YourFath3r253/tennisball-picking/簡報/google簡報下載/撿球機 9_2.pdf

# 撿球機

9/2

## 加裝開關於24V電池

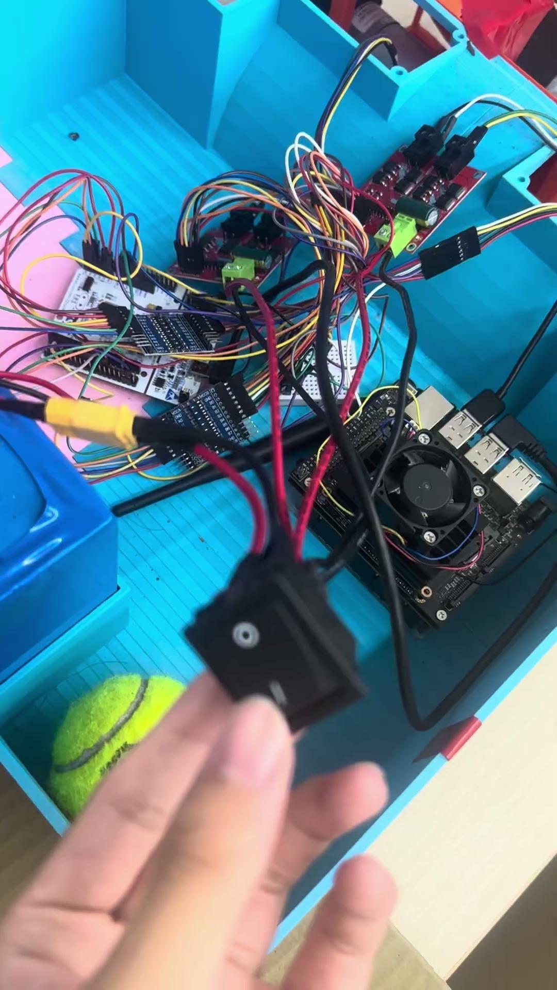
[picture p12: figure]

## 一次撿多顆球影片

讓機器在撿完球後原地旋轉尋找另
一目標，重複撿球動作

問題：球有可能會卡住沒辦法順利噴
到後面的儲球箱

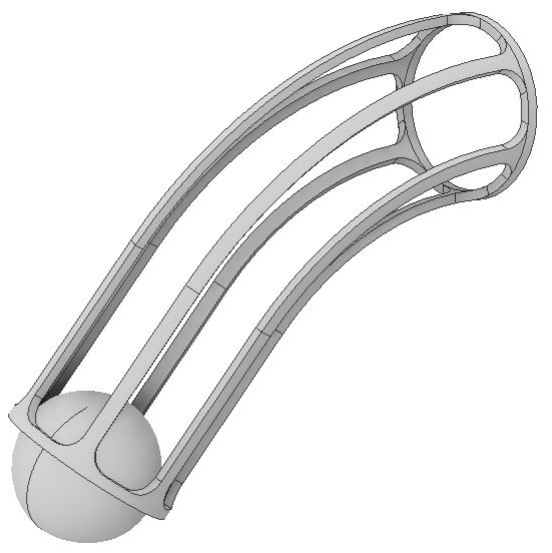
[picture p13: figure]

## 未來規劃

1. 重新設計導桿、做進球導軌、降低進球高度
2. 加入 IMU 改善分區巡邏
a. 加入 BNO080 IMU，取得車體即時方向角資訊
b. 利用 馬達 Encoder + IMU 估算車體位移、轉向角度
c. 將場地劃分多區塊，依序移動至各區域搜尋網球
