YourFath3r253/tennisball-picking/簡報/google簡報下載/1_20撿球機.pdf

# 撿球機

2026/01/20

目錄

- 撿球方式選擇
- 影像辨識系統

馬達

空載轉速 (No-load Speed)：200 rpm

負載轉速 (Rated Speed)：175 rpm

單顆馬達額定扭力 (Rated Torque)：2.29 kgf．cm

兩顆馬達總扭力：2.29 × 2 = 4.58 kgf．cm

假設輪子直徑15 cm，輪子周長：15 cm × 3.14=47.1 cm，以175 rpm做計算秒速約1.35 m/s

總推力= 扭力/半徑=4.58 kgf．cm/7.5cm=0.611 kgf

假設平地摩擦係數=0.046，重量=推力/摩擦係數=0.611/0.046=13.275kg

## 上滾輪式撿球機構

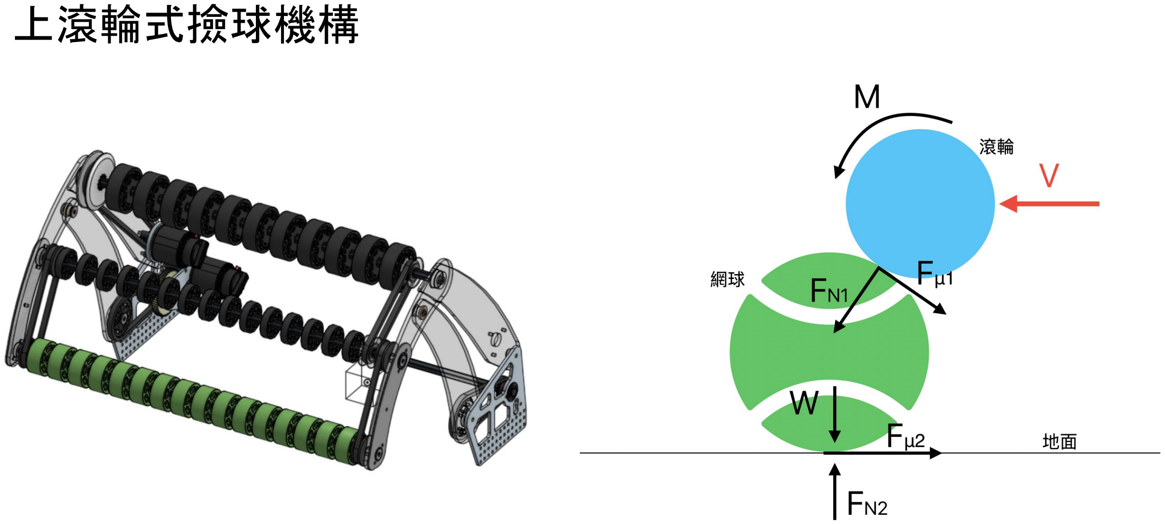
[picture p15: page 4]

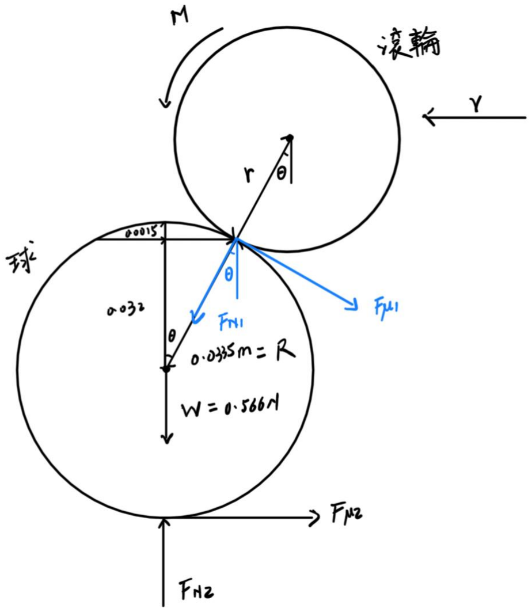
[picture p16: figure]

## 上滾輪撿球機構計算

標準網球直徑：67mm

網球剛性：12550N/m

標準網球重量：57.7g

網球與地面摩擦係數：0.046

滾輪直徑：50mm

滾輪與網球間摩擦係數：0.7

機器運行速度：1.35m/s

滾輪軸心與地面距離：86.7mm

## 上滾輪撿球機構計算

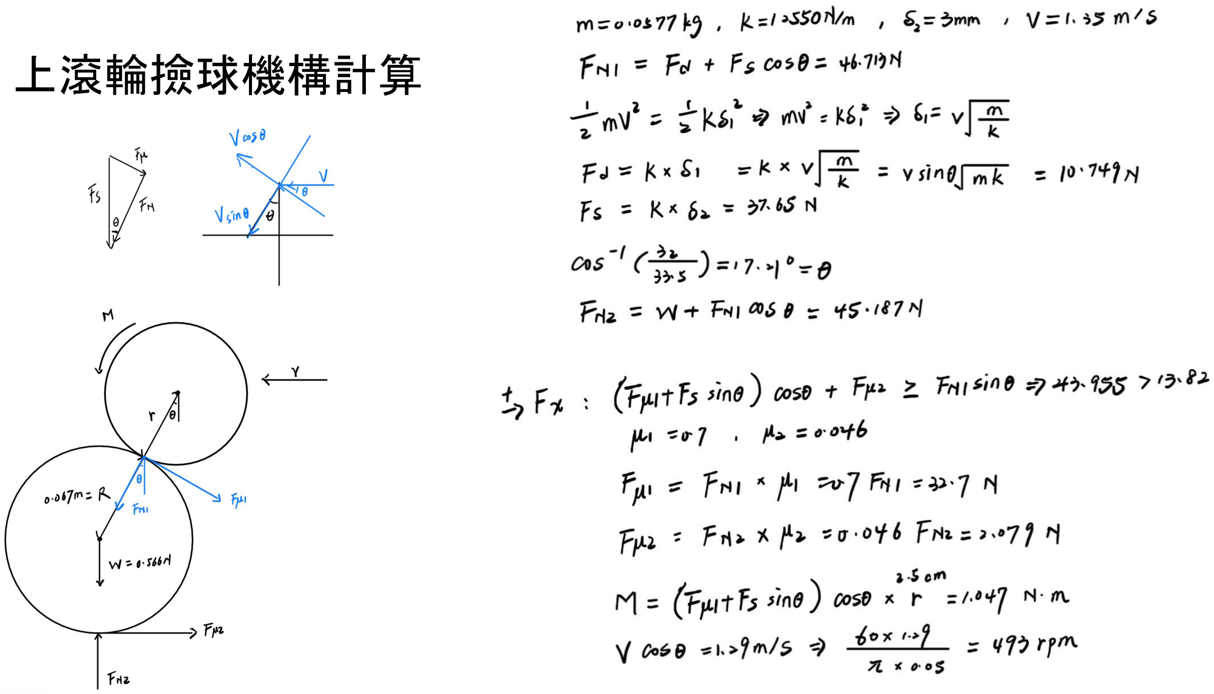
[picture p17: page 6]
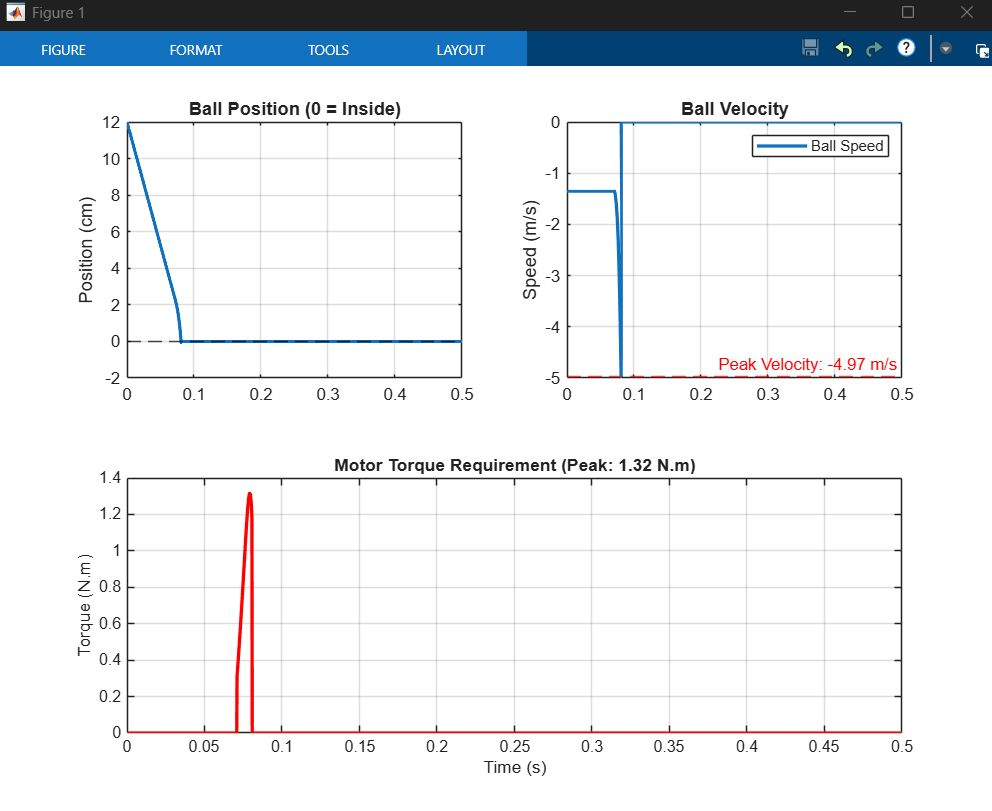
[picture p18: page 7]

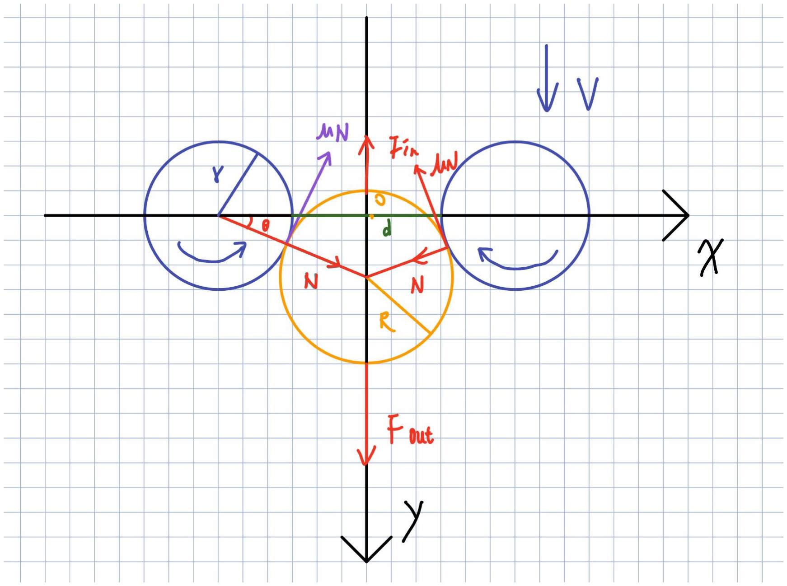
[picture p19: figure]

## 側向滾輪計算

標準網球直徑：67mm

滾輪直徑：50mm

滾輪間距：56mm

標準網球重量：57.7g

滾輪與網球間摩擦係數：0.7

網球與地面摩擦係數：0.046

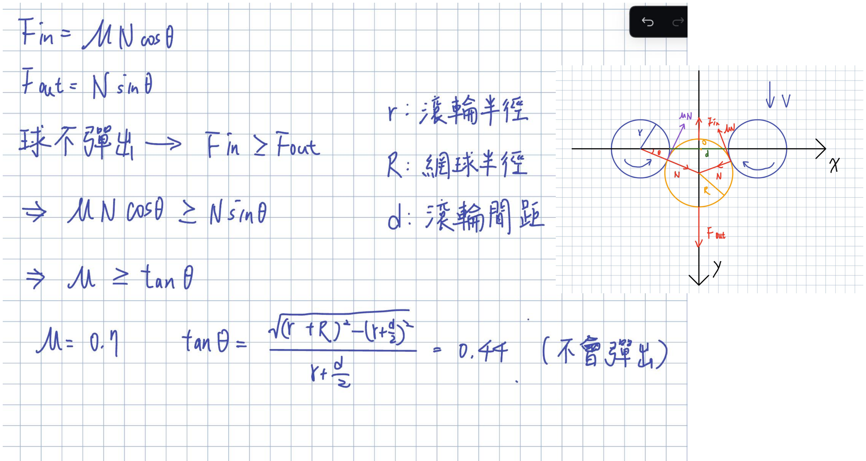
[picture p20: page 9]
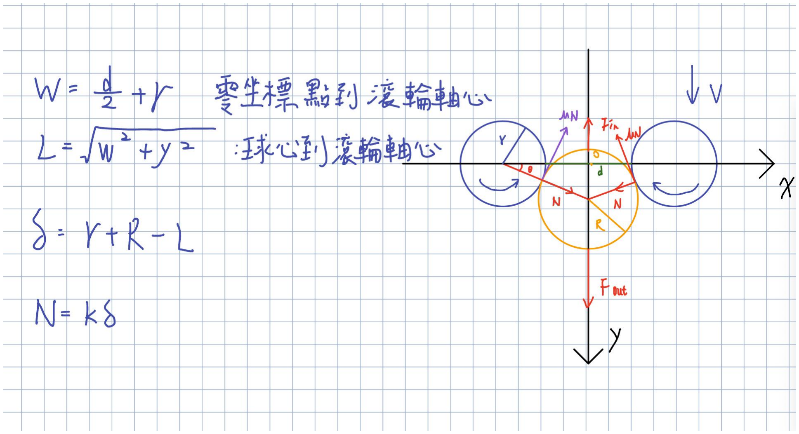
[picture p21: page 10]

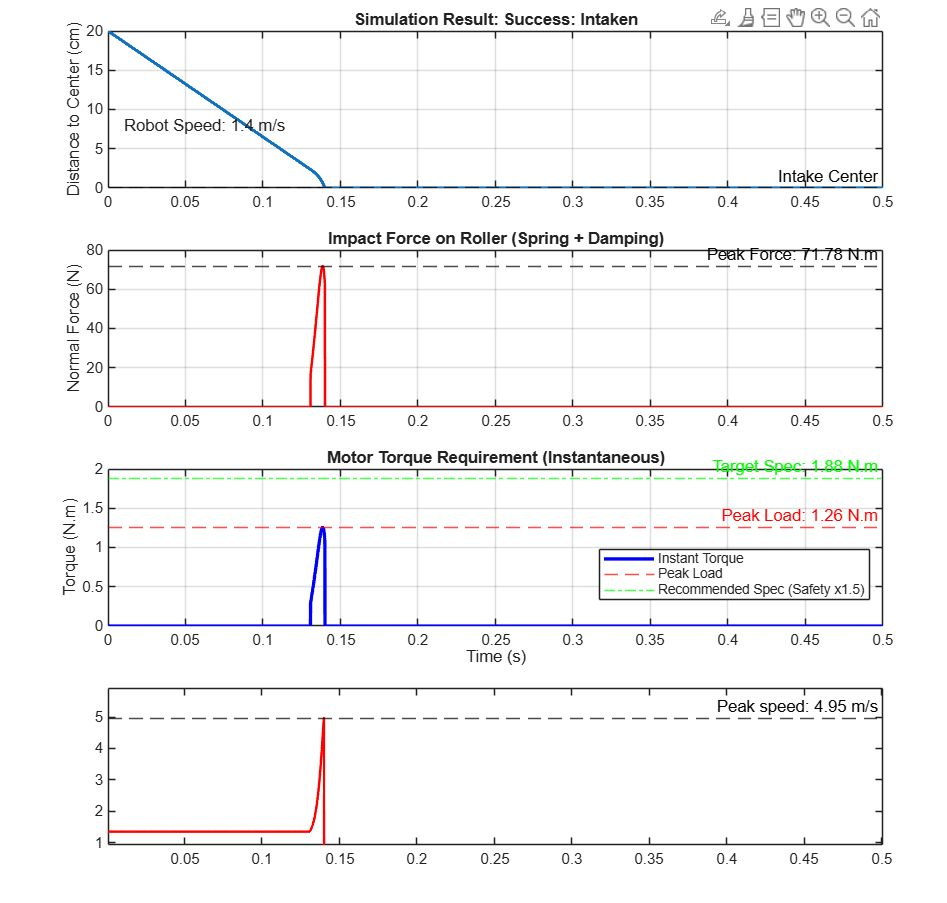
[picture p22: figure]

## 選擇側向滾輪的理由

- 受力分散於兩側，機構較不容易損壞
- 上側滾輪會受地面摩擦力影響，側向則不會
- 上側滾輪容易因地形起伏受影響，如果滾輪太低，球會直接彈飛(如果用可動的 懸臂會導致進球速度不太一樣
- 機構設計較簡單

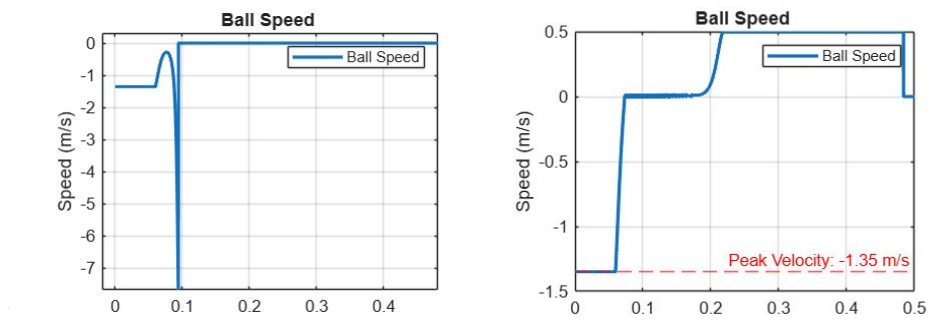
[picture p23: figure]

## 視覺系統架構選擇：Global vs. On-board Vision

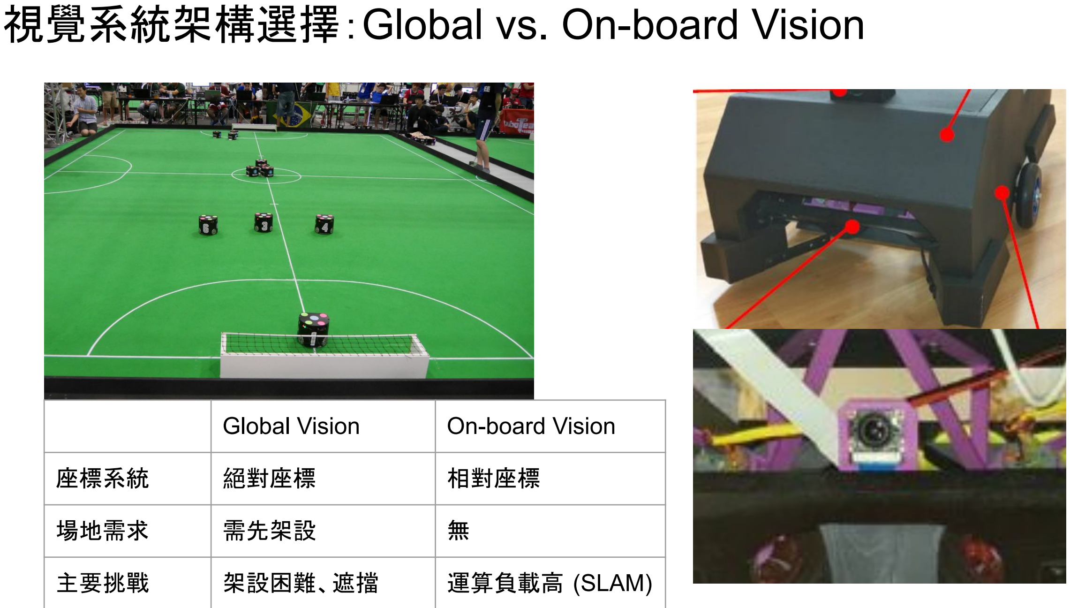
[picture p24: page 13]

| Global Vision | On-board Vision
座標系統 | 絕對座標 | 相對座標
場地需求 | 需先架設 | 無
主要挑戰 | 架設困難、遮擋 | 運算負載高 (SLAM)

## 文獻背景

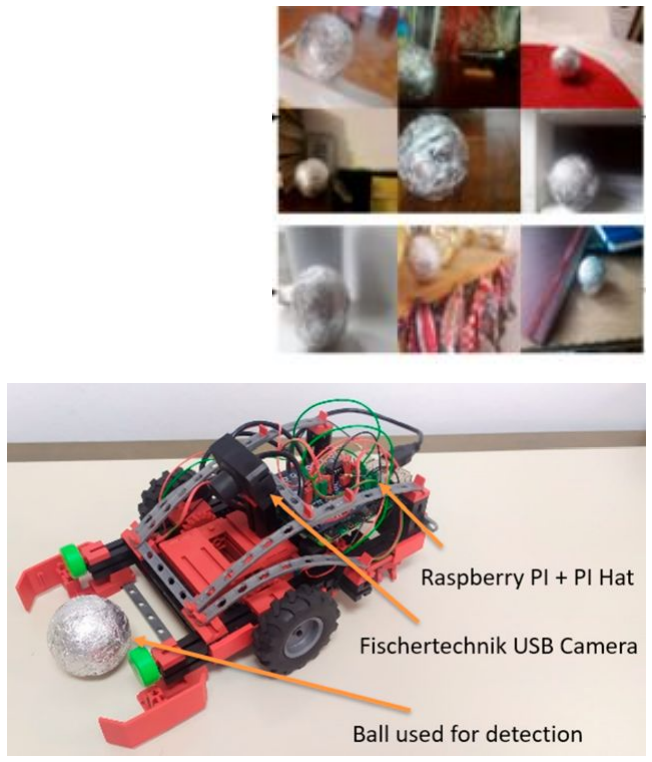
[picture p25: figure]

標題： Ball Detection Using Deep Learning Implemented on an Educational Robot Based on Raspberry Pi

出處： Sensors (2023), Keča et al.

實驗設計： 使用鋁箔紙製作銀色球，拍攝1200張照
片採用70%(訓練) - 15%(驗證) - 15%(測試)，手動 模糊180張照片作為增強測試

在Raspberry Pi 比較 Hough Transform (霍夫圓形 變換) 、U-NET (語義分割)、Faster R-CNN (物件偵 測)

## 影像辨識評估指標定義

綜合準確度 DICE

平衡誤判與漏抓

確保機器人不抓雜物
& 不漏看球

定位精準度 (IoU)

框得準確

決定撿球機構成功率

推論時間 (Inference
Time)

處理一張照片時間

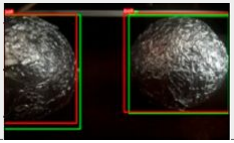
[picture p26: figure]

## Hough Transform 參數僵化

手動參數依賴： 需人工設定dp、(p1, p2)、minR, maxR 與最小距離 (minDist)

準確度崩盤： 實驗顯示，無論如何微調，DICE 分數最高僅 0.16，遠低於深度學習的 0.9+

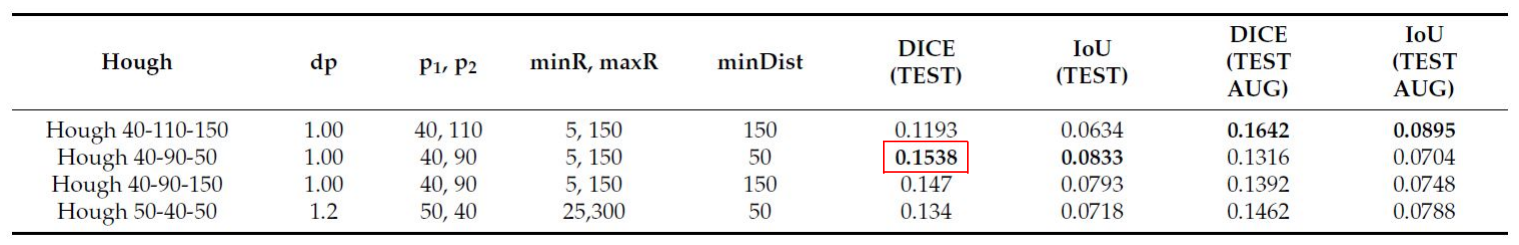
[picture p27: figure]

## Hough Transform 環境失效與動態模糊

光影干擾 (Illumination)：文獻 Figure 10 證實，單純依賴灰階 (Grayscale) 與邊緣特徵，在陰 影下極易失效（False Negative），或將圓形背景雜訊誤判為球（False Positive）

形狀變異 (Deformation)：由於撿球機移動中拍攝網球可能為橢圓形或長條形狀

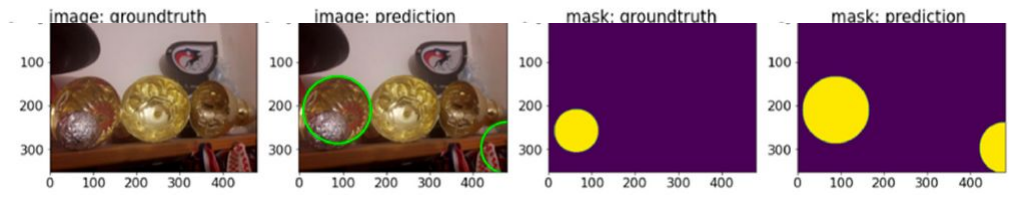
[picture p28: figure]

## 視覺辨識實際案例比較

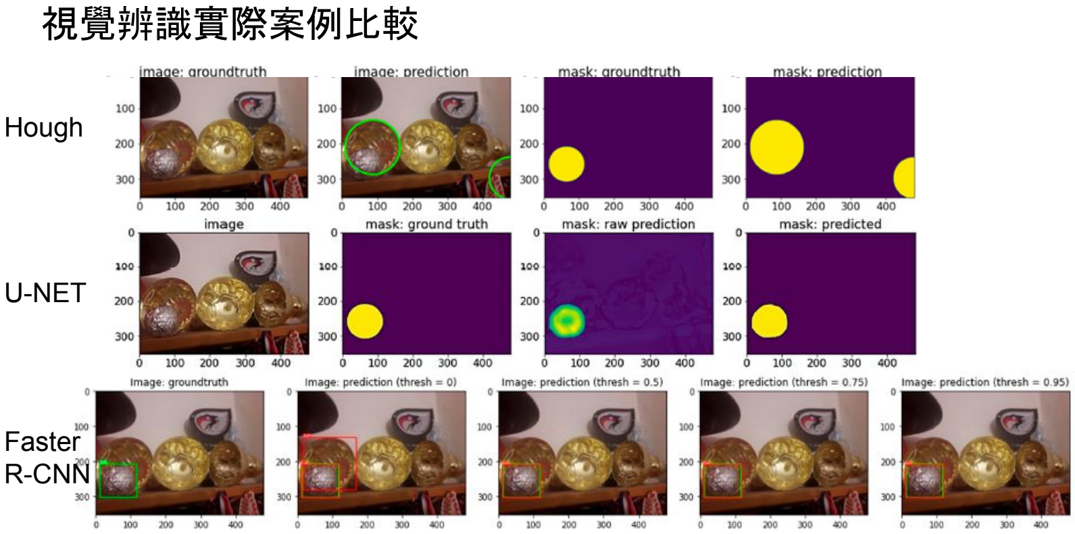
[picture p29: page 18]

Hough

U-NET

Faster
R-CNN

## U-NET, Faster R-CNN 實驗數據

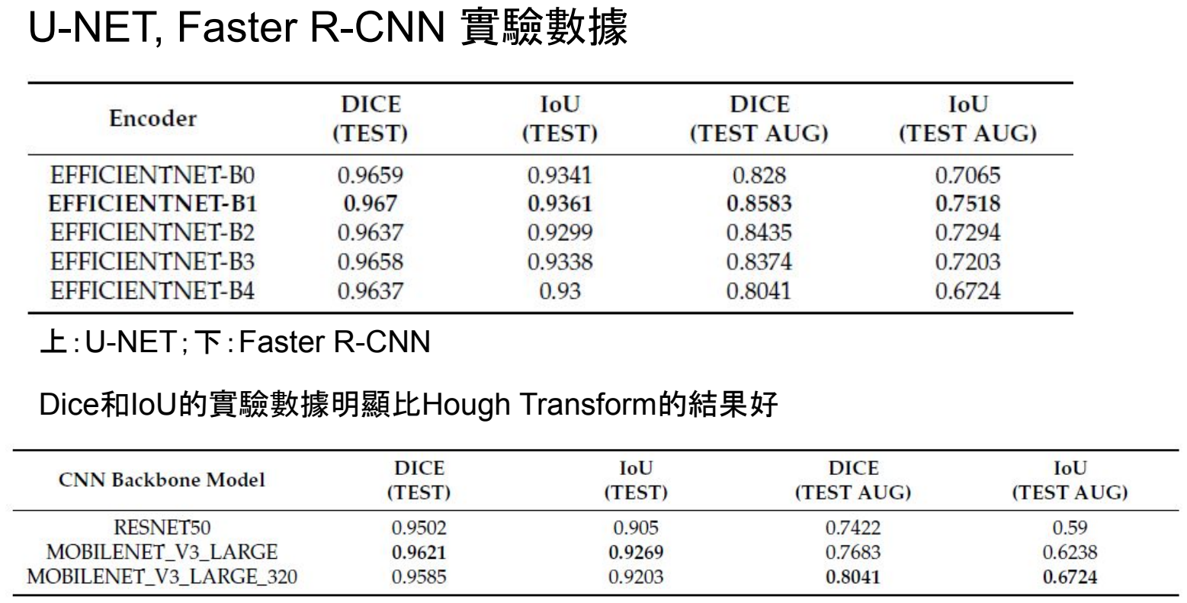
[picture p30: page 19]

上：U-NET；下：Faster R-CNN

Dice和IoU的實驗數據明顯比Hough Transform的結果好

## 影像辨識運算時間

樹莓派算力瓶頸

網球機器人速度快，我們至少需要 15-20 FPS，純 CPU 算力缺口巨大。

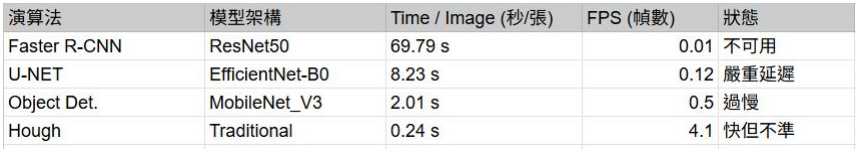
[picture p31: figure]

## 解決方案提案

硬體

Raspberry Pi (CPU)

演算法

Faster R-CNN：兩階段
偵測

硬體

NVIDIA Jetson Orin
Nano 8GB Super (GPU)

演算法

YOLO：單階段偵測

## 為什麼選擇 YOLO？

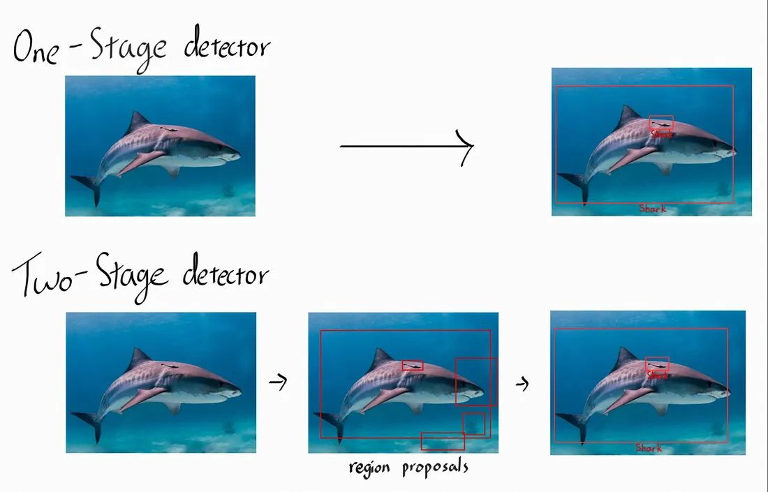
[picture p32: figure]

YOLO:

One-stage

即時性強(Real-time)

專為動態物件設計，
適合撿球機器人。

## 為什麼選擇 Jetson Orin Nano 8GB Super？

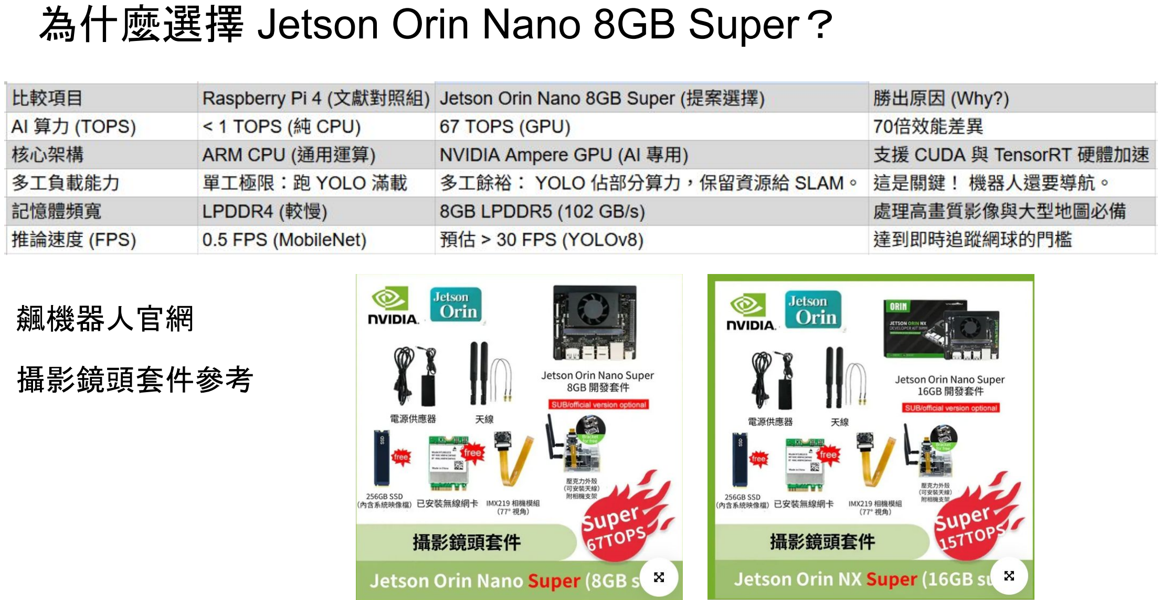
[picture p33: page 23]

飆機器人官網

攝影鏡頭套件參考

## 未來計畫

1. 用數學方式決定相機規格、架設高度、角度
2. 路徑規畫相對不相關未來再做選擇
3. SLAM 建圖功能

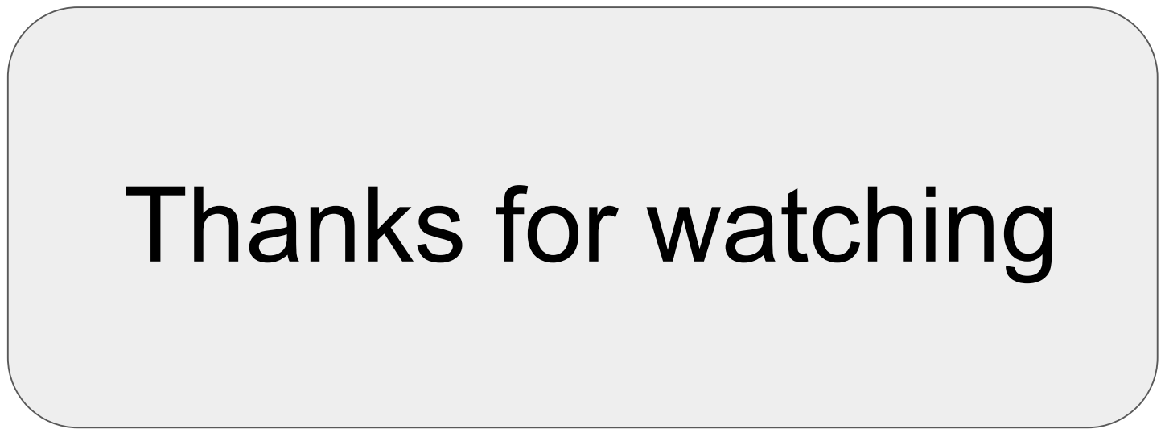
[picture p34: figure]
Thanks for watching
