YourFath3r253/tennisball-picking/簡報/google簡報下載/4_16撿球機.pdf

# 撿球機

4/16

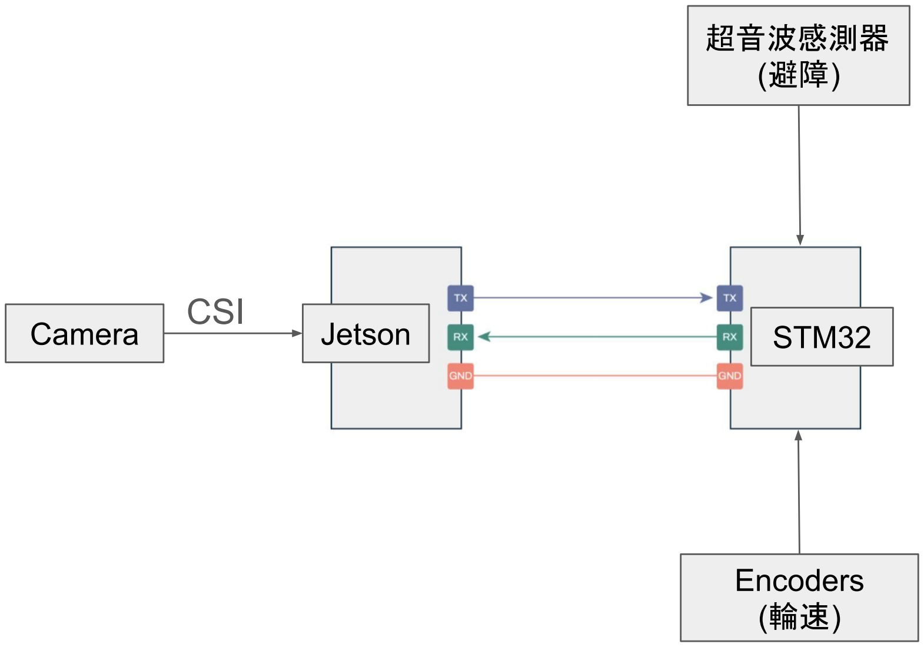
[picture p77: figure]
Camera; Jetson; STM32; CSI; 超音波感測器 (避障); Encoders (輪)

# 只使用一塊板子會出現的問題

### 以Jetson Nano為例：

### 1. Jetson Nano 硬體只有兩個PWM腳位，而一個馬達就需要兩個PWM腳位分別控 制正向轉和反向轉，而車體會用到四顆馬達代表需要八個PWM腳位，若要 解決此問題需要外加PCA9685擴充腳位。 2. Linux分時多工，同時處理YOLO和馬達控制很容易成延遲和誤差。

# 時程表(本學期第8~16週)

周次 | (日)~(六) | 要做的事 | 註
1 | 4/12~4/18 | 確認硬體+買材料
2 | 4/19~4/25
3 | 4/26~5/2 | 3D列印前車體+材料到貨
4 | 5/3~5/9 | 組裝 馬達程式測試
5 | 5/10~5/16 | 測試
6 | 5/17~5/23 | 根據實驗結果微調
7 | 5/22~5/30 | 準備報告
8 | 5/31~6/6 | 專題研究(一)報告 | 學校15週

# 時程表

月份 | 專題目標
4 | 確認所需硬體，馬達驅動程式
5 | 做出一代撿球機
6 | 報告+確認暑期詳細時程
7 | 一代測試實驗
8 | 實驗結果調整
9 | 請廠商做出車體
10 | 做出最終版撿球機
11 | 最後調整和測試
12 | 準備報告
