YourFath3r253/tennisball-picking/簡報/google簡報下載/6_22撿球機.pdf

# 撿球機

6/22

## 撿球馬達：ASLONG JGB37-3530B

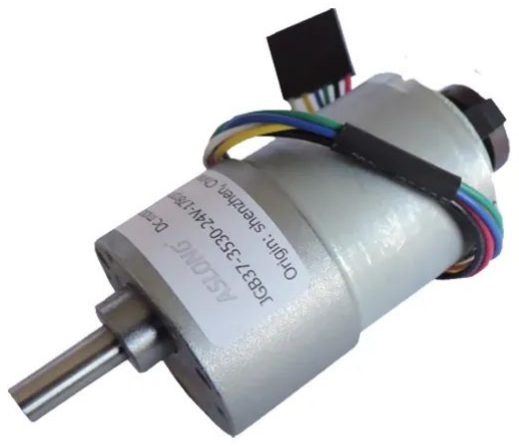
[picture p106: figure]

滾輪直徑8公分

torque at max efficiency 1.7kg*cm

speed at max efficiency: 1280RPM

power: 3W

## 底盤馬達：ASLONG JGB37-555B

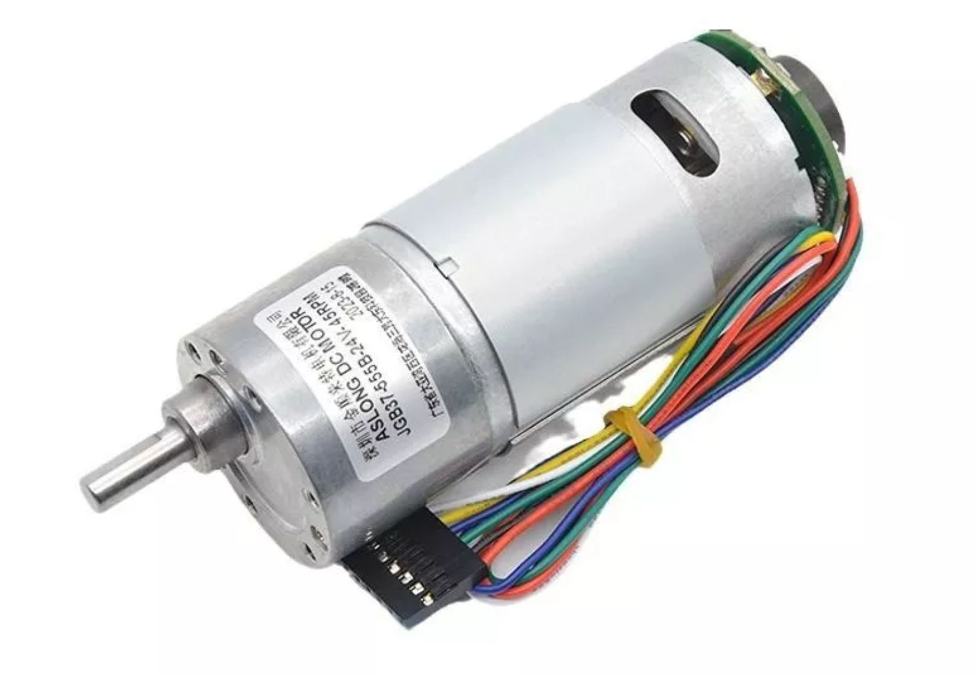
[picture p107: figure]

輪子直徑十公分

兩顆馬達總推力為2.12kg

總推力=摩擦係數*最大物重

撿球機20kg以下是可接受範圍

載重時轉速255rpm，換算車速4.81km/h

FT-555編碼器可用於馬達控制

## 底盤馬達轉速量測

單圈總脈衝數：total PPR = base PPR*gear ratio*quadrature multiplier

STM32 TIM6 Counter period設定10ms，每10ms紀錄一次

RPM = (count/total PPR)*6000

## 底盤馬達PID控制

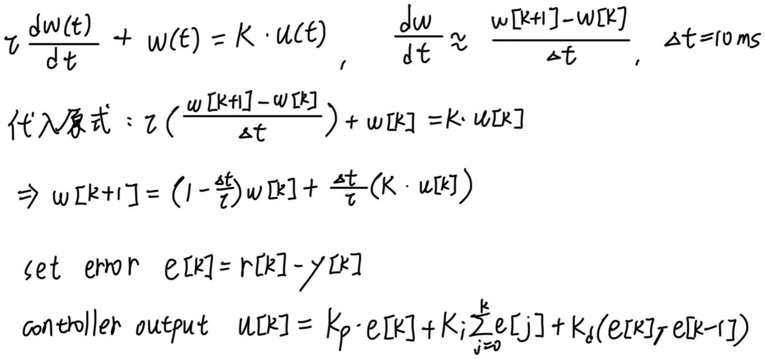
[picture p108: figure]

## 本周進度 & 撿球方式確定

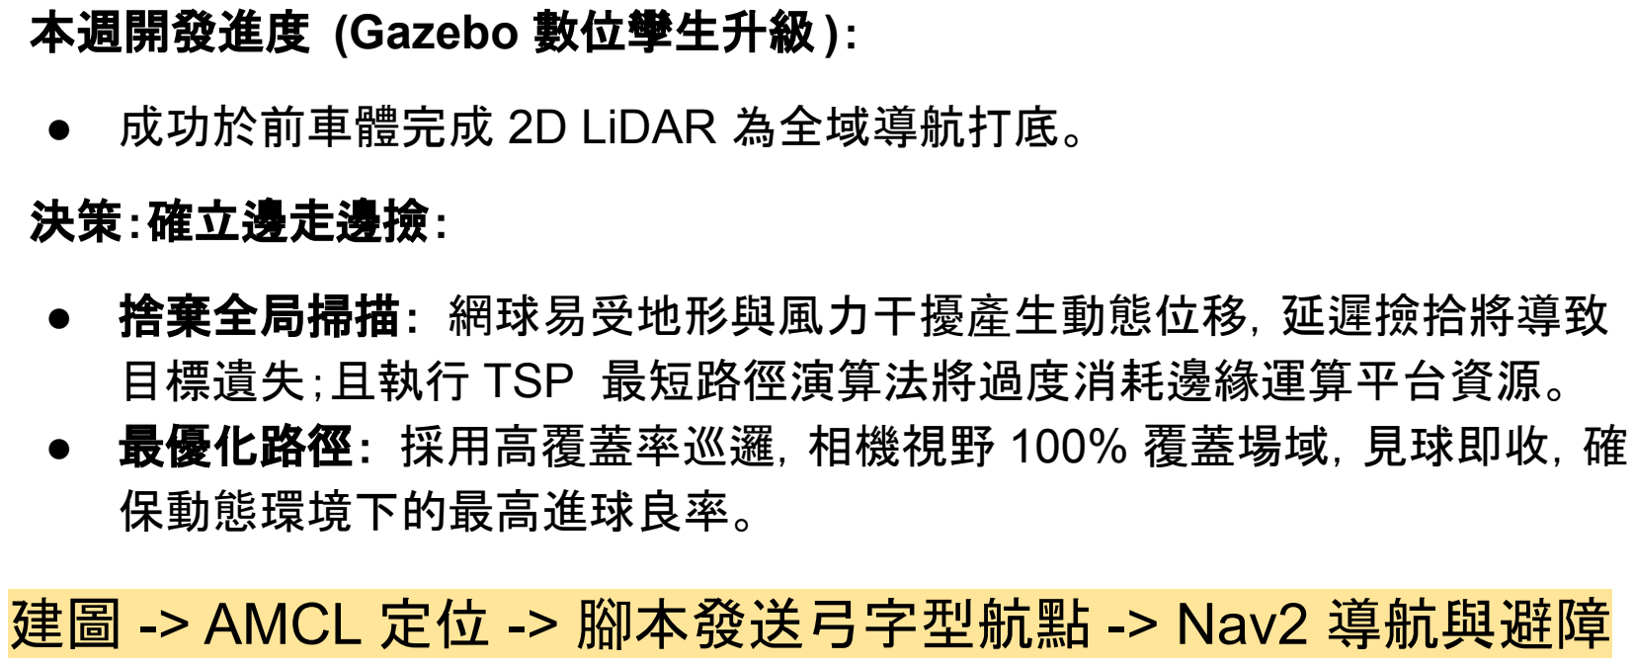
[picture p109: figure]
本週開發進度 (Gazebo 數位孿生升級 )：; ● 成功於前車體完成 2D LiDAR 為全域導航打底。; 決策：確立邊走邊撿：; ● 捨棄全局掃描： 網球易受地形與風力干擾產生動態位移，延遲撿拾將導致 目標遺失；且執行 TSP 最短路徑演算法將過度消耗邊緣運算平台資源。 ● 最優化路徑： 採用高覆蓋率巡邏，相機視野 100% 覆蓋場域，見球即收，確 保動態環境下的最高進球良率。

## 建圖 -> AMCL 定位 -> 腳本發送弓字型航點 -> Nav2 導航與避障

自動建圖與多場域記憶

1.拓荒模式： 導入Nav2 的探索
外掛，首次進入新場域時執行
邊界自主探索，完成後儲存 2D
佔用網格地圖 。

2.日常作業： 載入常用球場地
圖，使用 AMCL (自適應蒙地卡
羅定位) 進行輕量化、高精度的
即時座標估算。

Nav2 導航演算法選型

1.全局規劃器 - Smac2D： 支
援非圓形車體的空間 footprint
計算，負責規劃由 A 點至 B 點
的最佳拓樸路徑。

2.局部控制器 - DWB ： 具備動
態避障能力，巡邏時能自動計
算速度軌跡，閃避場內突發障
礙物（如人員或球網柱）。

## 全域自主導航與視覺接管架構

相機視野驅動的航點生成

1.ABC航點距離： 讀取靜態地圖邊
界，並帶入相機水平視角與有效辨
識距離進行計算。

2.確保零漏球： 以數學公式推算包
含 20% 影像重疊率的最佳巡邏間
距，自動生成遍佈全場域的弓字型
航點 (A->B->C) 陣列，交由 Nav2
依序執行。

建圖 -> AMCL 定位 -> 腳本發送弓字型航點 -> Nav2 導航與避障

## 新增 512×384 TensorRT 輸入版本

原本使用 416×416 / 512×512 square input，需 padding。

本次新增 512×384 rectangular input，比例與相機 640×480 相同，皆為 4:3。

因此前處理可由 640×480 等比例縮放至 512×384，不需上下 padding。

## 推論速度比較

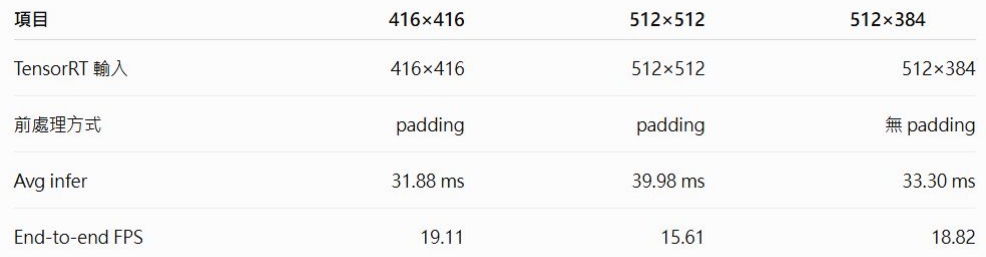
[picture p110: figure]

512×384 在速度上接近 416×416，但保留較高解析度與相機原始比例，因此適合作 為後續測距版本。

## 測距方法

Z = Real ball diameter × Focal length / Ball pixel diameter 使用：

網球實際直徑：約 6.7 cm
ball_pixel = sqrt(box_w × box_h) FOCAL_LENGTH_PX = 500.0

計算左右偏移：

X = (ball_center_x - image_center_x) × Z / focal_length Angle = atan2(X, Z)

Z_cm：判斷車子是否繼續前進
X_cm：判斷球在左側或右側
Angle：作為轉向控制誤差

## 50 cm 靜態測距驗證

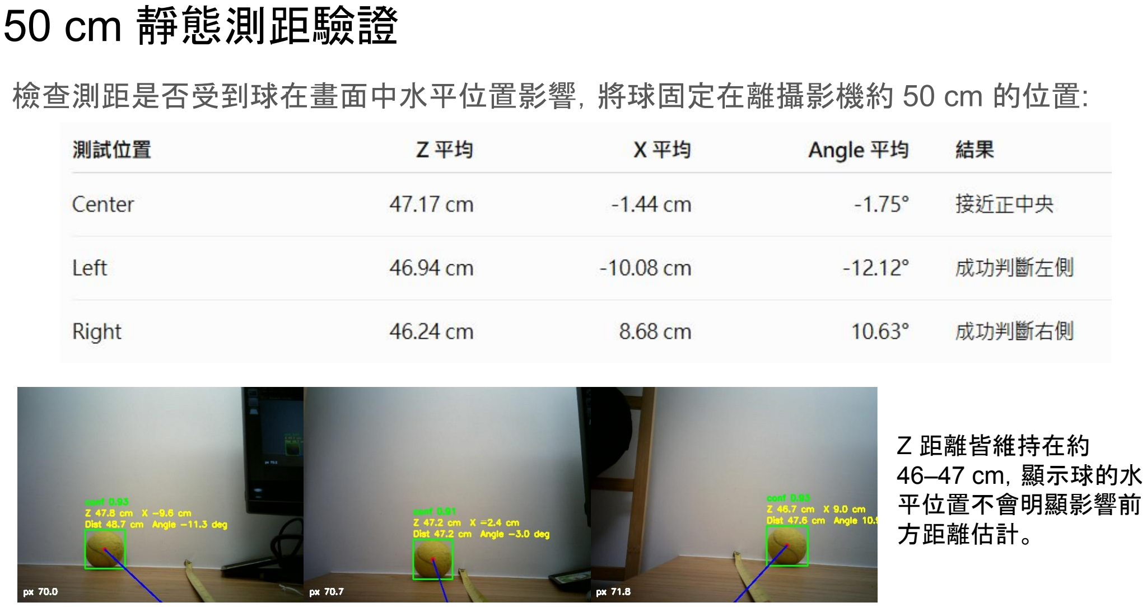
[picture p111: page 11]

檢查測距是否受到球在畫面中水平位置影響，將球固定在離攝影機約 50 cm 的位置:

Z 距離皆維持在約
46–47 cm，顯示球的水
平位置不會明顯影響前
方距離估計。

## 即時距離偵測展示

將網球由近距離逐步移動至遠距離，測試系統在即時鏡頭下是否能持續偵測球體並 輸出距離資訊，測試範圍：10 cm ~ 130 cm
