YourFath3r253/tennisball-picking/簡報/google簡報下載/撿球機7_8.pdf

# 撿球機

7/8

## 底盤馬達度量測

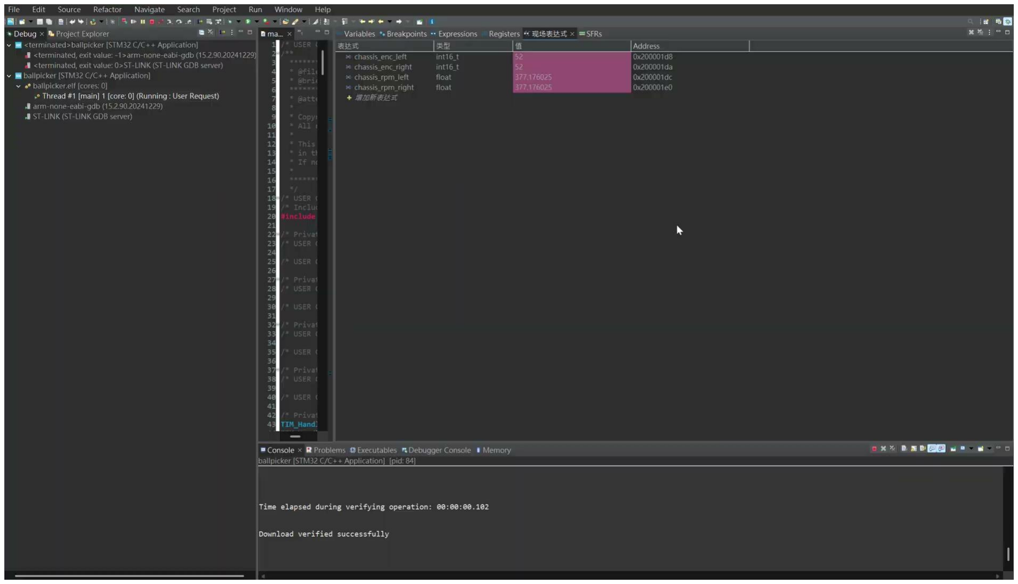
[picture p126: figure]
這個影片檔案仍在處理中，暫時無法 播放。請稍後再試。

測量週期：10 ms

馬達尾軸霍爾編碼器基本解析度 = 11 PPR

齒輪箱減比 = 18.8

定時器正交解碼倍頻 = 4

馬達單圈總脈衝數 = 827.2 pulse/rev

再根據編碼器測得之脈衝數換算成轉rpm

## 底盤馬達度控制

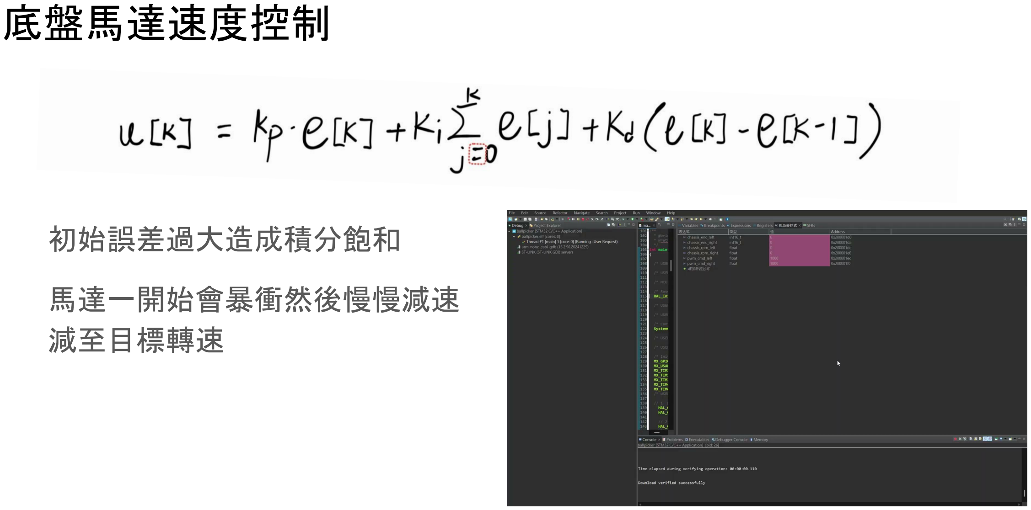
[picture p127: page 3]

初始誤差過大成積分飽和

馬達一開始會暴衝然後慢慢減
減至目標轉

## 底盤馬達度控制

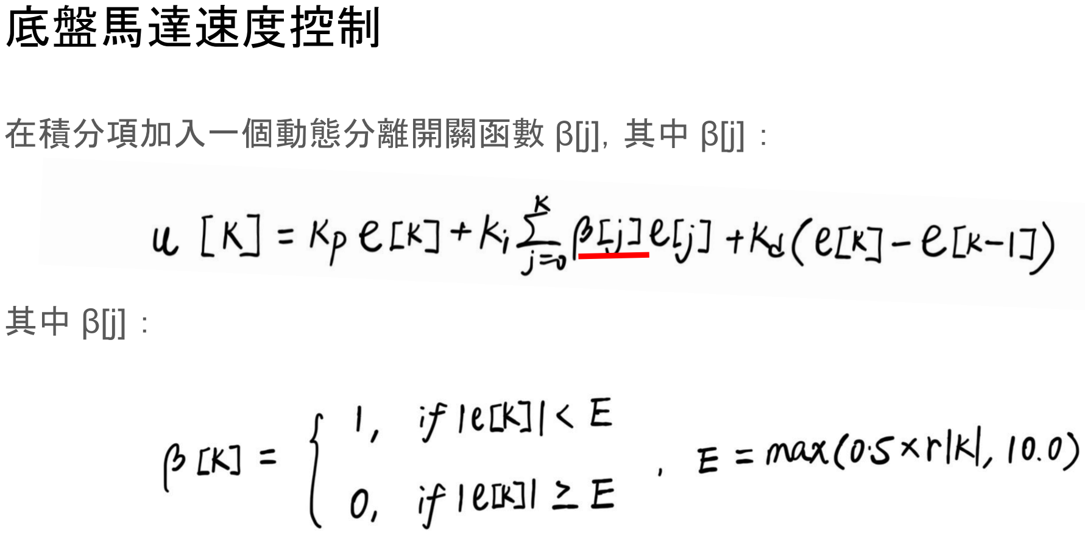
[picture p128: page 4]

在積分項加入一個動態分離開關函數 β[j]，其中 β[j] ：

其中 β[j] ：

## 底盤馬達度控制

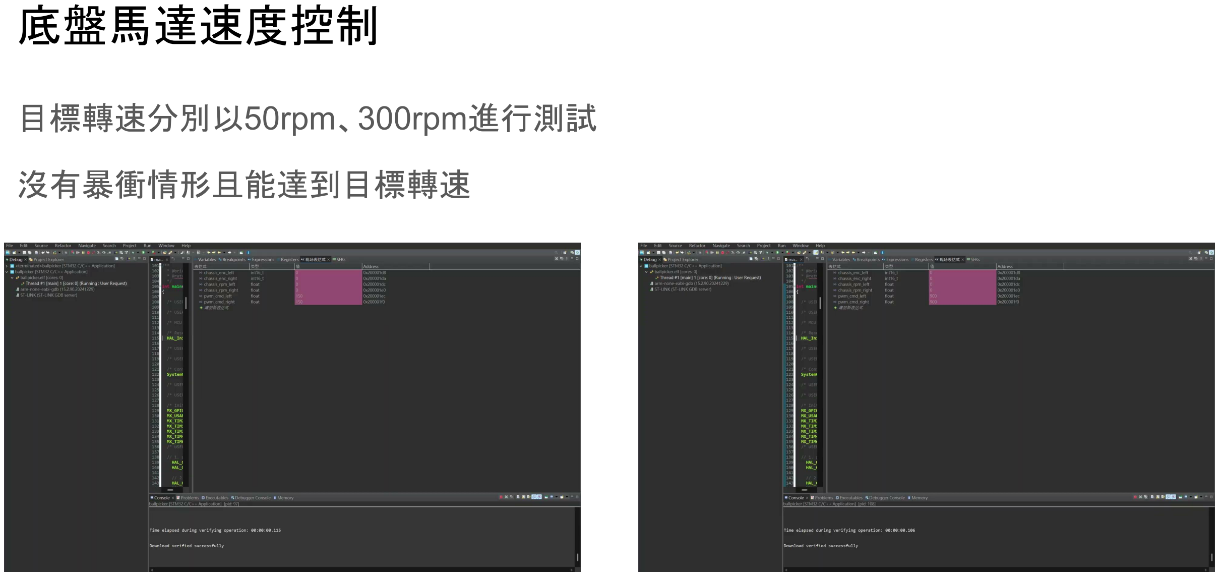
[picture p129: page 5]

目標轉分別以50rpm、300rpm進行測試

沒有暴衝情形且能達到目標轉

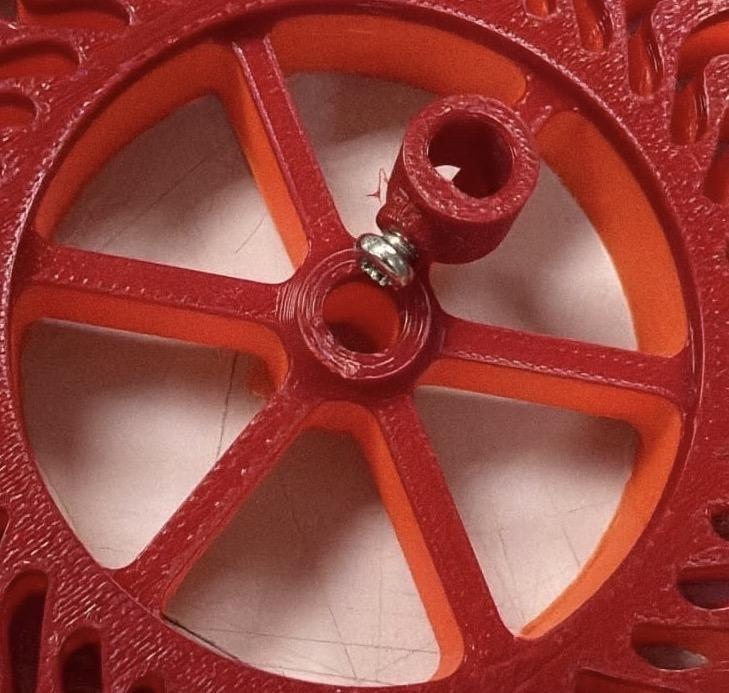
[picture p130: figure]

因為3D列印方向導致的斷裂

在聯軸處施50N的徑向負載

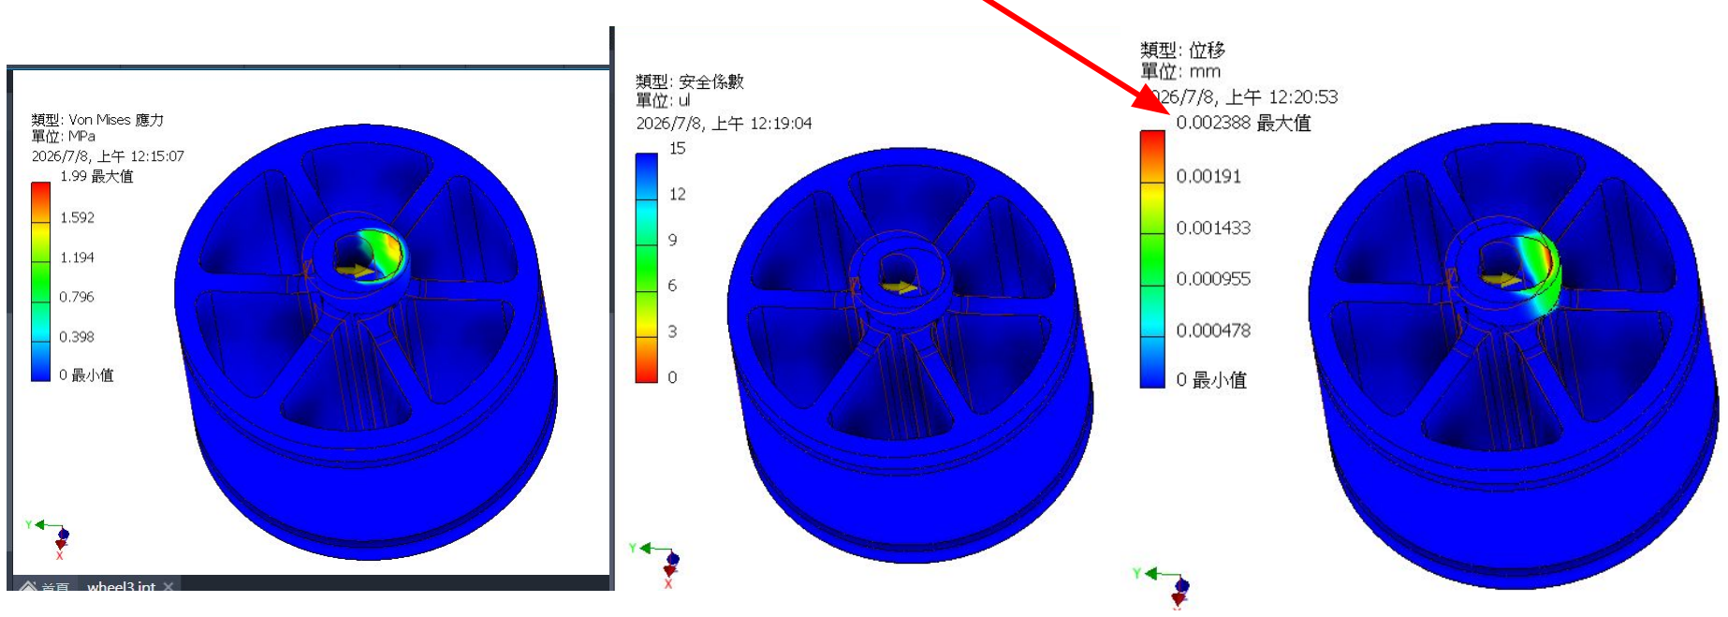
[picture p131: figure]

25mm | 50mm

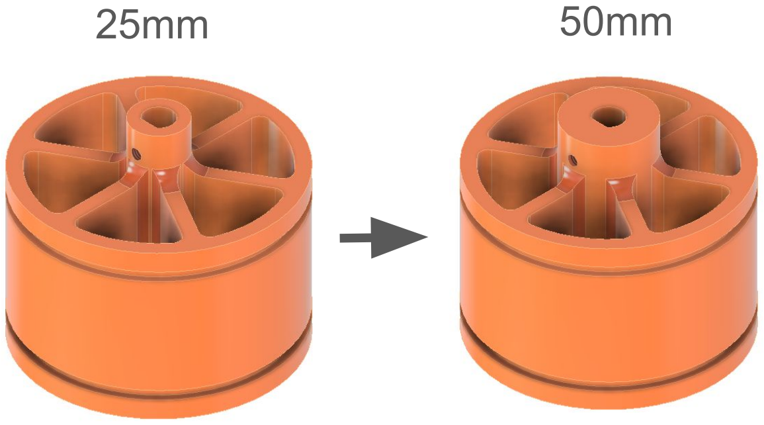
[picture p132: page 8]

- 確定所有PCB、感測器、電池在車體上的位置&固定方式
- 重新分配車廂空間並設計後車體

# 未來規劃

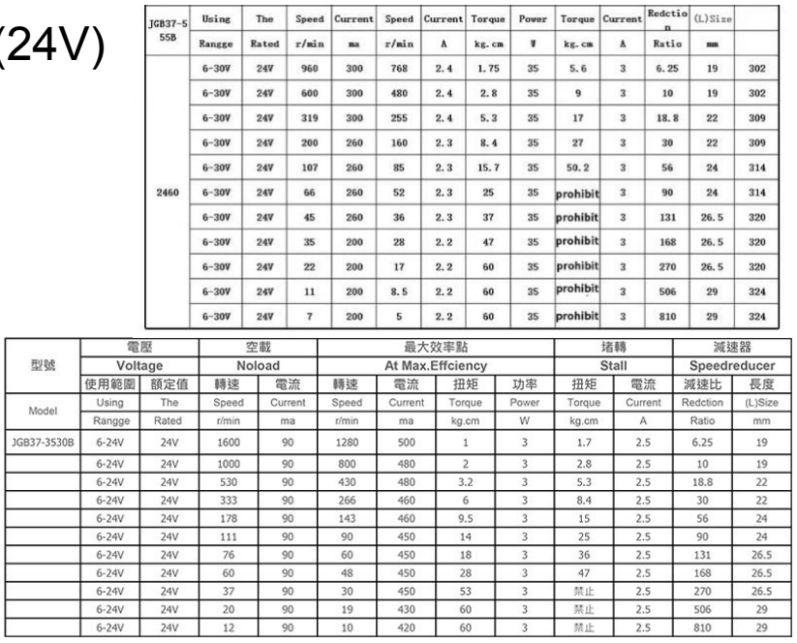
[picture p133: figure]

## 計算功率-動力端負載 (24V)

底盤馬達 (JGB37-555B)

單顆最大效率電流 2.4A，兩顆
共 4.8A。

差滾輪馬達
(JGB37-3530B)

單顆最大效率電流 0.5A，兩顆
共 1.0A。

動力端連續工作電流 I=5.8A

## 功率計算-邏輯端負載 (5V)

Jetson Nano：約 10W（高負載模式）。

深度相機 LeTMC-520：約 2.5W。

光達 RPLIDAR A2M8：約 1.5W（啟動峰值需 3W）。

STM32 開發板：約 0.5W。

邏輯端總功率 P=14.5W，對應 5V 電流約2.9A。

## 電池選擇

供電方案 | 優勢 | 劣勢與風險 | 容量(假設運作x小時)
單 24V 電池 + 大功率 降壓模組 | 共地穩定，有利於 STM32 與馬達驅動器之 間的 PWM/UART 訊號 傳輸；只需維護一顆電 池。 | 降壓模組若負載響應不 佳，馬達啟動時的電壓 驟降可能導致 Jetson Nano 觸發低壓重啟。 | 降壓模組轉換效率=0.85 I=14.5*24/0.85=0.71A I_total=0.71+5.8=6.51A
| | | 容量：6.51x Ah

24V 動力電池 + 5V 行
動電源

馬達動力與邏輯控制電
源完全隔離，馬達突波
不會干擾 Jetson Nano
與感測器。

需維護兩套充電系統；兩
系統間必須確實「共地」
，否則控制訊號會浮接
導致設備燒毀或失控。

24V容量：5.8x Ah
5V容量：2.9x Ah

## 撿球機導航定位方案

評估指標 | 方案 A：即時 SLAM 建圖 + 邊走邊撿 | 方案 B：無定位貪婪演算法 + 固定邏輯盲搜 | 方案 C：先驗標準地圖 +
運作前置成本 | 高 (需手動清場遙控繞行一 圈) | 極低 (隨放隨用) | 極低 (隨放隨用，載入預設 圖檔即可)
系統迷航風險 | 低 | 極高 (幾次動態追球後，底 盤累積誤差將導致完全失 去方向感) | 零 (AMCL 即時雷射特徵比 對，強制校正累積誤差)
目標客群 (TA) 漏球率 | 低 | 高 (隨機漫步無法保證 100% 場域覆蓋） | 零 (透過 FOV 數學推算航 點，強制 100% 視覺掃描覆 蓋)
動態環境容錯率 | 低 (建圖時若有走動人員或 水瓶會成地圖永久變形) | 中 (遇障礙物只能套用寫死 的避障腳本) | 極高 (Nav2 具備即時局部 避障 DWB，能繞過突發障 礙並回歸航線)
邊緣運算負擔 | 滿載 (SLAM 矩陣運算極度 消耗算力) | 極低 | 低 (AMCL 定位極度輕量， 保留算力給 YOLO)

AMCL 動態導航+邊走邊撿

## 軟體模擬-先驗地圖（網球場）＆lidar安裝

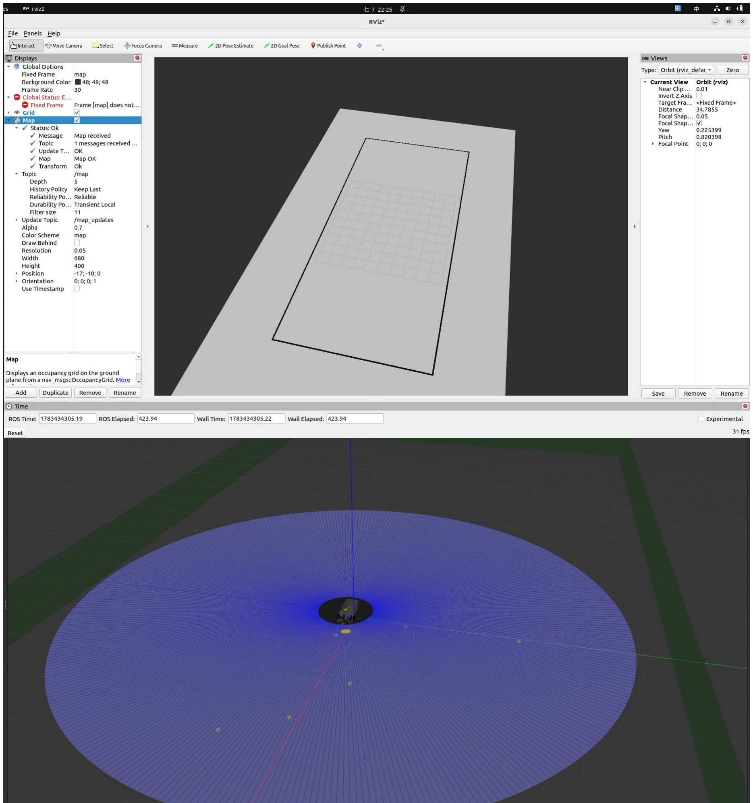
[picture p134: figure]

- 預先在系統建構1*1, 1*2, 1*3,
1*4 等網球場地圖size，將地圖邊
界*1.3倍使得撿球機可以撿到球
場外圍
- lidar設定符合現實的最大最小值
方便後續實做

[後續計畫]

- 修復 RViz2 視覺化斷鏈，完成
AMCL 收斂驗證
- 載入 Nav2 完成虛擬網球場內導
航

## Bounding Box 對測距公式的影響分析

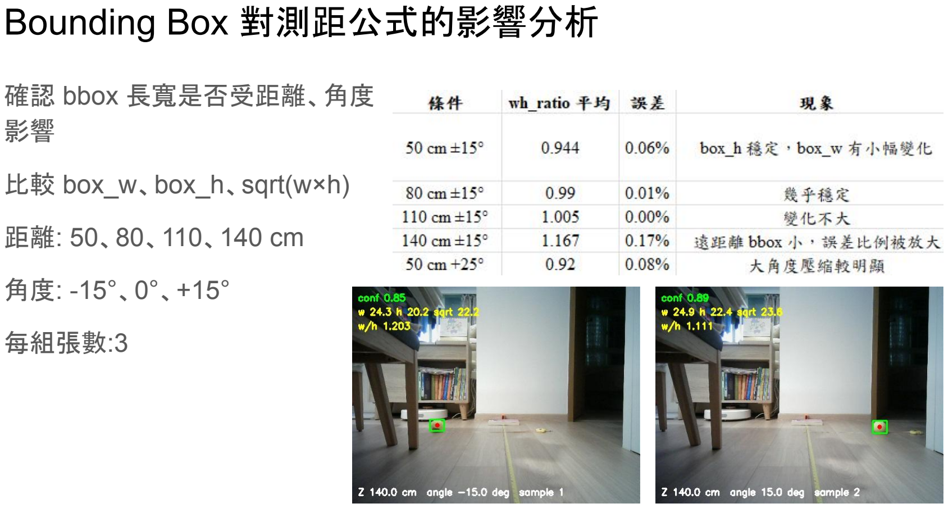
[picture p135: page 15]

確認 bbox 長寬是否受距離、角度
影響

比較 box_w、box_h、sqrt(w×h)

距離: 50、80、110、140 cm

角度: -15°、0°、+15°

每組張數:3

## Bounding Box 對測距公式的影響分析

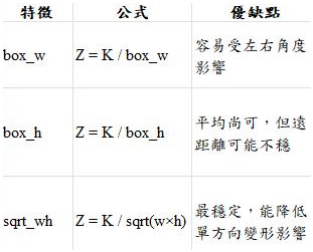
[picture p136: figure]

將同一距離下的 +15° 與 -15° 測試結果平均後，使用 sqrt(box_w×box_h) 的距離估測平均誤差約為 1.86 cm，最大誤差約為 3.22 cm，優於單獨使用 box_w 或 box_h。

## RPLIDAR A2M8 光達整合規劃

相機容易受到光線、背景、遮擋與偵測框誤差影響，且無法完整感知車體周圍障礙物。

因此後續將加入 RPLIDAR A2M8 2D 光達，提供車體周圍 360° 的距離資訊，用於輔助避障 與路徑判斷。

Camera → YOLO TensorRT → 取得 ball_x、ball_z、angle → 判斷網球方向與距離

RPLIDAR A2M8 → 取得前方、左方、右方障礙物距離 → 判斷移動路徑是否安全
