YourFath3r253/tennisball-picking/簡報/google簡報下載/撿球機8_12.pdf

# 撿球機

8/12

## 車體組裝後測試-撿球成功

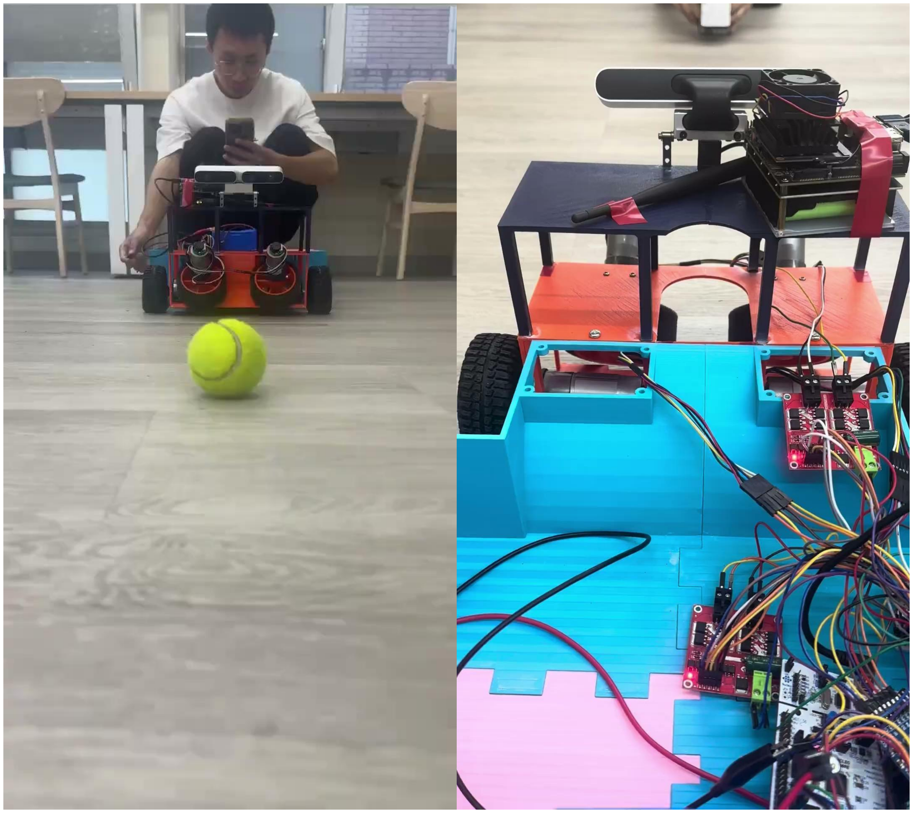
[picture p137: figure]

- 稍微偏離一點也能將球吸入
- 球撿入後的噴射高度比預期高

## 車體組裝後測試-撿球失敗

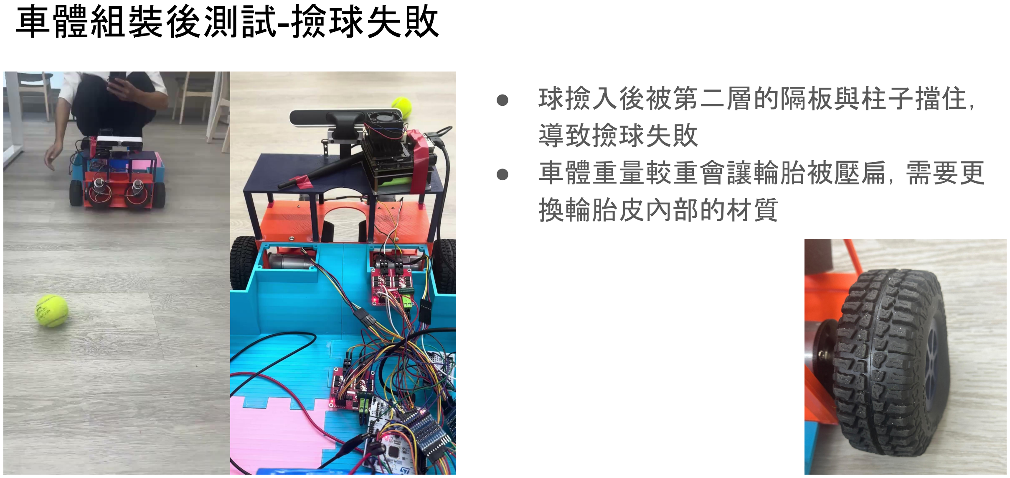
[picture p138: page 3]

- 球撿入後被第二層的隔板與柱子擋住，
導致撿球失敗
- 車體重量較重會讓輪胎被壓扁，需要更
換輪胎皮內部的材質

## 實測遇到的其他問題

問題：24V電池模組直接用杜邦線連接會產生火花

解決方式：用XT60公頭焊接14AWG或是16AWG的線取代杜邦線

問題：車體重量增加，成轉向度下降

解決方式：改善電池偏後、萬向輪負載、車體重量的問題；

與間歇式轉向控制邏輯做取捨
