YourFath3r253/tennisball-picking/簡報/google簡報下載/1_27撿球機.pdf

2026/01/27

# 撿球機

## 上滾輪撿球影片

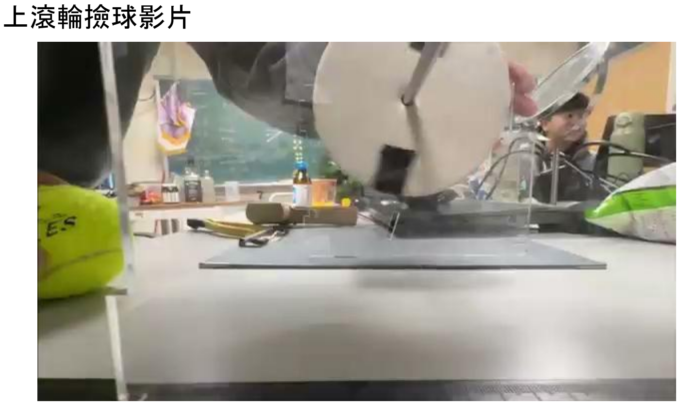
[picture p139: page 2]

## 側滾輪撿球影片

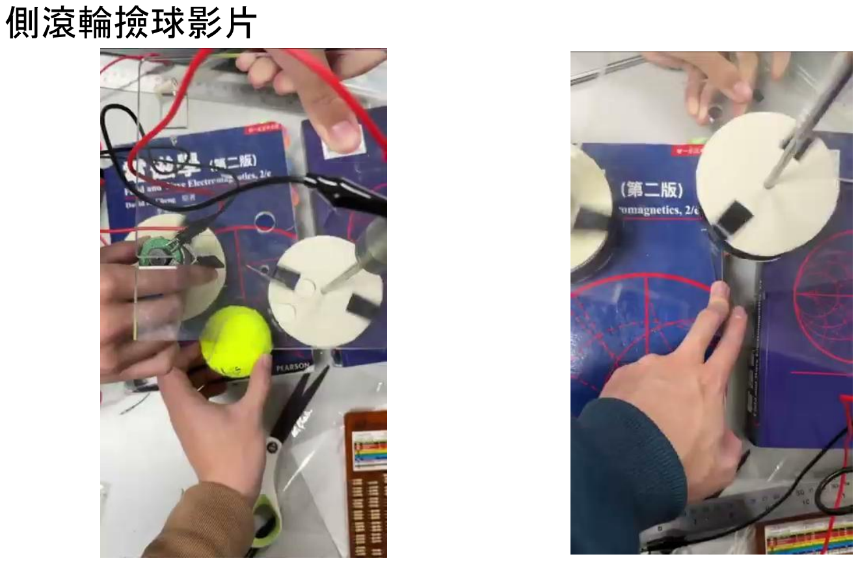
[picture p140: page 3]

小結

- 上滾輪在平地測試中僅遇到球卡住的問題，解決方法是讓滾輪的軸能夠微幅往 上移動或是使用扭矩更大的馬達，進球位置比起側滾輪較無限制
- 側滾輪的進球位置必須盡量在中間，撞上旁邊的輪子就進不去，可以做導桿把球 集中到中間，

## 撿球遇到的問題

遇到角落的球會因滾輪碰不到球而撿不到

解決辦法：設計導桿並在上面安裝滾輪使角落的球滾出

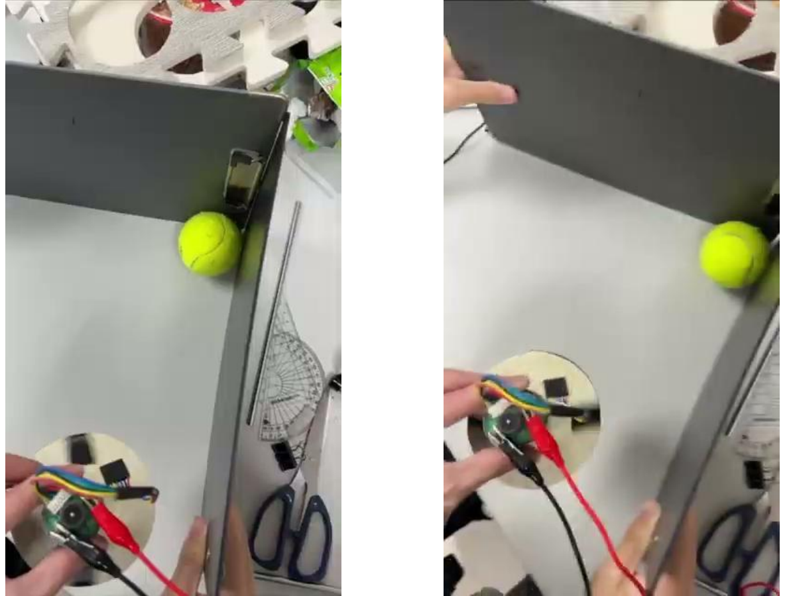
[picture p141: page 6]

## 角落撿球可能需要解決的問題

1. 如何定位角落的球，並識別他是在角落或牆邊
2. 如何確保球會滾到撿球機導桿中間，而不是被推走

## 未來規劃

1. 完善撿球的模型
2. 實際在紅土場地測試

YOLO 在物件偵測上已相當成熟，我們計畫先嘗試將 YOLO 作為球體偵測 的其中一種方案，並在必要時搭配 HSV 等傳統方法進行輔助與調整。

| 特點 | 適合情境
HSV+輪廓 | 快、簡單、無須訓練 | 受控環境
YOLO | 對光線、背景較穩 | 複雜環境

## 視覺方法選擇與應用策略

- YOLO：負責偵測球體，輸出 bounding box
- Bounding box 中心點：用於控制車體轉向（左 / 右）
- 透過信心指數閾值與 NMS 進行篩選，以降低誤判與重疊框的影響
- 距離估計：透過 bounding box 大小，利用簡單幾何關係自行計算
- 因此，bounding box 的準確度會影響距離估計結果
- 進階作法：可搭配深度相機直接取得距離資訊

## YOLO 在撿球機中的角色與處理流程

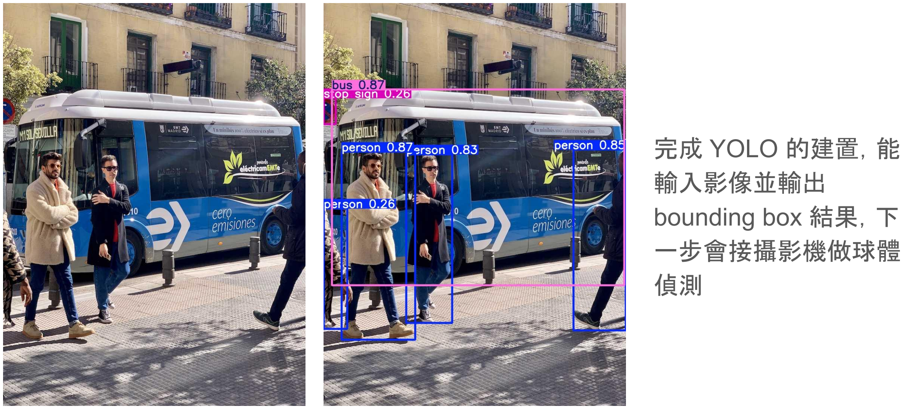
[picture p142: page 11]

完成 YOLO 的建置，能
輸入影像並輸出
bounding box 結果，下
一步會接攝影機做球體
偵測

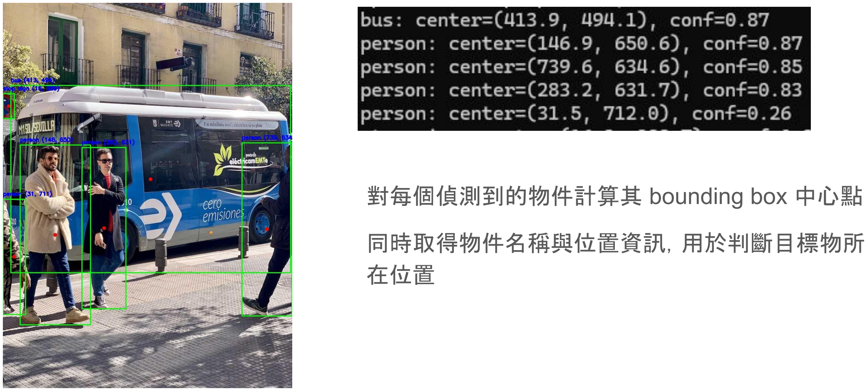
[picture p143: page 12]

對每個偵測到的物件計算其 bounding box 中心點

同時取得物件名稱與位置資訊，用於判斷目標物所
在位置
