YourFath3r253/tennisball-picking/實體車子程式碼/實驗數據/P=0.3/run13_eventA.png

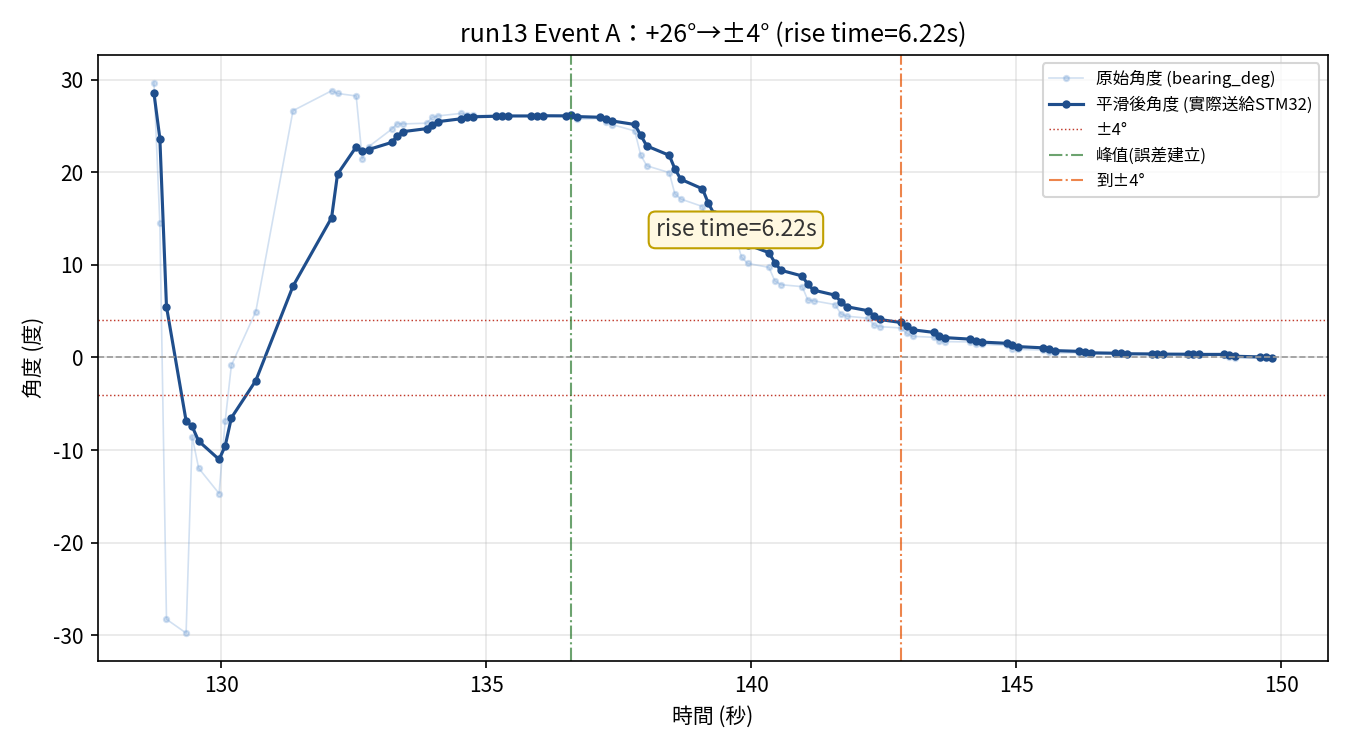
實體車子程式碼/實驗數據/P=0.3/run13_eventA.png
