YourFath3r253/tennisball-picking/實體車子程式碼/實驗數據/P=0.3重測/run14_eventC.png

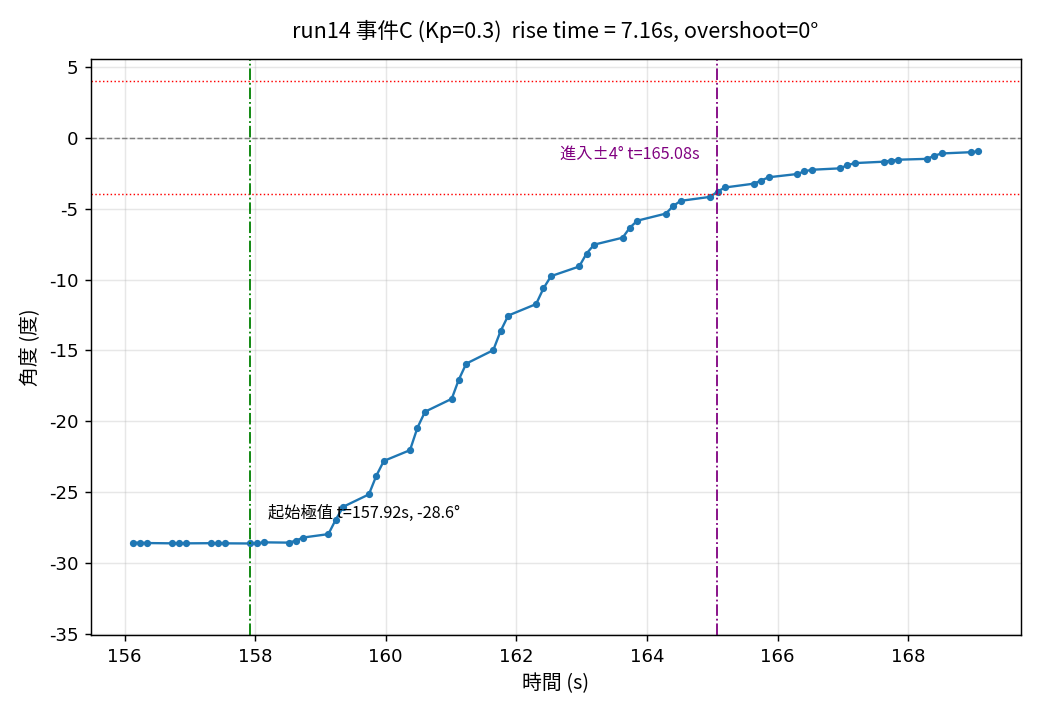
實體車子程式碼/實驗數據/P=0.3重測/run14_eventC.png
