YourFath3r253/tennisball-picking/實體車子程式碼/實驗數據/P=0.6/run15_event2_clean.png

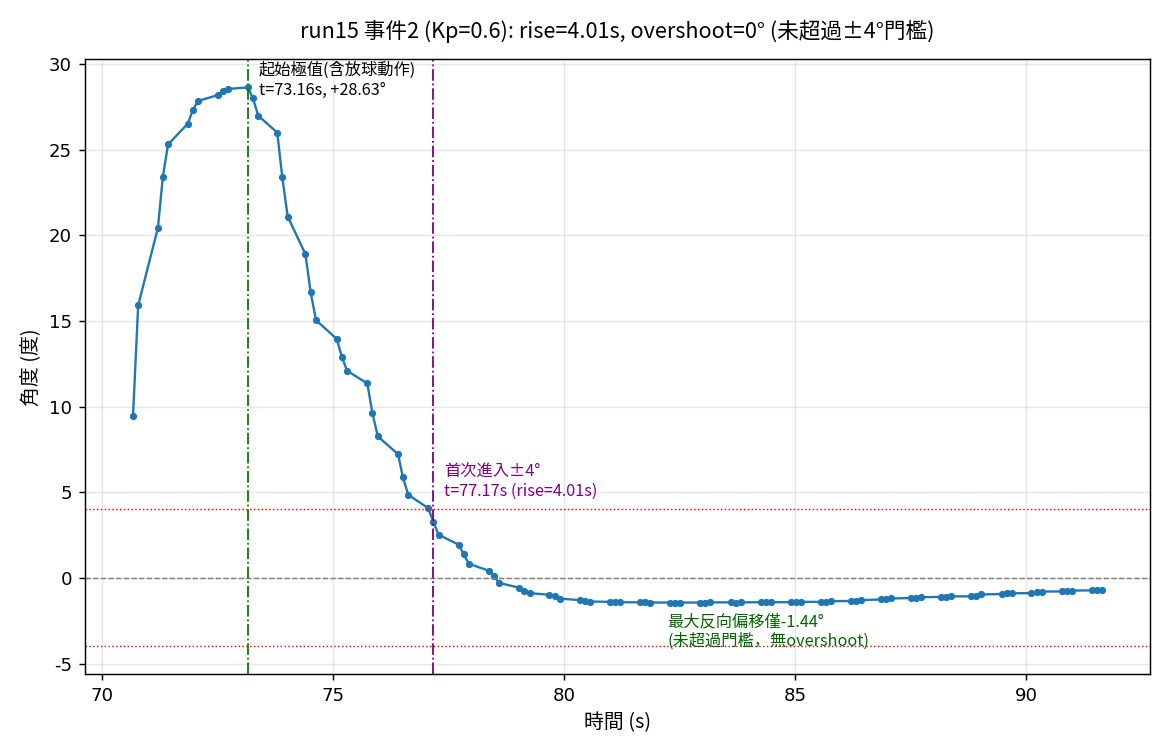
實體車子程式碼/實驗數據/P=0.6/run15_event2_clean.png
