YourFath3r253/tennisball-picking/實體車子程式碼/實驗數據/直走偏移_20261030/rpm_overview.png

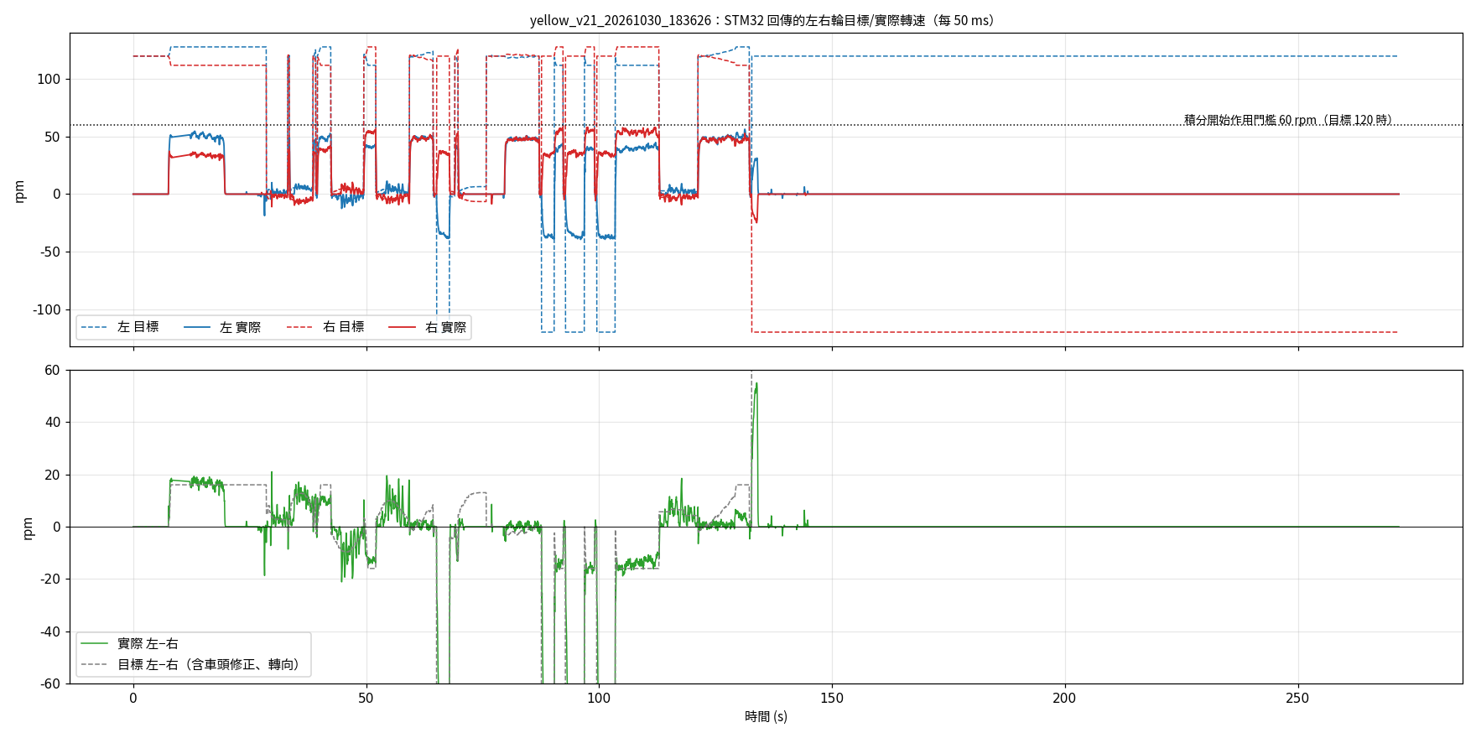
實體車子程式碼/實驗數據/直走偏移_20261030/rpm_overview.png
