YourFath3r253/tennisball-picking/實體車子程式碼/實驗數據/邊界轉向_20261011/yellow_20261011_191346.jpg

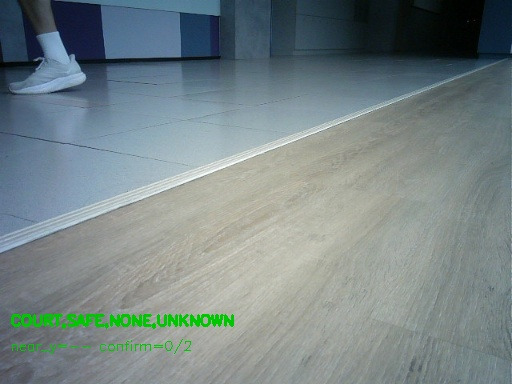
實體車子程式碼/實驗數據/邊界轉向_20261011/yellow_20261011_191346.jpg
