YourFath3r253/tennisball-picking/實體車子程式碼/實驗數據/邊界追球_20261110/orange_v6_exp100_20261110_212202.jpg

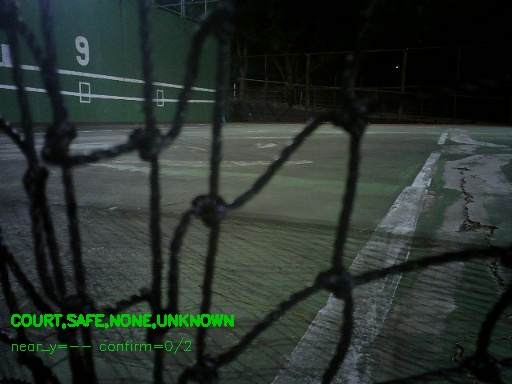
實體車子程式碼/實驗數據/邊界追球_20261110/orange_v6_exp100_20261110_212202.jpg
