YourFath3r253/tennisball-picking/實體車子程式碼/實驗數據/離散控制器/run10_zoom_260s.png

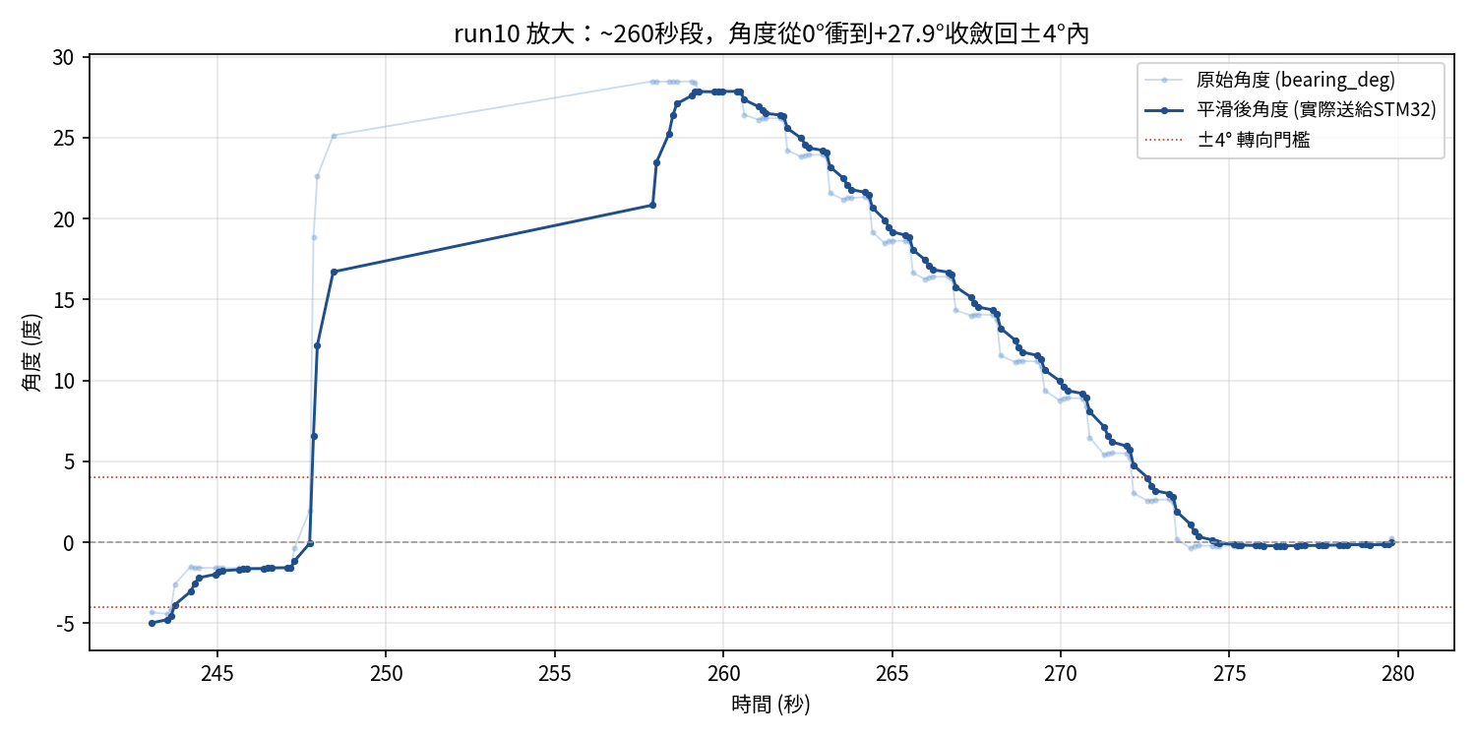
實體車子程式碼/實驗數據/離散控制器/run10_zoom_260s.png
