YourFath3r253/tennisball-picking/實體車子程式碼/舊視覺數據_20260919分析/discrete_baseline_20260909.png

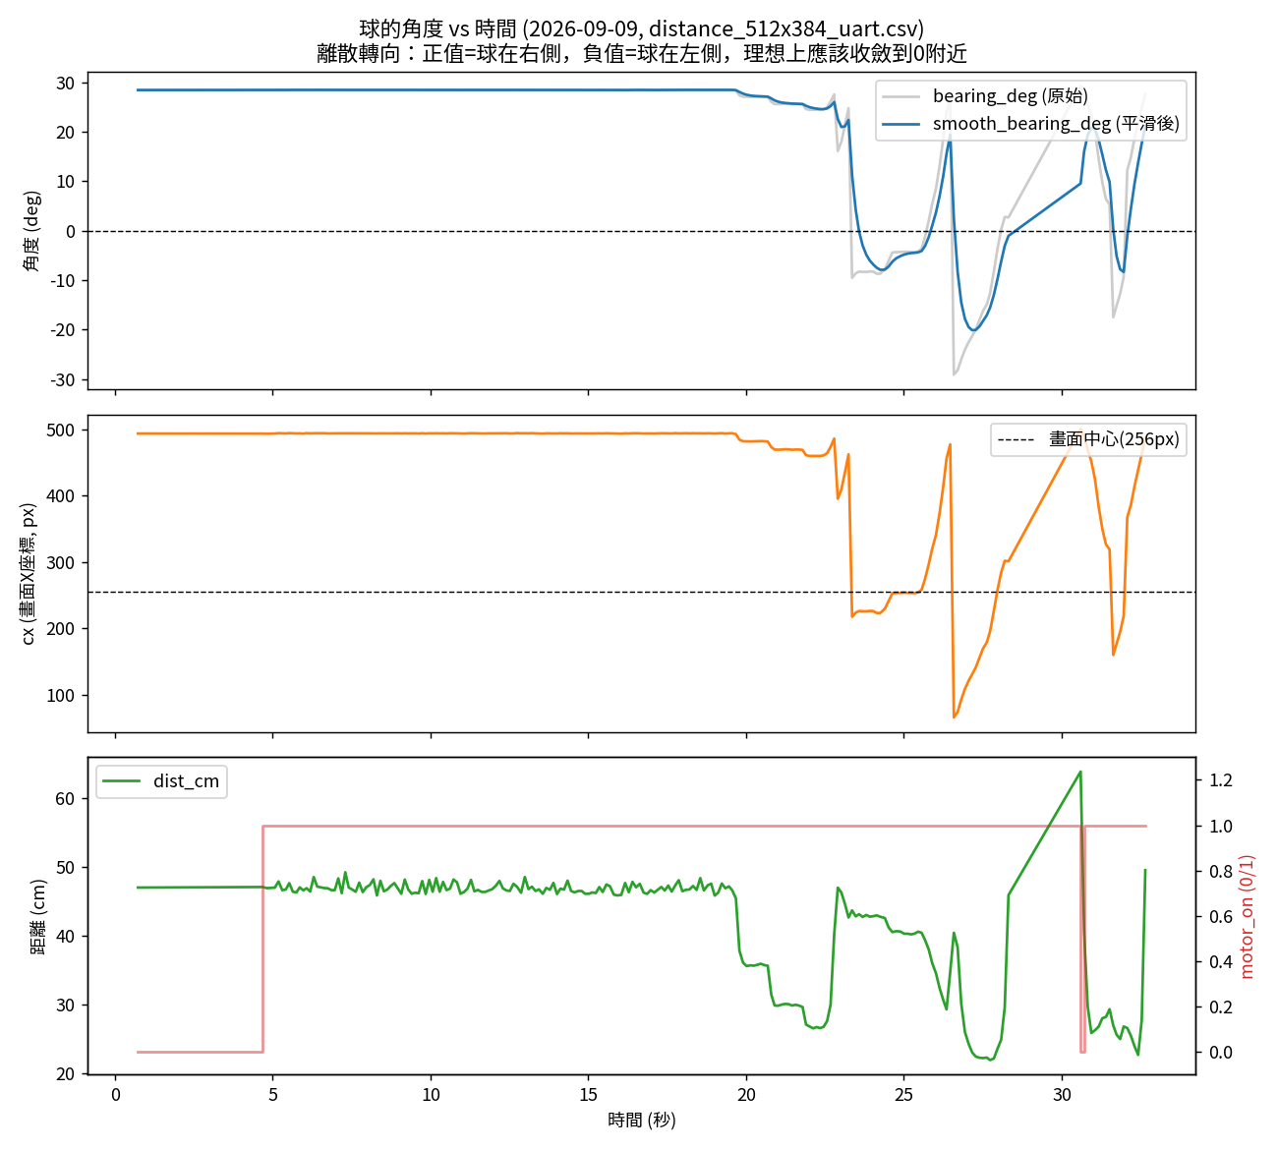
實體車子程式碼/舊視覺數據_20260919分析/discrete_baseline_20260909.png
