YourFath3r253/tennisball-picking/影片/新車模擬_實車程式_kp8000_20261026_seed501_路徑圖.png

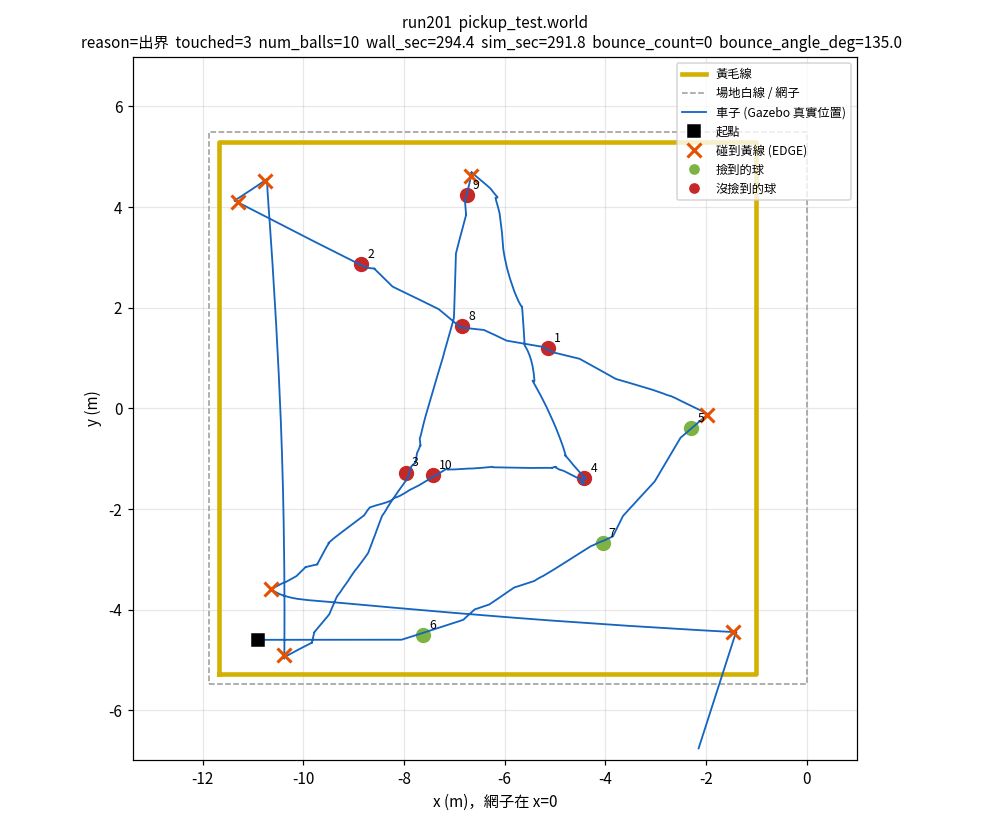
影片/新車模擬_實車程式_kp8000_20261026_seed501_路徑圖.png
