YourFath3r253/tennisball-picking/src/tennis_bot/urdf/meshes/rear_basket.stl

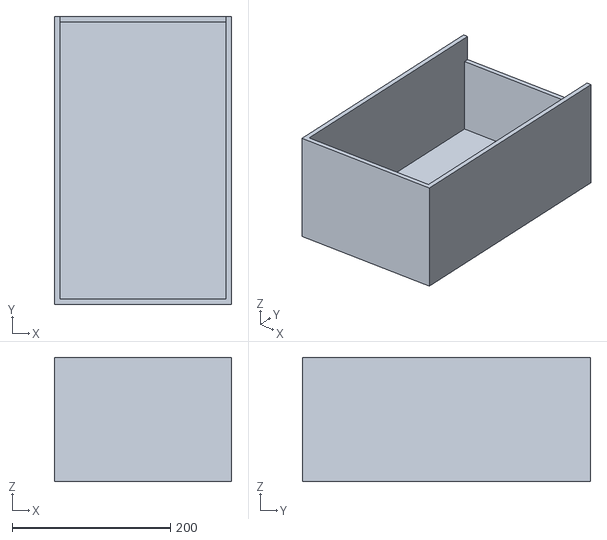
[picture p173: CAD file, 2026-08-04]
src/tennis_bot/urdf/meshes/rear_basket.stl
224.0 x 364.0 x 157.0
