YourFath3r253/tennisball-picking/src/tennis_bot/urdf/meshes/v2/trunk_v2_part9.stl

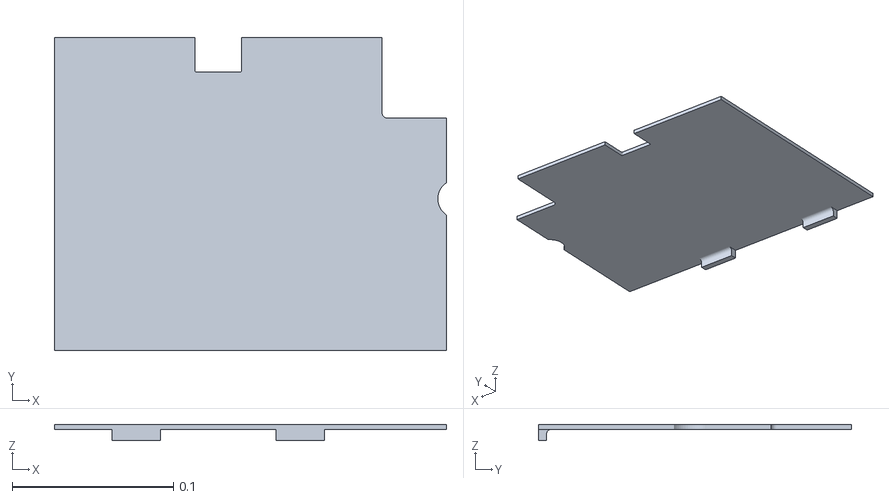
[picture p174: CAD file, 2026-10-26]
src/tennis_bot/urdf/meshes/v2/trunk_v2_part9.stl
0.243 x 0.194 x 0.01
