YourFath3r253/tennisball-picking/src/tennis_bot/urdf/meshes/front_chassis2.stl

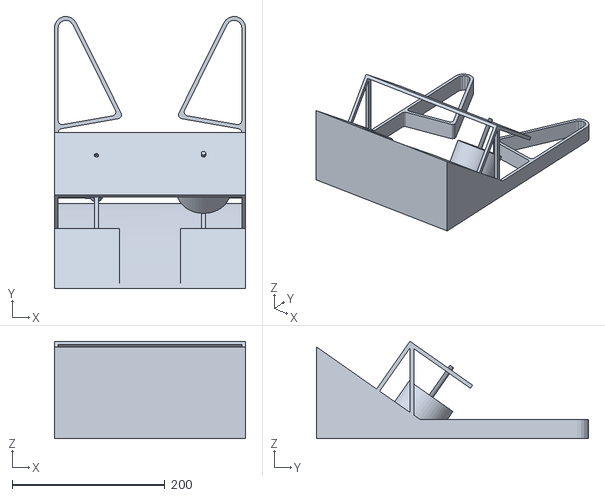
[picture p175: CAD file, 2026-08-04]
src/tennis_bot/urdf/meshes/front_chassis2.stl
250.0 x 355.6 x 127.4
