YourFath3r253/tennisball-picking/src/tennis_bot/urdf/meshes/front_chassis.stl

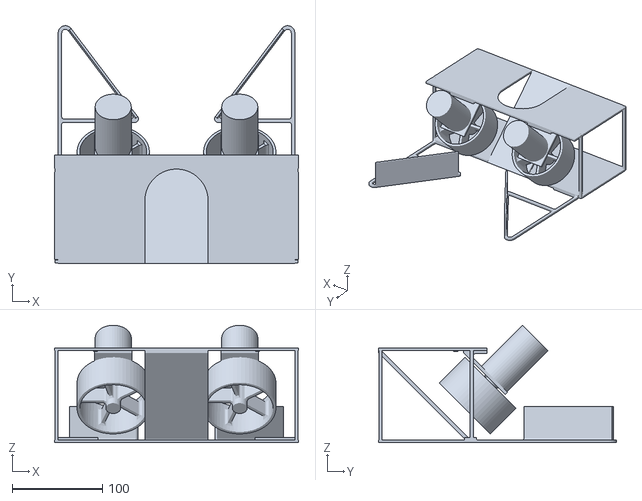
[picture p176: CAD file, 2026-08-04]
src/tennis_bot/urdf/meshes/front_chassis.stl
270.0 x 263.0 x 129.9
