YourFath3r253/tennisball-picking/src/tennis_bot/urdf/meshes/v2/trunk_v2_part6.stl

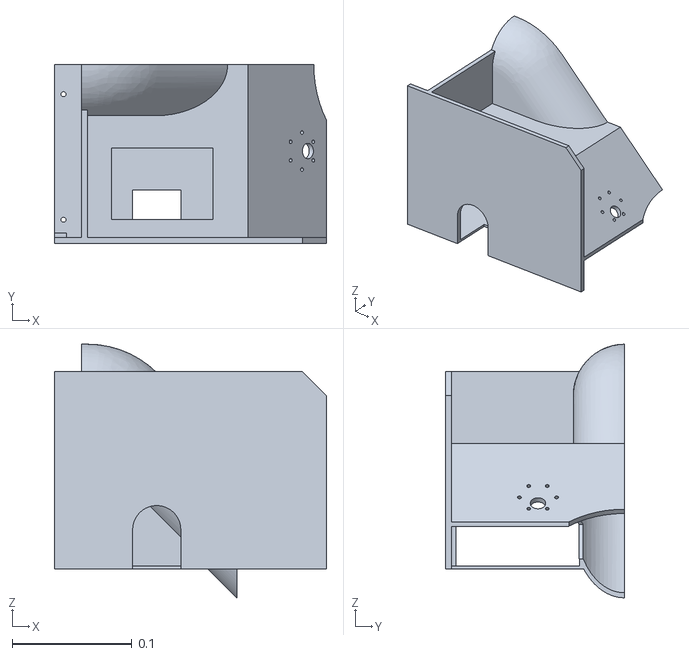
[picture p177: CAD file, 2026-10-26]
src/tennis_bot/urdf/meshes/v2/trunk_v2_part6.stl
0.228 x 0.15 x 0.212
