YourFath3r253/tennisball-picking/src/tennis_bot/urdf/meshes/v2/trunk_v2_motor3.stl

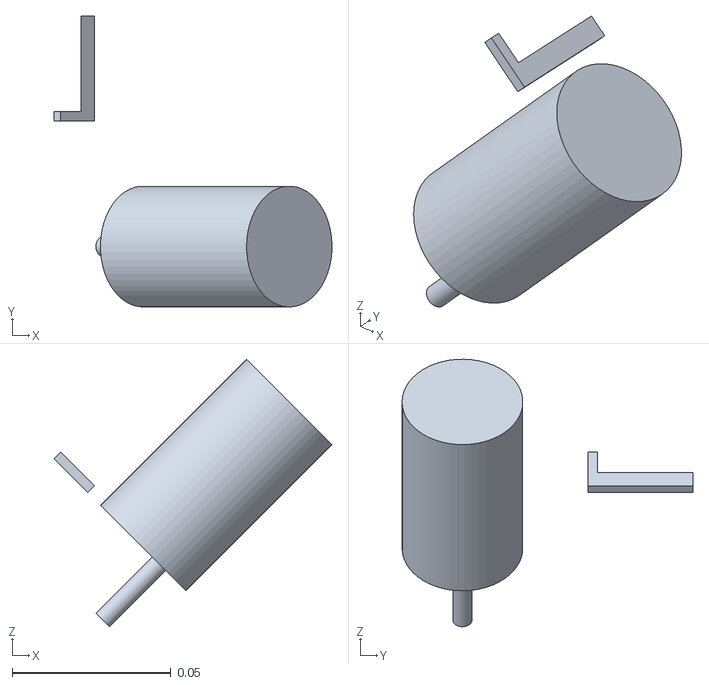
[picture p178: CAD file, 2026-10-26]
src/tennis_bot/urdf/meshes/v2/trunk_v2_motor3.stl
0.0874 x 0.0915 x 0.0841
