YourFath3r253/tennisball-picking/src/tennis_bot/urdf/meshes/v2/trunk_v2_part12.stl

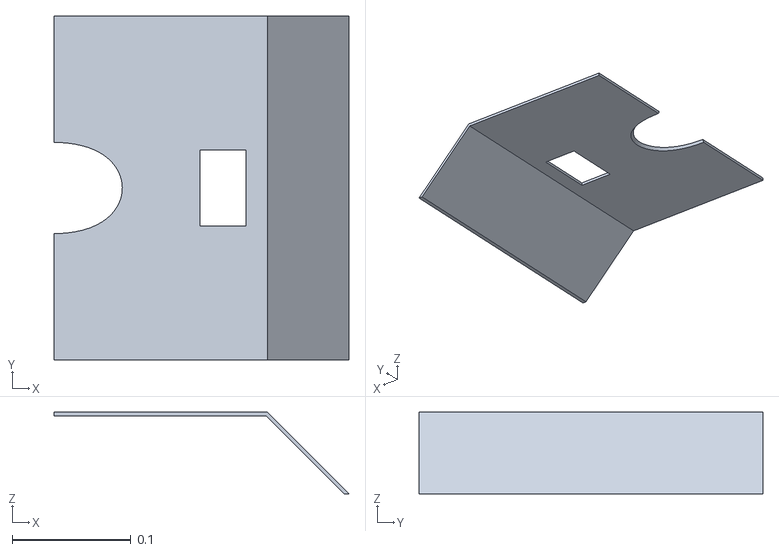
[picture p179: CAD file, 2026-10-26]
src/tennis_bot/urdf/meshes/v2/trunk_v2_part12.stl
0.248 x 0.289 x 0.0686
