YourFath3r253/tennisball-picking/src/tennis_bot/urdf/meshes/v2/trunk_v2_motor2.stl

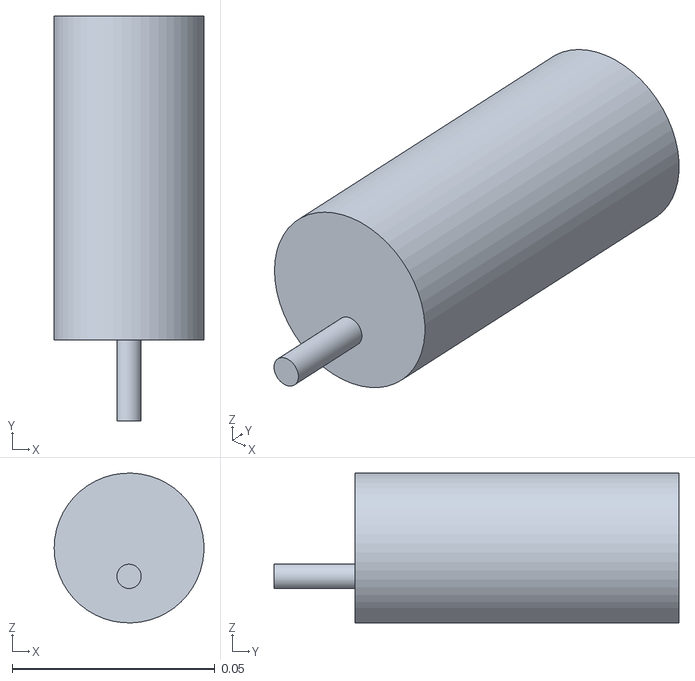
[picture p180: CAD file, 2026-10-26]
src/tennis_bot/urdf/meshes/v2/trunk_v2_motor2.stl
0.037 x 0.1 x 0.037
