YourFath3r253/tennisball-picking/src/tennis_bot/urdf/meshes/v2/trunk_v2_camerastand.stl

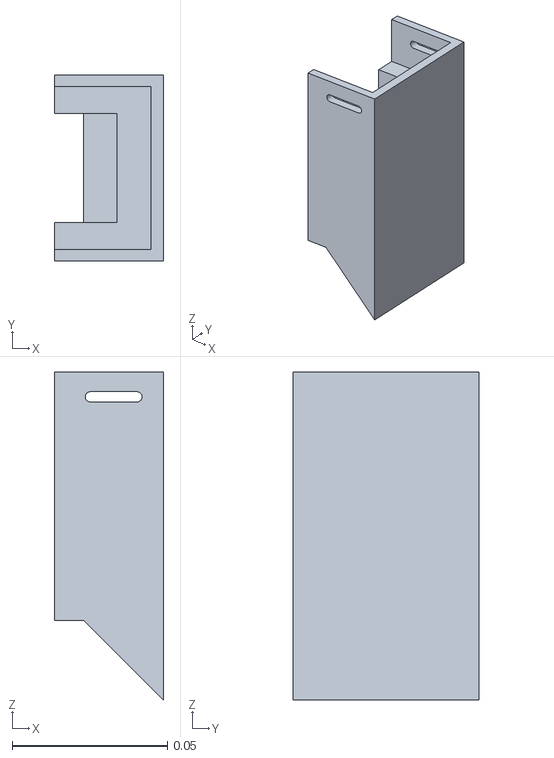
[picture p182: CAD file, 2026-10-26]
src/tennis_bot/urdf/meshes/v2/trunk_v2_camerastand.stl
0.035 x 0.06 x 0.106
