YourFath3r253/tennisball-picking/src/tennis_bot/urdf/meshes/v2/trunk_v2_part10.stl

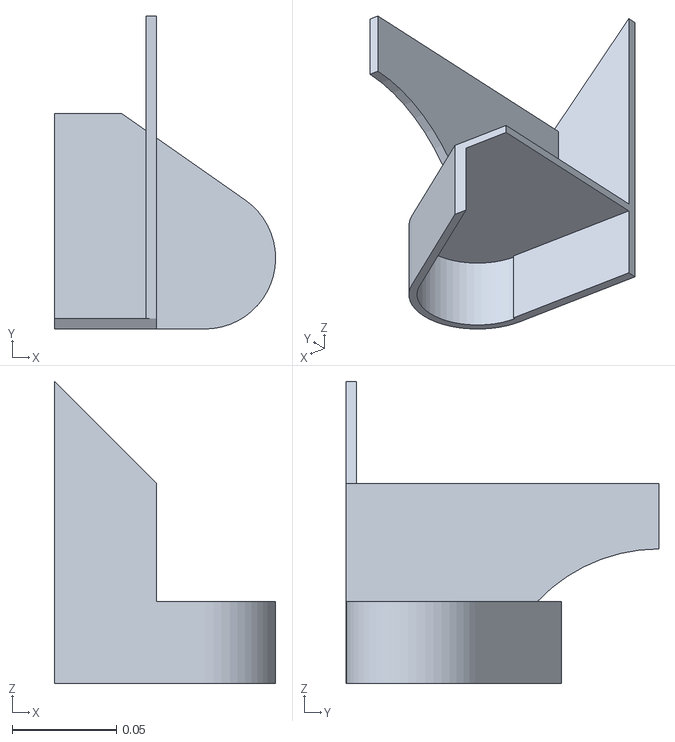
[picture p183: CAD file, 2026-10-26]
src/tennis_bot/urdf/meshes/v2/trunk_v2_part10.stl
0.106 x 0.15 x 0.145
