YourFath3r253/tennisball-picking/src/tennis_bot/urdf/meshes/v2/trunk_v2_jetsonnano.stl

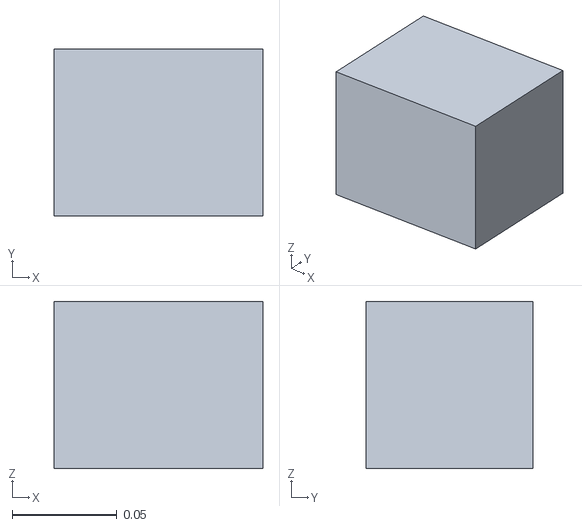
[picture p184: CAD file, 2026-10-26]
src/tennis_bot/urdf/meshes/v2/trunk_v2_jetsonnano.stl
0.1 x 0.08 x 0.08
