YourFath3r253/tennisball-picking/src/tennis_bot/urdf/meshes/v2/trunk_v2_camera.stl

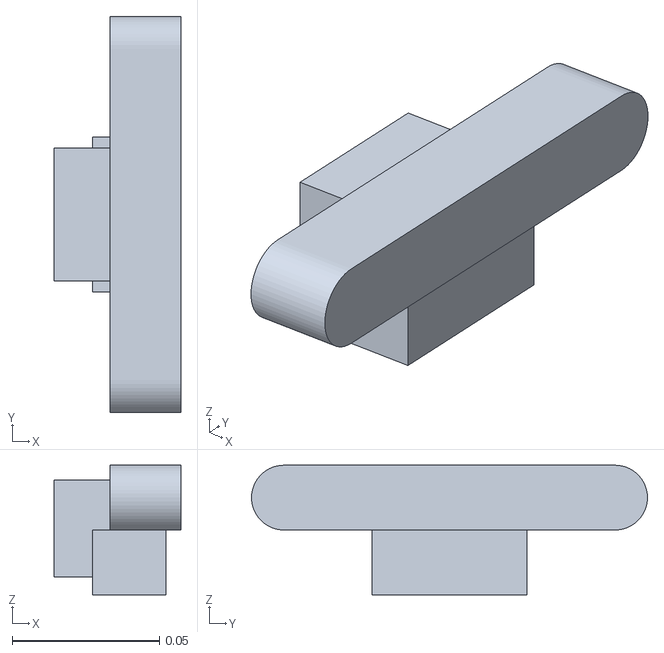
[picture p185: CAD file, 2026-10-26]
src/tennis_bot/urdf/meshes/v2/trunk_v2_camera.stl
0.043 x 0.134 x 0.044
