YourFath3r253/tennisball-picking/src/tennis_bot/urdf/meshes/v2/trunk_v2_sheetmetal.stl

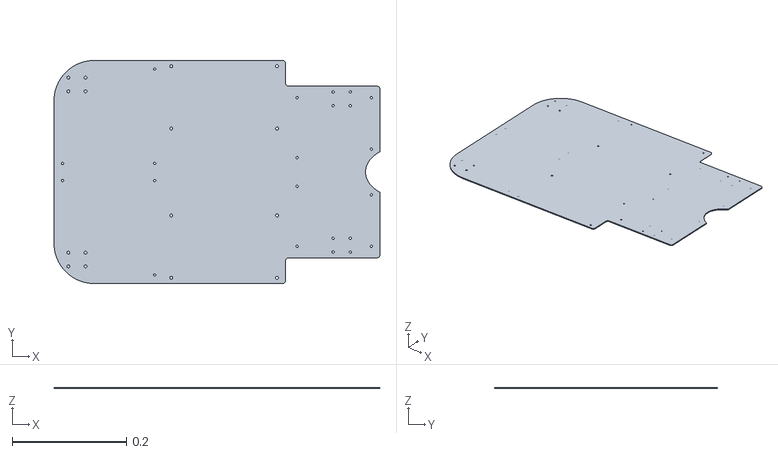
[picture p186: CAD file, 2026-10-26]
src/tennis_bot/urdf/meshes/v2/trunk_v2_sheetmetal.stl
0.57 x 0.39 x 0.002
