YourFath3r253/tennisball-picking/src/tennis_bot/urdf/meshes/v2/trunk_v2_battery.stl

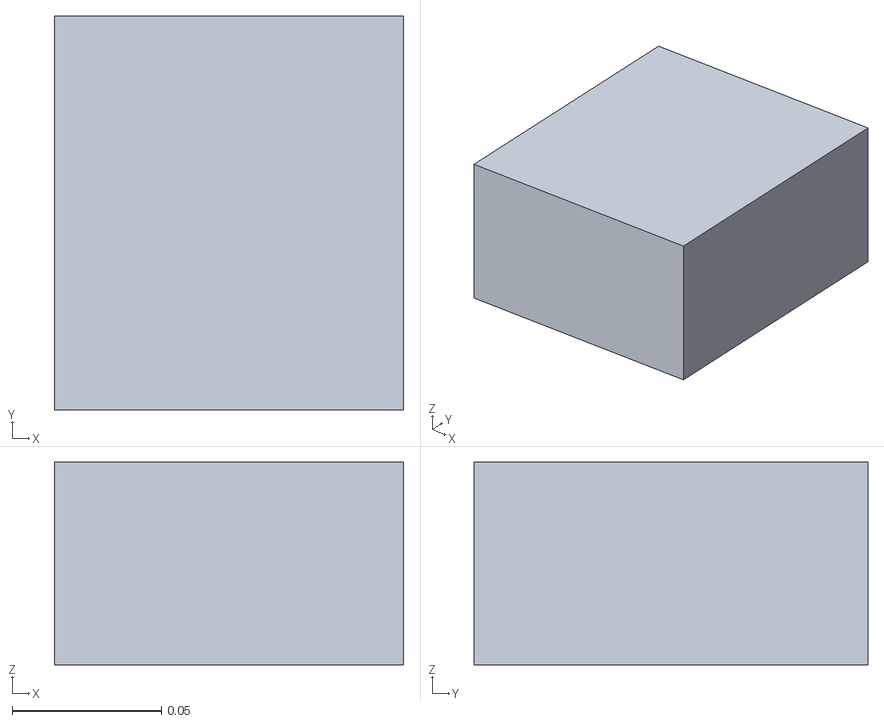
[picture p187: CAD file, 2026-10-26]
src/tennis_bot/urdf/meshes/v2/trunk_v2_battery.stl
0.117 x 0.132 x 0.068
