YourFath3r253/tennisball-picking/src/tennis_bot/urdf/meshes/v2/trunk_v2_05.stl

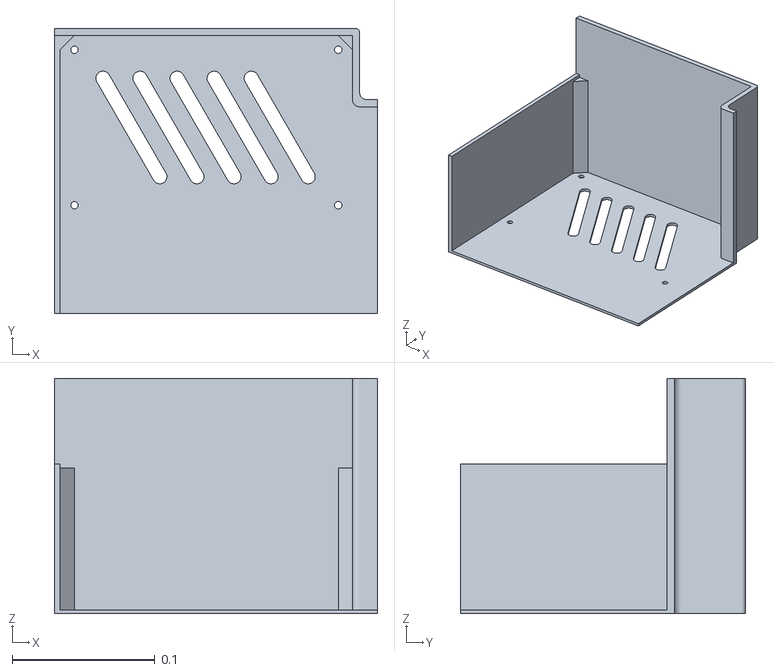
[picture p188: CAD file, 2026-10-26]
src/tennis_bot/urdf/meshes/v2/trunk_v2_05.stl
0.227 x 0.2 x 0.165
