YourFath3r253/tennisball-picking/(list of files, cad)

Other CAD files:
src/tennis_bot/urdf/meshes/v2/trunk_v2_part8.stl
src/tennis_bot/urdf/meshes/v2/trunk_v2_motor4.stl
src/tennis_bot/urdf/meshes/v2/trunk_v2_part11.stl
src/tennis_bot/urdf/meshes/v2/trunk_v2_part7.stl
src/tennis_bot/urdf/meshes/v2/trunk_v2_motor1.stl
src/tennis_bot/urdf/meshes/v2/trunk_v2_01.stl
src/tennis_bot/urdf/meshes/v2/trunk_v2_02.stl
src/tennis_bot/urdf/meshes/v2/trunk_v2_03.stl
