YourFath3r253/tennisball-picking/experiments/實驗數據/delay_comp_step.png

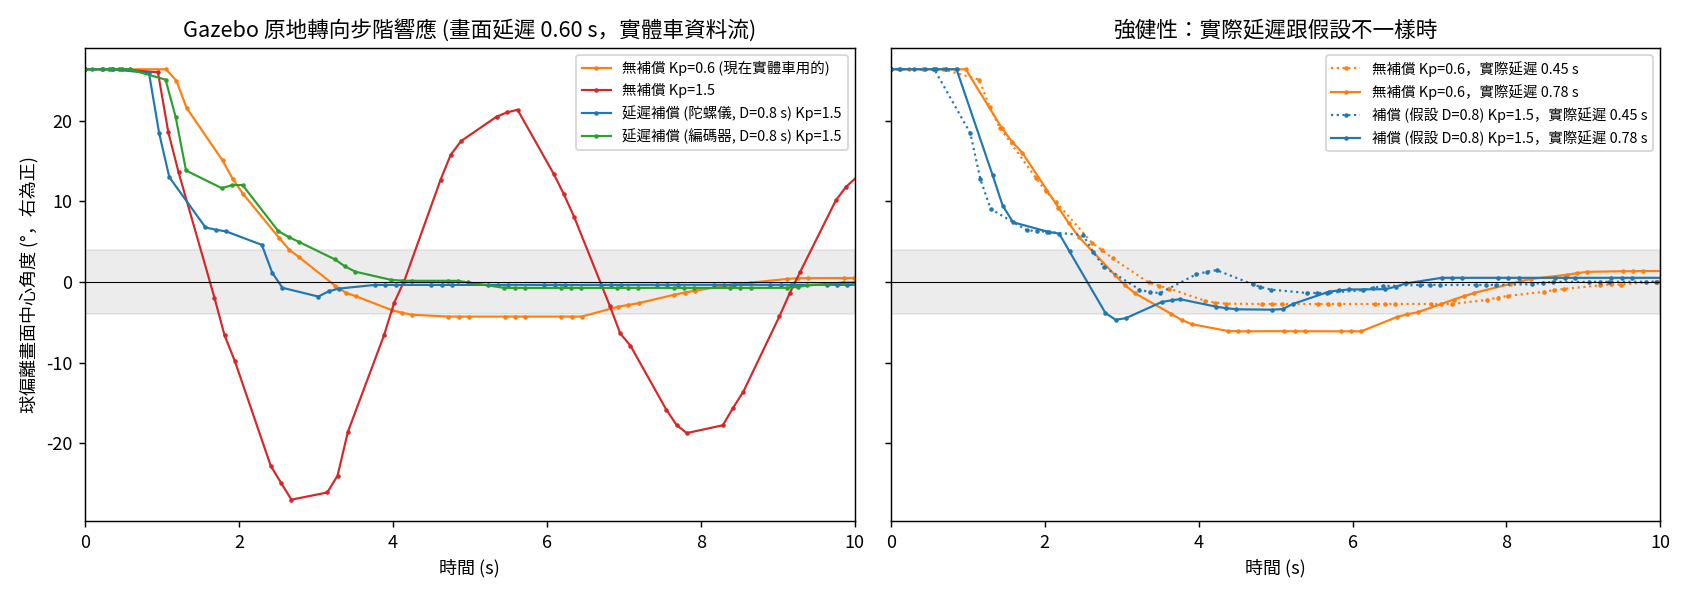
experiments/實驗數據/delay_comp_step.png
