YourFath3r253/tennisball-picking/experiments/實驗數據/step_sim_vs_real.png

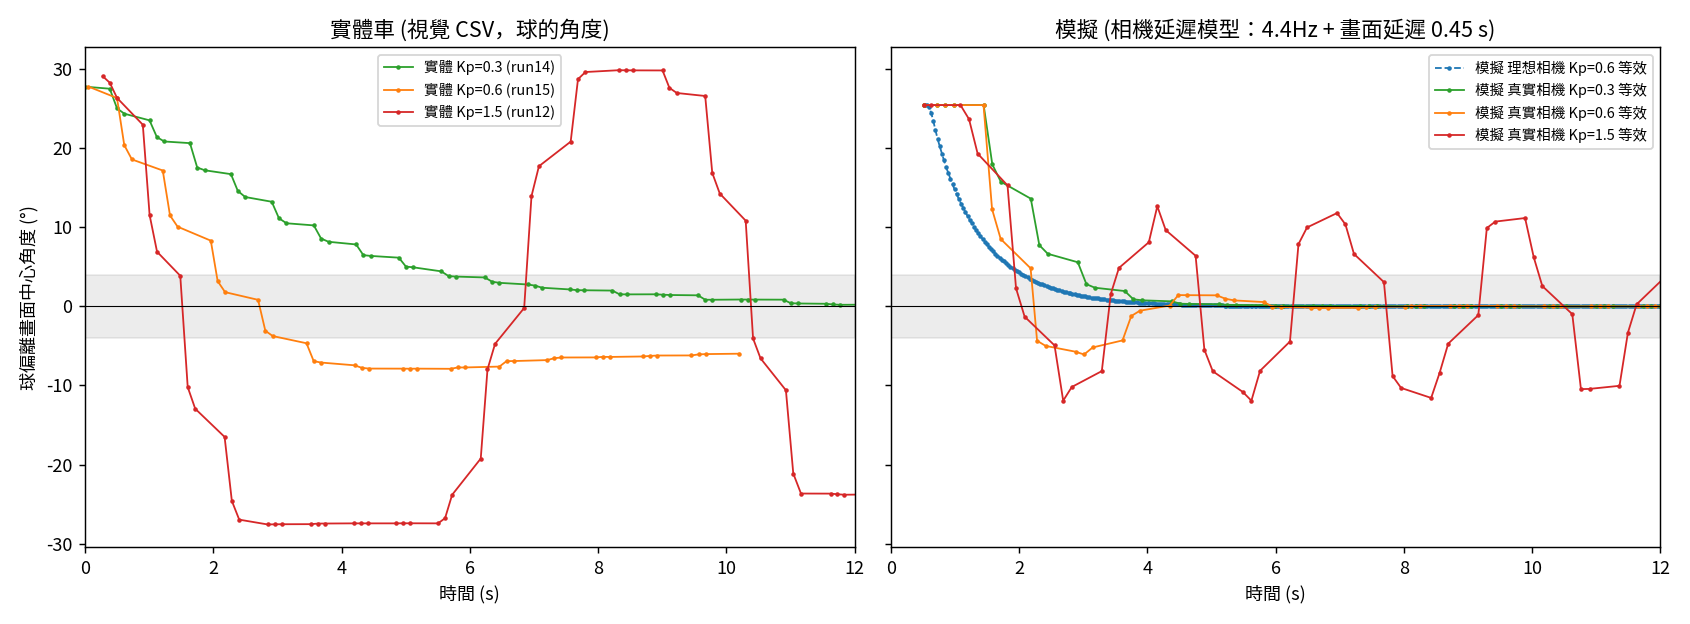
experiments/實驗數據/step_sim_vs_real.png
