YourFath3r253/tennisball-picking/experiments/報告_2026-10-05_模擬真實化與D同學邊界提案.md

# 2026-10-05 模擬真實化 + D 同學半場四色邊界提案

所有時間都用**模擬時間**計算（Gazebo 即時率低於 1 時，真實時鐘會高估時間）。
run 資料夾都在 `experiments/實驗數據/runNNN/`。每次實驗的佈局 json 跟 manifest 在 `layouts/`。

## Git 分支

| 分支 | 內容 |
|---|---|
| `sim2real-base` / `sim2real-base2` | 只改實驗工具（launch 參數、模擬時間紀錄、vision 拆出 `_process_frame`），模擬行為不變 |
| `sim-realism` | ① 模擬真實化，每一步一個 commit（R1 → R5） |
| `boundary-bounce` | ② D 同學提案（理想模擬，**沒有**真實化） |
| `realism-bounce` | ①＋② 合併版（這份報告的最終版本） |

`main` 沒有動。合併到 main 前要先跟 Sean 確認。

---

## ① 模擬真實化：做了什麼、為什麼、效果

- 驗證佈局：seed 301。全場＋網子、9 顆球，每一步只加一個東西（一次只改一個變數）。
- baseline 是 run116、run121：9/9，373 s，里程計平均誤差 0.05 m，航向最大誤差 0.57°。

| # | 增加的東西 | 數值（出處） | 為什麼要加 | 加了之後的效果（實測） |
|---|---|---|---|---|
| R1 | 網球：轉動慣量、滾動阻力 | 厚殼球 0.6 m r²（原本當實心球 0.4）。滾動阻力 μr≈0.02（Singh 2008），用 `velocity_decay` 近似 | 原本 ODE 沒有滾動摩擦，被撞到的球會一直滾下去：run103 滾到 36 m 外，run109 滾到 289 m，run142 滾到 470 m | 以 1 m/s 推出去：原本滾 10 m 以上，最後撞到網子才停 → 現在 2.5 m。以 0.3 m/s 推出去 → 0.74 m。合併版的 110°／佈局 503 不再有球飛出場，從 9/10 逾時變成 10/10 |
| R1b | 陀螺儀＋加速度計做傾斜修正（模擬 BNO080 的感測融合） | Mahony 互補濾波，K=0.5，只在量到的加速度接近 1 g 時才修正 | 只靠陀螺儀積分時，傾斜誤差會一直累積，轉彎時就漏到航向。真的 BNO080 本來就有用加速度計修正 | 只加 R1 時：航向最大誤差 2.2°（run123）。加上 R1b：0.57°（run124），回到 baseline |
| R2 | 球場地面摩擦 | μ=0.63（ITF CPR 公式，取中速硬地） | 原本地面 μ=100，等於完全不會滑 | 9/9，372.6 s，里程計 0.022 m，航向 0.35°（run125），沒有看到明顯變差 |
| R3 | 輕微砂礫 | 338 顆，每平方公尺 1 顆，露出地面 1~4 mm | 真實球場的砂粒、小石頭 | 沒有可量測的影響：車體最大 roll 0.3°（run126）。加密到每平方公尺 5 顆、露出 2~6 mm（run131）：roll 變成 1.05°，撿球一樣 9/9 |
| R4 | 陀螺儀雜訊＋零點偏移 | 0.0077 rad/s（1 kHz）；偏移 0.5°/min（BNO080 規格書） | 原本是理想 sensor，航位推算不可能完美 | **航向誤差 1.8~4.2°，大約等於 0.5°/min × 跑的時間；里程計誤差 0.1~0.9 m**（run127~130） |
| R5 | 相機更新率＋延遲 | 輸出平均 4.4 Hz，間隔照固定循環 0.11/0.11/0.45 s（實體車約 2700 幀實測）。畫面延遲 0.45 s（用模擬去對上實體車的等效延遲 0.70 s） | 實體車 Kp=1.5 會擺盪，原因就是視覺延遲 | 1. 步階響應：見 `step_sim_vs_real.png`。模擬裡用跟實體 Kp 0.3/0.6/1.5 等效的增益，overshoot 分別是 0° / 6.1° / 一直擺盪。實體車是 0° / 7.7°（只有一邊）/ 擺盪，趨勢一樣。2. 整場跑：9/9，368.5 s（run128）。追球邏輯沒有因為延遲壞掉 |

**全部真實化之後，3 個佈局的結果**（baseline run116/117/118 → 真實化 run128/129/130）：

- 撿球：3/3 → 3/3，每場都是 9/9
- 撿完時間：平均 367 s → 393 s（+7%）
- 里程計平均誤差：0.04 m → 0.21 m；最大誤差 0.07 m → 0.92 m
- 航向最大誤差：0.4° → 2.7°

### 試過、但有數據證明不該加的

- **網球質量照 ITF 改成 57.7 g**：現在的滾輪模型撿不起來，12 次全部 0/12（W=42.5/50/55，海綿 kp=150/300/600）。原因是滾輪位置跟 CAD 不一樣，海綿 k 值也是用 27 g 的球調出來的。要等 A 同學的 3D 檔，再加上實測的滾輪轉速，才能重新建立滾輪模型。
- **網球剛性照 ITF 改成 1.23e4 N/m**：後車廂裡的球在 ODE 的軟接觸下會抖動，陀螺儀積分就壞掉。整場的航向誤差變成 5.8~20.6°。這是 ODE 的數值問題，不是真實物理。

### 真實化過程中挖出來的模擬缺陷

- **煞車時車頭往前點頭約 20°**。baseline 也有，因為質量分布是暫時亂填的（兩顆滾輪各 0.5 kg 放在最前面，車身只有 0.1 kg）。要 A 同學的質量、重心資料才能修。
- Gazebo 偶爾會整個停住大約 80 s（模擬時間也不走）。另外 `/joint_states` 偶爾會斷 2~3 s，這段時間的里程計就丟掉了。只有用里程計的弓字路徑會受影響（run146 出界就是這個原因）。建議里程計改成用輪子的「累積角度」，就像實體 STM32 累積編碼器 count 那樣，斷線也不會丟距離。

---

## ② D 同學提案：半場四色邊界，碰到邊界轉 x 度

- **場地**：ITF 半場。RED 底線，BLUE 左邊線，MAGENTA 右邊線，網子前 1 m 再貼一條 CYAN。
- **偵測邊界**：只看畫面下方、離相機 0.6 m 以內的地面。四種顏色實測都剛好在 0.60 m 觸發，斜著靠近時也能分出邊界在左邊還是右邊。
- **轉向規則**：邊界在左邊就右轉，否則左轉。四條邊都用同一套規則。
- **追球**：照舊。撿完一顆後，用當下的方向繼續直走。

### Gazebo 實驗（理想模擬，10 顆球，同樣 3 個佈局，只改轉向角）

| 方法 | 佈局 501 | 佈局 502 | 佈局 503 | 撿滿 | 平均撿完時間 | 平均轉向次數 |
|---|---|---|---|---|---|---|
| 轉 90° | 7/10 逾時（繞外圈） | 283 s | 294 s | 2/3 | 289 s | 17.7 |
| 轉 110° | 269 s | 238 s | 9/10 逾時（球被踢到 470 m 外，模擬缺陷） | 2/3 | 253 s | 18.0 |
| **轉 135°** | **233 s** | **354 s** | **141 s** | **3/3** | **243 s** | **7.0** |
| 轉 180° | 7/10 逾時（在同一條線上來回） | 171 s | 453 s | 2/3 | 312 s | 16.7 |
| 弓字路徑（半場，比較基準） | 225 s | 5/10 出界（`/joint_states` 斷線） | 9/10（球被踢飛） | 1/3 | 225 s | - |

### 2D 快速模擬（200 個隨機佈局，10 顆球，`bounce_2d_sim.py`）

| 轉向角 | 全部撿完的比例 | 撿完時間中位數 |
|---|---|---|
| 90° | 66.0% | 257 s |
| 110° | 98.0% | 258 s |
| 135° | 100% | 273 s |
| 180° | 3.5% | 192 s |
| 隨機 110~160° | 99.5% | 286 s |
| 隨機 90~180° | 100% | 304 s |

- 只放 3 顆球時，排名一樣：135° 100%、110° 98%、90° 65.5%、180° 4.5%。
- 文獻預測：固定角度反彈會收斂到週期軌道（Nilles 2017）。90° 會一直繞外圈，180° 會在同一條線上來回，跟實驗看到的一樣。
- 我們的情況有一個額外好處：每撿一顆球方向就被打亂一次。所以 135° 在 Gazebo 3/3、在 2D 模型 100% 都能撿完。

**結論：用 135°。**

---

## ①＋② 合併版（真實化之後的半場，同樣 3 個佈局）

| 方法 | 佈局 501 | 佈局 502 | 佈局 503 | 撿滿 | 平均撿完時間 |
|---|---|---|---|---|---|
| 轉 135° | 236 s | 212 s | 245 s | 3/3 | 231 s |
| 轉 110° | 380 s | 208 s | 192 s | 3/3 | 260 s |
| 弓字路徑（半場） | 205 s | 168 s | 247 s | 3/3 | 206 s |

- 加了真實的相機延遲、陀螺儀漂移、地面摩擦、砂礫之後，135° 一樣 3/3，平均時間跟理想模擬差不多（243 s → 231 s）。
- 但是單看個別佈局差很多：502 從 354 s 變 212 s，503 從 141 s 變 245 s。反彈路徑對初始條件很敏感，每個角度只有 3 次樣本，分不出 ±20% 以內的差異。
- D 的方法**完全不需要里程計**：轉向只看陀螺儀的「相對角度」，邊界只看相機。所以陀螺儀零點偏移造成的航向漂移，對它幾乎沒有影響。
- 弓字路徑還是比較快（206 s vs 231 s，約 11%），但它依賴里程計，理想模擬裡有一次因為里程計斷線而出界。
