YourFath3r253/tennisball-picking/experiments/實驗數據/delay_comp_results.md

# 相機延遲補償（簡化版 Smith predictor）：Gazebo 實作結果（2026-10-05）

- 離線設計：`experiments/delay_comp_design.py`
- Gazebo 步階測試：`experiments/step_response_stm32.py ... <comp> <D>`
- 整場實作：`grid_patrol_node.py`，用環境變數 `TENNISBOT_DELAY_COMP=gyro|encoder` 開啟，另外有 `TENNISBOT_DELAY_COMP_SEC`、`TENNISBOT_STEER_KP`
- 比較圖：`experiments/實驗數據/delay_comp_step.png`

## 做法（實體車 STM32 也做得到）

1. 收到 `BALL,角度 b` 時，假設這張畫面是 D 秒前拍的，算出目標航向：
   `psi* = psi(現在 − D) − b`（球在右邊為正，車子逆時針轉為正）
2. 之後每 10~20 ms，用最新的轉角算誤差，不必等下一筆視覺：
   `e = psi* − psi(現在)`，`y = Kp × e`；左輪 −y/2、右輪 +y/2，單輪限制 ±45 rpm
3. 轉角的來源有兩種：
   - **陀螺儀**：模擬裡就是 `/imu`
   - **編碼器積分**：等同 `main.c` 的 `chassis_angle_deg`；原地轉時輪胎會側滑，會高估轉角
4. 不補償時就是原本的做法：`y = Kp × (0 − b)`，只在收到 BALL 時才更新。

## Gazebo 步階測試（起始 29°；資料流跟實體車一樣：畫面延遲 0.60 s、EMA、輪速 PID＋馬達模型）

穩定時間 = 從開始轉，到一直待在 ±4° 內為止。

| 控制器 | 上升時間（進入 ±4°） | 穩定時間 | overshoot |
|---|---|---|---|
| 無補償 Kp=0.6（實體車目前用的） | 1.60 s | 5.74 s | 4.29° |
| 無補償 Kp=1.5 | 0.74 s | 不收斂（一直擺盪） | 27.0° |
| 補償・陀螺儀 D=0.8，Kp=1.0 | 1.93 s | 1.93 s | 0.66° |
| **補償・陀螺儀 D=0.8，Kp=1.5** | **1.60 s** | **1.60 s** | **1.81°** |
| 補償・陀螺儀 D=0.9，Kp=1.5 | 1.44 s | 1.44 s | 3.08° |
| 補償・陀螺儀 D=0.8，Kp=2.0 | 1.93 s | 1.93 s | 2.44° |
| 補償・編碼器 D=0.8，Kp=1.5 | 2.20 s | 2.20 s | 0.73° |

**強健性**：控制器假設延遲 D=0.8，但實際的相機延遲不一樣。

| 實際畫面延遲 | 無補償 Kp=0.6：穩定時間／overshoot | 補償 Kp=1.5：穩定時間／overshoot |
|---|---|---|
| 0.45 s（比假設短） | 1.60 s／2.73° | 2.07 s／1.37° |
| 0.60 s（標稱值） | 5.74 s／4.29° | 1.60 s／1.81° |
| 0.78 s（比假設長） | 5.74 s／6.12° | 2.67 s／4.69° |

**結論**

- 補償讓 Kp 可以拉到 1.5 而不會擺盪，穩定時間從 5.74 s 降到 1.60 s。
- 無補償 Kp=0.6 慢的原因：衝過頭到 −4.3° 之後，誤差太小推不動馬達（死區），會在 −4° 附近卡好幾秒。補償讓我們能用更高的增益，所以沒有這個問題。
- 實際延遲比假設**短**時，補償會稍微慢一點（2.07 s vs 1.60 s）。實際延遲**長**時，補償明顯比較好。
- 這就是 Sean 說的「前饋要指定系統狀況」：延遲 D 要量準。在模擬裡，可以把「延遲估錯會變多差」先量出來。

## 整場測試（各 1 次，同一個佈局）

| 情境 | 無補償 Kp=0.6 | 補償・陀螺儀 Kp=1.5 D=0.8 |
|---|---|---|
| 全場＋網子，佈局 301，9 顆 | run157：391.8 s；對準 6 次，平均 2.56 s／次 | run159：387.7 s；對準 7 次，平均 **1.00 s／次** |
| 半場邊界 135°，佈局 501，10 顆 | run158：274.9 s；對準 10 次，平均 3.16 s／次 | run160：257.9 s；對準 9 次，平均 **1.56 s／次** |

- 每顆球的對準時間少了一半以上（−61%、−51%）。
- 但總撿球時間只少 1%~6%：對準只佔全部時間的 4~11%，大部分時間花在巡邏、開過去撿球。

## 搬到實體車要注意

- **實體車的陀螺儀還沒接上**，只能先用編碼器積分的轉角。
  - 模擬裡編碼器版本也能穩定：Kp 1.5 時 2.20 s、overshoot 0.73°。
  - 但原地轉的側滑比例（模擬用 0.70）要先在實車量過。
- **延遲 D 要先量**：實體車延遲範圍約 0.53~0.92 s。
- 實體車驗證流程：
  1. 照這裡的設定燒進去，跑同樣 29° 的步階
  2. 比較預測（穩定約 1.6~2.2 s、overshoot < 5°）跟實測
  3. 用差距修正模擬
