YourFath3r253/tennisball-picking/experiments/實驗數據/motor_model_fit.md

# 底盤馬達模型擬合（2026-10-05）

- 模型：`src/tennis_bot/tennis_bot/motor_model.py`
- 擬合程式：`experiments/fit_motor_model.py`

## 模型結構

1. **STM32 輪速 PID**：照 `main.c` 一行一行移植。
   - 10 ms 中斷，編碼器每圈 827.2 count；10 ms 內轉 1 count 就是 7.25 rpm，所以低速時量到的轉速是一格一格的。
   - 低通濾波：新值 = 0.8 × 舊值 + 0.2 × 量到的值。
   - PID：Kp=5、Ki=1、Kd=0.01；誤差大於 max(30, 0.5×目標) 時把積分清掉（動態積分分離）；PWM 限幅 ±1000。
2. **直流減速馬達**：先扣掉一段死區（靜摩擦），剩下的 PWM 照一階延遲變成轉速。
3. **車體運動學用實體車幾何**：輪半徑 0.052 m、輪距 0.243 m（取自 `main.c`）。再乘上一個「轉向效率」，代表原地轉時輪胎側滑、萬向輪拖行，車身實際轉得比公式算的慢。
4. **視覺端**：輸出節奏是 0.11 / 0.11 / 0.45 s 一個循環，每次用的是「畫面延遲」秒前拍的畫面，再經過 D 同學程式的 EMA 平滑（α=0.35），才送 `BALL,距離,角度` 給 STM32。

## 用到的實測數據

- **PWM 1000 時轉速 550 rpm**：9/20 方向接反、PID 正回授一路飽和，兩輪都穩定在 −545~−555 rpm（`rpm_log_standalone.csv`、`rpm_log_left10_power_on.csv`）。
- **原地轉向 P 控制**：
  - Kp=0.3：run14，加上記憶裡 run13/14 的紀錄
  - Kp=0.6：run15 兩次
  - Kp=1.5：run12 的擺盪（等效延遲 = 衝過頭的角度 ÷ 過零角速度）
- **限制條件**：9/21 接好線後，「固定 ±40 rpm 能正常自轉」。
  - 起步時誤差 40 > 30，`main.c` 會把積分清掉，只剩 P 項 5×40 = 200 PWM。
  - 要轉起來，就得讓轉速先超過 10 rpm（這時誤差 < 30 才開始積分）。
  - 所以死區一定 ≤ 約 134 PWM。

## 擬合結果

| 模型 | Kp=0.3 上升時間 | Kp=0.3 overshoot | Kp=0.6 上升時間 | Kp=0.6 overshoot | Kp=1.5 等效延遲 | Kp=1.5 擺幅 | 誤差分數 |
|---|---|---|---|---|---|---|---|
| **實體車 (9/21)** | 5.3~7.6 s | 0° | 2.0~3.3 s | 1.4~7.9° | 0.53~0.92 s | 18~30° | - |
| 擬合結果 (死區130, tau0.35, 畫面延遲0.60, 轉向效率0.70) | 5.14 s | 0.00° | 1.79 s | 3.61° | 0.82 s | 17.26° | 0.39 |
| 對照A：理想馬達 + 實體車幾何 + 舊畫面延遲0.45 | 3.80 s | 0.26° | 1.79 s | 5.79° | 0.65 s | 10.83° | 2.19 |
| 對照B：死區600 (無限制擬合，違反40rpm可自轉) | 4.02 s | 0.01° | 1.90 s | 4.10° | 0.69 s | 18.95° | 0.86 |

- 擬合出來的參數：死區 130 PWM、K = 550/870 = 0.63 rpm/PWM、時間常數 0.35 s、轉向效率 0.70、畫面延遲 0.60 s。
- 跟對照 A 比，誤差分數從 2.19 降到 0.39。最大的修正來自兩件事：
  1. **實體車輪半徑是 0.052 m**。之前記憶裡的換算公式把「輪徑 0.1 m」誤當半徑，算出 2.47°/s per rpm 差，實際應該約 1.28。
  2. **D 同學程式的 EMA 平滑**，本身就讓延遲多了一截。

## 還沒對上的地方（老實記錄）

- Kp=0.3 模擬 5.1 s，在實體車範圍的下緣。Kp=0.6 模擬 1.8 s，比實體車快一點。
- Kp=1.5 的擺幅 17° 偏小。實體車在擺盪的端點會停住約 3 s 不動，原因還沒找到，這個模型沒有重現。
- 動摩擦只有一個值，沒有區分原地轉（側滑阻力大）跟直走。

## 模型給出的一個預測（還沒實測）

用現在 `main.c` 的積分分離門檻（30 rpm），從靜止直接給 55 rpm，模型預測會卡在約 22 rpm：
- 誤差 33 一直大於 30，積分永遠不累積。
- B 同學直走時用「15 rpm 起步、每次 +8 rpm」的斜坡，剛好避開這個問題。模擬的控制節點也照做（`TargetRamp`）。

可以在實體車上驗證：讓輪子懸空或放在地上，不經過斜坡，直接給 55 rpm，看實際轉速。

## 要再提升，最需要的數據

Jetson 上 run12~15 的 `*_rpm.csv`（目標轉速 vs 實際轉速，每 50 ms 一筆）。D 同學程式的 `drain_rpm_telemetry` 有在記錄，可以直接拿來擬合馬達，不用再透過視覺角度間接推算。

## Gazebo 端到端驗證：孿生準確度表 v1（2026-10-05）

- 工具：`experiments/step_response_stm32.py`
- 資料流跟實體車一樣：Gazebo 相機 → 真實相機模型 → D 同學 UART 字串 → STM32 轉向公式（Kp 單位跟實體車 rpm/度 相同）→ 輪速 PID ＋馬達模型
- 每個 Kp 從 29° 起步，跑一次
- 上升時間的定義：從開始轉，到進入 ±4° 為止

| 指標 | 實體車 | 舊模擬（今天之前：理想馬達、cmd_vel 直接給速度、增益換算用錯的輪半徑） | 新模擬（實體車介面＋馬達模型） |
|---|---|---|---|
| Kp=0.3 上升時間 | 5.3~7.6 s | 1.6 s | **4.1 s** |
| Kp=0.3 overshoot | 0° | 0° | 0° |
| Kp=0.6 上升時間 | 2.0~3.3 s | 2.3 s | 1.6 s |
| Kp=0.6 overshoot | 1.4~7.9° | 6.1° | 4.3° |
| Kp=1.5 等效延遲 | 0.53~0.92 s | 0.86 s | 0.85 s |
| Kp=1.5 擺幅 | 18~30° | 12° | 15° |

- **變好的：** Kp=0.3 上升時間（1.6 → 4.1 s）、Kp=1.5 擺幅（12° → 15°）都更接近實體車。
- **沒對上的：**
  - Kp=0.6 上升時間偏快（1.6 s vs 2.0~3.3 s）。
  - 擺幅還是偏小，因為實體車在端點會停住約 3 s，模型沒有重現。
- 原始資料：`step_response_sim/stm32_kp*.csv`

## 整場回歸測試（新介面，確認整個系統沒壞）

| 測試 | 之前（只有模擬真實化） | 新介面 |
|---|---|---|
| 全場＋網子，佈局 301，9 顆 | run128，9/9，368.5 s | run157，9/9，391.8 s（+6%） |
| 半場四色邊界 135°，佈局 501，10 顆 | run148，10/10，236 s | run158，10/10，274.9 s（+16%） |

變慢的原因：對準（ALIGN）改用實體車驗證過的 Kp=0.6 轉向，加上真實的馬達反應。
