YourFath3r253/tennisball-picking/experiments/實驗數據/bounce_2d_angle_study_results.md

# 邊界反彈轉向角度細部研究（2D 快速模擬，2026-10-05）

工具：`experiments/bounce_2d_angle_study.py`。條件：400 個隨機佈局、10 顆球，900 s 內全部撿完才算成功。
**σ** 是加在每次轉向上的高斯誤差，模擬真實車轉向不會剛好轉準。

| 規則 | σ=0° 撿完率 | σ=0° 中位數 | σ=3° 撿完率 | σ=3° 中位數 | σ=8° 撿完率 | σ=8° 中位數 |
|---|---|---|---|---|---|---|
| 固定 110° | 96.8% | 261 s | 98.5% | 262 s | 99.5% | 263 s |
| 固定 120° | 89.0% | 252 s | 96.8% | 255 s | 99.5% | 256 s |
| 固定 125° | 86.8% | 252 s | 94.8% | 251 s | 99.5% | 262 s |
| 固定 130° | 86.0% | 247 s | 96.2% | 262 s | 99.5% | 280 s |
| 固定 135° | **100%** | 274 s | 100% | 277 s | 99.8% | 274 s |
| 固定 140° | 91.5% | 275 s | 98.5% | 283 s | 99.5% | 284 s |
| 固定 145° | 80.0% | 284 s | 97.2% | 322 s | 99.5% | 313 s |
| 固定 150° | 86.0% | 321 s | 94.0% | 331 s | 99.2% | 324 s |
| 固定 160° | 66.8% | 302 s | - | - | - | - |
| 邊線135/底線網前120 | 100% | 258 s | 99.8% | 257 s | 100% | 259 s |
| 邊線120/底線網前135 | 100% | 276 s | 99.2% | 264 s | 100% | 266 s |
| 邊線135/底線網前150 | 99.2% | 282 s | 99.5% | 300 s | 100% | 307 s |
| 邊線150/底線網前135 | 99.8% | 299 s | 99.8% | 289 s | 99.5% | 303 s |
| 法線 ±30° | 98.5% | 264 s | 98.8% | 275 s | 99.5% | 276 s |
| 法線 ±45° | 74.8% | 245 s | 87.0% | 259 s | 98.8% | 267 s |
| 法線 ±60° | 76.2% | 241 s | 87.0% | 250 s | 97.8% | 258 s |
| 法線 + 隨機 ±60° | 98.2% | 321 s | 99.2% | 307 s | 99.2% | 323 s |
| 法線 + 隨機 ±80° | 99.8% | 310 s | 99.5% | 319 s | 99.5% | 307 s |

只放 3 顆球（σ=0°）時：

| 規則 | 撿完率 |
|---|---|
| 110° | 97.8% |
| 120° | 91.2% |
| 130° | 88.0% |
| 135° | 100% |
| 140° | 96.5% |
| 160° | 72.8% |

## 結論

- **135° 在 σ=0° 時剛好 100%，是巧合。** 半場幾乎是正方形（10.9 × 10.97 m），轉 135° 剛好走 45° 對角線。只要偏個 ±5°，130° 掉到 86%、140° 掉到 91.5%，所以 135° 本身很脆弱。
- **真實車一定有轉向誤差，誤差反而救了其他角度。** 誤差把固定繞圈打散：
  - σ=3° 時，110~140° 撿完率都在 95~100%，中位數 251~283 s，差異不大。
  - σ=8° 時，110~150° 全部約 99.5%。
  - 145° 以上明顯變慢（中位數 313~331 s）。
- **長邊、短邊用不同角度：效果小。** 半場沒有真正的長短邊。最好的組合是「邊線 135° ／ 底線網前 120°」，中位數只快約 6%（257 s vs 274 s）。
- **以法線為基準加隨機角度最穩，但比較慢。** 做法是用顏色知道撞到哪條線，加上陀螺儀的絕對航向，轉到朝場內法線方向再加一個隨機角度。撿完率 99% 以上，但中位數 307~323 s，慢約 15%。
- **文獻沒有給我們情況的具體角度：**
  - Nilles 2017 研究的是相對法線的固定角度，目的是巡邏，不是覆蓋。
  - 掃地機（iRobot 專利、Doty 1993）用隨機角度，目的就是避開週期軌道。
- **建議：** 用 120~135° 其中一個固定角度，再刻意加 ±5~10° 的隨機量，避免繞成週期軌道。
