YourFath3r253/tennisball-picking/experiments/實驗數據/run189/result.txt

reason=出界
touched=6
num_balls=10
wall_sec=98.8
sim_sec=98.7
bounce_count=0
bounce_angle_deg=135.0
