YourFath3r253/tennisball-picking/experiments/實驗數據/run193/result.txt

reason=撿滿
touched=10
num_balls=10
wall_sec=314.3
sim_sec=314.2
bounce_count=0
bounce_angle_deg=135.0
