YourFath3r253/tennisball-picking/experiments/實驗數據/run194/result.txt

reason=撿滿
touched=10
num_balls=10
wall_sec=702.1
sim_sec=701.8
bounce_count=0
bounce_angle_deg=135.0
