YourFath3r253/tennisball-picking/experiments/實驗數據/run196/result.txt

reason=撿滿
touched=10
num_balls=10
wall_sec=211.0
sim_sec=210.9
bounce_count=0
bounce_angle_deg=135.0
