YourFath3r253/tennisball-picking/experiments/實驗數據/run197/result.txt

reason=出界
touched=5
num_balls=10
wall_sec=150.2
sim_sec=150.1
bounce_count=0
bounce_angle_deg=135.0
