YourFath3r253/tennisball-picking/experiments/實驗數據/run198/result.txt

reason=出界
touched=7
num_balls=10
wall_sec=750.8
sim_sec=747.8
bounce_count=0
bounce_angle_deg=135.0
