YourFath3r253/tennisball-picking/experiments/實驗數據/run201/result.txt

reason=出界
touched=3
num_balls=10
wall_sec=294.4
sim_sec=291.8
bounce_count=0
bounce_angle_deg=135.0
