YourFath3r253/tennisball-picking/experiments/實驗數據/run202/result.txt

reason=出界
touched=7
num_balls=10
wall_sec=158.2
sim_sec=158.0
bounce_count=0
bounce_angle_deg=135.0
