YourFath3r253/tennisball-picking/experiments/實驗數據/run206/result.txt

reason=撿滿
touched=10
num_balls=10
wall_sec=230.7
sim_sec=229.6
bounce_count=0
bounce_angle_deg=135.0
