YourFath3r253/tennisball-picking/experiments/實驗數據/run187/result.txt

reason=逾時
touched=0
num_balls=10
wall_sec=903.5
sim_sec=900.1
bounce_count=0
bounce_angle_deg=135.0
