YourFath3r253/tennisball-picking/experiments/實驗數據/run188/result.txt

reason=出界
touched=9
num_balls=10
wall_sec=538.0
sim_sec=536.8
bounce_count=0
bounce_angle_deg=135.0
