YourFath3r253/tennisball-picking/experiments/實驗數據/run174/result.txt

reason=逾時
touched=4
num_balls=10
wall_sec=300.2
sim_sec=300.0
bounce_count=0
bounce_angle_deg=135.0
