YourFath3r253/tennisball-picking/experiments/實驗數據/run162/result.txt

reason=撿滿
touched=10
num_balls=10
wall_sec=398.3
sim_sec=398.1
bounce_count=13
bounce_angle_deg=135.0
