YourFath3r253/tennisball-picking/experiments/實驗數據/run157/result.txt

reason=撿滿
touched=9
num_balls=9
wall_sec=392.1
sim_sec=391.9
