YourFath3r253/tennisball-picking/experiments/實驗數據/run158/result.txt

reason=撿滿
touched=10
num_balls=10
wall_sec=275.1
sim_sec=275.0
bounce_count=6
bounce_angle_deg=135.0
