YourFath3r253/tennisball-picking/experiments/實驗數據/run119/result.txt

reason=撿滿
touched=9
num_balls=9
wall_sec=345.0
sim_sec=344.8
