YourFath3r253/tennisball-picking/experiments/實驗數據/run125/result.txt

reason=撿滿
touched=9
num_balls=9
wall_sec=372.8
sim_sec=372.6
