YourFath3r253/tennisball-picking/experiments/實驗數據/run126/result.txt

reason=撿滿
touched=9
num_balls=9
wall_sec=373.4
sim_sec=373.2
