YourFath3r253/tennisball-picking/experiments/實驗數據/run129/result.txt

reason=撿滿
touched=9
num_balls=9
wall_sec=418.3
sim_sec=418.1
