YourFath3r253/tennisball-picking/experiments/實驗數據/run130/result.txt

reason=撿滿
touched=9
num_balls=9
wall_sec=391.6
sim_sec=391.4
