YourFath3r253/tennisball-picking/experiments/實驗數據/run134/result.txt

reason=撿滿
touched=10
num_balls=10
wall_sec=268.9
sim_sec=268.7
bounce_count=9
bounce_angle_deg=110.0
