YourFath3r253/tennisball-picking/experiments/實驗數據/run135/result.txt

reason=撿滿
touched=10
num_balls=10
wall_sec=232.9
sim_sec=232.8
bounce_count=7
bounce_angle_deg=135.0
