YourFath3r253/tennisball-picking/experiments/實驗數據/run136/result.txt

reason=逾時
touched=7
num_balls=10
wall_sec=900.6
sim_sec=900.0
bounce_count=27
bounce_angle_deg=180.0
