YourFath3r253/tennisball-picking/experiments/實驗數據/run137/result.txt

reason=撿滿
touched=10
num_balls=10
wall_sec=333.3
sim_sec=283.2
bounce_count=11
bounce_angle_deg=90.0
