YourFath3r253/tennisball-picking/experiments/實驗數據/run138/result.txt

reason=撿滿
touched=10
num_balls=10
wall_sec=239.2
sim_sec=237.8
bounce_count=8
bounce_angle_deg=110.0
