YourFath3r253/tennisball-picking/experiments/實驗數據/run141/result.txt

reason=撿滿
touched=10
num_balls=10
wall_sec=296.3
sim_sec=294.3
bounce_count=10
bounce_angle_deg=90.0
