YourFath3r253/tennisball-picking/experiments/實驗數據/run143/result.txt

reason=撿滿
touched=10
num_balls=10
wall_sec=236.7
sim_sec=141.5
bounce_count=3
bounce_angle_deg=135.0
