YourFath3r253/tennisball-picking/experiments/實驗數據/run144/result.txt

reason=撿滿
touched=10
num_balls=10
wall_sec=503.6
sim_sec=453.6
bounce_count=18
bounce_angle_deg=180.0
