YourFath3r253/tennisball-picking/experiments/實驗數據/run145/result.txt

reason=撿滿
touched=10
num_balls=10
wall_sec=226.0
sim_sec=224.7
