YourFath3r253/tennisball-picking/experiments/實驗數據/run146/result.txt

reason=出界
touched=5
num_balls=10
wall_sec=145.6
sim_sec=80.0
