YourFath3r253/tennisball-picking/experiments/實驗數據/run147/result.txt

reason=走完弓字路徑
touched=9
num_balls=10
wall_sec=212.5
sim_sec=211.2
