YourFath3r253/tennisball-picking/experiments/實驗數據/run150/result.txt

reason=撿滿
touched=10
num_balls=10
wall_sec=213.7
sim_sec=212.2
bounce_count=7
bounce_angle_deg=135.0
