YourFath3r253/tennisball-picking/experiments/實驗數據/run152/result.txt

reason=撿滿
touched=10
num_balls=10
wall_sec=279.4
sim_sec=245.2
bounce_count=7
bounce_angle_deg=135.0
