YourFath3r253/tennisball-picking/experiments/實驗數據/run153/result.txt

reason=撿滿
touched=10
num_balls=10
wall_sec=193.6
sim_sec=192.3
bounce_count=5
bounce_angle_deg=110.0
