YourFath3r253/tennisball-picking/experiments/實驗數據/run154/result.txt

reason=撿滿
touched=10
num_balls=10
wall_sec=206.2
sim_sec=204.7
