YourFath3r253/tennisball-picking/experiments/實驗數據/run155/result.txt

reason=撿滿
touched=10
num_balls=10
wall_sec=169.2
sim_sec=168.2
