YourFath3r253/tennisball-picking/experiments/實驗數據/run156/result.txt

reason=撿滿
touched=10
num_balls=10
wall_sec=248.3
sim_sec=246.8
