YourFath3r253/tennisball-picking/experiments/memory_review_2026-08-16.html

# 記憶存檔 — 撿球機專案

2026/08/16 準備壓縮對話前的主動記憶存檔

### 本次新增/更新的記憶

## project 導航/里程計除錯詳細狀態 (8/16)

project_tennisbot_nav_debug_2026-08-16.md

整理今天一整天從「輪距校正」到「模擬凍結」的完整除錯脈絡，包含：

- 已確認並修好：輪距 0.27→0.29m、改用陀螺儀算yaw、撿球判定改滾輪、APPROACH加PID
- 視覺目標鎖定試過的方案（門檻縮小、margin機制、2秒凍結）都沒有真正解決兩顆球互搶目標的問題，最後改成「找不到同一顆就立刻放開」
- _estimate_target_ball() debug猜測功能有已知漏洞：沒有距離過濾，曾經讓我誤判ball_7/ball_9是問題所在（其實距離5公尺，不可能）
- 今天最大發現：0.5秒dt防呆丟棄的根因不是「即時率漂移」，是整個模擬會不定期真的凍結（wall time跟sim time一起卡住），而且卡頓頻率會隨執行時間惡化，懷疑跟長時間執行/密集delete_entity有關，尚未證實
- 目前設定：USE_SIM_TIME_FOR_DT=False（改用模擬時間的版本有自己的bug，比較結果好可能只是運氣，未證實是真正解法）

為什麼重要：下次要改 grid_patrol_node.py 或 vision_node.py 之前，先讀這份，不然會重複踩過的坑。

## feedback 一次只改一個變因

feedback_one_variable_at_a_time.md

「我要你一次做一件事 這樣比較好debug」——多次明確要求改動要拆開測試，不要同時堆疊多個修正。

為什麼：系統互相牽動的部件太多（輪速、陀螺儀、視覺鎖定、PID、物理碰撞、模擬時間），同時改好幾個東西沒辦法歸因是哪個造成的改變——PD阻尼那次「完全沒效果」就是靠拆開測試才發現真正原因是別的。

## feedback 沒實測過就不要當作事實講

feedback_empirical_rigor.md

用戶會直接挑戰沒有數據支撐的推論（「你怎麼測出1.3-1.5公尺的」、「這是模擬耶應該沒有延遲」），而且用戶自己的直覺常常是對的。

為什麼：好幾次我用「聽起來合理」的解釋帶過，被追問之後才發現推論方向錯了（0.5秒延遲那次，真正原因是模擬整個凍結，不是通訊延遲）。以後要先分清楚「這是量出來的」還是「這是我推測的」，講不清楚就老實說沒測過。

## user Sean 背景更新

user_role_tennisbot.md（更新）

補充：Sean 本科是機械系，不是資工/軟體背景——這解釋了一些問題角度（例如對「軟體通訊延遲」這種說法會直覺懷疑，習慣用物理/幾何直覺去想bug，例如配重、PID的阻尼類比）。

也修正了「低投入」的印象——一旦真的深入這個除錯過程，Sean 其實查得非常細（逐行看dt log、自己推算像素對應公尺數、質疑PID參數），「低投入」講的是時間預算，不是要求隨便交差。

### 目前完整記憶索引

類型 | 標題 | 一句話
user | Sean 的角色 | ME背景、非低標準只是時間有限、要求精準有依據
feedback | 討論 vs 動手 | 「討論」= 不改程式；回報問題前先查log再信
project | tennisbot轉向（歷史） | 捨棄Nav2/AMCL/光達，改輪速里程計格點巡邏
project | 導航除錯詳細狀態(8/16) | 今天完整除錯脈絡，見上方
reference | tennisbot GitHub | repo網址，SSH已設定好
feedback | 繁體中文回覆 | 所有對話一律用繁體中文
feedback | 一次一個變因 | 拆開測試，不要同時改好幾個
feedback | 實證嚴謹 | 沒測過的推論要講清楚是推測

這份是本地review用的檔案，沒有發佈成公開連結。
