YourFath3r253/tennisball-picking/experiments/實驗數據/run174/ball_touches.csv

ball_name | elapsed_sec | wp_index_at_touch | cell_number_at_touch | sim_elapsed_sec
ball_6 | 33.61 | 0 | 1 | 33.58
ball_8 | 135.41 | 0 | 1 | 135.33
ball_9 | 161.01 | 0 | 1 | 160.92
ball_1 | 253.51 | 0 | 1 | 253.37
