YourFath3r253/tennisball-picking/experiments/實驗數據/run116/trajectory.csv

t | x | y | yaw | state | wp_index | cell_number | real_x | real_y | real_yaw | target_ball_guess | x_wall | y_wall | yaw_wall
0.20 | -10.533 | -4.260 | -0.000 | PATROL | 1 | 2 | -10.533 | -4.260 | -0.000 |  | -10.533 | -4.260 | -0.000
0.40 | -10.516 | -4.260 | -0.000 | PATROL | 1 | 2 | -10.514 | -4.260 | -0.000 |  | -10.516 | -4.260 | -0.000
0.60 | -10.457 | -4.260 | -0.000 | PATROL | 1 | 2 | -10.455 | -4.260 | -0.000 |  | -10.457 | -4.260 | -0.000
0.80 | -10.378 | -4.260 | 0.011 | PATROL | 1 | 2 | -10.377 | -4.260 | 0.011 |  | -10.378 | -4.260 | 0.011
1.00 | -10.298 | -4.258 | 0.020 | PATROL | 1 | 2 | -10.299 | -4.258 | 0.020 |  | -10.298 | -4.258 | 0.020
1.20 | -10.219 | -4.257 | 0.027 | PATROL | 1 | 2 | -10.221 | -4.257 | 0.027 |  | -10.218 | -4.257 | 0.027
1.40 | -10.138 | -4.254 | 0.033 | PATROL | 1 | 2 | -10.142 | -4.254 | 0.033 |  | -10.138 | -4.254 | 0.033
1.60 | -10.058 | -4.251 | 0.038 | PATROL | 1 | 2 | -10.064 | -4.251 | 0.038 |  | -10.058 | -4.251 | 0.038
1.80 | -9.991 | -4.249 | 0.042 | PATROL | 1 | 2 | -9.985 | -4.248 | 0.042 |  | -9.991 | -4.249 | 0.042
2.00 | -9.910 | -4.245 | 0.046 | PATROL | 1 | 2 | -9.906 | -4.245 | 0.046 |  | -9.910 | -4.245 | 0.046
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
