YourFath3r253/tennisball-picking/experiments/實驗數據/run117/ball_touches.csv

ball_name | elapsed_sec | wp_index_at_touch | cell_number_at_touch | sim_elapsed_sec
ball_3 | 13.80 | 1 | 2 | 13.77
ball_9 | 21.40 | 1 | 2 | 21.35
ball_4 | 63.00 | 4 | 8 | 62.93
ball_10 | 239.10 | 22 | 28 | 238.92
ball_1 | 243.10 | 22 | 28 | 242.93
ball_7 | 259.70 | 22 | 28 | 259.52
ball_2 | 309.00 | 25 | 25 | 308.79
ball_8 | 342.30 | 27 | 22 | 342.07
ball_5 | 359.10 | 27 | 22 | 358.87
