YourFath3r253/tennisball-picking/experiments/實驗數據/run119/ball_touches.csv

ball_name | elapsed_sec | wp_index_at_touch | cell_number_at_touch | sim_elapsed_sec
ball_2 | 49.70 | 5 | 7 | 49.64
ball_9 | 55.81 | 5 | 7 | 55.73
ball_4 | 76.40 | 5 | 7 | 76.33
ball_1 | 144.01 | 11 | 12 | 143.89
ball_3 | 176.00 | 13 | 15 | 175.85
ball_8 | 264.20 | 18 | 29 | 264.01
ball_5 | 283.80 | 19 | 30 | 283.59
ball_10 | 295.90 | 19 | 30 | 295.70
ball_7 | 344.91 | 23 | 27 | 344.66
