YourFath3r253/tennisball-picking/experiments/實驗數據/run119/trajectory.csv

t | x | y | yaw | state | wp_index | cell_number | real_x | real_y | real_yaw | target_ball_guess | x_wall | y_wall | yaw_wall
0.20 | -10.532 | -4.260 | -0.000 | PATROL | 1 | 2 | -10.533 | -4.260 | -0.000 |  | -10.532 | -4.260 | -0.000
0.40 | -10.509 | -4.260 | -0.000 | PATROL | 1 | 2 | -10.512 | -4.260 | -0.000 |  | -10.509 | -4.260 | -0.000
0.60 | -10.458 | -4.260 | 0.000 | PATROL | 1 | 2 | -10.452 | -4.260 | 0.000 |  | -10.458 | -4.260 | 0.000
0.80 | -10.379 | -4.260 | 0.011 | PATROL | 1 | 2 | -10.375 | -4.260 | 0.011 |  | -10.379 | -4.260 | 0.011
1.00 | -10.299 | -4.258 | 0.020 | PATROL | 1 | 2 | -10.297 | -4.258 | 0.020 |  | -10.299 | -4.258 | 0.020
1.20 | -10.219 | -4.257 | 0.027 | PATROL | 1 | 2 | -10.218 | -4.256 | 0.027 |  | -10.219 | -4.257 | 0.027
1.40 | -10.139 | -4.254 | 0.033 | PATROL | 1 | 2 | -10.140 | -4.254 | 0.033 |  | -10.139 | -4.254 | 0.033
1.60 | -10.059 | -4.251 | 0.038 | PATROL | 1 | 2 | -10.061 | -4.251 | 0.038 |  | -10.058 | -4.251 | 0.038
1.80 | -9.978 | -4.248 | 0.042 | PATROL | 1 | 2 | -9.982 | -4.248 | 0.042 |  | -9.978 | -4.248 | 0.042
2.00 | -9.897 | -4.244 | 0.046 | PATROL | 1 | 2 | -9.903 | -4.245 | 0.046 |  | -9.897 | -4.244 | 0.046
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
