YourFath3r253/tennisball-picking/experiments/實驗數據/run120/ball_touches.csv

ball_name | elapsed_sec | wp_index_at_touch | cell_number_at_touch | sim_elapsed_sec
ball_2 | 49.70 | 5 | 7 | 49.64
ball_9 | 55.81 | 5 | 7 | 55.76
ball_4 | 76.40 | 5 | 7 | 76.33
ball_1 | 144.01 | 11 | 12 | 143.92
ball_3 | 176.01 | 13 | 15 | 175.88
ball_5 | 251.21 | 18 | 29 | 251.06
ball_8 | 262.71 | 18 | 29 | 262.55
ball_10 | 289.50 | 19 | 30 | 289.34
ball_7 | 339.30 | 22 | 28 | 339.12
