YourFath3r253/tennisball-picking/experiments/實驗數據/run121/trajectory.csv

t | x | y | yaw | state | wp_index | cell_number | real_x | real_y | real_yaw | target_ball_guess | x_wall | y_wall | yaw_wall | real_roll | real_pitch | gyro_roll | gyro_pitch | imu_gaps
0.20 | -10.533 | -4.260 | 0.000 | PATROL | 1 | 2 | -10.533 | -4.260 | 0.000 |  | -10.533 | -4.260 | 0.000 | 0.00 | 0.00 | -0.00 | 0.00 | 3
0.40 | -10.516 | -4.260 | -0.000 | PATROL | 1 | 2 | -10.512 | -4.260 | -0.000 |  | -10.516 | -4.260 | -0.000 | 0.00 | 0.00 | -0.00 | -0.00 | 3
0.60 | -10.457 | -4.260 | 0.000 | PATROL | 1 | 2 | -10.452 | -4.260 | 0.000 |  | -10.457 | -4.260 | 0.000 | -0.00 | 0.00 | -0.00 | -0.01 | 5
0.80 | -10.378 | -4.260 | 0.011 | PATROL | 1 | 2 | -10.374 | -4.260 | 0.011 |  | -10.378 | -4.260 | 0.011 | -0.00 | 0.00 | -0.00 | -0.01 | 5
1.00 | -10.298 | -4.258 | 0.020 | PATROL | 1 | 2 | -10.296 | -4.258 | 0.020 |  | -10.298 | -4.258 | 0.020 | -0.00 | 0.00 | -0.00 | -0.01 | 5
1.20 | -10.219 | -4.256 | 0.027 | PATROL | 1 | 2 | -10.218 | -4.256 | 0.027 |  | -10.218 | -4.256 | 0.027 | -0.00 | 0.00 | -0.01 | -0.01 | 7
1.40 | -10.138 | -4.254 | 0.033 | PATROL | 1 | 2 | -10.140 | -4.254 | 0.033 |  | -10.138 | -4.254 | 0.033 | -0.00 | 0.00 | -0.00 | -0.01 | 8
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
