YourFath3r253/tennisball-picking/experiments/實驗數據/run122/ball_touches.csv

ball_name | elapsed_sec | wp_index_at_touch | cell_number_at_touch | sim_elapsed_sec
ball_2 | 49.71 | 5 | 7 | 49.64
ball_9 | 55.81 | 5 | 7 | 55.73
ball_4 | 76.41 | 5 | 7 | 76.33
ball_1 | 144.61 | 11 | 12 | 144.50
ball_3 | 177.11 | 13 | 15 | 176.97
ball_5 | 252.31 | 18 | 29 | 252.14
ball_8 | 263.81 | 18 | 29 | 263.64
ball_10 | 290.81 | 19 | 30 | 290.60
ball_7 | 340.21 | 22 | 28 | 340.00
