YourFath3r253/tennisball-picking/experiments/實驗數據/run122/trajectory.csv

t | x | y | yaw | state | wp_index | cell_number | real_x | real_y | real_yaw | target_ball_guess | x_wall | y_wall | yaw_wall | real_roll | real_pitch | gyro_roll | gyro_pitch | imu_gaps
0.21 | -10.532 | -4.260 | -0.000 | PATROL | 1 | 2 | -10.533 | -4.260 | -0.000 |  | -10.532 | -4.260 | -0.000 | -0.00 | 0.00 | -0.00 | 0.00 | 0
0.40 | -10.512 | -4.260 | -0.000 | PATROL | 1 | 2 | -10.514 | -4.260 | -0.000 |  | -10.512 | -4.260 | -0.000 | -0.00 | -0.00 | 0.01 | 0.01 | 1
0.60 | -10.450 | -4.260 | -0.000 | PATROL | 1 | 2 | -10.455 | -4.260 | 0.000 |  | -10.450 | -4.260 | -0.000 | -0.00 | 0.01 | -0.00 | 0.01 | 4
0.80 | -10.371 | -4.260 | 0.011 | PATROL | 1 | 2 | -10.377 | -4.260 | 0.011 |  | -10.371 | -4.260 | 0.011 | -0.00 | 0.00 | -0.00 | -0.00 | 4
1.00 | -10.304 | -4.258 | 0.020 | PATROL | 1 | 2 | -10.299 | -4.258 | 0.020 |  | -10.304 | -4.258 | 0.020 | -0.00 | 0.00 | -0.00 | -0.00 | 4
1.20 | -10.225 | -4.257 | 0.027 | PATROL | 1 | 2 | -10.221 | -4.257 | 0.027 |  | -10.225 | -4.257 | 0.027 | 0.00 | 0.00 | -0.00 | -0.00 | 6
1.40 | -10.144 | -4.254 | 0.033 | PATROL | 1 | 2 | -10.143 | -4.254 | 0.033 |  | -10.144 | -4.254 | 0.033 | 0.00 | 0.00 | -0.00 | -0.00 | 7
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
