YourFath3r253/tennisball-picking/experiments/實驗數據/run125/ball_touches.csv

ball_name | elapsed_sec | wp_index_at_touch | cell_number_at_touch | sim_elapsed_sec
ball_2 | 49.71 | 5 | 7 | 49.64
ball_9 | 55.81 | 5 | 7 | 55.76
ball_4 | 76.41 | 5 | 7 | 76.33
ball_1 | 144.01 | 11 | 12 | 143.89
ball_3 | 176.01 | 13 | 15 | 175.88
ball_5 | 252.01 | 18 | 29 | 251.87
ball_8 | 263.21 | 18 | 29 | 263.06
ball_10 | 288.01 | 19 | 30 | 287.84
ball_7 | 372.71 | 28 | 23 | 372.50
