YourFath3r253/tennisball-picking/experiments/實驗數據/run126/ball_touches.csv

ball_name | elapsed_sec | wp_index_at_touch | cell_number_at_touch | sim_elapsed_sec
ball_2 | 49.71 | 5 | 7 | 49.64
ball_9 | 55.81 | 5 | 7 | 55.73
ball_4 | 76.41 | 5 | 7 | 76.33
ball_1 | 144.01 | 11 | 12 | 143.89
ball_3 | 176.01 | 13 | 15 | 175.88
ball_5 | 251.61 | 18 | 29 | 251.43
ball_8 | 262.81 | 18 | 29 | 262.65
ball_10 | 288.61 | 19 | 30 | 288.42
ball_7 | 373.31 | 28 | 23 | 373.08
