YourFath3r253/tennisball-picking/experiments/實驗數據/run126/trajectory.csv

t | x | y | yaw | state | wp_index | cell_number | real_x | real_y | real_yaw | target_ball_guess | x_wall | y_wall | yaw_wall | real_roll | real_pitch | gyro_roll | gyro_pitch | imu_gaps
0.21 | -10.532 | -4.260 | -0.000 | PATROL | 1 | 2 | -10.533 | -4.260 | -0.000 |  | -10.532 | -4.260 | -0.000 | -0.00 | 0.00 | -0.00 | 0.00 | 2
0.41 | -10.517 | -4.260 | -0.000 | PATROL | 1 | 2 | -10.513 | -4.260 | -0.000 |  | -10.517 | -4.260 | -0.000 | -0.00 | -0.00 | 0.00 | 0.02 | 6
0.61 | -10.459 | -4.260 | -0.000 | PATROL | 1 | 2 | -10.455 | -4.260 | -0.000 |  | -10.459 | -4.260 | -0.000 | -0.00 | -0.00 | -0.01 | -0.03 | 7
0.81 | -10.380 | -4.260 | 0.011 | PATROL | 1 | 2 | -10.377 | -4.260 | 0.011 |  | -10.380 | -4.260 | 0.011 | -0.00 | 0.00 | -0.01 | -0.03 | 12
1.01 | -10.301 | -4.258 | 0.020 | PATROL | 1 | 2 | -10.299 | -4.258 | 0.020 |  | -10.300 | -4.258 | 0.020 | 0.00 | 0.00 | -0.01 | -0.02 | 15
1.21 | -10.221 | -4.257 | 0.027 | PATROL | 1 | 2 | -10.221 | -4.257 | 0.027 |  | -10.221 | -4.257 | 0.027 | -0.00 | -0.00 | -0.01 | -0.03 | 16
1.41 | -10.141 | -4.254 | 0.033 | PATROL | 1 | 2 | -10.142 | -4.254 | 0.033 |  | -10.140 | -4.254 | 0.033 | -0.00 | 0.00 | -0.01 | -0.03 | 19
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
