YourFath3r253/tennisball-picking/experiments/實驗數據/run127/ball_touches.csv

ball_name | elapsed_sec | wp_index_at_touch | cell_number_at_touch | sim_elapsed_sec
ball_2 | 49.71 | 5 | 7 | 49.64
ball_9 | 55.81 | 5 | 7 | 55.73
ball_4 | 76.41 | 5 | 7 | 76.33
ball_1 | 144.01 | 11 | 12 | 143.89
ball_3 | 176.51 | 13 | 15 | 176.39
ball_5 | 252.51 | 18 | 29 | 252.35
ball_8 | 264.01 | 18 | 29 | 263.84
ball_10 | 290.01 | 19 | 30 | 289.82
ball_7 | 343.01 | 23 | 27 | 342.79
