YourFath3r253/tennisball-picking/experiments/實驗數據/run127/trajectory.csv

t | x | y | yaw | state | wp_index | cell_number | real_x | real_y | real_yaw | target_ball_guess | x_wall | y_wall | yaw_wall | real_roll | real_pitch | gyro_roll | gyro_pitch | imu_gaps
0.21 | -10.532 | -4.260 | -0.000 | PATROL | 1 | 2 | -10.533 | -4.260 | -0.000 |  | -10.532 | -4.260 | -0.000 | -0.00 | 0.00 | -0.01 | -0.00 | 5
0.41 | -10.511 | -4.260 | -0.000 | PATROL | 1 | 2 | -10.514 | -4.260 | -0.000 |  | -10.511 | -4.260 | -0.000 | -0.00 | 0.00 | -0.03 | -0.08 | 9
0.61 | -10.461 | -4.260 | -0.000 | PATROL | 1 | 2 | -10.455 | -4.260 | -0.000 |  | -10.461 | -4.260 | -0.000 | -0.00 | 0.00 | -0.06 | -0.07 | 10
0.81 | -10.382 | -4.260 | 0.011 | PATROL | 1 | 2 | -10.378 | -4.260 | 0.010 |  | -10.382 | -4.260 | 0.011 | -0.00 | -0.00 | -0.06 | -0.09 | 12
1.01 | -10.302 | -4.259 | 0.019 | PATROL | 1 | 2 | -10.300 | -4.258 | 0.019 |  | -10.302 | -4.259 | 0.019 | -0.00 | -0.00 | -0.06 | -0.08 | 15
1.21 | -10.222 | -4.257 | 0.026 | PATROL | 1 | 2 | -10.221 | -4.257 | 0.027 |  | -10.222 | -4.257 | 0.027 | 0.00 | 0.01 | -0.06 | -0.08 | 18
1.41 | -10.142 | -4.254 | 0.032 | PATROL | 1 | 2 | -10.143 | -4.254 | 0.033 |  | -10.142 | -4.254 | 0.032 | -0.00 | 0.00 | -0.06 | -0.08 | 22
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
