YourFath3r253/tennisball-picking/experiments/實驗數據/run128/ball_touches.csv

ball_name | elapsed_sec | wp_index_at_touch | cell_number_at_touch | sim_elapsed_sec
ball_4 | 53.51 | 6 | 6 | 53.45
ball_9 | 99.41 | 9 | 10 | 99.31
ball_3 | 106.71 | 9 | 10 | 106.62
ball_2 | 124.01 | 9 | 10 | 123.90
ball_1 | 154.91 | 11 | 12 | 154.80
ball_8 | 248.31 | 18 | 29 | 248.17
ball_5 | 261.31 | 18 | 29 | 261.15
ball_10 | 284.61 | 19 | 30 | 284.44
ball_7 | 368.71 | 28 | 23 | 368.49
