YourFath3r253/tennisball-picking/experiments/實驗數據/run129/ball_touches.csv

ball_name | elapsed_sec | wp_index_at_touch | cell_number_at_touch | sim_elapsed_sec
ball_3 | 13.81 | 1 | 2 | 13.77
ball_9 | 39.01 | 1 | 2 | 38.96
ball_4 | 82.71 | 4 | 8 | 82.62
ball_1 | 266.71 | 22 | 28 | 266.53
ball_10 | 273.61 | 22 | 28 | 273.43
ball_2 | 312.01 | 25 | 25 | 311.81
ball_5 | 348.31 | 27 | 22 | 348.09
ball_7 | 387.51 | 30 | 20 | 387.29
ball_8 | 418.21 | 32 | 18 | 417.96
