YourFath3r253/tennisball-picking/experiments/實驗數據/run129/trajectory.csv

t | x | y | yaw | state | wp_index | cell_number | real_x | real_y | real_yaw | target_ball_guess | x_wall | y_wall | yaw_wall | real_roll | real_pitch | gyro_roll | gyro_pitch | imu_gaps
0.21 | -10.532 | -4.260 | 0.000 | PATROL | 1 | 2 | -10.533 | -4.260 | -0.000 |  | -10.532 | -4.260 | 0.000 | -0.00 | -0.00 | -0.00 | 0.00 | 3
0.41 | -10.511 | -4.260 | -0.000 | PATROL | 1 | 2 | -10.513 | -4.260 | -0.000 |  | -10.511 | -4.260 | -0.000 | 0.00 | 0.00 | -0.03 | -0.05 | 7
0.61 | -10.448 | -4.260 | 0.000 | PATROL | 1 | 2 | -10.453 | -4.260 | -0.000 |  | -10.448 | -4.260 | 0.000 | -0.00 | 0.00 | -0.05 | -0.10 | 8
0.81 | -10.369 | -4.260 | 0.011 | PATROL | 1 | 2 | -10.376 | -4.260 | 0.011 |  | -10.369 | -4.260 | 0.011 | -0.00 | -0.00 | -0.05 | -0.10 | 9
1.01 | -10.303 | -4.258 | 0.020 | PATROL | 1 | 2 | -10.298 | -4.258 | 0.020 |  | -10.303 | -4.258 | 0.020 | -0.00 | 0.00 | -0.04 | -0.08 | 12
1.21 | -10.223 | -4.257 | 0.027 | PATROL | 1 | 2 | -10.220 | -4.257 | 0.027 |  | -10.223 | -4.257 | 0.027 | -0.00 | 0.00 | -0.03 | -0.09 | 12
1.41 | -10.143 | -4.254 | 0.033 | PATROL | 1 | 2 | -10.141 | -4.254 | 0.033 |  | -10.143 | -4.254 | 0.033 | -0.00 | 0.00 | -0.03 | -0.09 | 13
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
