YourFath3r253/tennisball-picking/experiments/實驗數據/run130/trajectory.csv

t | x | y | yaw | state | wp_index | cell_number | real_x | real_y | real_yaw | target_ball_guess | x_wall | y_wall | yaw_wall | real_roll | real_pitch | gyro_roll | gyro_pitch | imu_gaps
0.21 | -10.533 | -4.260 | 0.000 | PATROL | 1 | 2 | -10.533 | -4.260 | -0.000 |  | -10.533 | -4.260 | 0.000 | -0.00 | 0.00 | 0.00 | 0.00 | 3
0.41 | -10.511 | -4.260 | -0.000 | PATROL | 1 | 2 | -10.513 | -4.260 | -0.000 |  | -10.511 | -4.260 | -0.000 | -0.00 | 0.00 | -0.01 | -0.03 | 4
0.61 | -10.449 | -4.260 | -0.000 | PATROL | 1 | 2 | -10.453 | -4.260 | -0.000 |  | -10.449 | -4.260 | -0.000 | -0.00 | 0.00 | -0.02 | -0.11 | 7
0.81 | -10.370 | -4.260 | 0.011 | PATROL | 1 | 2 | -10.375 | -4.260 | 0.011 |  | -10.370 | -4.260 | 0.011 | -0.00 | 0.00 | -0.01 | -0.11 | 10
1.01 | -10.304 | -4.259 | 0.019 | PATROL | 1 | 2 | -10.297 | -4.258 | 0.020 |  | -10.304 | -4.259 | 0.019 | 0.00 | 0.00 | -0.01 | -0.12 | 15
1.21 | -10.224 | -4.257 | 0.027 | PATROL | 1 | 2 | -10.219 | -4.257 | 0.027 |  | -10.224 | -4.257 | 0.027 | 0.00 | 0.00 | -0.02 | -0.11 | 17
1.41 | -10.144 | -4.254 | 0.033 | PATROL | 1 | 2 | -10.140 | -4.254 | 0.033 |  | -10.144 | -4.254 | 0.033 | -0.00 | -0.00 | -0.02 | -0.12 | 17
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
