YourFath3r253/tennisball-picking/experiments/實驗數據/run131/ball_touches.csv

ball_name | elapsed_sec | wp_index_at_touch | cell_number_at_touch | sim_elapsed_sec
ball_4 | 54.41 | 6 | 6 | 54.33
ball_9 | 101.11 | 9 | 10 | 101.01
ball_3 | 108.41 | 9 | 10 | 108.32
ball_2 | 128.71 | 9 | 10 | 128.59
ball_1 | 159.61 | 11 | 12 | 159.49
ball_5 | 252.01 | 18 | 29 | 251.84
ball_8 | 263.21 | 18 | 29 | 263.06
ball_10 | 291.21 | 20 | 31 | 291.04
ball_7 | 359.71 | 28 | 23 | 359.52
