YourFath3r253/tennisball-picking/experiments/實驗數據/run145/ball_touches.csv

ball_name | elapsed_sec | wp_index_at_touch | cell_number_at_touch | sim_elapsed_sec
ball_6 | 12.65 | 1 | 2 | 12.55
ball_7 | 27.95 | 1 | 2 | 27.78
ball_5 | 39.05 | 1 | 2 | 38.83
ball_1 | 56.15 | 1 | 2 | 55.83
ball_8 | 61.25 | 1 | 2 | 60.89
ball_2 | 69.45 | 1 | 2 | 69.05
ball_3 | 88.25 | 1 | 2 | 87.75
ball_4 | 131.15 | 5 | 7 | 130.39
ball_10 | 140.85 | 5 | 7 | 140.05
ball_9 | 225.85 | 13 | 15 | 224.60
