YourFath3r253/tennisball-picking/experiments/實驗數據/run145/trajectory.csv

t | x | y | yaw | state | wp_index | cell_number | real_x | real_y | real_yaw | target_ball_guess | x_wall | y_wall | yaw_wall
0.25 | -10.532 | -4.260 | 0.000 | PATROL | 1 | 2 | -10.533 | -4.260 | 0.000 |  | -10.532 | -4.260 | 0.000
0.45 | -10.515 | -4.260 | -0.000 | PATROL | 1 | 2 | -10.513 | -4.260 | -0.000 |  | -10.515 | -4.260 | -0.000
0.65 | -10.456 | -4.260 | 0.000 | PATROL | 1 | 2 | -10.454 | -4.260 | 0.000 |  | -10.456 | -4.260 | 0.000
0.85 | -10.377 | -4.260 | 0.011 | PATROL | 1 | 2 | -10.376 | -4.260 | 0.011 |  | -10.377 | -4.260 | 0.011
1.05 | -10.298 | -4.258 | 0.020 | PATROL | 1 | 2 | -10.299 | -4.258 | 0.020 |  | -10.297 | -4.258 | 0.020
1.25 | -10.218 | -4.256 | 0.027 | PATROL | 1 | 2 | -10.221 | -4.257 | 0.027 |  | -10.216 | -4.256 | 0.027
1.45 | -10.138 | -4.254 | 0.033 | ALIGN | 1 | 2 | -10.143 | -4.254 | 0.033 | ball_6 | -10.136 | -4.254 | 0.033
1.65 | -10.090 | -4.252 | 0.041 | ALIGN | 1 | 2 | -10.087 | -4.252 | 0.041 | ball_6 | -10.088 | -4.252 | 0.041
1.85 | -10.070 | -4.251 | 0.043 | ALIGN | 1 | 2 | -10.068 | -4.251 | 0.043 | ball_6 | -10.068 | -4.251 | 0.043
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
