YourFath3r253/tennisball-picking/experiments/實驗數據/run146/ball_touches.csv

ball_name | elapsed_sec | wp_index_at_touch | cell_number_at_touch | sim_elapsed_sec
ball_6 | 12.76 | 1 | 2 | 12.58
ball_3 | 22.36 | 1 | 2 | 22.13
ball_10 | 38.86 | 1 | 2 | 38.52
ball_4 | 48.86 | 1 | 2 | 48.45
ball_9 | 76.16 | 1 | 2 | 75.58
