YourFath3r253/tennisball-picking/experiments/實驗數據/run146/trajectory.csv

t | x | y | yaw | state | wp_index | cell_number | real_x | real_y | real_yaw | target_ball_guess | x_wall | y_wall | yaw_wall
0.36 | -10.532 | -4.260 | -0.000 | PATROL | 1 | 2 | -10.533 | -4.260 | -0.000 |  | -10.532 | -4.260 | -0.000
0.56 | -10.515 | -4.260 | 0.000 | PATROL | 1 | 2 | -10.513 | -4.260 | 0.000 |  | -10.515 | -4.260 | -0.000
0.76 | -10.455 | -4.260 | 0.000 | PATROL | 1 | 2 | -10.454 | -4.260 | 0.000 |  | -10.455 | -4.260 | 0.000
0.96 | -10.376 | -4.260 | 0.011 | PATROL | 1 | 2 | -10.376 | -4.260 | 0.011 |  | -10.376 | -4.260 | 0.011
1.16 | -10.297 | -4.258 | 0.020 | PATROL | 1 | 2 | -10.299 | -4.258 | 0.020 |  | -10.296 | -4.258 | 0.020
1.36 | -10.217 | -4.256 | 0.027 | PATROL | 1 | 2 | -10.221 | -4.256 | 0.027 |  | -10.216 | -4.256 | 0.027
1.56 | -10.137 | -4.254 | 0.033 | PATROL | 1 | 2 | -10.143 | -4.254 | 0.033 |  | -10.134 | -4.254 | 0.033
1.76 | -10.070 | -4.252 | 0.038 | APPROACH | 1 | 2 | -10.065 | -4.251 | 0.038 | ball_6 | -10.067 | -4.251 | 0.038
1.96 | -10.003 | -4.249 | 0.054 | APPROACH | 1 | 2 | -10.001 | -4.248 | 0.055 | ball_6 | -10.000 | -4.248 | 0.055
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
