YourFath3r253/tennisball-picking/experiments/實驗數據/run147/ball_touches.csv

ball_name | elapsed_sec | wp_index_at_touch | cell_number_at_touch | sim_elapsed_sec
ball_2 | 25.25 | 2 | 3 | 25.06
ball_7 | 49.05 | 2 | 3 | 48.72
ball_10 | 59.65 | 2 | 3 | 59.26
ball_9 | 66.55 | 2 | 3 | 66.10
ball_4 | 69.75 | 2 | 3 | 69.29
ball_6 | 78.85 | 2 | 3 | 78.34
ball_3 | 93.85 | 2 | 3 | 93.26
ball_8 | 96.95 | 2 | 3 | 96.32
ball_1 | 150.35 | 7 | 5 | 149.40
