YourFath3r253/tennisball-picking/experiments/實驗數據/run147/trajectory.csv

t | x | y | yaw | state | wp_index | cell_number | real_x | real_y | real_yaw | target_ball_guess | x_wall | y_wall | yaw_wall
0.25 | -10.532 | -4.260 | -0.000 | PATROL | 1 | 2 | -10.533 | -4.260 | -0.000 |  | -10.532 | -4.260 | -0.000
0.45 | -10.515 | -4.260 | -0.000 | PATROL | 1 | 2 | -10.513 | -4.260 | -0.000 |  | -10.515 | -4.260 | -0.000
0.65 | -10.456 | -4.260 | 0.000 | PATROL | 1 | 2 | -10.454 | -4.260 | 0.000 |  | -10.456 | -4.260 | 0.000
0.85 | -10.377 | -4.260 | 0.011 | PATROL | 1 | 2 | -10.377 | -4.260 | 0.011 |  | -10.377 | -4.260 | 0.011
1.05 | -10.298 | -4.258 | 0.020 | PATROL | 1 | 2 | -10.300 | -4.258 | 0.020 |  | -10.297 | -4.258 | 0.020
1.25 | -10.218 | -4.256 | 0.027 | PATROL | 1 | 2 | -10.222 | -4.257 | 0.027 |  | -10.216 | -4.256 | 0.027
1.45 | -10.138 | -4.254 | 0.033 | PATROL | 1 | 2 | -10.144 | -4.254 | 0.033 |  | -10.136 | -4.254 | 0.033
1.65 | -10.071 | -4.252 | 0.038 | PATROL | 1 | 2 | -10.065 | -4.251 | 0.038 |  | -10.068 | -4.252 | 0.038
1.85 | -9.990 | -4.248 | 0.042 | PATROL | 1 | 2 | -9.987 | -4.248 | 0.042 |  | -9.987 | -4.248 | 0.042
2.05 | -9.909 | -4.245 | 0.045 | PATROL | 1 | 2 | -9.908 | -4.245 | 0.045 |  | -9.906 | -4.245 | 0.046
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
