YourFath3r253/tennisball-picking/experiments/實驗數據/run154/trajectory.csv

t | x | y | yaw | state | wp_index | cell_number | real_x | real_y | real_yaw | target_ball_guess | x_wall | y_wall | yaw_wall | real_roll | real_pitch | gyro_roll | gyro_pitch | imu_gaps
0.32 | -10.532 | -4.260 | -0.000 | ALIGN | 0 | 1 | -10.533 | -4.260 | -0.000 |  | -10.532 | -4.260 | -0.000 | -0.00 | 0.00 | -0.00 | 0.01 | 2
0.43 | -10.532 | -4.260 | -0.031 | ALIGN | 0 | 1 | -10.533 | -4.260 | -0.031 | ball_1 | -10.532 | -4.260 | -0.031 | -0.00 | 0.00 | 0.01 | 0.01 | 4
0.63 | -10.533 | -4.260 | -0.141 | ALIGN | 0 | 1 | -10.534 | -4.260 | -0.142 |  | -10.533 | -4.260 | -0.143 | -0.00 | 0.00 | 0.01 | 0.00 | 13
0.83 | -10.533 | -4.260 | -0.252 | PATROL | 1 | 2 | -10.535 | -4.260 | -0.253 |  | -10.533 | -4.260 | -0.254 | -0.00 | 0.00 | 0.01 | 0.00 | 15
1.03 | -10.529 | -4.261 | -0.361 | PATROL | 1 | 2 | -10.531 | -4.261 | -0.362 |  | -10.529 | -4.261 | -0.364 | -0.00 | -0.00 | -0.00 | -0.02 | 19
1.23 | -10.500 | -4.274 | -0.429 | PATROL | 1 | 2 | -10.502 | -4.274 | -0.429 |  | -10.499 | -4.274 | -0.431 | -0.00 | 0.00 | -0.01 | -0.02 | 21
1.43 | -10.452 | -4.294 | -0.361 | PATROL | 1 | 2 | -10.456 | -4.294 | -0.360 |  | -10.452 | -4.295 | -0.363 | -0.00 | 0.00 | -0.01 | -0.01 | 26
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
