YourFath3r253/tennisball-picking/experiments/實驗數據/run155/ball_touches.csv

ball_name | elapsed_sec | wp_index_at_touch | cell_number_at_touch | sim_elapsed_sec
ball_6 | 12.72 | 1 | 2 | 12.58
ball_1 | 19.42 | 1 | 2 | 19.24
ball_9 | 25.62 | 1 | 2 | 25.40
ball_3 | 35.62 | 1 | 2 | 35.36
ball_10 | 81.62 | 5 | 7 | 81.06
ball_4 | 92.22 | 5 | 7 | 91.60
ball_8 | 128.82 | 7 | 5 | 127.98
ball_5 | 143.02 | 8 | 9 | 142.09
ball_2 | 158.72 | 9 | 10 | 157.73
ball_7 | 169.12 | 9 | 10 | 168.06
