YourFath3r253/tennisball-picking/experiments/實驗數據/run155/trajectory.csv

t | x | y | yaw | state | wp_index | cell_number | real_x | real_y | real_yaw | target_ball_guess | x_wall | y_wall | yaw_wall | real_roll | real_pitch | gyro_roll | gyro_pitch | imu_gaps
0.32 | -10.532 | -4.260 | -0.000 | PATROL | 1 | 2 | -10.533 | -4.260 | 0.000 |  | -10.532 | -4.260 | -0.000 | 0.00 | 0.00 | -0.00 | -0.00 | 3
0.52 | -10.515 | -4.260 | -0.000 | PATROL | 1 | 2 | -10.514 | -4.260 | -0.000 |  | -10.515 | -4.260 | -0.000 | -0.00 | 0.00 | 0.01 | -0.06 | 10
0.72 | -10.457 | -4.260 | -0.000 | PATROL | 1 | 2 | -10.456 | -4.260 | -0.000 |  | -10.457 | -4.260 | -0.000 | -0.00 | 0.00 | 0.00 | -0.08 | 15
0.92 | -10.378 | -4.260 | 0.010 | PATROL | 1 | 2 | -10.378 | -4.260 | 0.011 |  | -10.377 | -4.260 | 0.011 | 0.00 | 0.00 | 0.00 | -0.08 | 19
1.12 | -10.299 | -4.258 | 0.019 | PATROL | 1 | 2 | -10.301 | -4.258 | 0.020 |  | -10.297 | -4.258 | 0.020 | -0.00 | -0.00 | 0.00 | -0.08 | 24
1.32 | -10.219 | -4.257 | 0.027 | PATROL | 1 | 2 | -10.223 | -4.257 | 0.027 |  | -10.217 | -4.256 | 0.027 | -0.00 | 0.00 | 0.00 | -0.07 | 26
1.52 | -10.152 | -4.255 | 0.033 | PATROL | 1 | 2 | -10.145 | -4.254 | 0.033 |  | -10.149 | -4.254 | 0.033 | -0.00 | 0.00 | -0.00 | -0.07 | 29
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
