YourFath3r253/tennisball-picking/experiments/實驗數據/run156/ball_touches.csv

ball_name | elapsed_sec | wp_index_at_touch | cell_number_at_touch | sim_elapsed_sec
ball_2 | 27.26 | 3 | 4 | 27.03
ball_8 | 53.86 | 4 | 8 | 53.48
ball_10 | 65.96 | 4 | 8 | 65.52
ball_1 | 81.36 | 4 | 8 | 80.82
ball_7 | 101.56 | 4 | 8 | 100.91
ball_4 | 162.76 | 9 | 10 | 161.77
ball_6 | 173.26 | 9 | 10 | 172.21
ball_3 | 188.66 | 9 | 10 | 187.51
ball_5 | 203.46 | 9 | 10 | 202.23
ball_9 | 248.16 | 13 | 15 | 246.70
