YourFath3r253/tennisball-picking/experiments/實驗數據/run156/trajectory.csv

t | x | y | yaw | state | wp_index | cell_number | real_x | real_y | real_yaw | target_ball_guess | x_wall | y_wall | yaw_wall | real_roll | real_pitch | gyro_roll | gyro_pitch | imu_gaps
0.26 | -10.533 | -4.260 | -0.000 | ALIGN | 1 | 2 | -10.533 | -4.260 | -0.000 | ball_1 | -10.533 | -4.260 | -0.000 | 0.00 | 0.00 | -0.00 | 0.00 | 12
0.46 | -10.533 | -4.260 | 0.089 | ALIGN | 1 | 2 | -10.532 | -4.260 | 0.090 | ball_3 | -10.533 | -4.260 | 0.089 | -0.00 | 0.59 | -0.02 | 0.58 | 20
0.66 | -10.533 | -4.260 | 0.198 | ALIGN | 1 | 2 | -10.531 | -4.260 | 0.198 | ball_3 | -10.533 | -4.260 | 0.198 | -0.00 | 0.08 | -0.02 | 0.06 | 34
0.86 | -10.533 | -4.260 | 0.309 | ALIGN | 1 | 2 | -10.530 | -4.260 | 0.309 | ball_3 | -10.533 | -4.260 | 0.310 | 0.00 | 0.00 | -0.02 | -0.01 | 52
1.06 | -10.533 | -4.260 | 0.420 | PATROL | 1 | 2 | -10.529 | -4.259 | 0.420 |  | -10.533 | -4.260 | 0.422 | -0.00 | 0.00 | -0.02 | -0.01 | 66
1.26 | -10.517 | -4.252 | 0.522 | PATROL | 1 | 2 | -10.512 | -4.250 | 0.522 |  | -10.517 | -4.252 | 0.524 | -0.00 | 0.00 | -0.00 | -0.04 | 71
1.46 | -10.481 | -4.230 | 0.511 | PATROL | 1 | 2 | -10.476 | -4.229 | 0.510 |  | -10.480 | -4.230 | 0.512 | 0.00 | 0.00 | -0.02 | -0.02 | 78
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
