YourFath3r253/tennisball-picking/experiments/實驗數據/camera_tilt_20261026/corner/corner_summary.csv

tag | tilt | corner | d_side | angle | seed | result | n_edge | edges | real_turns | front_out | body_out
tilt12_L0.6_ang90_s1 | 12.0 | L | 0.6 | 90 | 1 | OK | 1 | 0.8s RIGHT -> +240 | 111 | -0.47665578970923317 | -0.07501669906648001
tilt12_L0.6_ang60_s1 | 12.0 | L | 0.6 | 60 | 1 | CROSSED | 1 | 3.8s LEFT -> -240 | -112 | 0.8042019897482762 | 0.8127936627233323
tilt12_L0.6_ang45_s1 | 12.0 | L | 0.6 | 45 | 1 | OK | 2 | 3.8s LEFT -> -240 | 9.3s LEFT -> -240 | -111 -114 | -0.32755703588518514 | -0.07931614673099219
tilt12_L1.2_ang90_s1 | 12.0 | L | 1.2 | 90 | 1 | OK | 2 | 4.0s CENTER -> -360 | 14.0s LEFT -> -240 | -166 | -0.3841649403664178 | -0.13653832177853253
tilt12_L1.2_ang60_s1 | 12.0 | L | 1.2 | 60 | 1 | OK | 2 | 3.8s LEFT -> -240 | 9.8s LEFT -> -240 | -111 -111 | -0.43511200462890187 | -0.23729901372355222
tilt12_L1.2_ang45_s1 | 12.0 | L | 1.2 | 45 | 1 | OK | 2 | 3.1s LEFT -> -240 | 12.6s LEFT -> -240 | -111 | -0.6112066142960195 | -0.3624742738508058
tilt12_L2_ang90_s1 | 12.0 | L | 2.0 | 90 | 1 | OK | 1 | 4.0s RIGHT -> +240 | 111 | -0.39306693435358575 | -0.3171123087947816
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
