YourFath3r253/tennisball-picking/experiments/實驗數據/camera_tilt_20261026/corner_v1_flawed/corner_summary.csv

tag | tilt | corner | d_side | angle | seed | result | n_edge | edges | real_turns | front_out | body_out
tilt15_L0.6_ang90_s1 | 15.0 | L | 0.6 | 90 | 1 | OK | 1 | 4.6s RIGHT -> +240 | 111 | -0.18913895898907462 | -0.0743595725061228
tilt15_L0.6_ang90_s2 | 15.0 | L | 0.6 | 90 | 2 | OK | 1 | 4.7s RIGHT -> +240 | 112 | -0.15955158978403539 | -0.07390479214612267
tilt15_L0.6_ang45_s1 | 15.0 | L | 0.6 | 45 | 1 | OK | 2 | 3.7s LEFT -> -240 | 10.7s LEFT -> -240 | -111 | -0.4732639991167451 | -0.17565607717463116
tilt15_L0.6_ang45_s2 | 15.0 | L | 0.6 | 45 | 2 | OK | 2 | 3.9s LEFT -> -240 | 10.1s LEFT -> -240 | -111 | -0.373361408834036 | -0.1272301930658486
tilt15_L1.2_ang90_s1 | 15.0 | L | 1.2 | 90 | 1 | OK | 1 | 4.6s RIGHT -> +240 | 111 | -0.17648880248978038 | -0.10121896990670898
tilt15_L1.2_ang90_s2 | 15.0 | L | 1.2 | 90 | 2 | OK | 1 | 4.6s RIGHT -> +240 | 111 | -0.17639614285244143 | -0.10138675511107209
tilt15_L1.2_ang45_s1 | 15.0 | L | 1.2 | 45 | 1 | OK | 2 | 3.8s LEFT -> -240 | 12.7s LEFT -> -240 | -111 | -0.42651738366369507 | -0.17977537884098105
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
