YourFath3r253/tennisball-picking/experiments/實驗數據/camera_tilt_20261026/edge/summary.csv

tag | tilt | angle | seed | result | edge_detail | margin_at_edge | margin_at_stop | front_min_margin | turn_min_margin | t_edge
tilt9_ang+90_s1 | 9.0 | 90 | 1 | STOP_BEFORE | RIGHT -> +240 | 0.428582048733517 | 0.3860376088050217 | 0.3735209880626187 | 0.2844819205178002 | 5.900000000000006
tilt9_ang+90_s2 | 9.0 | 90 | 2 | STOP_BEFORE | RIGHT -> +240 | 0.5999864249422702 | 0.5575503689745733 | 0.5453802846267992 | 0.4623253403310883 | 5.700000000000003
tilt9_ang+60_s1 | 9.0 | 60 | 1 | STOP_BEFORE | RIGHT -> +240 | 0.42545814397738946 | 0.38867328957115554 | 0.3781051987045294 | 0.18958046568693843 | 5.599999999999994
tilt9_ang+60_s2 | 9.0 | 60 | 2 | STOP_BEFORE | RIGHT -> +240 | 0.5729365693735649 | 0.5361873664389782 | 0.5255388317162137 | 0.33656643909471473 | 5.400000000000006
tilt9_ang-60_s1 | 9.0 | -60 | 1 | STOP_BEFORE | RIGHT -> +240 | 0.4521420832857721 | 0.41560652558995503 | 0.40637835221385665 | 0.40637835221385665 | 5.6000000000000085
tilt9_ang-60_s2 | 9.0 | -60 | 2 | STOP_BEFORE | LEFT -> -240 | 0.5710996287202841 | 0.5392190976513824 | 0.5281475353569314 | 0.3398322792447961 | 5.5
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
