YourFath3r253/tennisball-picking/experiments/實驗數據/camera_tilt_20261026/view_tilt12/grid.csv

tilt | ground_d | bearing | slant_cm | detected | conf | est_dist_cm | est_bearing_deg | box_cy_px | n_dets
12.0 | 0.1 | -30 | 21.4 | 0 |  |  |  |  | 0
12.0 | 0.12 | -30 | 22.4 | 0 |  |  |  |  | 0
12.0 | 0.14 | -30 | 23.5 | 0 |  |  |  |  | 0
12.0 | 0.16 | -30 | 24.8 | 0 |  |  |  |  | 0
12.0 | 0.18 | -30 | 26.1 | 0 |  |  |  |  | 0
12.0 | 0.2 | -30 | 27.5 | 0 |  |  |  |  | 0
12.0 | 0.22 | -30 | 29.0 | 1 | 0.744 | 60.8 | -19.3 | 372.0 | 1
12.0 | 0.25 | -30 | 31.3 | 1 | 0.931 | 41.0 | -20.5 | 360.3 | 1
12.0 | 0.28 | -30 | 33.8 | 1 | 0.946 | 35.6 | -21.1 | 350.2 | 1
12.0 | 0.32 | -30 | 37.2 | 1 | 0.925 | 33.3 | -21.7 | 339.0 | 1
12.0 | 0.36 | -30 | 40.7 | 1 | 0.935 | 37.1 | -22.3 | 315.8 | 1
12.0 | 0.4 | -30 | 44.2 | 1 | 0.941 | 41.4 | -22.7 | 297.6 | 1
12.0 | 0.5 | -30 | 53.5 | 1 | 0.906 | 50.2 | -23.5 | 262.5 | 1
12.0 | 0.6 | -30 | 62.9 | 1 | 0.957 | 61.0 | -24.1 | 238.8 | 1
12.0 | 0.8 | -30 | 82.2 | 1 | 0.921 | 78.7 | -24.8 | 207.9 | 1
12.0 | 1.0 | -30 | 101.8 | 1 | 0.922 | 95.1 | -25.2 | 188.6 | 1
12.0 | 1.25 | -30 | 126.4 | 1 | 0.918 | 117.3 | -25.6 | 173.3 | 1
12.0 | 1.5 | -30 | 151.2 | 1 | 0.939 | 139.1 | -25.8 | 162.6 | 1
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
