YourFath3r253/tennisball-picking/experiments/實驗數據/camera_tilt_20261026/view_tilt15/grid.csv

tilt | ground_d | bearing | slant_cm | detected | conf | est_dist_cm | est_bearing_deg | box_cy_px | n_dets
15.0 | 0.1 | -30 | 21.4 | 0 |  |  |  |  | 0
15.0 | 0.12 | -30 | 22.4 | 0 |  |  |  |  | 0
15.0 | 0.14 | -30 | 23.5 | 0 |  |  |  |  | 0
15.0 | 0.16 | -30 | 24.8 | 0 |  |  |  |  | 0
15.0 | 0.18 | -30 | 26.1 | 1 | 0.617 | 74.2 | -14.5 | 375.7 | 1
15.0 | 0.2 | -30 | 27.5 | 1 | 0.887 | 46.2 | -15.9 | 366.2 | 1
15.0 | 0.22 | -30 | 29.0 | 1 | 0.944 | 37.5 | -16.7 | 357.7 | 1
15.0 | 0.25 | -30 | 31.3 | 1 | 0.928 | 32.9 | -17.8 | 346.3 | 1
15.0 | 0.28 | -30 | 33.8 | 1 | 0.955 | 30.7 | -18.6 | 336.7 | 1
15.0 | 0.32 | -30 | 37.2 | 1 | 0.939 | 34.6 | -19.4 | 310.6 | 1
15.0 | 0.36 | -30 | 40.7 | 1 | 0.926 | 38.7 | -20.1 | 289.0 | 1
15.0 | 0.4 | -30 | 44.2 | 1 | 0.932 | 42.9 | -20.7 | 271.3 | 1
15.0 | 0.5 | -30 | 53.5 | 1 | 0.925 | 51.3 | -21.7 | 238.3 | 1
15.0 | 0.6 | -30 | 62.9 | 1 | 0.922 | 61.7 | -22.5 | 216.4 | 1
15.0 | 0.8 | -30 | 82.2 | 1 | 0.945 | 79.5 | -23.4 | 186.2 | 1
15.0 | 1.0 | -30 | 101.8 | 1 | 0.950 | 96.5 | -24.0 | 167.4 | 1
15.0 | 1.25 | -30 | 126.4 | 1 | 0.904 | 117.9 | -24.5 | 152.2 | 1
15.0 | 1.5 | -30 | 151.2 | 1 | 0.913 | 137.7 | -24.7 | 141.4 | 1
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
