YourFath3r253/tennisball-picking/experiments/實驗數據/camera_tilt_20261026/view_tilt18/grid.csv

tilt | ground_d | bearing | slant_cm | detected | conf | est_dist_cm | est_bearing_deg | box_cy_px | n_dets
18.0 | 0.1 | -30 | 21.4 | 0 |  |  |  |  | 0
18.0 | 0.12 | -30 | 22.4 | 0 |  |  |  |  | 0
18.0 | 0.14 | -30 | 23.5 | 0 |  |  |  |  | 0
18.0 | 0.16 | -30 | 24.8 | 1 | 0.624 | 111.4 | -15.5 | 379.4 | 1
18.0 | 0.18 | -30 | 26.1 | 1 | 0.899 | 48.7 | -16.9 | 367.9 | 1
18.0 | 0.2 | -30 | 27.5 | 1 | 0.937 | 37.0 | -18.2 | 358.3 | 1
18.0 | 0.22 | -30 | 29.0 | 1 | 0.954 | 32.7 | -19.0 | 349.0 | 1
18.0 | 0.25 | -30 | 31.3 | 1 | 0.941 | 29.9 | -19.8 | 338.1 | 1
18.0 | 0.28 | -30 | 33.8 | 1 | 0.953 | 31.1 | -20.5 | 319.3 | 1
18.0 | 0.32 | -30 | 37.2 | 1 | 0.927 | 34.7 | -21.4 | 293.4 | 1
18.0 | 0.36 | -30 | 40.7 | 1 | 0.925 | 38.7 | -21.9 | 271.7 | 1
18.0 | 0.4 | -30 | 44.2 | 1 | 0.930 | 42.7 | -22.4 | 254.1 | 1
18.0 | 0.5 | -30 | 53.5 | 1 | 0.963 | 51.4 | -23.4 | 220.8 | 1
18.0 | 0.6 | -30 | 62.9 | 1 | 0.933 | 61.6 | -24.1 | 198.0 | 1
18.0 | 0.8 | -30 | 82.2 | 1 | 0.922 | 78.7 | -24.9 | 167.0 | 1
18.0 | 1.0 | -30 | 101.8 | 1 | 0.927 | 94.0 | -25.4 | 147.9 | 1
18.0 | 1.25 | -30 | 126.4 | 1 | 0.960 | 116.2 | -25.8 | 132.2 | 1
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
