YourFath3r253/tennisball-picking/experiments/實驗數據/camera_tilt_20261026/view_tilt21.3/grid.csv

tilt | ground_d | bearing | slant_cm | detected | conf | est_dist_cm | est_bearing_deg | box_cy_px | n_dets
21.3 | 0.1 | -30 | 21.4 | 0 |  |  |  |  | 0
21.3 | 0.12 | -30 | 22.4 | 0 |  |  |  |  | 0
21.3 | 0.14 | -30 | 23.5 | 0 |  |  |  |  | 0
21.3 | 0.16 | -30 | 24.8 | 1 | 0.892 | 68.0 | -15.0 | 356.8 | 1
21.3 | 0.18 | -30 | 26.1 | 1 | 0.936 | 42.5 | -16.4 | 347.0 | 1
21.3 | 0.2 | -30 | 27.5 | 1 | 0.919 | 33.9 | -17.7 | 337.0 | 1
21.3 | 0.22 | -30 | 29.0 | 1 | 0.939 | 31.6 | -18.6 | 328.0 | 1
21.3 | 0.25 | -30 | 31.3 | 1 | 0.955 | 29.7 | -19.4 | 315.7 | 1
21.3 | 0.28 | -30 | 33.8 | 1 | 0.936 | 32.0 | -20.1 | 294.0 | 1
21.3 | 0.32 | -30 | 37.2 | 1 | 0.936 | 35.4 | -21.0 | 268.7 | 1
21.3 | 0.36 | -30 | 40.7 | 1 | 0.934 | 39.0 | -21.6 | 248.3 | 1
21.3 | 0.4 | -30 | 44.2 | 1 | 0.933 | 42.9 | -22.2 | 231.3 | 1
21.3 | 0.5 | -30 | 53.5 | 1 | 0.953 | 52.0 | -23.2 | 198.1 | 1
21.3 | 0.6 | -30 | 62.9 | 1 | 0.959 | 61.4 | -24.0 | 174.9 | 1
21.3 | 0.8 | -30 | 82.2 | 1 | 0.911 | 78.3 | -24.8 | 144.0 | 1
21.3 | 1.0 | -30 | 101.8 | 1 | 0.904 | 96.2 | -25.4 | 124.4 | 1
21.3 | 1.25 | -30 | 126.4 | 1 | 0.949 | 115.9 | -25.9 | 108.6 | 1
21.3 | 1.5 | -30 | 151.2 | 1 | 0.928 | 135.9 | -26.3 | 97.6 | 1
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
