YourFath3r253/tennisball-picking/experiments/實驗數據/camera_tilt_20261026/view_tilt24/grid.csv

tilt | ground_d | bearing | slant_cm | detected | conf | est_dist_cm | est_bearing_deg | box_cy_px | n_dets
24.0 | 0.1 | -30 | 21.4 | 0 |  |  |  |  | 0
24.0 | 0.12 | -30 | 22.4 | 0 |  |  |  |  | 0
24.0 | 0.14 | -30 | 23.5 | 0 |  |  |  |  | 0
24.0 | 0.16 | -30 | 24.8 | 1 | 0.877 | 70.8 | -14.9 | 335.9 | 1
24.0 | 0.18 | -30 | 26.1 | 1 | 0.949 | 42.0 | -16.3 | 326.7 | 1
24.0 | 0.2 | -30 | 27.5 | 1 | 0.943 | 34.8 | -17.5 | 316.7 | 1
24.0 | 0.22 | -30 | 29.0 | 1 | 0.952 | 32.2 | -18.3 | 307.7 | 1
24.0 | 0.25 | -30 | 31.3 | 1 | 0.954 | 29.9 | -19.2 | 295.8 | 1
24.0 | 0.28 | -30 | 33.8 | 1 | 0.932 | 32.5 | -20.0 | 274.4 | 1
24.0 | 0.32 | -30 | 37.2 | 1 | 0.954 | 36.1 | -20.8 | 249.4 | 1
24.0 | 0.36 | -30 | 40.7 | 1 | 0.923 | 39.6 | -21.6 | 229.0 | 1
24.0 | 0.4 | -30 | 44.2 | 1 | 0.918 | 43.2 | -22.2 | 212.0 | 1
24.0 | 0.5 | -30 | 53.5 | 1 | 0.960 | 52.0 | -23.1 | 179.4 | 1
24.0 | 0.6 | -30 | 62.9 | 1 | 0.949 | 60.5 | -24.1 | 156.3 | 1
24.0 | 0.8 | -30 | 82.2 | 1 | 0.944 | 77.3 | -25.0 | 125.3 | 1
24.0 | 1.0 | -30 | 101.8 | 1 | 0.897 | 94.9 | -25.6 | 105.6 | 1
24.0 | 1.25 | -30 | 126.4 | 1 | 0.950 | 112.2 | -26.3 | 89.7 | 1
24.0 | 1.5 | -30 | 151.2 | 1 | 0.924 | 130.4 | -26.6 | 78.2 | 1
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
