YourFath3r253/tennisball-picking/experiments/實驗數據/camera_tilt_20261026/view_tilt27/grid.csv

tilt | ground_d | bearing | slant_cm | detected | conf | est_dist_cm | est_bearing_deg | box_cy_px | n_dets
27.0 | 0.1 | -30 | 21.4 | 0 |  |  |  |  | 0
27.0 | 0.12 | -30 | 22.4 | 0 |  |  |  |  | 0
27.0 | 0.14 | -30 | 23.5 | 0 |  |  |  |  | 0
27.0 | 0.16 | -30 | 24.8 | 1 | 0.928 | 60.1 | -13.0 | 311.2 | 1
27.0 | 0.18 | -30 | 26.1 | 1 | 0.937 | 40.7 | -14.2 | 301.9 | 1
27.0 | 0.2 | -30 | 27.5 | 1 | 0.955 | 33.9 | -15.5 | 294.0 | 1
27.0 | 0.22 | -30 | 29.0 | 1 | 0.946 | 31.7 | -16.4 | 285.3 | 1
27.0 | 0.25 | -30 | 31.3 | 1 | 0.929 | 30.1 | -17.3 | 272.7 | 1
27.0 | 0.28 | -30 | 33.8 | 1 | 0.933 | 33.0 | -18.2 | 250.5 | 1
27.0 | 0.32 | -30 | 37.2 | 1 | 0.914 | 36.4 | -19.2 | 225.9 | 1
27.0 | 0.36 | -30 | 40.7 | 1 | 0.929 | 40.0 | -20.0 | 206.3 | 1
27.0 | 0.4 | -30 | 44.2 | 1 | 0.931 | 43.6 | -20.7 | 189.4 | 1
27.0 | 0.5 | -30 | 53.5 | 1 | 0.955 | 51.9 | -21.9 | 157.0 | 1
27.0 | 0.6 | -30 | 62.9 | 1 | 0.930 | 60.8 | -22.9 | 134.7 | 1
27.0 | 0.8 | -30 | 82.2 | 1 | 0.893 | 76.3 | -24.1 | 103.2 | 1
27.0 | 1.0 | -30 | 101.8 | 1 | 0.918 | 92.1 | -24.8 | 83.1 | 1
27.0 | 1.25 | -30 | 126.4 | 1 | 0.922 | 111.7 | -25.5 | 66.6 | 1
27.0 | 1.5 | -30 | 151.2 | 1 | 0.910 | 129.0 | -26.0 | 54.9 | 1
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
