YourFath3r253/tennisball-picking/experiments/實驗數據/camera_tilt_20261026/view_tilt9/grid.csv

tilt | ground_d | bearing | slant_cm | detected | conf | est_dist_cm | est_bearing_deg | box_cy_px | n_dets
9.0 | 0.1 | -30 | 21.4 | 0 |  |  |  |  | 0
9.0 | 0.12 | -30 | 22.4 | 0 |  |  |  |  | 0
9.0 | 0.14 | -30 | 23.5 | 0 |  |  |  |  | 0
9.0 | 0.16 | -30 | 24.8 | 0 |  |  |  |  | 0
9.0 | 0.18 | -30 | 26.1 | 0 |  |  |  |  | 0
9.0 | 0.2 | -30 | 27.5 | 0 |  |  |  |  | 0
9.0 | 0.22 | -30 | 29.0 | 0 |  |  |  |  | 0
9.0 | 0.25 | -30 | 31.3 | 1 | 0.770 | 63.5 | -20.3 | 372.1 | 1
9.0 | 0.28 | -30 | 33.8 | 1 | 0.940 | 44.3 | -21.4 | 361.9 | 1
9.0 | 0.32 | -30 | 37.2 | 1 | 0.948 | 37.8 | -22.1 | 350.5 | 1
9.0 | 0.36 | -30 | 40.7 | 1 | 0.923 | 36.0 | -22.5 | 339.3 | 1
9.0 | 0.4 | -30 | 44.2 | 1 | 0.911 | 40.0 | -23.0 | 319.3 | 1
9.0 | 0.5 | -30 | 53.5 | 1 | 0.940 | 50.5 | -23.7 | 284.3 | 1
9.0 | 0.6 | -30 | 62.9 | 1 | 0.953 | 59.4 | -24.2 | 259.7 | 1
9.0 | 0.8 | -30 | 82.2 | 1 | 0.933 | 78.0 | -24.8 | 228.7 | 1
9.0 | 1.0 | -30 | 101.8 | 1 | 0.882 | 96.6 | -25.2 | 209.0 | 1
9.0 | 1.25 | -30 | 126.4 | 1 | 0.905 | 118.2 | -25.6 | 193.9 | 1
9.0 | 1.5 | -30 | 151.2 | 1 | 0.931 | 137.1 | -25.7 | 183.0 | 1
9.0 | 2.0 | -30 | 200.9 | 1 | 0.855 | 174.0 | -26.1 | 170.2 | 1
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
