YourFath3r253/tennisball-picking/experiments/實驗數據/bounce_2d_3球_五種角度.png

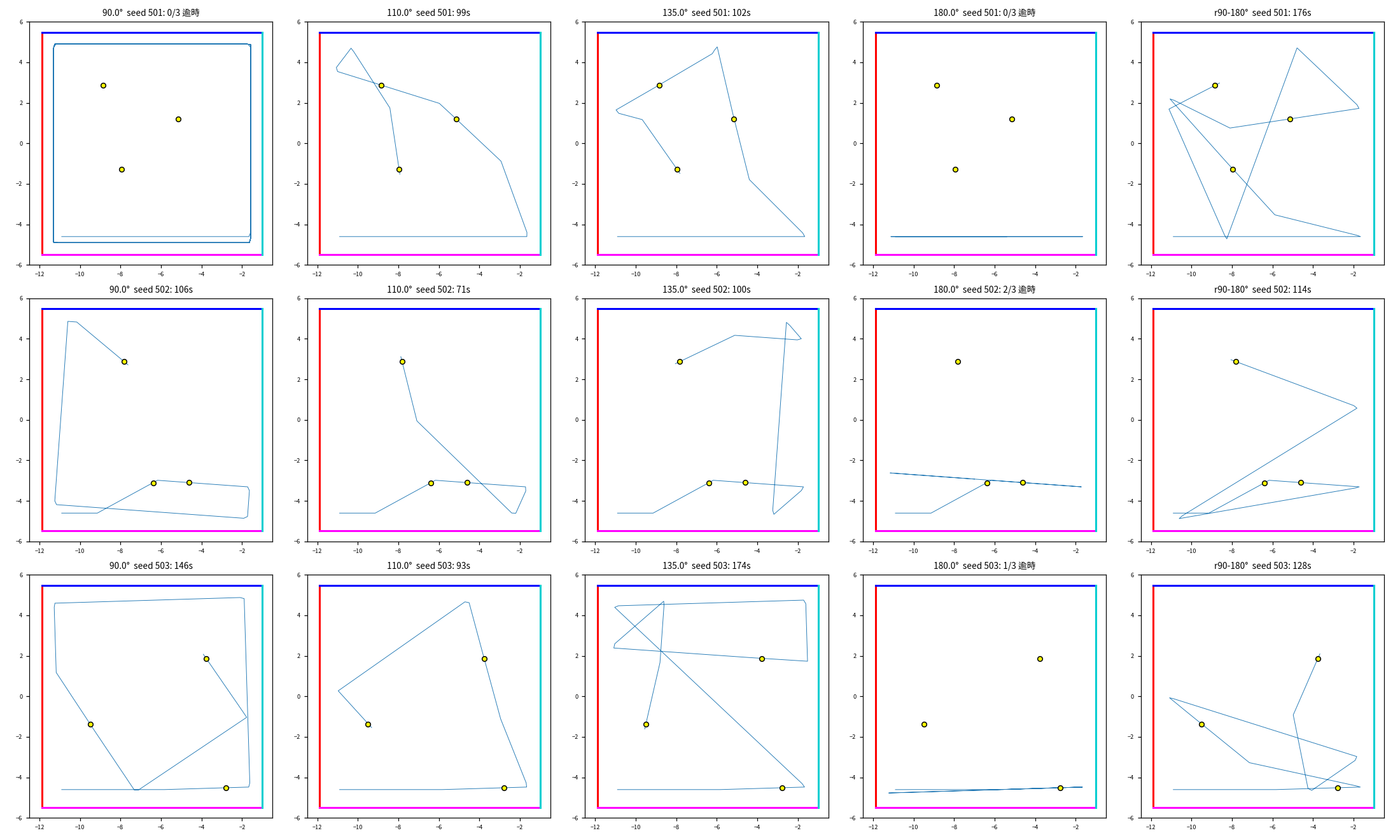
experiments/實驗數據/bounce_2d_3球_五種角度.png
