YourFath3r253/tennisball-picking/experiments/實驗數據/bounce_2d_10球_四種固定角度.png

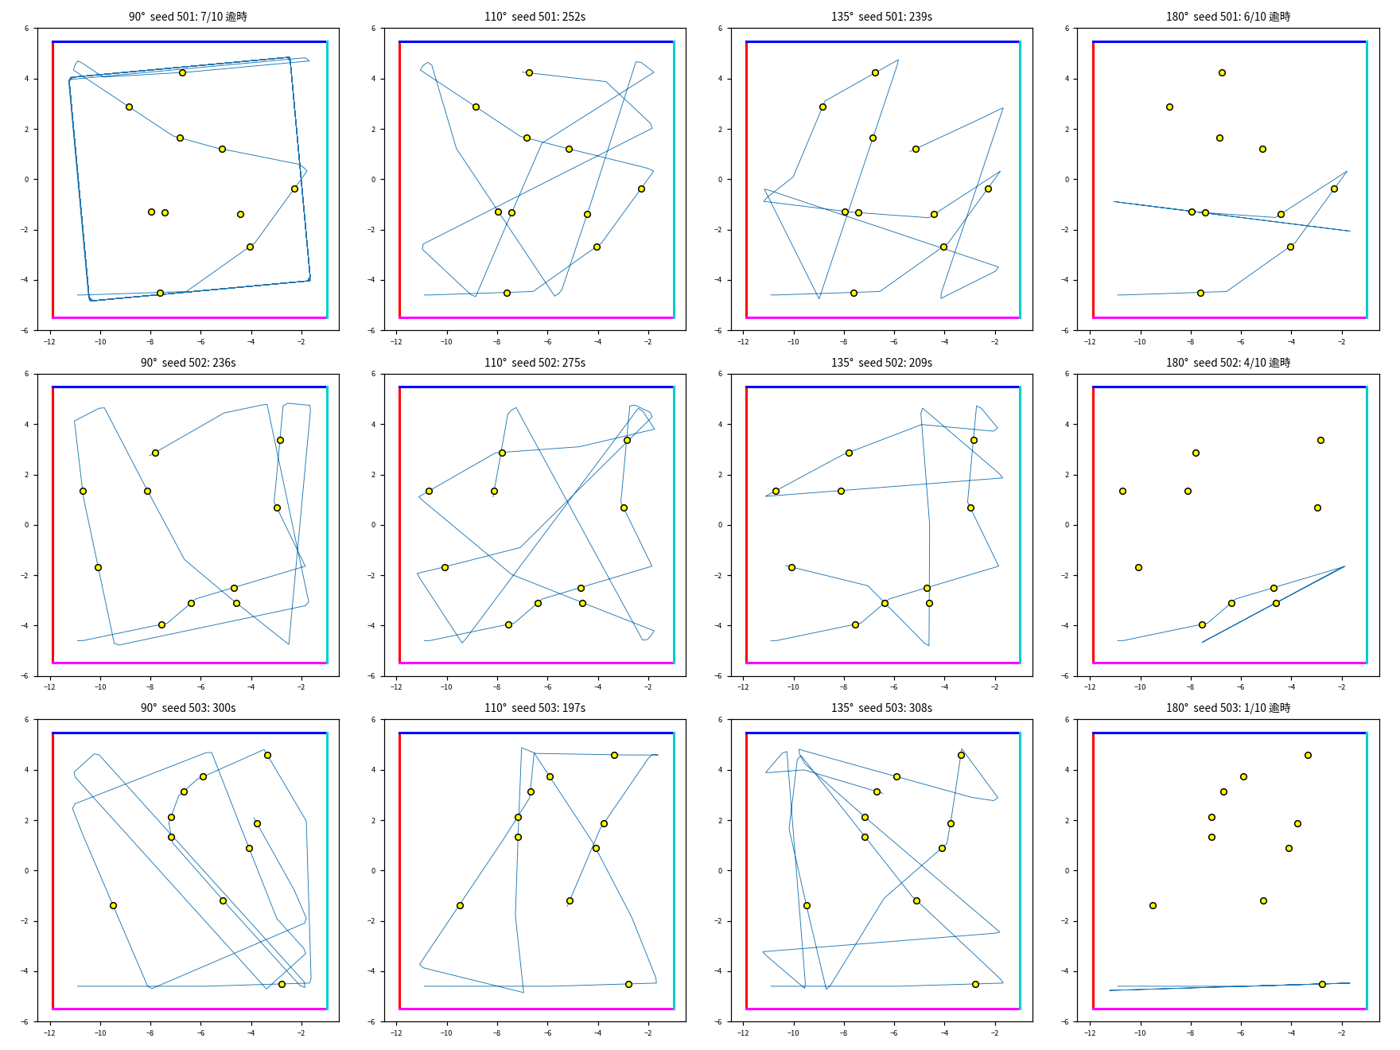
experiments/實驗數據/bounce_2d_10球_四種固定角度.png
