YourFath3r253/tennisball-picking/experiments/實驗數據/camera_tilt_20261026/camera_tilt_summary.png

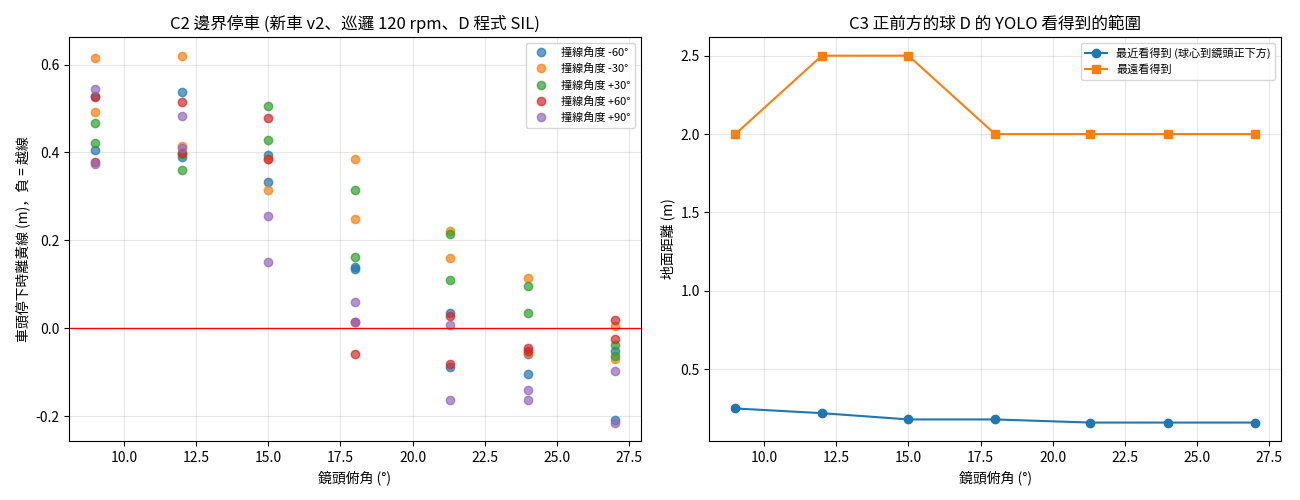
experiments/實驗數據/camera_tilt_20261026/camera_tilt_summary.png
