YourFath3r253/tennisball-picking/experiments/實驗數據/camera_tilt_20261026/view_tilt18/view_line.png

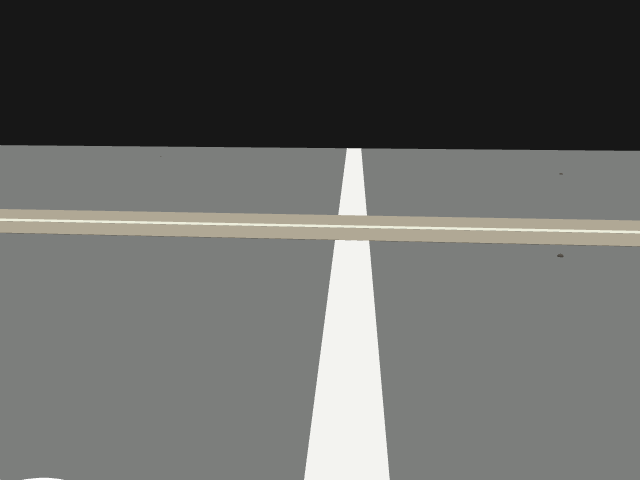
experiments/實驗數據/camera_tilt_20261026/view_tilt18/view_line.png
