YourFath3r253/tennisball-picking/experiments/實驗數據/camera_tilt_20261026/view_tilt21.3/ball_1.0m.png

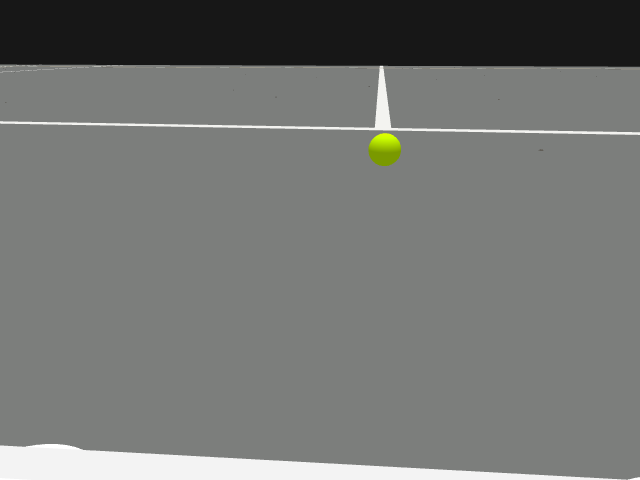
experiments/實驗數據/camera_tilt_20261026/view_tilt21.3/ball_1.0m.png
