YourFath3r253/tennisball-picking/experiments/實驗數據/camera_tilt_20261026/view_tilt24/ball_0.2m.png

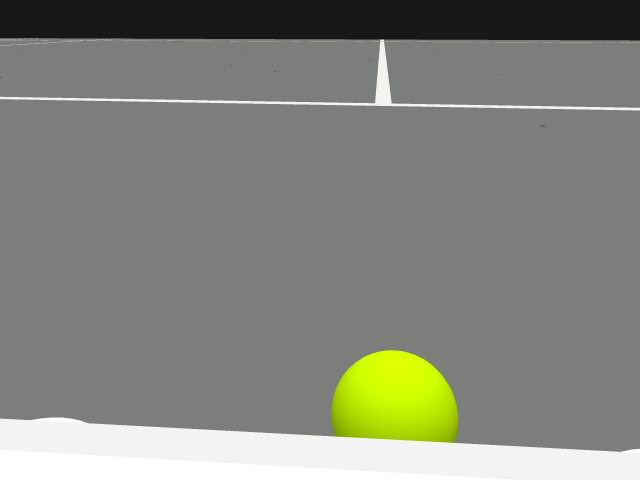
experiments/實驗數據/camera_tilt_20261026/view_tilt24/ball_0.2m.png
