YourFath3r253/tennisball-picking/experiments/實驗數據/run156/trajectory_plot.png

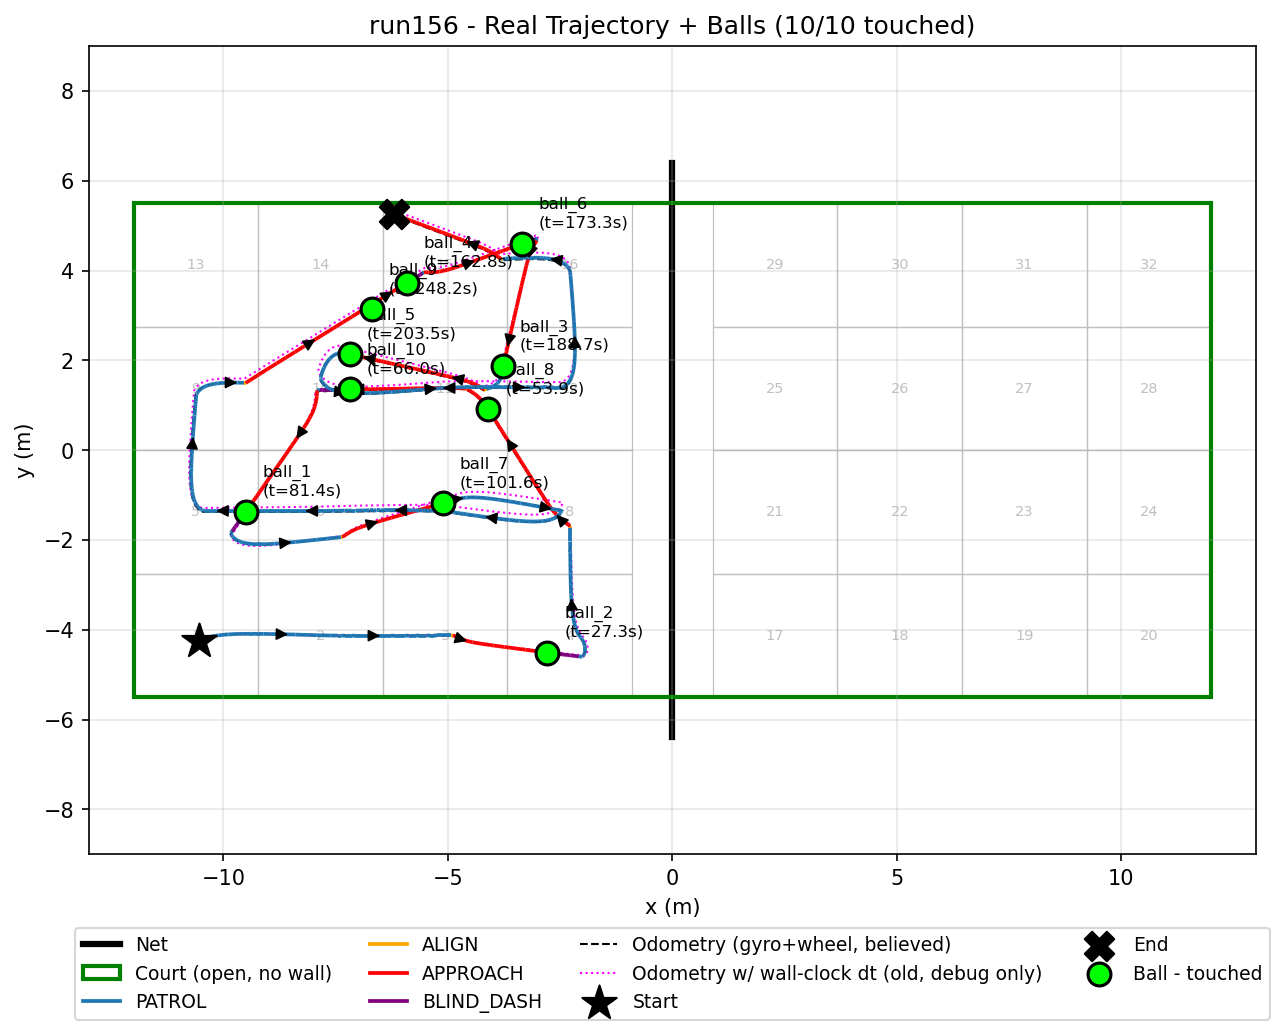
experiments/實驗數據/run156/trajectory_plot.png
