YourFath3r253/tennisball-picking/experiments/實驗數據/run176/real_car_traj.png

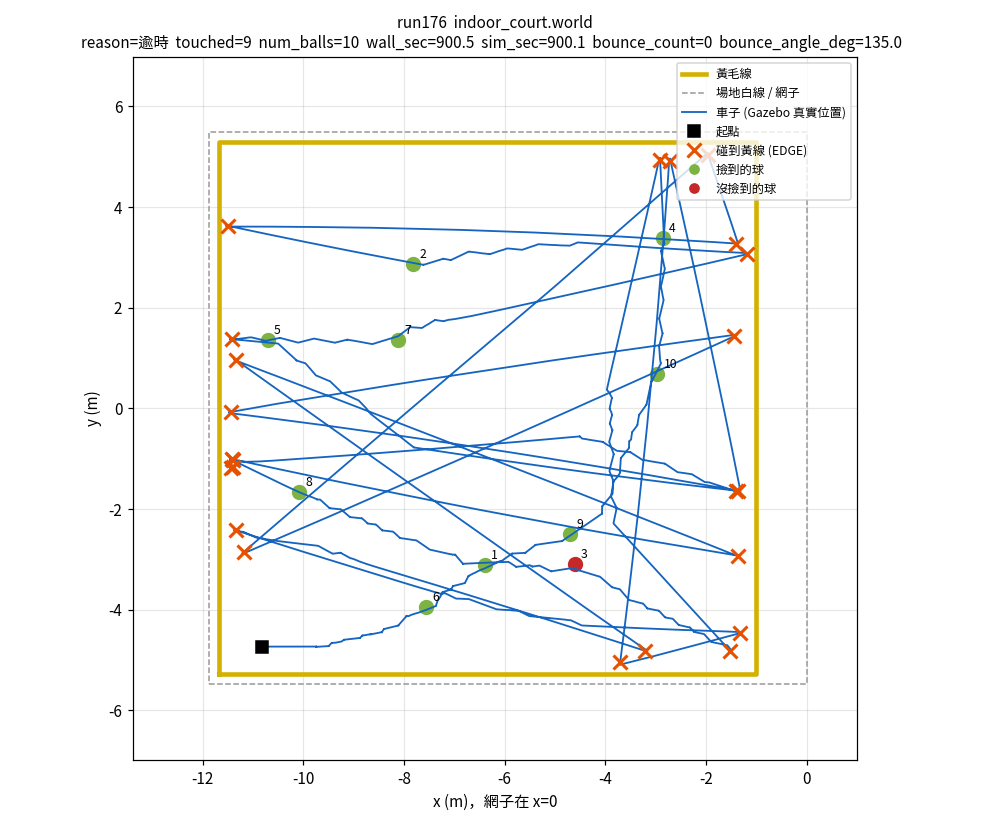
experiments/實驗數據/run176/real_car_traj.png
