YourFath3r253/tennisball-picking/experiments/實驗數據/sponge_20261026/v2_kp2000_W82/traj.png

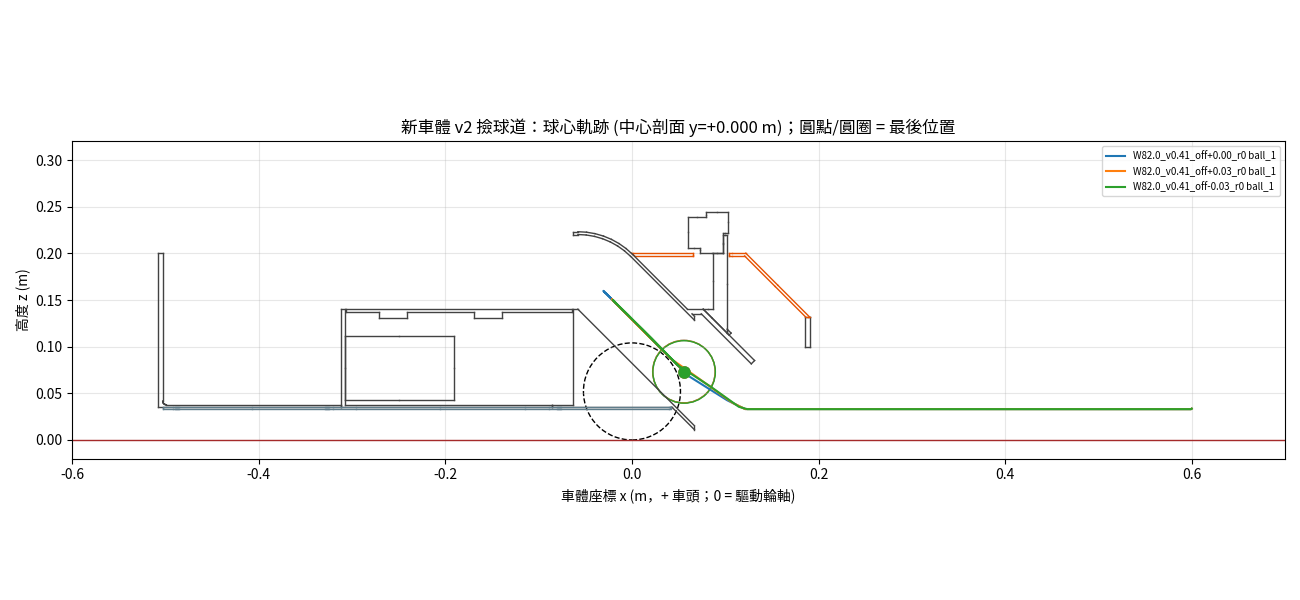
experiments/實驗數據/sponge_20261026/v2_kp2000_W82/traj.png
