YourFath3r253/tennisball-picking/experiments/實驗數據/轉向方塊圖/圖1_轉向迴路現況.png

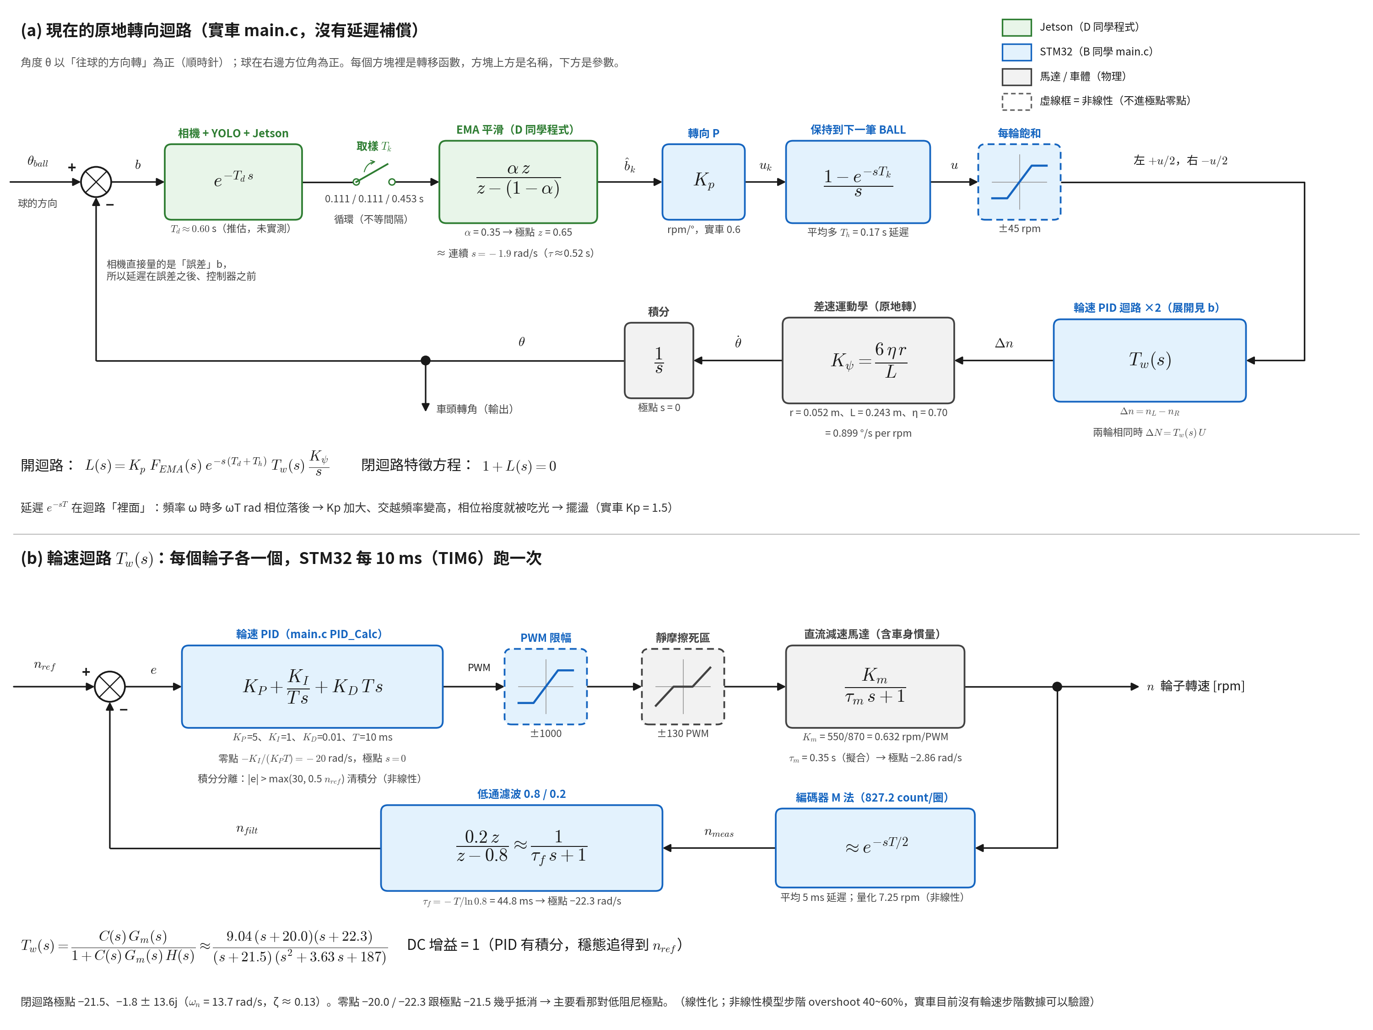
experiments/實驗數據/轉向方塊圖/圖1_轉向迴路現況.png
