YourFath3r253/tennisball-picking/experiments/實驗數據/轉向方塊圖/圖2_延遲補償.png

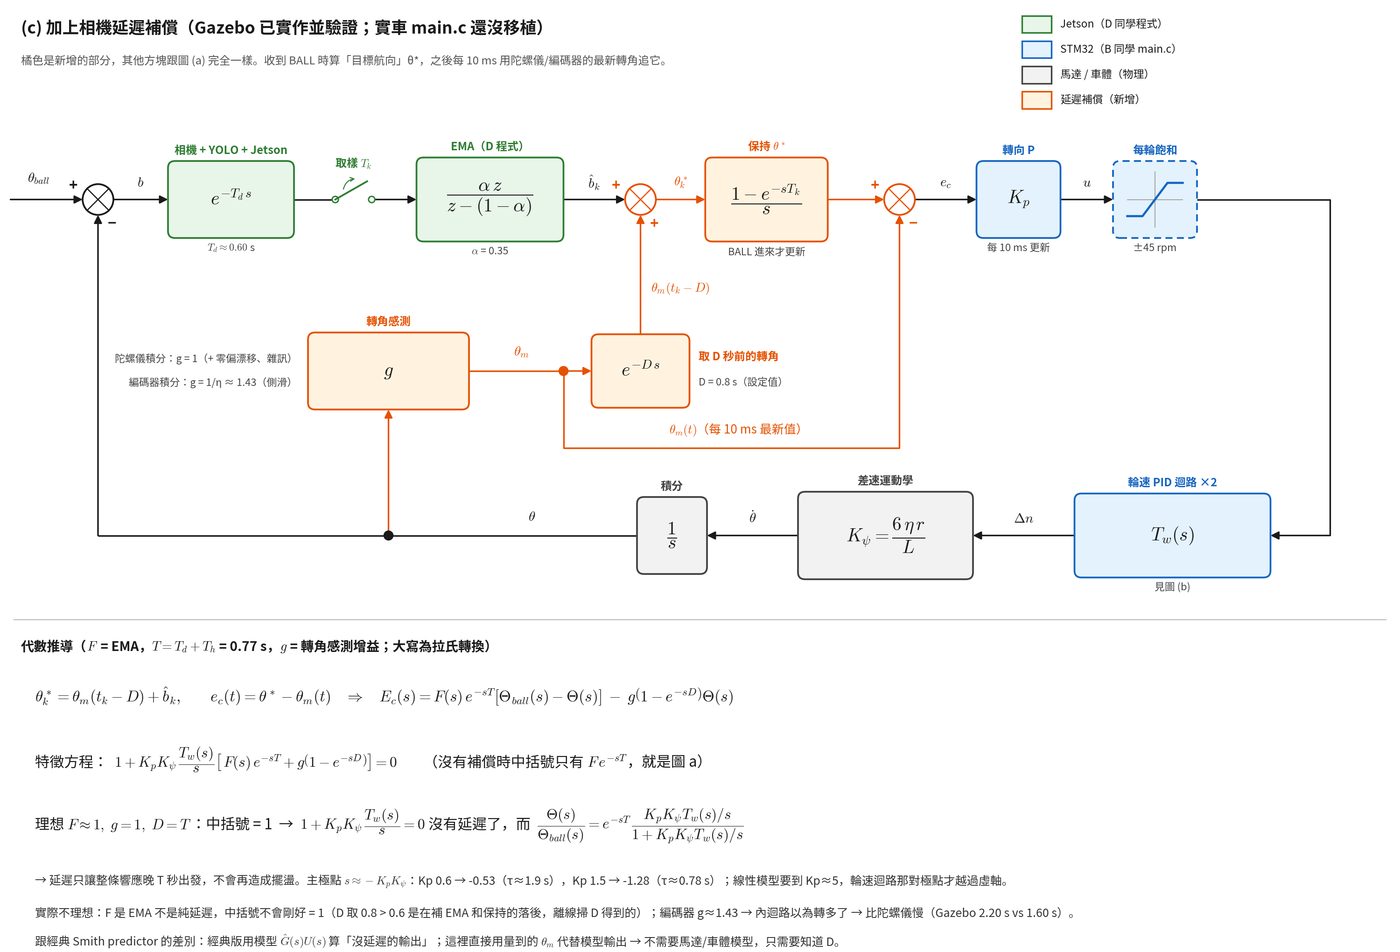
experiments/實驗數據/轉向方塊圖/圖2_延遲補償.png
