YourFath3r253/tennisball-picking/experiments/實驗數據/vision_debug.csv

epoch | all_contour_count | all_max_area | valid_contour_count | valid_max_area | ball_found | cx | cy
1789381250.243 | 2 | 22.0 | 0 | 0.0 | 0 | -1.0 | -1.0
1789381250.368 | 2 | 22.0 | 0 | 0.0 | 0 | -1.0 | -1.0
1789381250.490 | 2 | 22.0 | 0 | 0.0 | 0 | -1.0 | -1.0
1789381250.624 | 2 | 22.0 | 0 | 0.0 | 0 | -1.0 | -1.0
1789381250.725 | 2 | 22.0 | 0 | 0.0 | 0 | -1.0 | -1.0
1789381250.825 | 2 | 22.0 | 0 | 0.0 | 0 | -1.0 | -1.0
1789381250.926 | 2 | 22.0 | 0 | 0.0 | 0 | -1.0 | -1.0
1789381251.069 | 2 | 22.0 | 0 | 0.0 | 0 | -1.0 | -1.0
1789381251.202 | 2 | 22.0 | 0 | 0.0 | 0 | -1.0 | -1.0
1789381251.327 | 2 | 22.0 | 0 | 0.0 | 0 | -1.0 | -1.0
1789381251.458 | 2 | 22.0 | 0 | 0.0 | 0 | -1.0 | -1.0
1789381251.559 | 2 | 22.0 | 0 | 0.0 | 0 | -1.0 | -1.0
1789381251.690 | 2 | 22.0 | 0 | 0.0 | 0 | -1.0 | -1.0
1789381251.801 | 2 | 22.0 | 0 | 0.0 | 0 | -1.0 | -1.0
1789381251.935 | 2 | 22.0 | 0 | 0.0 | 0 | -1.0 | -1.0
1789381252.038 | 2 | 22.0 | 0 | 0.0 | 0 | -1.0 | -1.0
1789381252.161 | 2 | 22.0 | 0 | 0.0 | 0 | -1.0 | -1.0
1789381252.293 | 2 | 22.0 | 0 | 0.0 | 0 | -1.0 | -1.0
1789381252.394 | 2 | 22.0 | 0 | 0.0 | 0 | -1.0 | -1.0
1789381252.526 | 2 | 22.0 | 0 | 0.0 | 0 | -1.0 | -1.0
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
