YourFath3r253/tennisball-picking/experiments/實驗數據/run174/dt_debug.csv

t | wall_dt | sim_dt | state | dropped
0.016 | 0.0080 | 0.0100 | REAL_CAR | 0
0.026 | 0.0101 | 0.0100 | REAL_CAR | 0
0.036 | 0.0098 | 0.0100 | REAL_CAR | 0
0.046 | 0.0100 | 0.0100 | REAL_CAR | 0
0.056 | 0.0100 | 0.0100 | REAL_CAR | 0
0.066 | 0.0099 | 0.0100 | REAL_CAR | 0
0.076 | 0.0101 | 0.0100 | REAL_CAR | 0
0.086 | 0.0096 | 0.0100 | REAL_CAR | 0
0.096 | 0.0100 | 0.0100 | REAL_CAR | 0
0.106 | 0.0099 | 0.0100 | REAL_CAR | 0
0.116 | 0.0100 | 0.0100 | REAL_CAR | 0
0.126 | 0.0100 | 0.0100 | REAL_CAR | 0
0.136 | 0.0102 | 0.0100 | REAL_CAR | 0
0.146 | 0.0100 | 0.0100 | REAL_CAR | 0
0.156 | 0.0099 | 0.0100 | REAL_CAR | 0
0.166 | 0.0099 | 0.0100 | REAL_CAR | 0
0.176 | 0.0099 | 0.0100 | REAL_CAR | 0
0.186 | 0.0102 | 0.0100 | REAL_CAR | 0
0.196 | 0.0098 | 0.0100 | REAL_CAR | 0
0.206 | 0.0100 | 0.0100 | REAL_CAR | 0
0.216 | 0.0100 | 0.0100 | REAL_CAR | 0
0.226 | 0.0101 | 0.0100 | REAL_CAR | 0
0.236 | 0.0099 | 0.0100 | REAL_CAR | 0
0.246 | 0.0100 | 0.0100 | REAL_CAR | 0
0.256 | 0.0100 | 0.0100 | REAL_CAR | 0
0.266 | 0.0101 | 0.0100 | REAL_CAR | 0
0.276 | 0.0098 | 0.0100 | REAL_CAR | 0
0.286 | 0.0102 | 0.0100 | REAL_CAR | 0
0.296 | 0.0098 | 0.0100 | REAL_CAR | 0
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
