YourFath3r253/tennisball-picking/experiments/實驗數據/run117/dt_debug.csv

t | wall_dt | sim_dt | state | dropped
0.042 | 0.0337 | 0.0340 | PATROL | 0
0.076 | 0.0341 | 0.0340 | PATROL | 0
0.110 | 0.0336 | 0.0340 | PATROL | 0
0.144 | 0.0338 | 0.0340 | PATROL | 0
0.178 | 0.0340 | 0.0340 | PATROL | 0
0.212 | 0.0341 | 0.0340 | PATROL | 0
0.246 | 0.0340 | 0.0340 | PATROL | 0
0.280 | 0.0339 | 0.0340 | PATROL | 0
0.314 | 0.0342 | 0.0340 | PATROL | 0
0.347 | 0.0338 | 0.0340 | PATROL | 0
0.382 | 0.0341 | 0.0340 | PATROL | 0
0.416 | 0.0341 | 0.0340 | PATROL | 0
0.450 | 0.0339 | 0.0340 | PATROL | 0
0.484 | 0.0341 | 0.0340 | PATROL | 0
0.518 | 0.0341 | 0.0340 | PATROL | 0
0.552 | 0.0340 | 0.0340 | PATROL | 0
0.586 | 0.0339 | 0.0340 | PATROL | 0
0.620 | 0.0342 | 0.0340 | PATROL | 0
0.654 | 0.0339 | 0.0340 | PATROL | 0
0.688 | 0.0342 | 0.0340 | PATROL | 0
0.722 | 0.0339 | 0.0340 | PATROL | 0
0.756 | 0.0341 | 0.0340 | PATROL | 0
0.790 | 0.0339 | 0.0340 | PATROL | 0
0.824 | 0.0342 | 0.0340 | PATROL | 0
0.858 | 0.0340 | 0.0340 | PATROL | 0
0.892 | 0.0339 | 0.0340 | PATROL | 0
0.926 | 0.0341 | 0.0340 | PATROL | 0
0.960 | 0.0340 | 0.0340 | PATROL | 0
0.994 | 0.0339 | 0.0340 | PATROL | 0
1.028 | 0.0340 | 0.0340 | PATROL | 0
1.062 | 0.0343 | 0.0340 | PATROL | 0
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
