YourFath3r253/tennisball-picking/experiments/實驗數據/run118/dt_debug.csv

t | wall_dt | sim_dt | state | dropped
0.064 | 0.0339 | 0.0340 | PATROL | 0
0.098 | 0.0340 | 0.0340 | PATROL | 0
0.132 | 0.0340 | 0.0340 | PATROL | 0
0.167 | 0.0342 | 0.0340 | PATROL | 0
0.200 | 0.0338 | 0.0340 | PATROL | 0
0.235 | 0.0341 | 0.0340 | PATROL | 0
0.268 | 0.0340 | 0.0340 | PATROL | 0
0.302 | 0.0339 | 0.0340 | PATROL | 0
0.337 | 0.0342 | 0.0340 | PATROL | 0
0.370 | 0.0338 | 0.0340 | PATROL | 0
0.404 | 0.0338 | 0.0340 | PATROL | 0
0.438 | 0.0340 | 0.0340 | PATROL | 0
0.472 | 0.0340 | 0.0340 | PATROL | 0
0.507 | 0.0343 | 0.0340 | PATROL | 0
0.541 | 0.0342 | 0.0340 | PATROL | 0
0.575 | 0.0341 | 0.0340 | PATROL | 0
0.609 | 0.0342 | 0.0340 | PATROL | 0
0.642 | 0.0334 | 0.0340 | PATROL | 0
0.676 | 0.0339 | 0.0340 | PATROL | 0
0.710 | 0.0340 | 0.0340 | PATROL | 0
0.745 | 0.0342 | 0.0340 | PATROL | 0
0.779 | 0.0339 | 0.0340 | PATROL | 0
0.813 | 0.0340 | 0.0340 | PATROL | 0
0.847 | 0.0342 | 0.0340 | PATROL | 0
0.881 | 0.0341 | 0.0340 | PATROL | 0
0.915 | 0.0340 | 0.0340 | PATROL | 0
0.949 | 0.0339 | 0.0340 | PATROL | 0
0.983 | 0.0341 | 0.0340 | PATROL | 0
1.017 | 0.0338 | 0.0340 | PATROL | 0
1.051 | 0.0340 | 0.0340 | PATROL | 0
1.085 | 0.0344 | 0.0340 | PATROL | 0
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
