YourFath3r253/tennisball-picking/experiments/實驗數據/run119/dt_debug.csv

t | wall_dt | sim_dt | state | dropped
0.062 | 0.0341 | 0.0340 | PATROL | 0
0.096 | 0.0340 | 0.0340 | PATROL | 0
0.130 | 0.0339 | 0.0340 | PATROL | 0
0.164 | 0.0340 | 0.0340 | PATROL | 0
0.198 | 0.0340 | 0.0340 | PATROL | 0
0.232 | 0.0341 | 0.0340 | PATROL | 0
0.266 | 0.0340 | 0.0340 | PATROL | 0
0.300 | 0.0340 | 0.0340 | PATROL | 0
0.334 | 0.0340 | 0.0340 | PATROL | 0
0.368 | 0.0340 | 0.0340 | PATROL | 0
0.402 | 0.0340 | 0.0340 | PATROL | 0
0.436 | 0.0339 | 0.0340 | PATROL | 0
0.470 | 0.0340 | 0.0340 | PATROL | 0
0.504 | 0.0345 | 0.0340 | PATROL | 0
0.538 | 0.0338 | 0.0340 | PATROL | 0
0.572 | 0.0340 | 0.0340 | PATROL | 0
0.606 | 0.0339 | 0.0340 | PATROL | 0
0.640 | 0.0341 | 0.0340 | PATROL | 0
0.674 | 0.0341 | 0.0340 | PATROL | 0
0.708 | 0.0339 | 0.0340 | PATROL | 0
0.742 | 0.0342 | 0.0340 | PATROL | 0
0.776 | 0.0339 | 0.0340 | PATROL | 0
0.810 | 0.0339 | 0.0340 | PATROL | 0
0.844 | 0.0340 | 0.0340 | PATROL | 0
0.878 | 0.0341 | 0.0340 | PATROL | 0
0.912 | 0.0341 | 0.0340 | PATROL | 0
0.947 | 0.0344 | 0.0340 | PATROL | 0
0.980 | 0.0336 | 0.0340 | PATROL | 0
1.014 | 0.0341 | 0.0340 | PATROL | 0
1.048 | 0.0338 | 0.0340 | PATROL | 0
1.082 | 0.0341 | 0.0340 | PATROL | 0
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
