YourFath3r253/tennisball-picking/experiments/實驗數據/run120/dt_debug.csv

t | wall_dt | sim_dt | state | dropped
0.043 | 0.0340 | 0.0340 | PATROL | 0
0.077 | 0.0340 | 0.0340 | PATROL | 0
0.111 | 0.0340 | 0.0340 | PATROL | 0
0.145 | 0.0341 | 0.0340 | PATROL | 0
0.179 | 0.0340 | 0.0340 | PATROL | 0
0.213 | 0.0338 | 0.0340 | PATROL | 0
0.247 | 0.0340 | 0.0340 | PATROL | 0
0.281 | 0.0341 | 0.0340 | PATROL | 0
0.315 | 0.0340 | 0.0340 | PATROL | 0
0.349 | 0.0339 | 0.0340 | PATROL | 0
0.383 | 0.0342 | 0.0340 | PATROL | 0
0.417 | 0.0340 | 0.0340 | PATROL | 0
0.451 | 0.0339 | 0.0340 | PATROL | 0
0.486 | 0.0343 | 0.0340 | PATROL | 0
0.519 | 0.0338 | 0.0340 | PATROL | 0
0.554 | 0.0341 | 0.0340 | PATROL | 0
0.588 | 0.0340 | 0.0340 | PATROL | 0
0.622 | 0.0342 | 0.0340 | PATROL | 0
0.656 | 0.0338 | 0.0340 | PATROL | 0
0.690 | 0.0341 | 0.0340 | PATROL | 0
0.724 | 0.0339 | 0.0340 | PATROL | 0
0.758 | 0.0340 | 0.0340 | PATROL | 0
0.792 | 0.0342 | 0.0340 | PATROL | 0
0.826 | 0.0340 | 0.0340 | PATROL | 0
0.860 | 0.0338 | 0.0340 | PATROL | 0
0.894 | 0.0340 | 0.0340 | PATROL | 0
0.928 | 0.0343 | 0.0340 | PATROL | 0
0.962 | 0.0339 | 0.0340 | PATROL | 0
0.996 | 0.0340 | 0.0340 | PATROL | 0
1.030 | 0.0340 | 0.0340 | PATROL | 0
1.064 | 0.0340 | 0.0340 | PATROL | 0
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
