YourFath3r253/tennisball-picking/experiments/實驗數據/run121/dt_debug.csv

t | wall_dt | sim_dt | state | dropped
0.065 | 0.0340 | 0.0340 | PATROL | 0
0.099 | 0.0341 | 0.0340 | PATROL | 0
0.133 | 0.0340 | 0.0340 | PATROL | 0
0.167 | 0.0340 | 0.0340 | PATROL | 0
0.201 | 0.0338 | 0.0340 | PATROL | 0
0.235 | 0.0343 | 0.0340 | PATROL | 0
0.269 | 0.0338 | 0.0340 | PATROL | 0
0.303 | 0.0341 | 0.0340 | PATROL | 0
0.337 | 0.0342 | 0.0340 | PATROL | 0
0.371 | 0.0338 | 0.0340 | PATROL | 0
0.405 | 0.0341 | 0.0340 | PATROL | 0
0.439 | 0.0338 | 0.0340 | PATROL | 0
0.473 | 0.0342 | 0.0340 | PATROL | 0
0.507 | 0.0339 | 0.0340 | PATROL | 0
0.541 | 0.0342 | 0.0340 | PATROL | 0
0.575 | 0.0338 | 0.0340 | PATROL | 0
0.609 | 0.0342 | 0.0340 | PATROL | 0
0.643 | 0.0339 | 0.0340 | PATROL | 0
0.677 | 0.0341 | 0.0340 | PATROL | 0
0.711 | 0.0339 | 0.0340 | PATROL | 0
0.745 | 0.0340 | 0.0340 | PATROL | 0
0.779 | 0.0341 | 0.0340 | PATROL | 0
0.813 | 0.0340 | 0.0340 | PATROL | 0
0.847 | 0.0340 | 0.0340 | PATROL | 0
0.881 | 0.0339 | 0.0340 | PATROL | 0
0.915 | 0.0341 | 0.0340 | PATROL | 0
0.949 | 0.0339 | 0.0340 | PATROL | 0
0.983 | 0.0342 | 0.0340 | PATROL | 0
1.017 | 0.0338 | 0.0340 | PATROL | 0
1.051 | 0.0341 | 0.0340 | PATROL | 0
1.085 | 0.0339 | 0.0340 | PATROL | 0
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
