YourFath3r253/tennisball-picking/experiments/實驗數據/run122/dt_debug.csv

t | wall_dt | sim_dt | state | dropped
0.056 | 0.0339 | 0.0340 | PATROL | 0
0.090 | 0.0342 | 0.0340 | PATROL | 0
0.124 | 0.0339 | 0.0340 | PATROL | 0
0.158 | 0.0340 | 0.0340 | PATROL | 0
0.192 | 0.0339 | 0.0340 | PATROL | 0
0.226 | 0.0340 | 0.0340 | PATROL | 0
0.260 | 0.0341 | 0.0340 | PATROL | 0
0.294 | 0.0342 | 0.0340 | PATROL | 0
0.328 | 0.0338 | 0.0340 | PATROL | 0
0.362 | 0.0342 | 0.0340 | PATROL | 0
0.396 | 0.0339 | 0.0340 | PATROL | 0
0.430 | 0.0340 | 0.0340 | PATROL | 0
0.464 | 0.0340 | 0.0340 | PATROL | 0
0.498 | 0.0340 | 0.0340 | PATROL | 0
0.532 | 0.0340 | 0.0340 | PATROL | 0
0.566 | 0.0340 | 0.0340 | PATROL | 0
0.600 | 0.0340 | 0.0340 | PATROL | 0
0.635 | 0.0345 | 0.0340 | PATROL | 0
0.668 | 0.0336 | 0.0340 | PATROL | 0
0.702 | 0.0340 | 0.0340 | PATROL | 0
0.737 | 0.0343 | 0.0340 | PATROL | 0
0.771 | 0.0338 | 0.0340 | PATROL | 0
0.805 | 0.0342 | 0.0340 | PATROL | 0
0.838 | 0.0336 | 0.0340 | PATROL | 0
0.873 | 0.0342 | 0.0340 | PATROL | 0
0.906 | 0.0340 | 0.0340 | PATROL | 0
0.940 | 0.0339 | 0.0340 | PATROL | 0
0.974 | 0.0341 | 0.0340 | PATROL | 0
1.008 | 0.0339 | 0.0340 | PATROL | 0
1.042 | 0.0340 | 0.0340 | PATROL | 0
1.076 | 0.0341 | 0.0340 | PATROL | 0
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
