YourFath3r253/tennisball-picking/experiments/實驗數據/run123/dt_debug.csv

t | wall_dt | sim_dt | state | dropped
0.038 | 0.0333 | 0.0340 | PATROL | 0
0.072 | 0.0338 | 0.0340 | PATROL | 0
0.106 | 0.0341 | 0.0340 | PATROL | 0
0.141 | 0.0342 | 0.0340 | PATROL | 0
0.174 | 0.0338 | 0.0340 | PATROL | 0
0.209 | 0.0342 | 0.0340 | PATROL | 0
0.243 | 0.0340 | 0.0340 | PATROL | 0
0.277 | 0.0342 | 0.0340 | PATROL | 0
0.311 | 0.0340 | 0.0340 | PATROL | 0
0.345 | 0.0340 | 0.0340 | PATROL | 0
0.379 | 0.0340 | 0.0340 | PATROL | 0
0.413 | 0.0338 | 0.0340 | PATROL | 0
0.447 | 0.0341 | 0.0340 | PATROL | 0
0.481 | 0.0340 | 0.0340 | PATROL | 0
0.515 | 0.0340 | 0.0340 | PATROL | 0
0.549 | 0.0341 | 0.0340 | PATROL | 0
0.583 | 0.0338 | 0.0340 | PATROL | 0
0.617 | 0.0341 | 0.0340 | PATROL | 0
0.651 | 0.0340 | 0.0340 | PATROL | 0
0.685 | 0.0338 | 0.0340 | PATROL | 0
0.719 | 0.0341 | 0.0340 | PATROL | 0
0.753 | 0.0341 | 0.0340 | PATROL | 0
0.787 | 0.0342 | 0.0340 | PATROL | 0
0.821 | 0.0340 | 0.0340 | PATROL | 0
0.855 | 0.0339 | 0.0340 | PATROL | 0
0.889 | 0.0340 | 0.0340 | PATROL | 0
0.923 | 0.0340 | 0.0340 | PATROL | 0
0.957 | 0.0341 | 0.0340 | PATROL | 0
0.991 | 0.0340 | 0.0340 | PATROL | 0
1.025 | 0.0339 | 0.0340 | PATROL | 0
1.059 | 0.0341 | 0.0340 | PATROL | 0
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
