YourFath3r253/tennisball-picking/experiments/實驗數據/run124/dt_debug.csv

t | wall_dt | sim_dt | state | dropped
0.071 | 0.0340 | 0.0340 | PATROL | 0
0.105 | 0.0340 | 0.0340 | PATROL | 0
0.139 | 0.0339 | 0.0340 | PATROL | 0
0.173 | 0.0343 | 0.0340 | PATROL | 0
0.207 | 0.0340 | 0.0340 | PATROL | 0
0.241 | 0.0339 | 0.0340 | PATROL | 0
0.275 | 0.0338 | 0.0340 | PATROL | 0
0.309 | 0.0341 | 0.0340 | PATROL | 0
0.343 | 0.0339 | 0.0340 | PATROL | 0
0.377 | 0.0341 | 0.0340 | PATROL | 0
0.411 | 0.0342 | 0.0340 | PATROL | 0
0.445 | 0.0340 | 0.0340 | PATROL | 0
0.479 | 0.0339 | 0.0340 | PATROL | 0
0.513 | 0.0341 | 0.0340 | PATROL | 0
0.547 | 0.0340 | 0.0340 | PATROL | 0
0.581 | 0.0339 | 0.0340 | PATROL | 0
0.615 | 0.0341 | 0.0340 | PATROL | 0
0.649 | 0.0340 | 0.0340 | PATROL | 0
0.683 | 0.0340 | 0.0340 | PATROL | 0
0.717 | 0.0340 | 0.0340 | PATROL | 0
0.751 | 0.0342 | 0.0340 | PATROL | 0
0.785 | 0.0339 | 0.0340 | PATROL | 0
0.819 | 0.0342 | 0.0340 | PATROL | 0
0.853 | 0.0338 | 0.0340 | PATROL | 0
0.887 | 0.0341 | 0.0340 | PATROL | 0
0.921 | 0.0340 | 0.0340 | PATROL | 0
0.955 | 0.0341 | 0.0340 | PATROL | 0
0.989 | 0.0337 | 0.0340 | PATROL | 0
1.023 | 0.0343 | 0.0340 | PATROL | 0
1.057 | 0.0342 | 0.0340 | PATROL | 0
1.091 | 0.0339 | 0.0340 | PATROL | 0
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
