YourFath3r253/tennisball-picking/experiments/實驗數據/run125/dt_debug.csv

t | wall_dt | sim_dt | state | dropped
0.048 | 0.0342 | 0.0340 | PATROL | 0
0.082 | 0.0338 | 0.0340 | PATROL | 0
0.116 | 0.0341 | 0.0340 | PATROL | 0
0.150 | 0.0339 | 0.0340 | PATROL | 0
0.184 | 0.0341 | 0.0340 | PATROL | 0
0.218 | 0.0341 | 0.0340 | PATROL | 0
0.252 | 0.0339 | 0.0340 | PATROL | 0
0.286 | 0.0341 | 0.0340 | PATROL | 0
0.320 | 0.0339 | 0.0340 | PATROL | 0
0.354 | 0.0340 | 0.0340 | PATROL | 0
0.388 | 0.0341 | 0.0340 | PATROL | 0
0.423 | 0.0342 | 0.0340 | PATROL | 0
0.457 | 0.0339 | 0.0340 | PATROL | 0
0.491 | 0.0340 | 0.0340 | PATROL | 0
0.525 | 0.0342 | 0.0340 | PATROL | 0
0.559 | 0.0340 | 0.0340 | PATROL | 0
0.593 | 0.0344 | 0.0340 | PATROL | 0
0.627 | 0.0336 | 0.0340 | PATROL | 0
0.661 | 0.0341 | 0.0340 | PATROL | 0
0.695 | 0.0339 | 0.0340 | PATROL | 0
0.729 | 0.0338 | 0.0340 | PATROL | 0
0.763 | 0.0341 | 0.0340 | PATROL | 0
0.797 | 0.0339 | 0.0340 | PATROL | 0
0.831 | 0.0340 | 0.0340 | PATROL | 0
0.865 | 0.0341 | 0.0340 | PATROL | 0
0.899 | 0.0340 | 0.0340 | PATROL | 0
0.933 | 0.0341 | 0.0340 | PATROL | 0
0.967 | 0.0338 | 0.0340 | PATROL | 0
1.001 | 0.0345 | 0.0340 | PATROL | 0
1.035 | 0.0336 | 0.0340 | PATROL | 0
1.069 | 0.0341 | 0.0340 | PATROL | 0
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
