YourFath3r253/tennisball-picking/experiments/實驗數據/run126/dt_debug.csv

t | wall_dt | sim_dt | state | dropped
0.068 | 0.0340 | 0.0340 | PATROL | 0
0.102 | 0.0339 | 0.0340 | PATROL | 0
0.136 | 0.0339 | 0.0340 | PATROL | 0
0.170 | 0.0339 | 0.0340 | PATROL | 0
0.204 | 0.0340 | 0.0340 | PATROL | 0
0.238 | 0.0339 | 0.0340 | PATROL | 0
0.272 | 0.0342 | 0.0340 | PATROL | 0
0.306 | 0.0339 | 0.0340 | PATROL | 0
0.340 | 0.0339 | 0.0340 | PATROL | 0
0.374 | 0.0340 | 0.0340 | PATROL | 0
0.408 | 0.0342 | 0.0340 | PATROL | 0
0.442 | 0.0338 | 0.0340 | PATROL | 0
0.476 | 0.0342 | 0.0340 | PATROL | 0
0.510 | 0.0340 | 0.0340 | PATROL | 0
0.544 | 0.0340 | 0.0340 | PATROL | 0
0.578 | 0.0340 | 0.0340 | PATROL | 0
0.612 | 0.0340 | 0.0340 | PATROL | 0
0.646 | 0.0341 | 0.0340 | PATROL | 0
0.680 | 0.0338 | 0.0340 | PATROL | 0
0.714 | 0.0341 | 0.0340 | PATROL | 0
0.748 | 0.0340 | 0.0340 | PATROL | 0
0.782 | 0.0340 | 0.0340 | PATROL | 0
0.816 | 0.0341 | 0.0340 | PATROL | 0
0.850 | 0.0340 | 0.0340 | PATROL | 0
0.884 | 0.0340 | 0.0340 | PATROL | 0
0.918 | 0.0340 | 0.0340 | PATROL | 0
0.952 | 0.0339 | 0.0340 | PATROL | 0
0.986 | 0.0341 | 0.0340 | PATROL | 0
1.020 | 0.0340 | 0.0340 | PATROL | 0
1.054 | 0.0341 | 0.0340 | PATROL | 0
1.088 | 0.0340 | 0.0340 | PATROL | 0
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
