YourFath3r253/tennisball-picking/experiments/實驗數據/run127/dt_debug.csv

t | wall_dt | sim_dt | state | dropped
0.063 | 0.0343 | 0.0340 | PATROL | 0
0.097 | 0.0340 | 0.0340 | PATROL | 0
0.131 | 0.0338 | 0.0340 | PATROL | 0
0.165 | 0.0338 | 0.0340 | PATROL | 0
0.199 | 0.0343 | 0.0340 | PATROL | 0
0.233 | 0.0341 | 0.0340 | PATROL | 0
0.267 | 0.0338 | 0.0340 | PATROL | 0
0.301 | 0.0340 | 0.0340 | PATROL | 0
0.335 | 0.0341 | 0.0340 | PATROL | 0
0.369 | 0.0340 | 0.0340 | PATROL | 0
0.403 | 0.0339 | 0.0340 | PATROL | 0
0.437 | 0.0340 | 0.0340 | PATROL | 0
0.471 | 0.0341 | 0.0340 | PATROL | 0
0.505 | 0.0342 | 0.0340 | PATROL | 0
0.539 | 0.0341 | 0.0340 | PATROL | 0
0.573 | 0.0338 | 0.0340 | PATROL | 0
0.607 | 0.0342 | 0.0340 | PATROL | 0
0.641 | 0.0339 | 0.0340 | PATROL | 0
0.675 | 0.0342 | 0.0340 | PATROL | 0
0.709 | 0.0340 | 0.0340 | PATROL | 0
0.743 | 0.0339 | 0.0340 | PATROL | 0
0.777 | 0.0340 | 0.0340 | PATROL | 0
0.811 | 0.0341 | 0.0340 | PATROL | 0
0.845 | 0.0340 | 0.0340 | PATROL | 0
0.879 | 0.0340 | 0.0340 | PATROL | 0
0.913 | 0.0340 | 0.0340 | PATROL | 0
0.947 | 0.0339 | 0.0340 | PATROL | 0
0.981 | 0.0341 | 0.0340 | PATROL | 0
1.015 | 0.0340 | 0.0340 | PATROL | 0
1.049 | 0.0341 | 0.0340 | PATROL | 0
1.084 | 0.0342 | 0.0340 | PATROL | 0
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
