YourFath3r253/tennisball-picking/experiments/實驗數據/run128/dt_debug.csv

t | wall_dt | sim_dt | state | dropped
0.057 | 0.0339 | 0.0340 | PATROL | 0
0.091 | 0.0339 | 0.0340 | PATROL | 0
0.125 | 0.0340 | 0.0340 | PATROL | 0
0.159 | 0.0339 | 0.0340 | PATROL | 0
0.193 | 0.0339 | 0.0340 | PATROL | 0
0.227 | 0.0342 | 0.0340 | PATROL | 0
0.261 | 0.0339 | 0.0340 | PATROL | 0
0.295 | 0.0341 | 0.0340 | PATROL | 0
0.329 | 0.0340 | 0.0340 | PATROL | 0
0.363 | 0.0338 | 0.0340 | PATROL | 0
0.398 | 0.0343 | 0.0340 | PATROL | 0
0.431 | 0.0338 | 0.0340 | PATROL | 0
0.465 | 0.0341 | 0.0340 | PATROL | 0
0.499 | 0.0340 | 0.0340 | PATROL | 0
0.533 | 0.0339 | 0.0340 | PATROL | 0
0.567 | 0.0341 | 0.0340 | PATROL | 0
0.601 | 0.0341 | 0.0340 | PATROL | 0
0.636 | 0.0341 | 0.0340 | PATROL | 0
0.669 | 0.0338 | 0.0340 | PATROL | 0
0.703 | 0.0340 | 0.0340 | PATROL | 0
0.737 | 0.0341 | 0.0340 | PATROL | 0
0.772 | 0.0341 | 0.0340 | PATROL | 0
0.806 | 0.0340 | 0.0340 | PATROL | 0
0.840 | 0.0341 | 0.0340 | PATROL | 0
0.874 | 0.0340 | 0.0340 | PATROL | 0
0.908 | 0.0341 | 0.0340 | PATROL | 0
0.942 | 0.0339 | 0.0340 | PATROL | 0
0.976 | 0.0340 | 0.0340 | PATROL | 0
1.009 | 0.0339 | 0.0340 | PATROL | 0
1.043 | 0.0340 | 0.0340 | PATROL | 0
1.077 | 0.0340 | 0.0340 | PATROL | 0
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
