YourFath3r253/tennisball-picking/experiments/實驗數據/run129/dt_debug.csv

t | wall_dt | sim_dt | state | dropped
0.060 | 0.0341 | 0.0340 | PATROL | 0
0.094 | 0.0336 | 0.0340 | PATROL | 0
0.128 | 0.0338 | 0.0340 | PATROL | 0
0.162 | 0.0340 | 0.0340 | PATROL | 0
0.196 | 0.0339 | 0.0340 | PATROL | 0
0.230 | 0.0339 | 0.0340 | PATROL | 0
0.264 | 0.0341 | 0.0340 | PATROL | 0
0.298 | 0.0342 | 0.0340 | PATROL | 0
0.332 | 0.0337 | 0.0340 | PATROL | 0
0.366 | 0.0341 | 0.0340 | PATROL | 0
0.400 | 0.0341 | 0.0340 | PATROL | 0
0.434 | 0.0340 | 0.0340 | PATROL | 0
0.468 | 0.0339 | 0.0340 | PATROL | 0
0.502 | 0.0342 | 0.0340 | PATROL | 0
0.536 | 0.0338 | 0.0340 | PATROL | 0
0.570 | 0.0340 | 0.0340 | PATROL | 0
0.604 | 0.0342 | 0.0340 | PATROL | 0
0.638 | 0.0340 | 0.0340 | PATROL | 0
0.672 | 0.0341 | 0.0340 | PATROL | 0
0.706 | 0.0338 | 0.0340 | PATROL | 0
0.740 | 0.0342 | 0.0340 | PATROL | 0
0.774 | 0.0341 | 0.0340 | PATROL | 0
0.808 | 0.0341 | 0.0340 | PATROL | 0
0.842 | 0.0339 | 0.0340 | PATROL | 0
0.876 | 0.0339 | 0.0340 | PATROL | 0
0.910 | 0.0340 | 0.0340 | PATROL | 0
0.944 | 0.0339 | 0.0340 | PATROL | 0
0.978 | 0.0341 | 0.0340 | PATROL | 0
1.012 | 0.0340 | 0.0340 | PATROL | 0
1.046 | 0.0340 | 0.0340 | PATROL | 0
1.080 | 0.0341 | 0.0340 | PATROL | 0
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
