YourFath3r253/tennisball-picking/experiments/實驗數據/run130/dt_debug.csv

t | wall_dt | sim_dt | state | dropped
0.055 | 0.0339 | 0.0340 | PATROL | 0
0.089 | 0.0343 | 0.0340 | PATROL | 0
0.123 | 0.0339 | 0.0340 | PATROL | 0
0.157 | 0.0340 | 0.0340 | PATROL | 0
0.191 | 0.0341 | 0.0340 | PATROL | 0
0.225 | 0.0339 | 0.0340 | PATROL | 0
0.259 | 0.0340 | 0.0340 | PATROL | 0
0.293 | 0.0339 | 0.0340 | PATROL | 0
0.327 | 0.0344 | 0.0340 | PATROL | 0
0.361 | 0.0338 | 0.0340 | PATROL | 0
0.395 | 0.0340 | 0.0340 | PATROL | 0
0.429 | 0.0339 | 0.0340 | PATROL | 0
0.463 | 0.0341 | 0.0340 | PATROL | 0
0.497 | 0.0342 | 0.0340 | PATROL | 0
0.531 | 0.0339 | 0.0340 | PATROL | 0
0.565 | 0.0340 | 0.0340 | PATROL | 0
0.599 | 0.0341 | 0.0340 | PATROL | 0
0.633 | 0.0339 | 0.0340 | PATROL | 0
0.667 | 0.0340 | 0.0340 | PATROL | 0
0.701 | 0.0341 | 0.0340 | PATROL | 0
0.735 | 0.0340 | 0.0340 | PATROL | 0
0.769 | 0.0339 | 0.0340 | PATROL | 0
0.803 | 0.0341 | 0.0340 | PATROL | 0
0.838 | 0.0343 | 0.0340 | PATROL | 0
0.871 | 0.0336 | 0.0340 | PATROL | 0
0.906 | 0.0344 | 0.0340 | PATROL | 0
0.939 | 0.0337 | 0.0340 | PATROL | 0
0.974 | 0.0342 | 0.0340 | PATROL | 0
1.007 | 0.0339 | 0.0340 | PATROL | 0
1.041 | 0.0340 | 0.0340 | PATROL | 0
1.075 | 0.0338 | 0.0340 | PATROL | 0
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
