YourFath3r253/tennisball-picking/experiments/實驗數據/run131/dt_debug.csv

t | wall_dt | sim_dt | state | dropped
0.070 | 0.0336 | 0.0340 | PATROL | 0
0.103 | 0.0336 | 0.0340 | PATROL | 0
0.137 | 0.0338 | 0.0340 | PATROL | 0
0.171 | 0.0337 | 0.0340 | PATROL | 0
0.205 | 0.0339 | 0.0340 | PATROL | 0
0.239 | 0.0339 | 0.0340 | PATROL | 0
0.273 | 0.0339 | 0.0340 | PATROL | 0
0.307 | 0.0341 | 0.0340 | PATROL | 0
0.341 | 0.0340 | 0.0340 | PATROL | 0
0.375 | 0.0340 | 0.0340 | PATROL | 0
0.409 | 0.0341 | 0.0340 | PATROL | 0
0.443 | 0.0339 | 0.0340 | PATROL | 0
0.477 | 0.0339 | 0.0340 | PATROL | 0
0.511 | 0.0340 | 0.0340 | PATROL | 0
0.545 | 0.0343 | 0.0340 | PATROL | 0
0.579 | 0.0339 | 0.0340 | PATROL | 0
0.613 | 0.0340 | 0.0340 | PATROL | 0
0.647 | 0.0339 | 0.0340 | PATROL | 0
0.681 | 0.0341 | 0.0340 | PATROL | 0
0.715 | 0.0340 | 0.0340 | PATROL | 0
0.749 | 0.0340 | 0.0340 | PATROL | 0
0.783 | 0.0340 | 0.0340 | PATROL | 0
0.817 | 0.0339 | 0.0340 | PATROL | 0
0.851 | 0.0341 | 0.0340 | PATROL | 0
0.885 | 0.0341 | 0.0340 | PATROL | 0
0.919 | 0.0345 | 0.0340 | PATROL | 0
0.953 | 0.0337 | 0.0340 | PATROL | 0
0.987 | 0.0339 | 0.0340 | PATROL | 0
1.021 | 0.0340 | 0.0340 | PATROL | 0
1.055 | 0.0340 | 0.0340 | PATROL | 0
1.089 | 0.0338 | 0.0340 | PATROL | 0
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
