YourFath3r253/tennisball-picking/experiments/實驗數據/run145/dt_debug.csv

t | wall_dt | sim_dt | state | dropped
0.053 | 0.0003 | 0.0340 | PATROL | 0
0.085 | 0.0325 | 0.0340 | PATROL | 0
0.119 | 0.0338 | 0.0340 | PATROL | 0
0.153 | 0.0338 | 0.0340 | PATROL | 0
0.187 | 0.0338 | 0.0340 | PATROL | 0
0.221 | 0.0343 | 0.0340 | PATROL | 0
0.255 | 0.0336 | 0.0340 | PATROL | 0
0.289 | 0.0342 | 0.0340 | PATROL | 0
0.323 | 0.0343 | 0.0340 | PATROL | 0
0.357 | 0.0339 | 0.0340 | PATROL | 0
0.391 | 0.0341 | 0.0340 | PATROL | 0
0.425 | 0.0340 | 0.0340 | PATROL | 0
0.460 | 0.0346 | 0.0340 | PATROL | 0
0.493 | 0.0337 | 0.0340 | PATROL | 0
0.528 | 0.0344 | 0.0340 | PATROL | 0
0.562 | 0.0341 | 0.0340 | PATROL | 0
0.596 | 0.0342 | 0.0340 | PATROL | 0
0.630 | 0.0341 | 0.0340 | PATROL | 0
0.664 | 0.0339 | 0.0340 | PATROL | 0
0.698 | 0.0342 | 0.0340 | PATROL | 0
0.732 | 0.0338 | 0.0340 | PATROL | 0
0.766 | 0.0341 | 0.0340 | PATROL | 0
0.801 | 0.0343 | 0.0340 | PATROL | 0
0.835 | 0.0345 | 0.0340 | PATROL | 0
0.873 | 0.0375 | 0.0340 | PATROL | 0
0.906 | 0.0330 | 0.0340 | PATROL | 0
0.939 | 0.0333 | 0.0340 | PATROL | 0
0.973 | 0.0340 | 0.0340 | PATROL | 0
1.007 | 0.0337 | 0.0340 | PATROL | 0
1.041 | 0.0339 | 0.0340 | PATROL | 0
1.075 | 0.0344 | 0.0340 | PATROL | 0
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
