YourFath3r253/tennisball-picking/experiments/實驗數據/run146/dt_debug.csv

t | wall_dt | sim_dt | state | dropped
0.159 | 0.0003 | 0.0340 | PATROL | 0
0.160 | 0.0005 | 0.0340 | PATROL | 0
0.192 | 0.0325 | 0.0340 | PATROL | 0
0.226 | 0.0342 | 0.0340 | PATROL | 0
0.260 | 0.0340 | 0.0340 | PATROL | 0
0.294 | 0.0341 | 0.0340 | PATROL | 0
0.328 | 0.0340 | 0.0340 | PATROL | 0
0.362 | 0.0338 | 0.0340 | PATROL | 0
0.397 | 0.0352 | 0.0340 | PATROL | 0
0.431 | 0.0338 | 0.0340 | PATROL | 0
0.465 | 0.0337 | 0.0340 | PATROL | 0
0.499 | 0.0344 | 0.0340 | PATROL | 0
0.533 | 0.0340 | 0.0340 | PATROL | 0
0.567 | 0.0342 | 0.0340 | PATROL | 0
0.602 | 0.0343 | 0.0340 | PATROL | 0
0.636 | 0.0341 | 0.0340 | PATROL | 0
0.670 | 0.0339 | 0.0340 | PATROL | 0
0.704 | 0.0340 | 0.0340 | PATROL | 0
0.738 | 0.0344 | 0.0340 | PATROL | 0
0.772 | 0.0337 | 0.0340 | PATROL | 0
0.806 | 0.0343 | 0.0340 | PATROL | 0
0.840 | 0.0341 | 0.0340 | PATROL | 0
0.874 | 0.0337 | 0.0340 | PATROL | 0
0.908 | 0.0344 | 0.0340 | PATROL | 0
0.943 | 0.0343 | 0.0340 | PATROL | 0
0.977 | 0.0340 | 0.0340 | PATROL | 0
1.011 | 0.0345 | 0.0340 | PATROL | 0
1.045 | 0.0342 | 0.0340 | PATROL | 0
1.079 | 0.0337 | 0.0340 | PATROL | 0
1.114 | 0.0345 | 0.0340 | PATROL | 0
1.148 | 0.0342 | 0.0340 | PATROL | 0
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
