YourFath3r253/tennisball-picking/experiments/實驗數據/run147/dt_debug.csv

t | wall_dt | sim_dt | state | dropped
0.082 | 0.0328 | 0.0340 | PATROL | 0
0.116 | 0.0342 | 0.0340 | PATROL | 0
0.150 | 0.0343 | 0.0340 | PATROL | 0
0.185 | 0.0342 | 0.0340 | PATROL | 0
0.219 | 0.0339 | 0.0340 | PATROL | 0
0.253 | 0.0343 | 0.0340 | PATROL | 0
0.287 | 0.0343 | 0.0340 | PATROL | 0
0.321 | 0.0343 | 0.0340 | PATROL | 0
0.355 | 0.0339 | 0.0340 | PATROL | 0
0.390 | 0.0343 | 0.0340 | PATROL | 0
0.423 | 0.0338 | 0.0340 | PATROL | 0
0.458 | 0.0343 | 0.0340 | PATROL | 0
0.492 | 0.0339 | 0.0340 | PATROL | 0
0.526 | 0.0340 | 0.0340 | PATROL | 0
0.560 | 0.0341 | 0.0340 | PATROL | 0
0.594 | 0.0339 | 0.0340 | PATROL | 0
0.628 | 0.0343 | 0.0340 | PATROL | 0
0.662 | 0.0340 | 0.0340 | PATROL | 0
0.696 | 0.0343 | 0.0340 | PATROL | 0
0.731 | 0.0350 | 0.0340 | PATROL | 0
0.765 | 0.0334 | 0.0340 | PATROL | 0
0.799 | 0.0344 | 0.0340 | PATROL | 0
0.833 | 0.0338 | 0.0340 | PATROL | 0
0.867 | 0.0343 | 0.0340 | PATROL | 0
0.901 | 0.0341 | 0.0340 | PATROL | 0
0.936 | 0.0342 | 0.0340 | PATROL | 0
0.970 | 0.0341 | 0.0340 | PATROL | 0
1.004 | 0.0343 | 0.0340 | PATROL | 0
1.038 | 0.0341 | 0.0340 | PATROL | 0
1.072 | 0.0340 | 0.0340 | PATROL | 0
1.106 | 0.0343 | 0.0340 | PATROL | 0
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
