YourFath3r253/tennisball-picking/experiments/實驗數據/run154/dt_debug.csv

t | wall_dt | sim_dt | state | dropped
0.280 | 0.0346 | 0.0340 | ALIGN | 0
0.314 | 0.0336 | 0.0340 | ALIGN | 0
0.348 | 0.0344 | 0.0340 | ALIGN | 0
0.382 | 0.0342 | 0.0340 | ALIGN | 0
0.416 | 0.0339 | 0.0340 | ALIGN | 0
0.451 | 0.0345 | 0.0340 | ALIGN | 0
0.485 | 0.0344 | 0.0340 | ALIGN | 0
0.519 | 0.0344 | 0.0340 | ALIGN | 0
0.554 | 0.0349 | 0.0340 | ALIGN | 0
0.588 | 0.0339 | 0.0340 | ALIGN | 0
0.622 | 0.0339 | 0.0340 | ALIGN | 0
0.656 | 0.0343 | 0.0340 | ALIGN | 0
0.691 | 0.0341 | 0.0340 | ALIGN | 0
0.725 | 0.0348 | 0.0340 | PATROL | 0
0.759 | 0.0340 | 0.0340 | PATROL | 0
0.793 | 0.0339 | 0.0340 | PATROL | 0
0.828 | 0.0343 | 0.0340 | PATROL | 0
0.862 | 0.0343 | 0.0340 | PATROL | 0
0.896 | 0.0343 | 0.0340 | PATROL | 0
0.930 | 0.0341 | 0.0340 | PATROL | 0
0.964 | 0.0340 | 0.0340 | PATROL | 0
0.998 | 0.0340 | 0.0340 | PATROL | 0
1.032 | 0.0341 | 0.0340 | PATROL | 0
1.066 | 0.0339 | 0.0340 | PATROL | 0
1.101 | 0.0342 | 0.0340 | PATROL | 0
1.135 | 0.0341 | 0.0340 | PATROL | 0
1.168 | 0.0339 | 0.0340 | PATROL | 0
1.203 | 0.0344 | 0.0340 | PATROL | 0
1.238 | 0.0346 | 0.0340 | PATROL | 0
1.272 | 0.0342 | 0.0340 | PATROL | 0
1.306 | 0.0343 | 0.0340 | PATROL | 0
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
