YourFath3r253/tennisball-picking/experiments/實驗數據/run155/dt_debug.csv

t | wall_dt | sim_dt | state | dropped
0.124 | 0.0004 | 0.0340 | PATROL | 0
0.125 | 0.0004 | 0.0340 | PATROL | 0
0.157 | 0.0325 | 0.0340 | PATROL | 0
0.191 | 0.0339 | 0.0340 | PATROL | 0
0.225 | 0.0341 | 0.0340 | PATROL | 0
0.259 | 0.0340 | 0.0340 | PATROL | 0
0.293 | 0.0340 | 0.0340 | PATROL | 0
0.328 | 0.0343 | 0.0340 | PATROL | 0
0.362 | 0.0345 | 0.0340 | PATROL | 0
0.396 | 0.0343 | 0.0340 | PATROL | 0
0.431 | 0.0342 | 0.0340 | PATROL | 0
0.465 | 0.0343 | 0.0340 | PATROL | 0
0.499 | 0.0345 | 0.0340 | PATROL | 0
0.533 | 0.0340 | 0.0340 | PATROL | 0
0.567 | 0.0340 | 0.0340 | PATROL | 0
0.602 | 0.0343 | 0.0340 | PATROL | 0
0.635 | 0.0337 | 0.0340 | PATROL | 0
0.670 | 0.0347 | 0.0340 | PATROL | 0
0.704 | 0.0342 | 0.0340 | PATROL | 0
0.738 | 0.0342 | 0.0340 | PATROL | 0
0.772 | 0.0339 | 0.0340 | PATROL | 0
0.807 | 0.0341 | 0.0340 | PATROL | 0
0.841 | 0.0340 | 0.0340 | PATROL | 0
0.876 | 0.0351 | 0.0340 | PATROL | 0
0.910 | 0.0341 | 0.0340 | PATROL | 0
0.944 | 0.0345 | 0.0340 | PATROL | 0
0.978 | 0.0341 | 0.0340 | PATROL | 0
1.012 | 0.0342 | 0.0340 | PATROL | 0
1.046 | 0.0337 | 0.0340 | PATROL | 0
1.081 | 0.0344 | 0.0340 | PATROL | 0
1.115 | 0.0339 | 0.0340 | PATROL | 0
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
