YourFath3r253/tennisball-picking/experiments/實驗數據/run156/dt_debug.csv

t | wall_dt | sim_dt | state | dropped
0.073 | 0.0141 | 0.0340 | PATROL | 0
0.106 | 0.0337 | 0.0340 | PATROL | 0
0.140 | 0.0342 | 0.0340 | PATROL | 0
0.175 | 0.0344 | 0.0340 | PATROL | 0
0.209 | 0.0338 | 0.0340 | ALIGN | 0
0.247 | 0.0381 | 0.0340 | ALIGN | 0
0.280 | 0.0330 | 0.0340 | ALIGN | 0
0.313 | 0.0333 | 0.0340 | ALIGN | 0
0.346 | 0.0333 | 0.0340 | ALIGN | 0
0.380 | 0.0336 | 0.0340 | ALIGN | 0
0.414 | 0.0340 | 0.0340 | ALIGN | 0
0.448 | 0.0341 | 0.0340 | ALIGN | 0
0.483 | 0.0346 | 0.0340 | ALIGN | 0
0.517 | 0.0343 | 0.0340 | ALIGN | 0
0.551 | 0.0341 | 0.0340 | ALIGN | 0
0.585 | 0.0340 | 0.0340 | ALIGN | 0
0.620 | 0.0347 | 0.0340 | ALIGN | 0
0.654 | 0.0344 | 0.0340 | ALIGN | 0
0.688 | 0.0342 | 0.0340 | ALIGN | 0
0.722 | 0.0338 | 0.0340 | ALIGN | 0
0.756 | 0.0343 | 0.0340 | ALIGN | 0
0.791 | 0.0344 | 0.0340 | ALIGN | 0
0.825 | 0.0340 | 0.0340 | ALIGN | 0
0.859 | 0.0344 | 0.0340 | ALIGN | 0
0.893 | 0.0343 | 0.0340 | ALIGN | 0
0.928 | 0.0343 | 0.0340 | ALIGN | 0
0.962 | 0.0346 | 0.0340 | PATROL | 0
0.997 | 0.0343 | 0.0340 | PATROL | 0
1.030 | 0.0339 | 0.0340 | PATROL | 0
1.065 | 0.0341 | 0.0340 | PATROL | 0
1.099 | 0.0342 | 0.0340 | PATROL | 0
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
