YourFath3r253/tennisball-picking/實體車子程式碼/ballpicker_STM32專案/Core/Src/main.c

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
/* Includes ------------------------------------------------------------------*/
#include "main.h"

/* USER CODE BEGIN Includes */
#include <string.h>
#include <stdio.h>
/* USER CODE END Includes */

/* USER CODE BEGIN PTD */
typedef struct {
    float target_rpm;  // 目標轉速
    float actual_rpm;  // 實際轉速
    float error;       // 當前誤差
    float error_last;  // 上次誤差
    float integral;    // 誤差積分 (I項累積)

    float Kp;          // 比例參數
    float Ki;          // 積分參數
    float Kd;          // 微分參數

    float out_max;     // PWM 輸出上限 (例如 1000)
} PID_Controller;
/* USER CODE END PTD */

TIM_HandleTypeDef htim1;
TIM_HandleTypeDef htim2;
TIM_HandleTypeDef htim3;
TIM_HandleTypeDef htim4;
TIM_HandleTypeDef htim6;

UART_HandleTypeDef huart2;

/* USER CODE BEGIN PV */
uint8_t rx_byte;          // 儲存每次接收到的 1 個位元組
uint8_t rx_buffer[100];   // 接收緩衝區
volatile uint8_t rx_index = 0;     // 緩衝區索引
volatile uint8_t command_ready = 0;// 封包接收完成標誌
// 🚀 新增這行：宣告防卡球狀態變數，讓下面的 if (dejam_active == 0) 可以順利執行！
uint8_t dejam_active = 0;
// 🚀 新增：用來儲存 Jetson 傳來的球距離 (cm) 與 角度 (度)
float ball_distance_cm = 0.0f;
float ball_angle_deg = 0.0f;
// 宣告變數來儲存左右輪的編碼器數值
int16_t chassis_enc_left = 0;
int16_t chassis_enc_right = 0;
// 新增：儲存計算後的真實轉速 (RPM)
float chassis_rpm_left = 0.0;
float chassis_rpm_right = 0.0;
// 一階低通濾波後的轉速變數
// ==========================================
float rpm_left_filter = 0.0f;
float rpm_right_filter = 0.0f;
float pwm_cmd_left = 0.0f;
float pwm_cmd_right = 0.0f;
// 新增：馬達物理規格常數 (基本解析度 11 * 減速比 30 * 4倍頻)
const float ENCODER_RESOLUTION = 11.0f * 18.8f * 4.0f;
PID_Controller pid_left;
PID_Controller pid_right;
// 底盤機械幾何尺寸 (請依照你實際量測的尺寸修改)
const float WHEEL_RADIUS = 0.052f; // 輪胎半徑 35mm (0.035公尺)
const float WHEEL_TRACK  = 0.243f;  // 左右輪心間距 250mm (0.25公尺)

// 💡 里程計核心：記錄車體當前旋轉的總角度 (度數)
float chassis_angle_deg = 0.0f;
uint8_t avoiding = 0;          // 避線狀態標誌 (1: 正在避線, 0: 正常)
uint32_t avoid_start_time = 0; // 避線煞車的起始時間
uint8_t has_ball = 0;          // 記錄目前畫面上是否有球 (1: 有, 0: 沒有)
// [Sean 2026-10-30] 連續 P 轉向參數 (9/21 舊車實測：Kp=0.3 平均 7.6 s 無 overshoot，Kp=0.6 約 3.5 s)
const float STEER_KP = 1.0f;          // rpm / 度 [Sean 2026-11-10] 網球場地板比實驗室粗糙，0.4 → 1.0 (之前: 0.6 在實驗室修正過頭降為 0.4)
const float STEER_WHEEL_MAX = 45.0f;  // 單輪 rpm 上限
// [Sean 2026-10-30] 速度集中在這裡調。修好加減速後輪子真的會跑到目標，B 原本的 120/125 太快；
// 改回修正前實測真正跑到的速度 (直走 40~58、原地轉約 35 rpm)
const float SPEED_FORWARD = 50.0f;   // 直走 / 巡邏 / 盲衝 (原 120)
const float SPEED_DASH    = 55.0f;   // 30cm 內直衝 (原 125)
const float SPEED_TURN    = 40.0f;   // 避線原地轉 TurnPrecise (原 120)
/* USER CODE END PV */

void SystemClock_Config(void);
static void MX_GPIO_Init(void);
static void MX_USART2_UART_Init(void);
static void MX_TIM2_Init(void);
static void MX_TIM1_Init(void);
static void MX_TIM3_Init(void);
static void MX_TIM4_Init(void);
static void MX_TIM6_Init(void);
/* USER CODE BEGIN PFP */
void Chassis_SpinLeft(float turn_rpm);
void Chassis_SpinRight(float turn_rpm);
void Chassis_Forward(float forward_rpm);
void Chassis_Stop(void);
void Chassis_TurnPrecise(float target_angle_change, float spin_rpm);
void Chassis_SteerP(float left_rpm, float right_rpm);
void Telemetry_Poll(void);
/* USER CODE END PFP */

/**
  * @brief  The application entry point.
  * @retval int
  */
int main(void)
{

  /* MCU Configuration--------------------------------------------------------*/

  /* Reset of all peripherals, Initializes the Flash interface and the Systick. */
  HAL_Init();

  /* Configure the system clock */
  SystemClock_Config();

  /* Initialize all configured peripherals */
  MX_GPIO_Init();
  MX_USART2_UART_Init();
  MX_TIM2_Init();
  MX_TIM1_Init();
  MX_TIM3_Init();
  MX_TIM4_Init();
  MX_TIM6_Init();
  /* USER CODE BEGIN 2 */
  // 開啟 USART2 中斷接收，每次只接收 1 個位元組，存入 rx_byte
  HAL_UART_Receive_IT(&huart2, &rx_byte, 1);
  // 1. 設定左輪馬達方向為正轉 (IN1=High, IN2=Low)
    HAL_GPIO_WritePin(GPIOC, L_IN1_Pin, GPIO_PIN_SET);
    HAL_GPIO_WritePin(GPIOC, L_IN2_Pin, GPIO_PIN_RESET);

    // 2. 設定右輪馬達方向為正轉 (IN1=High, IN2=Low)
    HAL_GPIO_WritePin(GPIOC, R_IN1_Pin, GPIO_PIN_SET);
    HAL_GPIO_WritePin(GPIOC, R_IN2_Pin, GPIO_PIN_RESET);

    // 3. 啟動定時器 2 的通道 1 (PA0) 與通道 2 (PA1)
    HAL_TIM_PWM_Start(&htim2, TIM_CHANNEL_1);
    HAL_TIM_PWM_Start(&htim2, TIM_CHANNEL_2);

    // 4. 設定左右滾輪馬達轉速 (若 ARR 改為 1000-1，則 500 代表 50% 轉速)
    __HAL_TIM_SET_COMPARE(&htim2, TIM_CHANNEL_1, 950);
    __HAL_TIM_SET_COMPARE(&htim2, TIM_CHANNEL_2, 950);
    // ==========================================
    // 底盤馬達初始化設定
    // ==========================================

    // 1. 預設底盤馬達方向為正轉 (前進)
    HAL_GPIO_WritePin(GPIOC, CHASSIS_L_IN1_Pin, GPIO_PIN_SET);
    HAL_GPIO_WritePin(GPIOC, CHASSIS_L_IN2_Pin, GPIO_PIN_RESET);
    HAL_GPIO_WritePin(GPIOC, CHASSIS_R_IN1_Pin, GPIO_PIN_SET);
    HAL_GPIO_WritePin(GPIOC, CHASSIS_R_IN2_Pin, GPIO_PIN_RESET);

    // 2. 啟動底盤的 PWM (TIM3 的 Channel 1 與 Channel 2)
    HAL_TIM_PWM_Start(&htim3, TIM_CHANNEL_1);
    HAL_TIM_PWM_Start(&htim3, TIM_CHANNEL_2);

    // 3. 初始轉速設為 0 (避免一開機就暴衝)
    __HAL_TIM_SET_COMPARE(&htim3, TIM_CHANNEL_1, 1000);
    __HAL_TIM_SET_COMPARE(&htim3, TIM_CHANNEL_2, 1000);

    // 4. 啟動底盤的編碼器讀取 (TIM4 與 TIM1)
    HAL_TIM_Encoder_Start(&htim4, TIM_CHANNEL_ALL); // 左輪
    HAL_TIM_Encoder_Start(&htim1, TIM_CHANNEL_ALL); // 右輪
    // 初始化左輪 PID 參數
      pid_left.Kp = 2.0f;       // P參數 (稍後需實機微調)
      pid_left.Ki = 0.4f;      // I參數
      pid_left.Kd = 0.01f;      // D參數
      pid_left.out_max = 1000.0f; // 你的 TIM3 ARR 最大值應該是 1000
      pid_left.integral = 0.0f;
      pid_left.target_rpm = 0.0f; // 先設定一個安全的目標速度：150 RPM

      // 初始化右輪 PID 參數 (可以直接複製左輪體質)
      pid_right = pid_left;

    // 5. 啟動 TIM6 的 10ms 硬體中斷
    HAL_TIM_Base_Start_IT(&htim6);
  /* USER CODE END 2 */

  /* Infinite loop */
      /* USER CODE BEGIN WHILE */
    	uint8_t blind_dash_active = 0;
        uint32_t blind_dash_start_time = 0;
        uint8_t was_seeing_ball = 0; // 💡 新增：用來記錄上一刻是否還有看到球
        uint32_t last_seen_time = 0; // 🚀 新增宣告：記錄最後一次看到球的時間
        float current_avoid_angle = -360.0f;
        int8_t last_avoid_dir = 0;          // [Sean 11/9] 上一次避線轉向方向 (+1 左轉, -1 右轉, 0 = 還沒轉過)
        uint32_t last_turn_end_time = 0;    // [Sean 11/9] 上一次避線轉完的時間
        uint8_t same_dir_used = 0;          // [Sean 11/10] 這一串連續 1 秒內的 EDGE 已經用過一次同向轉
      while (1)
      {
                Telemetry_Poll(); // [Sean] 每 50ms 回傳左右輪目標/實際轉速
                // 偵測 Nucleo 板子上的藍色按鈕是否被按下 (防卡球排除機制)
                if (HAL_GPIO_ReadPin(B1_GPIO_Port, B1_Pin) == GPIO_PIN_RESET)
                {
                    // 左輪反轉、右輪反轉 (吐球)
                    HAL_GPIO_WritePin(L_IN1_GPIO_Port, L_IN1_Pin, GPIO_PIN_RESET);
                    HAL_GPIO_WritePin(L_IN2_GPIO_Port, L_IN2_Pin, GPIO_PIN_SET);
                    HAL_GPIO_WritePin(R_IN1_GPIO_Port, R_IN1_Pin, GPIO_PIN_SET);
                    HAL_GPIO_WritePin(R_IN2_GPIO_Port, R_IN2_Pin, GPIO_PIN_RESET);

                    HAL_Delay(1000);

                    // 恢復正轉
                    HAL_GPIO_WritePin(L_IN1_GPIO_Port, L_IN1_Pin, GPIO_PIN_SET);
                    HAL_GPIO_WritePin(L_IN2_GPIO_Port, L_IN2_Pin, GPIO_PIN_RESET);
                    HAL_GPIO_WritePin(R_IN1_GPIO_Port, R_IN1_Pin, GPIO_PIN_RESET);
                    HAL_GPIO_WritePin(R_IN2_GPIO_Port, R_IN2_Pin, GPIO_PIN_SET);

                    HAL_Delay(500);
                }

                // ==========================================================
                // 🚀 【計時器安全區】放在 while 迴圈內，1000毫秒一到絕對強制轉彎！
                // ==========================================================
                if (blind_dash_active == 1 && (HAL_GetTick() - blind_dash_start_time > 1000))
                {
                    blind_dash_active = 0;    // 時間到，解除直行鎖定！
                }

                /* USER CODE END WHILE */

                /* USER CODE BEGIN 3 */
                // ==========================================================
                // 🚀 第一階段：通訊解析 (只更新變數，不直接操作馬達)
                // ==========================================================
                if (command_ready == 1)
                {

                    // 檢查盲衝是否超時 (1.5秒)
                    if (blind_dash_active && (HAL_GetTick() - blind_dash_start_time > 1500)) {
                        blind_dash_active = 0;
                    }

                    // 【解析 COURT 邊界指令】
                    if (strncmp((char *)rx_buffer, "COURT,", 6) == 0)
                    {
                        char court_status[16] = {0};
                        char court_pos[16] = {0};
                        char court_color[16] = {0};

                        if (sscanf((char *)rx_buffer, "COURT,%15[^,],%15[^,],%15s", court_status, court_pos, court_color) == 3)
                        {
                            // 若收到 EDGE 且當前未在避線流程中，則強制觸發避線！
                            if (strcmp(court_status, "EDGE") == 0 && avoiding == 0)
                            {
                                avoiding = 1;          // 鎖定狀態：進入避線流程
                                has_ball = 0;          // 放棄追球
                                blind_dash_active = 0; // 取消盲衝
                                Chassis_Stop();        // 立刻煞車
                                avoid_start_time = HAL_GetTick(); // 記錄開始煞車時間

                                // 🚀 新增邏輯：根據邊界位置決定逃脫方向
                                // (Chassis_TurnPrecise 規定：正數為左轉，負數為右轉)
                                if (strcmp(court_pos, "LEFT") == 0) {
                                    current_avoid_angle = -240.0f; // 邊界在左，向右轉逃脫 (可依需求改為 -90 或 -180)
                                }
                                else if (strcmp(court_pos, "RIGHT") == 0) {
                                    current_avoid_angle = 240.0f;  // 邊界在右，向左轉逃脫 (可依需求改為 90 或 180)
                                }
                                else {
                                    current_avoid_angle = -360.0f; // CENTER 或 UNKNOWN，維持原本設定
                                }
                                // [Sean 11/9] 轉完 1 秒內又看到邊界 → 跟上一次同方向轉 (角度大小照上面規則)
                                // [Sean 11/10] 連續的情況只同向一次：第 2 次以後照正常規則，超過 1 秒才重新算
                                uint8_t within_1s = (last_avoid_dir != 0 && (HAL_GetTick() - last_turn_end_time) <= 1000);
                                if (within_1s && same_dir_used == 0) {
                                    float avoid_mag = (current_avoid_angle > 0.0f) ? current_avoid_angle : -current_avoid_angle;
                                    current_avoid_angle = (last_avoid_dir > 0) ? avoid_mag : -avoid_mag;
                                    same_dir_used = 1;
                                }
                                else if (!within_1s) {
                                    same_dir_used = 0;
                                }
                            }
                        }
                    }
                    // 【解析 BALL 指令】
                    else if (strncmp((char *)rx_buffer, "BALL,", 5) == 0)
                    {
                        if (sscanf((char *)rx_buffer, "BALL,%f,%f", &ball_distance_cm, &ball_angle_deg) == 2)
                        {
                            has_ball = 1; // 標記為看到球
                            last_seen_time = HAL_GetTick();

                            // 如果距離小於25cm且未在避線，觸發吃球盲衝
                            if (avoiding == 0 && ball_distance_cm <= 25.0f && blind_dash_active == 0)
                            {
                                blind_dash_active = 1;
                                blind_dash_start_time = HAL_GetTick();
                            }
                        }
                    }
                    // 【解析 BALL_OFF / NOBALL 指令】
                    else if (strncmp((char *)rx_buffer, "BALL_OFF", 8) == 0 || strncmp((char *)rx_buffer, "NOBALL", 6) == 0)
                    {
                        has_ball = 0; // 標記為丟失球

                        // 若在極近距離(30cm內)丟失且未在避線，可能是球掉進死角，補發盲衝
                        if (avoiding == 0 && blind_dash_active == 0 && ball_distance_cm > 0.0f && ball_distance_cm <= 30.0f)
                        {
                            blind_dash_active = 1;
                            blind_dash_start_time = HAL_GetTick();
                        }
                    }

                    // 清空快取，準備接收下一筆 Jetson 指令
                    memset((void*)rx_buffer, 0, sizeof(rx_buffer));
                    rx_index = 0;
                    command_ready = 0;
                }

                // ==========================================================
                // 🚀 第二階段：運動控制分流 (避線優先 > 追球 > 巡邏)
                // ==========================================================
                if (avoiding == 1)
                {
                    // --- 避線機動流程 ---
                    if (HAL_GetTick() - avoid_start_time > 500)
                    {
                        // 🚀 改為套用動態決定的角度 current_avoid_angle
                        Chassis_TurnPrecise(current_avoid_angle, SPEED_TURN);
                        last_avoid_dir = (current_avoid_angle > 0.0f) ? 1 : -1; // [Sean 11/9] 記下這次方向與轉完時間
                        last_turn_end_time = HAL_GetTick();
                        avoiding = 0;
                        command_ready = 0;
                        rx_index = 0;
                        memset((void*)rx_buffer, 0, sizeof(rx_buffer));
                        last_seen_time = HAL_GetTick() - 2000;
                    }
                }
                else if (has_ball == 1 || blind_dash_active == 1)
                {
                    // --- 原本的 BALL 追球邏輯 ---
                    if (blind_dash_active)
                    {
                        Chassis_Forward(SPEED_FORWARD); // 盲衝直走吃球
                    }
                    else if (ball_distance_cm <= 30.0f)
                    {
                        Chassis_Forward(SPEED_DASH); // 放棄微調，直接衝
                    }
                    else
                    {
                        // [Sean 2026-10-30] 連續 P 轉向，取代 B 的點放 (轉 200ms、停到 1s)。9/21 舊車實測 Kp=0.6 驗證過。
                        // error = 0 - 角度；y = STEER_KP*error；兩輪各 ±y/2 (單輪上限 STEER_WHEEL_MAX)；只改目標轉速、不清積分
                        float turn_threshold = (ball_distance_cm > 40.0f) ? 6.0f : 4.0f; // 沿用 B 的門檻

                        if (ball_angle_deg > turn_threshold || ball_angle_deg < -turn_threshold)
                        {
                            float error = 0.0f - ball_angle_deg;
                            float half_y = STEER_KP * error / 2.0f;
                            if (half_y > STEER_WHEEL_MAX)  half_y = STEER_WHEEL_MAX;
                            if (half_y < -STEER_WHEEL_MAX) half_y = -STEER_WHEEL_MAX;
                            // 方向照 B 最新版：球在右 (角度>0) 時 SpinRight = 左輪負、右輪正，這裡給同樣正負號
                            // (9/21 舊車接線是 SteerP(-half_y, half_y)，B 改了接線所以相反；燒錄後要實車確認)
                            Chassis_SteerP(half_y, -half_y);
                        }
                        else
                        {
                            Chassis_Forward(SPEED_FORWARD);
                        }
                    }
                }
                else
                {
                    // --- BALL_OFF 巡邏邏輯 ---
                    Chassis_Forward(SPEED_FORWARD);
                }

            } // 結束 while(1) 迴圈 (視縮排而定)
    	                            /* USER CODE END 3 */
}


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
/* USER CODE BEGIN 4 */
// 🚀 請用這段最新帶有「積分分離」的函式，整段覆蓋掉你原本舊的 PID_Calc
float PID_Calc(PID_Controller *pid, float current_rpm) {
    // 1. 計算誤差
    pid->actual_rpm = current_rpm;
    pid->error = pid->target_rpm - pid->actual_rpm;

    // [Sean 2026-10-30] 修改 B 的「動態積分分離」：門檻內 (誤差 < 目標×50%，最少 30) 照 B 原樣全速累積；
    // 門檻外原本會清積分，實測 (yellow_v21_20261030_183626_rpm.csv) 目標 120 時兩輪卡在 40~58 rpm、積分從未啟動。
    // 改成門檻外只累積 15% (不清掉)，讓卡住的輪子積分慢慢長大推過門檻；
    // 另外輸出飽和且誤差還往同方向推時暫停累積 (anti-windup)，積分項最多貢獻 out_max。
    float derivative = pid->error - pid->error_last;
    float dynamic_limit = pid->target_rpm * 0.50f;
    if (dynamic_limit < 0) dynamic_limit = -dynamic_limit;
    if (dynamic_limit < 30.0f) dynamic_limit = 30.0f;
    // 衝過頭 (誤差跟積分反號) 時全速消化積分：v22 實測馬達斷電/卡住時積分累積，上電後衝到 226 rpm
    int in_band = (pid->error < dynamic_limit && pid->error > -dynamic_limit);
    int unwinding = (pid->error * pid->integral < 0.0f);
    float i_inc = (in_band || unwinding) ? pid->error : pid->error * 0.15f;
    float i_limit = (pid->Ki > 0.0f) ? (pid->out_max / pid->Ki) : 0.0f;
    float out_try = (pid->Kp * pid->error) + (pid->Ki * (pid->integral + i_inc)) + (pid->Kd * derivative);
    if (!((out_try > pid->out_max && pid->error > 0.0f) || (out_try < -pid->out_max && pid->error < 0.0f)))
    {
        pid->integral += i_inc;
        if (pid->integral >  i_limit) pid->integral =  i_limit;
        if (pid->integral < -i_limit) pid->integral = -i_limit;
    }

    // 4. 計算總輸出
    float output = (pid->Kp * pid->error) + (pid->Ki * pid->integral) + (pid->Kd * derivative);

    // 5. 更新歷史誤差
    pid->error_last = pid->error;

    // 6. 輸出限幅
    if (output > pid->out_max) output = pid->out_max;
    if (output < -pid->out_max) output = -pid->out_max;

    return output;
}
// 當 TIM6 (10ms) 時間到時，會自動跳進這個函式
void HAL_TIM_PeriodElapsedCallback(TIM_HandleTypeDef *htim)
{
    if (htim->Instance == TIM6)
    {
        // 1. 讀取這 10ms 內累積的脈衝數 (底盤左右輪)
        chassis_enc_left = (int16_t)__HAL_TIM_GET_COUNTER(&htim4);
        chassis_enc_right = -((int16_t)__HAL_TIM_GET_COUNTER(&htim1));

        // 2. 讀完立刻歸零！(這是 M 法測速的核心，你原本漏掉這步)
        __HAL_TIM_SET_COUNTER(&htim4, 0);
        __HAL_TIM_SET_COUNTER(&htim1, 0);

        // (之後要把脈衝數換算成 RPM 的公式，以及 PID 運算都加在這裡)
        // 3. 換算成真實轉速 RPM ( 脈衝數 / 總解析度 * 時間放大倍率 )
        chassis_rpm_left = ((float)chassis_enc_left / ENCODER_RESOLUTION) * 6000.0f;
        chassis_rpm_right = ((float)chassis_enc_right / ENCODER_RESOLUTION) * 6000.0f;
        // 導入口低通濾波器，平滑跳動的訊號
                // ==========================================
                rpm_left_filter = (0.8f * rpm_left_filter) + (0.2f * chassis_rpm_left);
                rpm_right_filter = (0.8f * rpm_right_filter) + (0.2f * chassis_rpm_right);
        // 將濾波後的乾淨速度餵給 PID 大腦
                // ========================================================
                        // 🚀 新增：里程計 (Odometry) 角度積分推算
                        // ========================================================
                        // (a) 算這 10ms 內左右輪各自走的直線距離 (公尺)
                        float dist_l = ((float)chassis_enc_left / ENCODER_RESOLUTION) * (2.0f * 3.1415926f * WHEEL_RADIUS);
                        float dist_r = ((float)chassis_enc_right / ENCODER_RESOLUTION) * (2.0f * 3.1415926f * WHEEL_RADIUS);

                        // (b) 根據差速公式：角度變化量(弧度) = (右輪距離 - 左輪距離) / 輪距
                        float delta_theta_rad = (dist_l - dist_r) / WHEEL_TRACK;

                        // (c) 轉換成度數並累加到全域角度變數中
                        chassis_angle_deg += (delta_theta_rad * 180.0f / 3.1415926f);

                        // ========================================================
        // 4. 呼叫 PID 大腦，並把結果交給馬達硬體 (剛剛漏掉的關鍵)
                // ==========================================

                // --- 左輪控制 ---
        pwm_cmd_left = PID_Calc(&pid_left, rpm_left_filter);

                if (pwm_cmd_left >= 0) {
                    // 正轉：IN1 高, IN2 低
                    HAL_GPIO_WritePin(GPIOC, CHASSIS_L_IN1_Pin, GPIO_PIN_SET);
                    HAL_GPIO_WritePin(GPIOC, CHASSIS_L_IN2_Pin, GPIO_PIN_RESET);
                    __HAL_TIM_SET_COMPARE(&htim3, TIM_CHANNEL_1, (uint32_t)pwm_cmd_left);
                } else {
                    // 反轉：IN1 低, IN2 高 (PWM 值必須轉回正數)
                    HAL_GPIO_WritePin(GPIOC, CHASSIS_L_IN1_Pin, GPIO_PIN_RESET);
                    HAL_GPIO_WritePin(GPIOC, CHASSIS_L_IN2_Pin, GPIO_PIN_SET);
                    __HAL_TIM_SET_COMPARE(&htim3, TIM_CHANNEL_1, (uint32_t)(-pwm_cmd_left));
                }

                // --- 右輪控制 ---
               pwm_cmd_right = PID_Calc(&pid_right, rpm_right_filter);

                if (pwm_cmd_right >= 0) {
                    // 正轉
                    HAL_GPIO_WritePin(GPIOC, CHASSIS_R_IN1_Pin, GPIO_PIN_RESET);
                    HAL_GPIO_WritePin(GPIOC, CHASSIS_R_IN2_Pin, GPIO_PIN_SET);
                    __HAL_TIM_SET_COMPARE(&htim3, TIM_CHANNEL_2, (uint32_t)pwm_cmd_right);
                } else {
                    // 反轉
                    HAL_GPIO_WritePin(GPIOC, CHASSIS_R_IN1_Pin, GPIO_PIN_SET);
                    HAL_GPIO_WritePin(GPIOC, CHASSIS_R_IN2_Pin, GPIO_PIN_RESET);
                    __HAL_TIM_SET_COMPARE(&htim3, TIM_CHANNEL_2, (uint32_t)(-pwm_cmd_right));
                }
    }
}
// ========================================================
// 基礎底盤運動控制函式 (必須加在 Chassis_TurnPrecise 上方)
// ========================================================
/**
  * @brief 原地左轉 (逆時針自轉)
  */
uint8_t chassis_motion_state = 0; // 0=停止或轉向中, 1=直線行駛中
float locked_heading_deg = 0.0f;  // 用來記住起步瞬間的那條直線角度

void Chassis_SpinLeft(float turn_rpm)
{
    chassis_motion_state = 0; // 告訴系統現在不是直走
    pid_left.target_rpm  =  turn_rpm;
    pid_right.target_rpm = -turn_rpm;
    pid_left.integral = 0.0f; // 轉向時順便清空 PID 誤差積分
    pid_right.integral = 0.0f;
}

void Chassis_SpinRight(float turn_rpm)
{
    chassis_motion_state = 0; // 告訴系統現在不是直走
    pid_left.target_rpm  = -turn_rpm;
    pid_right.target_rpm =  turn_rpm;
    pid_left.integral = 0.0f; // 轉向時順便清空 PID 誤差積分
    pid_right.integral = 0.0f;
}

void Chassis_Stop(void)
{
    chassis_motion_state = 0; // 告訴系統現在不是直走
    pid_left.target_rpm  = 0.0f;
    pid_right.target_rpm = 0.0f;

    // 💡 關鍵：煞車時務必「徹底歸零」歷史積分與微分！
    // 這樣下一次起步時，左右兩顆馬達才不會帶著原地的力量不對稱暴衝
    pid_left.integral = 0.0f;
    pid_right.integral = 0.0f;
    pid_left.error_last = 0.0f;
    pid_right.error_last = 0.0f;
}

// [Sean 2026-10-30] 連續轉向用：只設目標轉速，不清積分 (SpinLeft/Right 每次呼叫都清積分，連續呼叫會讓積分永遠起不來)
void Chassis_SteerP(float left_rpm, float right_rpm)
{
    chassis_motion_state = 0;
    pid_left.target_rpm  = left_rpm;
    pid_right.target_rpm = right_rpm;
}

// 🚀 新增：記錄當前斜坡轉速的靜態變數
float current_ramp_rpm = 0.0f;
uint32_t ramp_last_tick = 0; // [Sean 2026-10-30] 斜坡照時間爬

void Chassis_Forward(float forward_rpm)
{
    // 剛從靜止轉為直走的第一瞬間
    if (chassis_motion_state == 0)
    {
        pid_left.integral = 0.0f;
        pid_right.integral = 0.0f;
        pid_left.error_last = 0.0f;
        pid_right.error_last = 0.0f;
        locked_heading_deg = chassis_angle_deg;
        chassis_motion_state = 1;

        // 🚀 關鍵 1：不要從 0 開始跳變，從安全的低速 15 RPM 柔和起跑！
        current_ramp_rpm = 15.0f;
        ramp_last_tick = HAL_GetTick();
    }

    // 🚀 關鍵 2：斜坡加速 (Soft Start)
    // 每次收到前進指令時，如果還沒到目標速度，就以每幀 8 RPM 平滑爬升！
    // 這能把原本 0 -> 70 RPM 的「瞬間暴力跳變」，化為 200 毫秒的「舒適推背感加速」
    // [Sean 2026-10-30] 原本每次呼叫 +8，但主迴圈每圈都呼叫，等於瞬間跳到目標；改成每 20ms +8 (15->120 約 0.26 s)
    if (current_ramp_rpm < forward_rpm) {
        if (HAL_GetTick() - ramp_last_tick >= 20) {
            ramp_last_tick = HAL_GetTick();
            current_ramp_rpm += 8.0f;
            if (current_ramp_rpm > forward_rpm) current_ramp_rpm = forward_rpm;
        }
    } else {
        current_ramp_rpm = forward_rpm;
    }

    // 電子羅盤糾偏
    float heading_error = locked_heading_deg - chassis_angle_deg;
    float comp = 0.0f;

    if (heading_error > 0.5f || heading_error < -0.5f)
    {
        comp = heading_error * 1.0f;
        if (comp > 8.0f)  comp = 8.0f;
        if (comp < -8.0f) comp = -8.0f;
    }


    // 將柔和爬升中的 current_ramp_rpm 餵給馬達
    // [Sean 2026-10-30] 正負號對調：里程計改成 (左距離-右距離)/輪距 後，原本 (-comp, +comp) 會越修越偏 (實測修正連續 10 s 卡在 ±8)
    pid_left.target_rpm  = current_ramp_rpm + comp;
    pid_right.target_rpm = current_ramp_rpm - comp;
}
/**
  * @brief 閉迴路精準轉向：轉動到指定的相對角度
  * @param float delta_theta_rad 要轉動的角度 (正數為左轉/逆時針，負數為右轉/順時針)
  * @param spin_rpm            旋轉速度 (建議設定在 80~120 RPM)
  */
void Chassis_TurnPrecise(float target_angle_change, float spin_rpm)
{
    // 1. 記錄起轉前的初始角度，並計算最終目標角度
    float start_angle = chassis_angle_deg;
    float target_angle = start_angle + target_angle_change;
    // [Sean 2026-10-30] 逾時保護：實測轉向時輪子不動，主迴圈卡死 140 s 以上
    uint32_t turn_start_tick = HAL_GetTick();
    float turn_abs = (target_angle_change > 0.0f) ? target_angle_change : -target_angle_change;
    uint32_t turn_timeout_ms = 2000 + (uint32_t)(turn_abs * 15.0f);

    // 2. 判斷轉向方向並啟動旋轉
    if (target_angle_change > 0) {
        Chassis_SpinLeft(spin_rpm);  // 角度增加：逆時針左轉
    } else {
        Chassis_SpinRight(spin_rpm); // 角度減少：順時針右轉
    }

    // 3. 迴圈等待，直到真實角度到達目標角度附近 (容許誤差 ±2 度)
    while (1)
    {
        float current_error = target_angle - chassis_angle_deg;

        // [Sean 2026-10-30] 轉到或越過目標就停 (輪子變快後每 10ms 可能跳過 ±2 度區間)
        if ((target_angle_change > 0.0f) ? (current_error <= 2.0f) : (current_error >= -2.0f)) {
            break; // 跳出迴圈
        }
        if (HAL_GetTick() - turn_start_tick > turn_timeout_ms) {
            break; // 逾時，避免主迴圈永遠卡住
        }

        // 短暫延遲避免卡死 CPU，讓背景 TIM6 中斷持續積分角度
        Telemetry_Poll(); // [Sean] 轉向中主迴圈被卡住，這裡補送
        HAL_Delay(10);
    }

    // 4. 轉到位了！立刻煞車停止
    Chassis_Stop();
}
void HAL_UART_RxCpltCallback(UART_HandleTypeDef *huart)
{
    if (huart->Instance == USART2)
    {
        if (command_ready == 0)
        {
            // 🚀 關鍵防護：如果緩衝區是空的 (rx_index == 0)，嚴格檢查第一個字元！
            // 只允許合法指令的開頭字母 (B=BALL, N=NOBALL, L=LED, P=PING, S=STOP) 進入
            // 這樣能徹底防止收進上一句殘留的半截數字 (如 "35.0,0.0\n")
            if (rx_index == 0 && !(rx_byte == 'B' || rx_byte == 'N' || rx_byte == 'L' || rx_byte == 'P' || rx_byte == 'S' || rx_byte == 'C'))
            {
                // 如果不是合法指令開頭，直接丟棄，等待下一個字元
                HAL_UART_Receive_IT(&huart2, &rx_byte, 1);
                return;
            }

            if (rx_index < (sizeof(rx_buffer) - 1))
            {
                rx_buffer[rx_index++] = rx_byte;

                if (rx_byte == '\n')
                {
                    rx_buffer[rx_index] = '\0';
                    command_ready = 1;
                }
            }
            else
            {
                rx_index = 0; // 防溢位重置
            }
        }

        HAL_UART_Receive_IT(&huart2, &rx_byte, 1);
    }
}
// [Sean] 輪速回傳：每 50ms 一行，非阻塞；上一筆還沒送完就跳過這次
// 格式對應 D 程式 drain_rpm_telemetry → <TEST_NAME>_rpm.csv
// RPM,時間ms,左目標rpm,左實際rpm,右目標rpm,右實際rpm   (實際 = PID 用的低通濾波後轉速)
void Telemetry_Poll(void)
{
    static uint32_t last_ms = 0;
    static char tx[80];
    uint32_t now = HAL_GetTick();
    if (now - last_ms < 50) return;
    if (huart2.gState != HAL_UART_STATE_READY) return;
    last_ms = now;
    int n = sprintf(tx, "RPM,%lu,%.2f,%.2f,%.2f,%.2f\n", now,
                    pid_left.target_rpm, rpm_left_filter, pid_right.target_rpm, rpm_right_filter);
    HAL_UART_Transmit_IT(&huart2, (uint8_t *)tx, n);
}
/* USER CODE END 4 */
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
