YourFath3r253/tennisball-picking/實體車子程式碼/ballpicker_STM32專案/Core/Inc/main.h

#define B1_Pin GPIO_PIN_13
#define B1_GPIO_Port GPIOC
#define L_IN1_Pin GPIO_PIN_0
#define L_IN1_GPIO_Port GPIOC
#define L_IN2_Pin GPIO_PIN_1
#define L_IN2_GPIO_Port GPIOC
#define R_IN1_Pin GPIO_PIN_2
#define R_IN1_GPIO_Port GPIOC
#define R_IN2_Pin GPIO_PIN_3
#define R_IN2_GPIO_Port GPIOC
#define USART_TX_Pin GPIO_PIN_2
#define USART_TX_GPIO_Port GPIOA
#define USART_RX_Pin GPIO_PIN_3
#define USART_RX_GPIO_Port GPIOA
#define LD2_Pin GPIO_PIN_5
#define LD2_GPIO_Port GPIOA
#define CHASSIS_L_IN1_Pin GPIO_PIN_4
#define CHASSIS_L_IN1_GPIO_Port GPIOC
#define CHASSIS_L_IN2_Pin GPIO_PIN_5
#define CHASSIS_L_IN2_GPIO_Port GPIOC
#define CHASSIS_R_IN1_Pin GPIO_PIN_6
#define CHASSIS_R_IN1_GPIO_Port GPIOC
#define CHASSIS_R_IN2_Pin GPIO_PIN_7
#define CHASSIS_R_IN2_GPIO_Port GPIOC
#define TMS_Pin GPIO_PIN_13
#define TMS_GPIO_Port GPIOA
#define TCK_Pin GPIO_PIN_14
#define TCK_GPIO_Port GPIOA
#define SWO_Pin GPIO_PIN_3
#define SWO_GPIO_Port GPIOB
