YourFath3r253/tennisball-picking/src/tennis_bot/tennis_bot/grid_patrol_node.py

"""格點路徑巡邏，四個狀態：

  A 巡邏 (PATROL)      沿 32 格弓字型路徑走，0.4 m/s、轉向角速度上限 0.6 rad/s
  B 對準 (ALIGN)       發現球，原地左右轉，實體車 STM32 的連續 P 轉向 (STEER_KP=0.6 rpm/度)
  C 接近 (APPROACH)    對準後往前走，邊走邊用簡單PID修正方向 (球的角度)，一路走到相機看不到球為止

輸入/輸出跟實體車同一套介面 (2026-10-05)：吃 /jetson_uart 的 D 同學 UART 字串 (BALL,距離,角度 /
BALL_OFF / COURT,...)，送 /wheel_target_rpm 左右輪目標 rpm 給 motor_driver_node (STM32 輪速 PID +
馬達模型)，不再直接發 /cmd_vel。詳見下方「跟實體車一樣的介面」註解。
  D 盲衝 (BLIND_DASH)  相機看不到球 (死角範圍) 後固定時間直衝，蓋過死角距離
  E 原路倒車 (RETURNING) 追球 (B/C/D) 結束後，把追球期間送出的指令倒過來重播一遍，
                        不靠里程計，直接原路退回巡邏路線再繼續 PATROL

車體自身位置用輪速+陀螺儀算 (讀 /joint_states 拿左右驅動輪真實角速度算前進
速度，輪子半徑 0.04m、輪距 0.29m；轉向角速度改用 /imu 陀螺儀直接量到的角速度，
不再用左右輪速差推算，因為輪子在原地轉向 (ALIGN) 或撞到東西時容易打滑，輪速
差算出來的角速度會跟車體真實轉動的角度對不上)，不用 /odom、不用光達/AMCL。
陀螺儀有雜訊+零點偏移 (URDF <noise>，對應 BNO080 規格)。「有沒有真的碰到球」則是用 Gazebo 的真實座標判斷 (base_link
座標+姿態，轉換球的世界座標到局部座標系，檢查有沒有跟左右滾輪的位置
重疊)，這兩個是分開的：車體自己「以為」在哪裡 (拿去決定怎麼轉彎)，
跟「有沒有真的碰到」(拿去判斷有沒有成功) 用的資料來源不同。
左右滾輪 (left_roller/right_roller) 在 URDF 裡沒有開 collision，撿球判定
全部是軟體幾何判定，不靠物理碰撞，避免滾輪真的輾過球時的碰撞力沒被輪速
里程計記錄到卻讓車體有真實偏移。front_chassis 也沒有 collision (滾輪機構
要能穿過球)；左右驅動輪維持原本的 collision (要滾地才能開)。

會把整段軌跡、每顆球碰到的時間、總花費時間都記錄到 CSV，供之後畫圖/分析。
"""
import csv
import math
import os
import time
from collections import deque
from pathlib import Path

import rclpy
from rclpy.node import Node
from geometry_msgs.msg import Twist
from sensor_msgs.msg import JointState, Imu
from std_msgs.msg import Empty, Float32MultiArray, String
from gazebo_msgs.srv import GetEntityState, SetEntityState

from tennis_bot.robot_profile import P as _ROBOT  # 車體幾何 (v1/v2)
from tennis_bot.motor_model import TargetRamp, body_to_wheel_rpm
from tennis_bot.grid_waypoints import (
    court_path_with_net, COURT_X_RANGE, COURT_Y_RANGE, CELL_MAX_M,
    NET_X, NET_CLEARANCE_M, NET_BYPASS_Y)

# ---- 路徑設定：開放式網球場 (牆沒有碰撞)，中間有網子 (x=0，有碰撞、擋住視線)。
# 網子把場地切成兩個矩形，各自走弓字，中間繞網柱外側過去 (grid_waypoints.court_path_with_net，
# 格邊長由相機視野公式 CELL_MAX_M 算出) ----
X_RANGE = COURT_X_RANGE
Y_RANGE = COURT_Y_RANGE

# 出界判定：場地是開放的沒有牆，車跑出場地外太遠就停止 (用 Gazebo 真實座標，
# 模擬才有的優勢)。繞網柱時會走到 y=±7.5 (場外 2 m)，再加里程計誤差，所以留 3.5 公尺。
OUT_OF_BOUNDS_MARGIN_M = 3.5

# 追球時不能靠近網子：規則是車身離網 0.5 m，車頭在車體中心前方 0.263 m，所以車體中心
# |x| 小於 0.763 又朝著網子開，就放棄這顆球，之後 NET_ABORT_IGNORE_VISION_SEC 秒內
# 不理視覺 (不然同一顆球會一直重新觸發)。巡邏格子本身離網 NET_CLEARANCE_M=0.9 (更保守)。
# run83 實測用 0.9 當放棄門檻太嚴：撿完上一顆球停在 x=-0.89，下一顆球在 -0.77 就被放棄了。
NET_ABORT_CLEARANCE_M = 0.5 + 0.263
NET_ABORT_IGNORE_VISION_SEC = 5.0
ARRIVE_TOLERANCE_M = 0.3

# ---- 輪速里程計參數 ----
# WHEEL_SEPARATION_M 原本抄 diff_drive plugin 裡的 0.27，但那是 plugin 自己換算
# cmd_vel 用的假設值，不是真正的輪距。實際從 Gazebo 查 left/right_drive_wheel
# 在 base_link 局部座標系的位置：左輪 y=0.01，右輪 y=-0.28，真實輪距是 0.29m。
# 這個常數用在把「量到的左右輪速差」換算回「車體真實轉了多少角速度」，數字
# 差 0.27 vs 0.29 (差約7.4%) 會讓每次轉向都被里程計系統性高估角度，多次累積
# 起來就是我們看到的角度誤差越滾越大的主因。
WHEEL_RADIUS_M = 0.04
WHEEL_SEPARATION_M = 0.29
# 里程計算的是「兩個驅動輪軸心中點」的運動，但 Gazebo GetEntityState 回報的是
# base_link 原點，兩者在車體座標差 (+0.080, -0.135) m (實測 left/right_drive_wheel
# 與 base_link 的世界座標算出來的)。原地轉的時候軸心不動、base_link 卻繞 0.157m
# 半徑畫圓，不換算的話會憑空多出最多 0.31m 的「誤差」。
AXLE_MID_IN_BASE = _ROBOT['axle_in_base']
LEFT_WHEEL_JOINT = 'left_wheel_joint'
RIGHT_WHEEL_JOINT = 'right_wheel_joint'

# ---- 狀態 A 巡邏 ----
PATROL_SPEED = 0.4
PATROL_MAX_OMEGA = 0.6

# ---- 跟實體車一樣的介面 (2026-10-05) ----
# 輸入：/jetson_uart，D 同學 Jetson 程式送給 STM32 的同一套字串 (BALL,<距離cm>,<角度deg> / BALL_OFF /
#       COURT,...)，角度球在右邊為正。以前是吃 vision_node 的像素座標 /target_position。
# 輸出：/wheel_target_rpm [左, 右]，等於 STM32 的 pid_left/right.target_rpm，由 motor_driver_node
#       (STM32 輪速 PID + 馬達模型) 去轉；以前是直接發 /cmd_vel 給 Gazebo (下多少就瞬間多少)。
#       車體速度 -> 輪速用實體車幾何 (輪半徑 0.052、輪距 0.243)。直走/巡邏照 B 同學 Chassis_Forward 的
#       軟起步 (15 rpm 起跳、每次最多 +8 rpm，見 motor_model.TargetRamp)。
# 看丟判定：BALL 每次視覺輸出才來一筆 (實測間隔最長 0.45 s)，超過 LOST_BALL_GRACE_SEC 沒來、或收到 BALL_OFF 才算看丟。

# ---- 狀態 B 對準 ----
# 2026-10-05 改成實體車 STM32 的連續 P 轉向 (Chassis_SteerP)：y = STEER_KP*(0-角度)，左輪 -y/2、右輪 +y/2，
# 單輪飽和 ±45 rpm。STEER_KP=0.6 是 9/21 實體車驗證、Sean 採用的值 (rise ~3.5 s)。
STEER_KP = float(os.environ.get('TENNISBOT_STEER_KP', '0.6'))  # rpm / 度
STEER_WHEEL_MAX = 45.0    # rpm
ALIGN_DONE_DEG = 5.0      # 角度小於這個就從對準換成接近

# ---- 相機延遲補償 (簡化版 Smith predictor，2026-10-05，設計見 experiments/delay_comp_design.py) ----
# 問題：BALL 的角度是約 0.6 s 前的畫面 (再加 EMA)，車子這段時間已經轉了，照舊角度轉 Kp 一大就擺盪。
# 做法 (實體車 STM32 也做得到)：收到 BALL,角度 b 時，認為畫面是 DELAY_COMP_SEC 秒前拍的，
#   目標航向 psi* = psi(現在 - D) - b；之後每 20 ms 用最新轉角算 e = psi* - psi，y = STEER_KP * e。
# 轉角來源：gyro (陀螺儀，模擬裡就是 /imu 積分的 self.yaw) 或 encoder (編碼器積分，像 main.c 的
#   chassis_angle_deg；原地轉輪胎側滑，會高估轉角)。off = 原本只在收到 BALL 時用角度直接轉。
# Gazebo 步階測試 (29°)：補償 gyro D=0.8 Kp=1.5 穩定在 ±4° 內 1.60 s、overshoot 1.8°；
#   無補償 Kp=0.6 5.74 s、4.3°；無補償 Kp=1.5 一直擺盪。
DELAY_COMP = os.environ.get('TENNISBOT_DELAY_COMP', 'off')   # off / gyro / encoder
DELAY_COMP_SEC = float(os.environ.get('TENNISBOT_DELAY_COMP_SEC', '0.8'))
WHEEL_R_REAL, WHEEL_L_REAL = 0.052, 0.243  # 編碼器積分轉角用 (實體車幾何)
# 純 P 控制。曾經以為兩顆球角度接近時的擺盪是控制過衝，加了D項沒有效果——
# 真正原因是 vision_node 那邊鎖定的目標本身在兩顆球之間切換，不是同一顆球的
# 誤差訊號在震盪，D項對不連續跳動的訊號沒有意義。改用 vision 端更嚴格的鎖定
# (鎖定期間完全不切換，除非真的超過2秒沒看到任何球) 才是對的方向。
ALIGN_KP = 0.005
ALIGN_MAX_OMEGA = 0.6
PX_PER_RAD = 458.5  # 640px / 1.396rad 相機水平視角
ALIGN_THRESHOLD_PX = math.radians(5.0) * PX_PER_RAD  # ~40px，對應 5 度 (舊的像素版，現在用 ALIGN_DONE_DEG)
PX_PER_DEG = PX_PER_RAD * math.pi / 180.0  # 8.0 px/度，舊的像素增益換算成每度用

# ---- 狀態 C 接近 ----
APPROACH_SPEED = 0.3
# 0.3 -> 0.6：UART 版沒有「這一幀沒看到」的訊息，只能看 BALL 多久沒來；實測視覺輸出間隔最長 0.45 s
LOST_BALL_GRACE_SEC = 0.6
# 原本 APPROACH 是完全不修正方向的直走，ALIGN 交接時殘留的 ±5° 誤差在距離遠時
# (接近3m偵測極限) 會被放大成明顯的橫向偏移。改成簡單 PID，邊走邊用同一個像素
# 誤差(球中心離畫面中心多遠)修正角速度，先用一組保守的參數試試看。
APPROACH_PID_KP = 0.0025 * PX_PER_DEG   # rad/s 每度 (原本 0.0025 rad/s 每像素)
APPROACH_PID_KI = 0.0
APPROACH_PID_KD = 0.0008 * PX_PER_DEG
APPROACH_MAX_OMEGA = 0.3

# ---- 狀態 D 盲衝 ----
BLIND_DASH_SPEED = 0.3
BLIND_DASH_DURATION_SEC = 2.0

# ---- 撿球：滾輪物理拋球進後車廂 (取代原本「碰到就刪除球」) ----
# 滾輪常轉，/roller_cmd angular.z=W 讓左右滾輪反向各轉 1.556*W rad/s (diff_drive plugin，
# 輪距 0.14 / 半徑 0.045)。experiments/roller_pickup 實測 (滾輪在 x=0.2, z=0.03，
# 見 URDF 註解)：W=40~45 在盲衝速度 0.2~0.4 全部進車廂；W=35 邊緣；W>=50 拋過頭飛出
# 車尾；W>=58 球卡住時滾輪關節會物理爆掉。取中間值 42.5 (約 66 rad/s)。
ROLLER_CMD_W = float(os.environ.get('ROLLER_W', '42.5'))  # 新車體撿球道驗證時會掃這個 (實際滾輪轉速看撿球馬達型號)
# 「進後車廂」判定用 Gazebo 真實座標 (模擬才有的優勢)：球在 base_link 座標系
# x 在車廂範圍 [-0.36, 0]、y 在車廂寬度內 (中心 -0.135 ± 0.11)、z 高於地面
# (車廂地板 0.03 + 球半徑 0.033 = 0.063；地上的球 z=0.033)。
BASKET_X_RANGE = _ROBOT['basket_x']
BASKET_Y_CENTER = _ROBOT['basket_y_center']
BASKET_Y_HALF_WIDTH = _ROBOT['basket_y_half']
BASKET_MIN_Z = _ROBOT['basket_min_z']
BASKET_REST_MAX_Z = _ROBOT['basket_rest_max_z']  # 球躺在車廂地板上 (z≈0.065)；飛過車廂上方時 z≈0.2 不算
BASKET_CONFIRM_POLLS = 3  # 連續幾次查詢都在車廂裡才算撿到，避免彈出去的球被誤計

# run8 只測滾輪判定、run9 才加上原路倒車，兩個改動分開測試看各自的效果
RETURN_REPLAY_ENABLED = False

# 里程計積分的 dt 用 /joint_states 封包自帶的時間戳 (Gazebo 模擬時間) 相減。
# run63~70 實測模擬即時率只有 0.91~0.93，之前用真實時鐘算 dt，里程計走的距離
# 天生就多 7~10%，跟量到的 odom/real 距離比例幾乎一樣。實體車也是一樣的做法：
# 用編碼器封包上的時間戳，不用收到封包的電腦時間。
# 之前試過用 /clock 算 dt，但 /clock 只有 10Hz、/joint_states 30Hz，大半 dt 會是 0。

# ball_6 從 tennis_court.world 移除了 (一開場就會馬上撿到，測試不到東西，
# 而且之前出現過一次奇怪的碰撞行為)，場上現在固定是這 9 顆。
# 批次實驗會用 gen_ball_layout.py --count N 產生任意顆球，run_once.sh 會把球名放進
# 環境變數 TENNISBOT_BALL_NAMES (逗號分隔)；沒設就是預設的這 9 顆。
BALL_NAMES = (os.environ['TENNISBOT_BALL_NAMES'].split(',') if os.environ.get('TENNISBOT_BALL_NAMES')
              else ['ball_1', 'ball_2', 'ball_3', 'ball_4', 'ball_5', 'ball_7', 'ball_8', 'ball_9', 'ball_10'])
NUM_BALLS = len(BALL_NAMES)

DATA_ROOT = Path('/home/sean/ros2_ws/experiments/實驗數據')

# TENNISBOT_HALF_ONLY=1：只走我方半場的弓字路徑 (16 格)，走完就結束。給 D 同學半場邊界提案當比較基準用。
HALF_ONLY = os.environ.get('TENNISBOT_HALF_ONLY') == '1'



def next_run_dir():
    """自動找下一個沒用過的 runN 資料夾，每次執行都存到新的一個，不會互相覆蓋。"""
    DATA_ROOT.mkdir(parents=True, exist_ok=True)
    n = 1
    while (DATA_ROOT / f'run{n}').exists():
        n += 1
    run_dir = DATA_ROOT / f'run{n}'
    run_dir.mkdir(parents=True)
    return run_dir


def angle_diff(a, b):
    d = a - b
    while d > math.pi:
        d -= 2 * math.pi
    while d < -math.pi:
        d += 2 * math.pi
    return d


def quat_integrate(q, wx, wy, wz, dt):
    """q (w,x,y,z) 用車體座標系角速度 (wx,wy,wz) 積分 dt 秒：q' = q ⊗ exp(ω dt / 2)。"""
    angle = math.sqrt(wx * wx + wy * wy + wz * wz) * dt
    if angle < 1e-12:
        return q
    ax, ay, az = wx * dt / angle, wy * dt / angle, wz * dt / angle
    s, c = math.sin(angle / 2.0), math.cos(angle / 2.0)
    dw, dx, dy, dz = c, ax * s, ay * s, az * s
    w, x, y, z = q
    nq = (w * dw - x * dx - y * dy - z * dz,
          w * dx + x * dw + y * dz - z * dy,
          w * dy - x * dz + y * dw + z * dx,
          w * dz + x * dy - y * dx + z * dw)
    n = math.sqrt(sum(v * v for v in nq))
    return tuple(v / n for v in nq)


# ---- 陀螺儀 + 加速度計傾斜修正 (模擬 BNO080 Game Rotation Vector 的感測融合) ----
# 純陀螺儀積分沒有重力參考，roll/pitch 誤差會一直累積，車子轉彎時再漏到航向：run119/120 煞車點頭
# (~20°，baseline run121 也有) 之後傾斜誤差累積到 7~8°，航向誤差最大 20.6°。真實的 BNO080 輸出
# 的 Game Rotation Vector 本來就有用加速度計修正 roll/pitch (Mahony/互補濾波這一類)，航向仍然
# 只靠陀螺儀 (加速度計看不到航向)，所以這裡照做：只有量到的加速度接近 1g (沒有急加減速/撞擊)
# 時，把「加速度計量到的上方」跟「四元數估計的上方」的夾角當誤差，乘上 TILT_KP 加回角速度。
TILT_KP = 0.5
TILT_ACCEL_GATE = (0.9 * 9.81, 1.1 * 9.81)


def tilt_correction(q, ax, ay, az):
    """回傳要加到車體角速度上的修正量 (ex, ey, ez)*TILT_KP；加速度不像純重力時回傳 0。"""
    n = math.sqrt(ax * ax + ay * ay + az * az)
    if not (TILT_ACCEL_GATE[0] < n < TILT_ACCEL_GATE[1]):
        return 0.0, 0.0, 0.0
    w, x, y, z = q
    # 世界座標的上方 (0,0,1) 在車體座標系的表示 = 旋轉矩陣第三列
    vx, vy, vz = 2.0 * (x * z - w * y), 2.0 * (y * z + w * x), 1.0 - 2.0 * (x * x + y * y)
    mx, my, mz = ax / n, ay / n, az / n  # 加速度計靜止時量到的是朝上的 +g
    ex, ey, ez = my * vz - mz * vy, mz * vx - mx * vz, mx * vy - my * vx
    return TILT_KP * ex, TILT_KP * ey, TILT_KP * ez


def quat_rotate_inverse(qx, qy, qz, qw, vx, vy, vz):
    cx, cy, cz, cw = -qx, -qy, -qz, qw
    tx = 2.0 * (cy * vz - cz * vy)
    ty = 2.0 * (cz * vx - cx * vz)
    tz = 2.0 * (cx * vy - cy * vx)
    rx = vx + cw * tx + (cy * tz - cz * ty)
    ry = vy + cw * ty + (cz * tx - cx * tz)
    rz = vz + cw * tz + (cx * ty - cy * tx)
    return rx, ry, rz


class GridPatrolNode(Node):
    def __init__(self):
        super().__init__('grid_patrol_node')

        self.waypoints, self.cell_numbers, cells = court_path_with_net()
        if HALF_ONLY:
            n = self.cell_numbers.index(0) if 0 in self.cell_numbers else len(self.cell_numbers)
            self.waypoints, self.cell_numbers = self.waypoints[:n], self.cell_numbers[:n]
            self.get_logger().info(f'只走我方半場：{n} 個路徑點')
        n_cells = len(cells)
        self.get_logger().info(
            f'格邊長上限 {CELL_MAX_M:.2f} m (2*0.8*R*sinθ)，網子在 x={NET_X}，車體離網至少 {NET_CLEARANCE_M} m -> '
            f'兩個半場各 {n_cells // 2} 格 (每格 {cells[0][2]:.2f} x {cells[0][3]:.2f} m)，'
            f'共 {n_cells} 格 + 2 個繞網柱過渡點 (y=±{NET_BYPASS_Y})，{len(self.waypoints)} 個路徑點')
        self._vision_ignore_until = None

        # 從格 1 開始，不是從世界原點開始。車體實際位置跟里程計起始值必須對得上，
        # 不然會整趟路線平移掉 (曾經忘記傳送車體，跑出完全不對的巡邏路線)。
        # 所以這裡自己呼叫 /set_entity_state 把車體傳送到格 1，不依賴外部先手動
        # 跑 reset_run.py。
        start_x, start_y, start_yaw = self._start_pose()
        self._teleport_to_start(start_x, start_y, start_yaw)
        # 傳送的是 base_link，里程計起點要放在軸心中點 (偏移量要跟著起始朝向轉)
        c, s_ = math.cos(start_yaw), math.sin(start_yaw)
        self.x = start_x + AXLE_MID_IN_BASE[0] * c - AXLE_MID_IN_BASE[1] * s_
        self.y = start_y + AXLE_MID_IN_BASE[0] * s_ + AXLE_MID_IN_BASE[1] * c
        self.yaw = start_yaw
        self.wp_index = 0

        # ---- 輪速里程計 (car 自己以為的位置，拿去決定怎麼開) ----
        self._have_odom = False
        self._last_stamp = None  # /joint_states 封包的模擬時間戳
        self._first_stamp = None  # 第一筆 /joint_states 的模擬時間，算「模擬時間經過多久」用
        self._wheel_vel = {LEFT_WHEEL_JOINT: 0.0, RIGHT_WHEEL_JOINT: 0.0}

        # ---- debug 對照組：同一份輪速+陀螺儀，但用真實時鐘的 dt 積分 (舊做法)，
        # 只寫進 trajectory.csv 比對，不拿去控制 ----
        self._last_odom_time = None
        self.x_wall = self.x
        self.y_wall = self.y
        self.yaw_wall = start_yaw

        # ---- 陀螺儀：yaw 在 _imu_cb 裡用三軸角速度做四元數積分，不用左右輪速差算 ----
        self._last_imu_stamp = None
        self._last_imu_time = None
        self._gyro_q = (math.cos(start_yaw / 2), 0.0, 0.0, math.sin(start_yaw / 2))  # (w, x, y, z) = 起始朝向
        self._imu_gaps = 0  # debug：IMU 封包間隔 > 1.5 ms 的次數 (= 掉封包，1kHz 應該每 1 ms 一筆)
        # 延遲補償用：最近 3 秒的 (模擬時間, 陀螺儀轉角(不折回), 編碼器積分轉角)，單位 rad
        self._yaw_unwrapped = start_yaw
        self._yaw_unwrapped_last = start_yaw
        self._enc_yaw = start_yaw
        self._last_rpm_stamp = None
        self._heading_hist = deque(maxlen=3000)
        self._psi_target = None
        self.real_roll = None
        self.real_pitch = None

        # ---- debug：追蹤中的目標球是幾號 (用真實座標反推，不是 vision_node 自己
        # 知道的，vision_node 只有像素座標，沒有球的身分) ----
        self._ball_real_positions = {}

        # ---- 狀態 C PID (邊接近邊修正方向) ----
        self._approach_integral = 0.0
        self._approach_prev_error = 0.0
        self._approach_prev_time = None

        # ---- 視覺 (UART 協定) ----
        self.last_seen_time = None
        self.ball_angle_deg = 0.0    # 球的角度，右邊為正 (D 同學協定)
        self.ball_dist_cm = 0.0
        self._ball_off = True
        self._court = None           # 最新一筆 COURT：(state, side, ratio, color, 收到的時間)

        # ---- 輸出：左右輪目標 rpm (斜坡) ----
        self._ramp_l = TargetRamp()
        self._ramp_r = TargetRamp()

        # ---- 狀態機 ----
        self.state = 'PATROL'  # PATROL / ALIGN / APPROACH / BLIND_DASH / RETURNING
        self.blind_dash_until = None

        # ---- 追球動作紀錄，追完後原路倒車回去 (不靠里程計，直接反轉重播) ----
        self.chase_cmd_log = []
        self.return_index = 0

        # ---- 球 ----
        self.remaining_balls = list(BALL_NAMES)
        self._basket_streak = {name: 0 for name in BALL_NAMES}
        self.touched_count = 0
        self.touch_check_in_progress = False
        self._touch_check_started = 0.0
        self._ball_poll_index = -1

        # ---- 記錄 ----
        self.run_dir = next_run_dir()
        self.get_logger().info(f'這次執行的資料會存到 {self.run_dir}')
        self.traj_file = open(self.run_dir / 'trajectory.csv', 'w', newline='')
        self.traj_writer = csv.writer(self.traj_file)
        self.traj_writer.writerow([
            't', 'x', 'y', 'yaw', 'state', 'wp_index', 'cell_number',
            'real_x', 'real_y', 'real_yaw', 'target_ball_guess',
            'x_wall', 'y_wall', 'yaw_wall',
            'real_roll', 'real_pitch', 'gyro_roll', 'gyro_pitch', 'imu_gaps',
        ])
        self.touch_file = open(self.run_dir / 'ball_touches.csv', 'w', newline='')
        self.touch_writer = csv.writer(self.touch_file)
        # elapsed_sec 是真實時鐘；sim_elapsed_sec 是模擬時間 (即時率 <1 時兩者會差，比較撿球時間用模擬時間)
        self.touch_writer.writerow(['ball_name', 'elapsed_sec', 'wp_index_at_touch', 'cell_number_at_touch',
                                    'sim_elapsed_sec'])

        # ---- debug：每次 _joint_state_cb 觸發時記錄 wall_dt vs sim_dt (封包時間戳)，
        # 累加起來的比值就是這次 run 的平均即時率 ----
        self.dt_debug_file = open(self.run_dir / 'dt_debug.csv', 'w', newline='')
        self.dt_debug_writer = csv.writer(self.dt_debug_file)
        self.dt_debug_writer.writerow(['t', 'wall_dt', 'sim_dt', 'state', 'dropped'])

        self.start_time = time.time()
        with open(self.run_dir / 'meta.txt', 'w') as f:
            f.write(f'start_epoch={self.start_time}\n')
        self.done = False

        self.wheel_pub = self.create_publisher(Float32MultiArray, '/wheel_target_rpm', 10)
        self.roller_pub = self.create_publisher(Twist, '/roller_cmd', 10)
        self.roller_timer = self.create_timer(0.1, self._publish_roller_cmd)  # 滾輪常轉
        self.vision_reset_pub = self.create_publisher(Empty, '/vision_reset_lock', 10)
        self.create_subscription(JointState, '/joint_states', self._joint_state_cb, 10)
        self.create_subscription(Imu, '/imu', self._imu_cb, 10)
        self.create_subscription(String, '/jetson_uart', self._uart_cb, 10)
        # 模擬的 STM32 RPM telemetry (motor_driver_node)，跟實體車 runXX_rpm.csv 一樣記下來
        self.rpm_file = open(self.run_dir / 'wheel_rpm.csv', 'w', newline='')
        self.rpm_writer = csv.writer(self.rpm_file)
        self.rpm_writer.writerow(['t', 'target_left_rpm', 'actual_left_rpm', 'target_right_rpm', 'actual_right_rpm',
                                  'pwm_left', 'pwm_right', 'state'])
        self.create_subscription(Float32MultiArray, '/wheel_rpm', self._wheel_rpm_cb, 10)

        self.get_entity_cli = self.create_client(GetEntityState, '/get_entity_state')

        # debug 用：定期查 Gazebo 真實座標，跟里程計「以為的」位置分開記錄，
        # 這樣才看得出來里程計什麼時候開始跟真實位置對不上 (追球轉彎、撞牆時最容易飄)。
        self.real_x = None
        self.real_y = None
        self.real_yaw = None
        self._real_pose_pending = False
        self.real_pose_timer = self.create_timer(0.2, self._poll_real_pose)  # 每次回來就寫一筆 trajectory

        self.control_timer = self.create_timer(0.1, self._control_loop)
        if DELAY_COMP != 'off':
            self.create_timer(0.02, self._align_fast_tick)
        with open(self.run_dir / 'meta.txt', 'a') as f:
            f.write(f'steer_kp={STEER_KP}\ndelay_comp={DELAY_COMP}\ndelay_comp_sec={DELAY_COMP_SEC}\n')

        self.get_logger().info('開始巡邏。')

    def _start_pose(self):
        """起點 (base_link 的 x, y, 朝向)。弓字路徑從格 1 開始、朝向 0；子類別 (例如邊界反彈) 可以改。"""
        return self.waypoints[0][0], self.waypoints[0][1], 0.0

    def _is_out_of_bounds(self, x, y):
        """真實座標離場地太遠 -> 停止 (模擬才有的保護)。子類別可以換成自己的場地範圍。"""
        return (not (X_RANGE[0] - OUT_OF_BOUNDS_MARGIN_M <= x <= X_RANGE[1] + OUT_OF_BOUNDS_MARGIN_M)
                or not (Y_RANGE[0] - OUT_OF_BOUNDS_MARGIN_M <= y <= Y_RANGE[1] + OUT_OF_BOUNDS_MARGIN_M))

    def _teleport_to_start(self, x, y, yaw=0.0):
        cli = self.create_client(SetEntityState, '/set_entity_state')
        if not cli.wait_for_service(timeout_sec=10.0):
            self.get_logger().error('/set_entity_state 服務沒回應，車體傳送失敗，Gazebo 有在跑嗎？')
            return
        req = SetEntityState.Request()
        req.state.name = 'tennis_bot'
        req.state.pose.position.x = x
        req.state.pose.position.y = y
        req.state.pose.position.z = 0.05
        req.state.pose.orientation.z = math.sin(yaw / 2)
        req.state.pose.orientation.w = math.cos(yaw / 2)
        future = cli.call_async(req)
        rclpy.spin_until_future_complete(self, future, timeout_sec=5.0)
        result = future.result()
        self.get_logger().info(f'車體傳送到起點 ({x:.3f}, {y:.3f}, {math.degrees(yaw):.0f}°)：{result.success if result else False}')

    # ---------------- 陀螺儀 ----------------
    def _publish_roller_cmd(self):
        twist = Twist()
        twist.angular.z = 0.0 if self.done else ROLLER_CMD_W
        self.roller_pub.publish(twist)

    def _imu_cb(self, msg):
        # 航向在這裡用 IMU 自己的封包時間戳積分 (50Hz，每筆剛好算一次)。之前是在
        # 30Hz 的 /joint_states callback 抓「最新一筆」角速度乘 dt，等於每秒有 20 筆
        # 陀螺儀資料被跳過或重複算，run72 實測每次轉向會隨機差 ±1°。
        # 三軸陀螺儀做四元數積分再取 yaw，不是只積分 z 軸：run78/81 實測車體在原地轉時
        # 若有傾斜 (滾輪擦地、傳送時被彈起)，只看 z 軸會少算 3~5% 的航向 (yaw率 =
        # ω_z·cosφ + ω_y·sinφ ...)，一次就差 1~3°。實體車的 IMU 本來就是三軸的。
        now = self.get_clock().now().nanoseconds / 1e9
        stamp = msg.header.stamp.sec + msg.header.stamp.nanosec / 1e9
        wx, wy, wz = msg.angular_velocity.x, msg.angular_velocity.y, msg.angular_velocity.z
        if self._last_imu_stamp is not None:
            dt = stamp - self._last_imu_stamp
            if dt > 0.0015:
                self._imu_gaps += 1
            if 0 < dt < 0.5:
                a = msg.linear_acceleration
                cx, cy, cz = tilt_correction(self._gyro_q, a.x, a.y, a.z)
                self._gyro_q = quat_integrate(self._gyro_q, wx + cx, wy + cy, wz + cz, dt)
                qw, qx, qy, qz = self._gyro_q
                self.yaw = math.atan2(2.0 * (qw * qz + qx * qy), 1.0 - 2.0 * (qy * qy + qz * qz))
                self._yaw_unwrapped += angle_diff(self.yaw, self._yaw_unwrapped_last)
                self._yaw_unwrapped_last = self.yaw
                self._heading_hist.append((stamp, self._yaw_unwrapped, self._enc_yaw))
            wall_dt = now - self._last_imu_time
            if 0 < wall_dt < 0.5:
                self.yaw_wall += wz * wall_dt  # 對照組維持舊做法 (只積 z 軸、真實時鐘 dt)
        self._last_imu_stamp = stamp
        self._last_imu_time = now

    # ---------------- 輪速里程計 ----------------
    def _joint_state_cb(self, msg):
        now = self.get_clock().now().nanoseconds / 1e9
        stamp = msg.header.stamp.sec + msg.header.stamp.nanosec / 1e9
        for name in (LEFT_WHEEL_JOINT, RIGHT_WHEEL_JOINT):
            if name in msg.name:
                idx = msg.name.index(name)
                if idx < len(msg.velocity):
                    self._wheel_vel[name] = msg.velocity[idx]

        if self._first_stamp is None:
            self._first_stamp = stamp
        wall_dt = (now - self._last_odom_time) if self._last_odom_time is not None else None
        sim_dt = (stamp - self._last_stamp) if self._last_stamp is not None else None

        v_left = WHEEL_RADIUS_M * self._wheel_vel[LEFT_WHEEL_JOINT]
        v_right = WHEEL_RADIUS_M * self._wheel_vel[RIGHT_WHEEL_JOINT]
        v = (v_left + v_right) / 2.0

        dropped = False
        if sim_dt is not None:
            if 0 < sim_dt < 0.5:
                self.x += v * math.cos(self.yaw) * sim_dt
                self.y += v * math.sin(self.yaw) * sim_dt
                self._have_odom = True
            else:
                dropped = True

        if wall_dt is not None and 0 < wall_dt < 0.5:
            self.x_wall += v * math.cos(self.yaw_wall) * wall_dt
            self.y_wall += v * math.sin(self.yaw_wall) * wall_dt

        if wall_dt is not None and not self.done:
            elapsed = time.time() - self.start_time
            self.dt_debug_writer.writerow([
                f'{elapsed:.3f}', f'{wall_dt:.4f}',
                f'{sim_dt:.4f}' if sim_dt is not None else '',
                self.state, int(dropped),
            ])

        self._last_odom_time = now
        self._last_stamp = stamp

    # ---------------- 視覺 (Jetson -> STM32 的 UART 字串) ----------------
    def _uart_cb(self, msg):
        line = msg.data.strip()
        now = self.get_clock().now().nanoseconds / 1e9
        if line.startswith('BALL,'):
            try:
                _, d, a = line.split(',')[:3]
                self.ball_dist_cm, self.ball_angle_deg = float(d), float(a)
            except ValueError:
                return
            self.last_seen_time = now
            self._ball_off = False
            if DELAY_COMP != 'off' and self._last_imu_stamp is not None:
                # 目標航向 = 拍照當下的轉角 - 球的角度 (右邊為正，所以減)
                self._psi_target = self._heading_at(self._last_imu_stamp - DELAY_COMP_SEC) \
                    - math.radians(self.ball_angle_deg)
            self._on_ball_seen(now)
        elif line.startswith('BALL_OFF'):
            self._ball_off = True
            self._psi_target = None
        elif line.startswith('COURT,'):
            parts = line.split(',')
            if len(parts) >= 5:
                try:
                    self._court = (parts[1], parts[2], float(parts[3]), parts[4], now)
                except ValueError:
                    pass

    def _on_ball_seen(self, now):
        if self._vision_ignore_until is not None and now < self._vision_ignore_until:
            return
        if self.state == 'PATROL':
            self.state = 'ALIGN'
            self.chase_cmd_log = []
            guess = self._estimate_target_ball()
            self.get_logger().info(
                f'發現網球 -> 對準 (猜是{guess or "?"}，目前在往格 {self.cell_numbers[self.wp_index]} 的路上)')

    def _ball_visible(self, now):
        return (self.last_seen_time is not None and not self._ball_off
                and now - self.last_seen_time < LOST_BALL_GRACE_SEC)

    # ---------------- 輸出：左右輪目標 rpm ----------------
    def _publish_wheels(self, left, right):
        msg = Float32MultiArray()
        msg.data = [float(left), float(right)]
        self.wheel_pub.publish(msg)

    def _drive(self, v, w):
        """車體 (v, ω) -> 實體車輪速 -> 斜坡 (B 同學軟起步) -> STM32 目標。"""
        left, right = body_to_wheel_rpm(v, w)
        self._publish_wheels(self._ramp_l.update(left), self._ramp_r.update(right))

    def _set_wheels(self, left, right):
        """直接設定左右輪目標 (= Chassis_SteerP，原地轉向用，不經過斜坡)。"""
        self._ramp_l.current, self._ramp_r.current = left, right
        self._publish_wheels(left, right)

    def _stop(self):
        """= Chassis_Stop()：目標歸零 (馬達模型那邊會清積分)。"""
        self._ramp_l.current = self._ramp_r.current = 0.0
        self._publish_wheels(0.0, 0.0)

    def _heading_now(self):
        return self._yaw_unwrapped if DELAY_COMP == 'gyro' else self._enc_yaw

    def _heading_at(self, t):
        """t 時刻 (模擬時間) 的轉角，延遲補償用。"""
        idx = 1 if DELAY_COMP == 'gyro' else 2
        val = None
        for row in self._heading_hist:
            if row[0] <= t:
                val = row[idx]
            else:
                break
        return self._heading_now() if val is None else val

    def _comp_error_deg(self):
        """補償後的「球的角度」(右邊為正，跟 BALL 的角度同號)。"""
        return math.degrees(self._heading_now() - self._psi_target)

    def _align_fast_tick(self):
        """延遲補償開著時，ALIGN 每 20 ms 用最新轉角更新轉向 (實體車就是 STM32 每 10 ms 一次)。"""
        if self.done or self.state != 'ALIGN' or DELAY_COMP == 'off' or self._psi_target is None:
            return
        b_hat = self._comp_error_deg()
        if abs(b_hat) <= ALIGN_DONE_DEG:
            return
        y = STEER_KP * (0.0 - b_hat)
        half = max(-STEER_WHEEL_MAX, min(STEER_WHEEL_MAX, y / 2.0))
        self._set_wheels(-half, half if half != 0.0 else 1e-6)

    def _wheel_rpm_cb(self, msg):
        # 編碼器積分轉角 (實體車 main.c chassis_angle_deg 的做法)，延遲補償選 encoder 時用
        if len(msg.data) >= 4 and self._last_imu_stamp is not None:
            if self._last_rpm_stamp is not None and 0 < self._last_imu_stamp - self._last_rpm_stamp < 0.5:
                wl = msg.data[1] * 2 * math.pi / 60.0
                wr = msg.data[3] * 2 * math.pi / 60.0
                self._enc_yaw += WHEEL_R_REAL * (wr - wl) / WHEEL_L_REAL * (self._last_imu_stamp - self._last_rpm_stamp)
            self._last_rpm_stamp = self._last_imu_stamp
        if self.done or len(msg.data) < 6:
            return
        self.rpm_writer.writerow([f'{time.time() - self.start_time:.3f}'] + [f'{v:.2f}' for v in msg.data[:6]]
                                 + [self.state])

    # ---------------- 撿球判定 (球有沒有躺在後車廂裡，用真實座標) ----------------
    # 每個 tick 只查「一顆」球 (輪流)，不是一次查全部：之前每 0.1 秒對每顆球各發一次
    # GetEntityState，15 顆球 = 每秒 150 次服務請求，節點/DDS 被塞爆，run94 的 /joint_states
    # 訂閱直接斷掉 (里程計凍結、車直線出界)、run95 模擬中途停滯 34 秒。輪流查每秒只有 20 次。
    def _check_touch(self):
        if not self.remaining_balls:
            return
        now = self.get_clock().now().nanoseconds / 1e9
        if self.touch_check_in_progress:
            if now - self._touch_check_started < 1.0:
                return
            self.touch_check_in_progress = False  # 回覆遺失，不要永遠卡住
        if not self.get_entity_cli.service_is_ready():
            return
        self.touch_check_in_progress = True
        self._touch_check_started = now
        req = GetEntityState.Request()
        req.name = 'tennis_bot::base_link'
        future = self.get_entity_cli.call_async(req)
        future.add_done_callback(self._on_robot_pose_for_touch)

    def _on_robot_pose_for_touch(self, future):
        try:
            resp = future.result()
        except Exception:
            self.touch_check_in_progress = False
            return
        if resp is None or not resp.success or not self.remaining_balls:
            self.touch_check_in_progress = False
            return
        p, o = resp.state.pose.position, resp.state.pose.orientation
        robot_pose = ((p.x, p.y, p.z), (o.x, o.y, o.z, o.w))

        self._ball_poll_index = (self._ball_poll_index + 1) % len(self.remaining_balls)
        name = self.remaining_balls[self._ball_poll_index]
        req = GetEntityState.Request()
        req.name = name
        future = self.get_entity_cli.call_async(req)
        future.add_done_callback(lambda f, n=name, rp=robot_pose: self._on_ball_pose(f, n, rp))

    def _on_ball_pose(self, future, name, robot_pose):
        self.touch_check_in_progress = False
        try:
            resp = future.result()
        except Exception:
            return
        if resp is None or not resp.success or name not in self.remaining_balls:
            return

        p = resp.state.pose.position
        self._ball_real_positions[name] = (p.x, p.y)  # debug 用，猜目前追蹤的是幾號球

        (rx, ry, rz), (qx, qy, qz, qw) = robot_pose
        dx, dy, dz = p.x - rx, p.y - ry, p.z - rz
        lx, ly, lz = quat_rotate_inverse(qx, qy, qz, qw, dx, dy, dz)

        in_basket = (
            BASKET_X_RANGE[0] <= lx <= BASKET_X_RANGE[1]
            and abs(ly - BASKET_Y_CENTER) <= BASKET_Y_HALF_WIDTH
            and BASKET_MIN_Z <= lz <= BASKET_REST_MAX_Z
        )
        self._basket_streak[name] = self._basket_streak[name] + 1 if in_basket else 0
        if self._basket_streak[name] >= BASKET_CONFIRM_POLLS and name in self.remaining_balls:
            self.remaining_balls.remove(name)
            self.touched_count += 1
            elapsed = time.time() - self.start_time
            self.get_logger().info(
                f'{name} 進後車廂！({self.touched_count}/{NUM_BALLS}) t={elapsed:.1f}s '
                f'車廂內位置=({lx:.2f}, {ly:.2f}, {lz:.2f})')
            if not self.done:  # 非同步 callback，結束後才回來的話檔案已經關了，不要再寫
                self.touch_writer.writerow([name, f'{elapsed:.2f}', self.wp_index, self._current_cell_number(),
                                            f'{self._sim_elapsed():.2f}'])
                self.touch_file.flush()

            if self.state in ('ALIGN', 'APPROACH', 'BLIND_DASH'):
                self._start_return()

    # ---------------- debug：真實座標 ----------------
    def _poll_real_pose(self):
        if self.done or self._real_pose_pending or not self.get_entity_cli.service_is_ready():
            return
        self._real_pose_pending = True
        req = GetEntityState.Request()
        req.name = 'tennis_bot::base_link'
        future = self.get_entity_cli.call_async(req)
        future.add_done_callback(self._on_real_pose)

    def _on_real_pose(self, future):
        self._real_pose_pending = False
        try:
            resp = future.result()
        except Exception:
            return
        if resp is None or not resp.success:
            return
        p, o = resp.state.pose.position, resp.state.pose.orientation
        yaw = math.atan2(2.0 * (o.w * o.z + o.x * o.y), 1.0 - 2.0 * (o.y * o.y + o.z * o.z))
        ox, oy = AXLE_MID_IN_BASE
        self.real_x = p.x + ox * math.cos(yaw) - oy * math.sin(yaw)
        self.real_y = p.y + ox * math.sin(yaw) + oy * math.cos(yaw)
        self.real_yaw = yaw
        self.real_roll = math.atan2(2.0 * (o.w * o.x + o.y * o.z), 1.0 - 2.0 * (o.x * o.x + o.y * o.y))
        self.real_pitch = math.asin(max(-1.0, min(1.0, 2.0 * (o.w * o.y - o.z * o.x))))

        if not self.done:
            if self._is_out_of_bounds(self.real_x, self.real_y):
                self._finish_run('出界')
        # 真實座標一到手就立刻記錄，里程計跟真實位置才是同一瞬間的值
        # (之前是另一個 0.5s timer 記錄，兩邊最多差 0.2~0.5 秒，車在動時會看起來像誤差)
        self._log_trajectory()

    def _current_cell_number(self):
        if 0 <= self.wp_index < len(self.cell_numbers):
            return self.cell_numbers[self.wp_index]
        return ''

    # ---------------- debug：猜目前 vision 追蹤的是幾號球 ----------------
    # vision_node 只知道像素座標 (cx,cy)，不知道那是哪一顆球。這裡反過來用真實
    # 座標 (機器人真實位置/朝向 + 每顆球真實位置) 算出每顆球「應該在畫面哪個角度」，
    # 跟 vision 回報的像素位置換算出的角度比對，哪顆最接近就猜是那顆。
    # 是近似值 (用 base_link 的位置/朝向，沒有扣掉相機本身 0.135m 的左右偏移)，
    # 只用來debug，不是精確判定。
    def _estimate_target_ball(self):
        if self.last_seen_time is None or self.real_x is None or self.real_yaw is None:
            return ''
        implied_bearing = -math.radians(self.ball_angle_deg)  # 協定角度右邊為正，這裡左邊為正
        best_name, best_diff = '', None
        for name, (bx, by) in self._ball_real_positions.items():
            if name not in self.remaining_balls:
                continue
            dx, dy = bx - self.real_x, by - self.real_y
            local_x = dx * math.cos(-self.real_yaw) - dy * math.sin(-self.real_yaw)
            local_y = dx * math.sin(-self.real_yaw) + dy * math.cos(-self.real_yaw)
            if local_x <= 0:
                continue  # 在車體後面，不可能是畫面裡看到的
            bearing = math.atan2(local_y, local_x)
            diff = abs(bearing - implied_bearing)
            if best_diff is None or diff < best_diff:
                best_diff, best_name = diff, name
        return best_name

    # ---------------- 記錄軌跡 ----------------
    def _log_trajectory(self):
        # 結束後檔案已經關了，非同步回來的 callback 不能再寫 (實測真的炸過)
        if self.done or not self._have_odom:
            return
        elapsed = time.time() - self.start_time
        real_x = f'{self.real_x:.3f}' if self.real_x is not None else ''
        real_y = f'{self.real_y:.3f}' if self.real_y is not None else ''
        real_yaw = f'{self.real_yaw:.3f}' if self.real_yaw is not None else ''
        self.traj_writer.writerow([f'{elapsed:.2f}', f'{self.x:.3f}', f'{self.y:.3f}',
                                    f'{self.yaw:.3f}', self.state, self.wp_index, self._current_cell_number(),
                                    real_x, real_y, real_yaw, self._estimate_target_ball(),
                                    f'{self.x_wall:.3f}', f'{self.y_wall:.3f}', f'{self.yaw_wall:.3f}',
                                    *self._tilt_debug(), self._imu_gaps])
        self.traj_file.flush()

    def _sim_elapsed(self):
        if self._first_stamp is None or self._last_stamp is None:
            return 0.0
        return self._last_stamp - self._first_stamp

    def _tilt_debug(self):
        # debug：車體真實 roll/pitch vs 陀螺儀積分出來的 roll/pitch (度)，看傾斜事件跟積分誤差
        qw, qx, qy, qz = self._gyro_q
        g_roll = math.atan2(2.0 * (qw * qx + qy * qz), 1.0 - 2.0 * (qx * qx + qy * qy))
        g_pitch = math.asin(max(-1.0, min(1.0, 2.0 * (qw * qy - qz * qx))))
        fmt = lambda v: '' if v is None else f'{math.degrees(v):.2f}'
        return fmt(self.real_roll), fmt(self.real_pitch), fmt(g_roll), fmt(g_pitch)

    def _finish_run(self, reason):
        self.done = True
        self._stop()
        elapsed = time.time() - self.start_time
        sim_elapsed = self._sim_elapsed()
        self.get_logger().info(
            f'結束({reason})：撿進後車廂 {self.touched_count}/{NUM_BALLS} 顆球，'
            f'走了 {self.wp_index}/{len(self.waypoints)} 格，耗時 {elapsed:.1f}s (模擬時間 {sim_elapsed:.1f}s)'
        )
        with open(self.run_dir / 'result.txt', 'w') as f:
            f.write(f'reason={reason}\ntouched={self.touched_count}\nnum_balls={NUM_BALLS}\n'
                    f'wall_sec={elapsed:.1f}\nsim_sec={sim_elapsed:.1f}\n')
        self.real_pose_timer.cancel()
        self.traj_file.close()
        self.touch_file.close()
        self.rpm_file.close()
        self.dt_debug_file.close()
        self._final_basket_audit()

    # 結束時把每顆球相對車體的最終位置印出來，稽核「撿到」的球是不是真的都還在車廂裡
    def _final_basket_audit(self):
        req = GetEntityState.Request()
        req.name = 'tennis_bot::base_link'
        self.get_entity_cli.call_async(req).add_done_callback(self._on_audit_robot_pose)

    def _on_audit_robot_pose(self, future):
        resp = future.result()
        if resp is None or not resp.success:
            return
        p, o = resp.state.pose.position, resp.state.pose.orientation
        robot_pose = ((p.x, p.y, p.z), (o.x, o.y, o.z, o.w))
        for name in BALL_NAMES:
            req = GetEntityState.Request()
            req.name = name
            self.get_entity_cli.call_async(req).add_done_callback(
                lambda f, n=name, rp=robot_pose: self._on_audit_ball_pose(f, n, rp))

    def _on_audit_ball_pose(self, future, name, robot_pose):
        resp = future.result()
        if resp is None or not resp.success:
            self.get_logger().info(f'稽核 {name}：查不到')
            return
        p = resp.state.pose.position
        (rx, ry, rz), (qx, qy, qz, qw) = robot_pose
        lx, ly, lz = quat_rotate_inverse(qx, qy, qz, qw, p.x - rx, p.y - ry, p.z - rz)
        in_basket = (
            BASKET_X_RANGE[0] <= lx <= BASKET_X_RANGE[1]
            and abs(ly - BASKET_Y_CENTER) <= BASKET_Y_HALF_WIDTH
            and lz >= BASKET_MIN_Z
        )
        self.get_logger().info(
            f'稽核 {name}：車體座標 ({lx:.2f}, {ly:.2f}, {lz:.2f}) -> {"在車廂裡" if in_basket else "不在車廂"}')

    # ---------------- 控制迴圈 ----------------
    def _control_loop(self):
        if not self._have_odom or self.done:
            return

        if not self.remaining_balls:
            self._finish_run('撿滿')
            return
        if self.wp_index >= len(self.waypoints):
            self._finish_run('走完弓字路徑')
            return

        now = self.get_clock().now().nanoseconds / 1e9

        self._check_touch()

        if self.state in ('ALIGN', 'APPROACH', 'BLIND_DASH') and self._heading_into_net():
            self.get_logger().info(
                f'離網子太近 (里程計 x={self.x:.2f}) 又朝著網子 -> 放棄追球，{NET_ABORT_IGNORE_VISION_SEC:.0f} 秒內不理視覺')
            self._vision_ignore_until = now + NET_ABORT_IGNORE_VISION_SEC
            self.vision_reset_pub.publish(Empty())
            self._start_return()
            return

        if self.state == 'PATROL':
            self._do_patrol()
        elif self.state == 'ALIGN':
            self._do_align(now)
        elif self.state == 'APPROACH':
            self._do_approach(now)
        elif self.state == 'BLIND_DASH':
            self._do_blind_dash(now)
        elif self.state == 'RETURNING':
            self._do_return()

    def _heading_into_net(self):
        # 車體中心離網子 (x=0) 太近，而且車頭朝向網子那一側 (在網子左邊朝 +x，或右邊朝 -x)
        dx = self.x - NET_X
        if abs(dx) >= NET_ABORT_CLEARANCE_M:
            return False
        return (dx < 0 and math.cos(self.yaw) > 0) or (dx > 0 and math.cos(self.yaw) < 0)

    # ---- 狀態 A ----
    def _do_patrol(self):
        target_x, target_y = self.waypoints[self.wp_index]
        dist = math.hypot(target_x - self.x, target_y - self.y)
        if dist <= ARRIVE_TOLERANCE_M:
            self.wp_index += 1
            return
        target_angle = math.atan2(target_y - self.y, target_x - self.x)
        err = angle_diff(target_angle, self.yaw)
        omega = max(-PATROL_MAX_OMEGA, min(PATROL_MAX_OMEGA, err * 1.2))
        speed_scale = max(0.0, 1.0 - abs(err) / (math.pi / 2))
        self._drive(PATROL_SPEED * speed_scale, omega)

    # ---- 狀態 B ----
    def _do_align(self, now):
        if not self._ball_visible(now):
            # 對準階段還沒開始靠近，看丟目標不是進了死角，是真的沒有目標了
            # (雜訊或球本來就不在那)，放棄追這顆球，回去巡邏
            if self._ball_truly_lost(now):
                how = '原路倒車回去' if RETURN_REPLAY_ENABLED else '直接走回巡邏路徑'
                self.get_logger().info(f'對準時看丟目標 -> 放棄，{how}')
                self._start_return()
            return
        if DELAY_COMP != 'off' and self._psi_target is not None:
            # 延遲補償：轉向由 _align_fast_tick 每 20 ms 更新，這裡只判斷要不要換成 APPROACH
            if abs(self._comp_error_deg()) > ALIGN_DONE_DEG:
                return
            self.state = 'APPROACH'
            self._approach_integral = 0.0
            self._approach_prev_error = 0.0
            self._approach_prev_time = None
            return
        if abs(self.ball_angle_deg) > ALIGN_DONE_DEG:
            # 實體車 STM32 的連續 P 轉向 (main.c Chassis_SteerP(-half_y, half_y))
            y = STEER_KP * (0.0 - self.ball_angle_deg)
            half = max(-STEER_WHEEL_MAX, min(STEER_WHEEL_MAX, y / 2.0))
            self._set_wheels(-half, half)
            self.chase_cmd_log.append((-half, half))
        else:
            self.state = 'APPROACH'
            self._approach_integral = 0.0
            self._approach_prev_error = 0.0
            self._approach_prev_time = None

    # ---- 狀態 C ----
    def _do_approach(self, now):
        if self._ball_visible(now):
            error_x = -self.ball_angle_deg  # 度，球在左邊為正 (變數名沿用舊的像素版)
            dt = now - self._approach_prev_time if self._approach_prev_time is not None else 0.1
            dt = dt if 0 < dt < 0.5 else 0.1
            self._approach_integral += error_x * dt
            derivative = (error_x - self._approach_prev_error) / dt
            omega = (APPROACH_PID_KP * error_x
                     + APPROACH_PID_KI * self._approach_integral
                     + APPROACH_PID_KD * derivative)
            omega = max(-APPROACH_MAX_OMEGA, min(APPROACH_MAX_OMEGA, omega))
            self._approach_prev_error = error_x
            self._approach_prev_time = now

            self._drive(APPROACH_SPEED, omega)
            self.chase_cmd_log.append((self._ramp_l.current, self._ramp_r.current))
        else:
            # 已經在直走接近了，看不到了 = 進了相機死角，交給盲衝蓋過去
            self.state = 'BLIND_DASH'
            self.blind_dash_until = now + BLIND_DASH_DURATION_SEC
            self.get_logger().info('看不到球了 (死角) -> 盲衝')

    def _ball_truly_lost(self, now):
        return not self._ball_visible(now)

    # ---- 狀態 D ----
    def _do_blind_dash(self, now):
        if now < self.blind_dash_until:
            self._drive(BLIND_DASH_SPEED, 0.0)
            self.chase_cmd_log.append((self._ramp_l.current, self._ramp_r.current))
        else:
            self.vision_reset_pub.publish(Empty())  # 盲衝結束才放開視覺的目標鎖定
            self._start_return()

    # ---- 狀態 E：原路倒車 ----
    # 追球 (ALIGN/APPROACH/BLIND_DASH) 期間車體會偏離巡邏路線，而輪速里程計在這幾個
    # 狀態特別容易飄 (原地轉向、盲衝時滑動比較大)，飄了之後直接回去 PATROL 只會照著
    # 不準的里程計亂衝，可能撞牆。改成把追球期間送出的每個指令記下來，追完後原封不動
    # 反過來重播一次 (方向相反、順序倒過來)，不管里程計準不準，物理上大致就能退回追球
    # 之前的位置跟朝向，才切回 PATROL。
    def _start_return(self):
        if not RETURN_REPLAY_ENABLED:
            self.chase_cmd_log = []
            self.state = 'PATROL'
            return
        self.state = 'RETURNING'
        self.return_index = len(self.chase_cmd_log) - 1

    def _do_return(self):
        if self.return_index < 0:
            self.chase_cmd_log = []
            self.state = 'PATROL'
            return
        left, right = self.chase_cmd_log[self.return_index]  # 追球時送出的左右輪目標，反過來重播
        self.return_index -= 1
        self._set_wheels(-left, -right)


def main(args=None):
    rclpy.init(args=args)
    node = GridPatrolNode()
    rclpy.spin(node)
    rclpy.shutdown()


if __name__ == '__main__':
    main()
