YourFath3r253/tennisball-picking/(commit log)

2026-08-04 Initial commit: tennis ball picking robot ROS2 workspace
    Snapshot of tennis_bot (Gazebo sim, vision/control nodes, URDF) and
    tennis_bot_maps (map + AMCL localization launch) before starting
    Nav2 path planning and localization simulation work, plus project
    presentation history.
    [front_chassis.stl, front_chassis2.stl, rear_basket.stl, simple_bot.urdf]
2026-08-04 Fix broken Gazebo->AMCL sim-time chain and AMCL frame mismatch
    - sim_launch.py was only loading libgazebo_ros_factory.so, so Gazebo
    never published /clock. Any node with use_sim_time:=true (AMCL,
    RViz2) was stuck at time 0, which is what broke TF and made RViz
    visualization appear disconnected. Now also loads
    libgazebo_ros_init.so, and robot_state_publisher is set to
    use_sim_time so all TF stamps share one clock.
    - AMCL was using its default base_frame_id ("base_footprint"), which
    doesn't exist in this URDF (root is base_link), so it could never
    transform the laser scan. Explicitly set base_frame_id/odom_frame_id/
    global_frame_id/scan_topic to match the robot.
    - map_server no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
2026-08-04 Turn tennis_bot_maps into a proper ament_python package
    Adds package.xml/setup.py/setup.cfg so it builds with colcon and can
    be launched as `ros2 launch tennis_bot_maps localization.launch.py`
    instead of a hardcoded absolute path. localization.launch.py now
    resolves the map yaml and rviz config via
    get_package_share_directory() rather than a path baked in for one
    user.
    Verified: colcon build --packages-select tennis_bot_maps succeeds,
    and the full map_server + AMCL + RViz2 pipeline still converges when
    launched by package name against the running sim.
    [cmd.py]
2026-08-04 Wire up Nav2 navigation stack: Smac2D planner + DWB controller
    Adds nav2_params.yaml (controller_server/DWB, planner_server/SmacPlanner2D,
    local+global costmap with a rectangular footprint instead of robot_radius
    since the robot isn't circular, behavior_server, bt_navigator,
    waypoint_follower, velocity_smoother) and navigation.launch.py bringing
    them all up under one lifecycle_manager, matching the architecture from
    the 6/22 presentation (建圖 -> AMCL 定位 -> Nav2 導航與避障).
    Two bugs found while getting this running:
    - A top-level YAML anchor for the footprint breaks nav2's params
    parser (root keys must be node names) - inlined the literal instead.
    - default_nav_to_pose_bt_xml: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
2026-08-04 Add boustrophedon coverage patrol + fix DWB heading/progress issues
    - coverage_planner.py: pure-geometry function that computes 弓字型
    waypoints covering the court. Lane spacing derived from camera
    horizontal FOV + effective detection range + 20% overlap (matching
    the 6/22 presentation's ABC waypoint spacing plan), court bounds
    padded by margin_ratio (matching generate_map.py's 1.3x so the
    robot can reach balls at the court edge).
    - patrol_node.py: feeds those waypoints to Nav2 via
    nav2_simple_commander's followWaypoints(), using the real court
    dimensions (24m x 11m).
    - Removed the dead `tracker` console_script entry point (tracker.py
    never existed in this package).
    While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
    [coverage_planner.py, patrol_node.py]
2026-08-04 Add patrol_supervisor: dynamic patrol/track task switching
    Implements the "動態任務切換" from the 5/21 and 6/22 presentations:
    巡邏途中若相機捕捉到網球，立即觸發中斷，執行追蹤與盲抓，完成後自動
    返回原規劃路徑.
    control_node.py changes:
    - Gated behind a new /capture_mode (Bool) topic - only drives /cmd_vel
    when enabled, so it doesn't fight Nav2's velocity_smoother for the
    same topic when idle.
    - Publishes its current state on /control_node/state (String) so an
    external supervisor can tell when a capture cycle actually finishes.
    patrol_supervisor.py (new):
    - Owns the BasicNavigator and sends the boustrophedon waypoints one at
    a time via go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
    [control_node.py, patrol_supervisor.py]
2026-08-09 Extend ball detection range to ~3m and fix align-before-approach logic
    vision_node.py:
    - Lowered the contour area threshold from 100px^2 to 12px^2. At 3m a
    tennis ball's expected apparent size is only ~55px^2 given the
    camera's FOV/focal length, so the old threshold silently discarded
    anything beyond ~1.2m - it was never a deliberate detection-range
    limit, just an artifact of a threshold tuned for close-range testing.
    - Added a morphological close pass on the HSV mask so small distant
    blobs that render as a few disconnected pixels merge into one
    contour instead of each fragment failing the area check individually.
    control_node.py:
    - Split the TRACK state into ALIGN (rotate in pl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
    [control_node.py, vision_node.py]
2026-08-15 Remove LiDAR and add front-chassis-only ball touch detection
    - Removed the LiDAR link/joint/sensor from simple_bot.urdf. Path
    planning is switching to wheel-odometry-based grid navigation
    (no AMCL/Nav2/LiDAR involved), so the sensor and its /scan output
    were unused dead weight.
    - Added ball_toucher.py: watches for balls entering a zone in front
    of the chassis and deletes them via /delete_entity, instead of an
    omnidirectional touch radius around the whole robot body. Gazebo
    fuses fixed-joint child links into their parent for physics
    efficiency, so front_chassis has no independent pose to query
    directly (GetEntityState on "tennis_bot::front_chassis" returns
    success=False) - w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
    [simple_bot.urdf]
2026-08-15 Add grid_patrol_node: odometry-based grid coverage with 4-state chase logic
    Implements the simplified path-planning approach discussed: no LiDAR/
    AMCL/Nav2, position comes from wheel odometry (dead reckoning), and
    balls disappear on contact instead of simulating roller physics.
    grid_waypoints.py: 8x4=32 cell grid over the court interior (1m wall
    clearance), sized from the camera's ~3m detection range. Cells are
    numbered left-to-right per row (fixed labeling), but traversal
    alternates direction per row (classic boustrophedon) - so cell labels
    and visit order deliberately diverge (row 2 is labeled 9-16 but
    visited 16->9). The trajectory CSV logs both wp_index (array position)
    and cell_number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
    [ball_touches.csv, simple_bot.urdf, trajectory.csv]
2026-08-16 8/16 問題出在延遲通訊
    存檔點：陀螺儀+輪速里程計、左右滾輪判定、目標鎖定 (SAME_BALL_PX=150，即時放開
    不等待)、MIN_CONTOUR_AREA=55px²、原路倒車機制(關閉)、debug用的target_ball_guess
    估測、run1~run24實驗數據。
    目前定位到的問題：_joint_state_cb 用真實時鐘(wall clock)算 dt，當模擬即時率
    掉下去 (懷疑是 Gazebo GUI 渲染 + 密集非同步服務查詢同時搶資源造成)，dt 可能
    超過 0.5 秒防呆門檻，導致該次陀螺儀積分被整段跳過，車體真實有轉動/移動但
    里程計沒記錄到，這是目前找到的位置誤差主要來源之一。下一步：加 debug log
    確認真的是即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
    [ball_touches.csv, simple_bot.urdf, trajectory.csv, vision_debug.csv]
2026-08-16 存檔：dt延遲問題驗證結果 (真實vs模擬時間對照)
    加了 dt_debug.csv 診斷log (wall_dt vs sim_dt)，跑了兩次300秒對照測試：
    - run25 (真實時鐘算dt，原本邏輯): 7/10顆球，最後位置誤差26m/角度誤差84°，
    期間發生一次35秒的完整模擬凍結 (wall_dt跟sim_dt同時卡住，不是即時率飄移，
    是整個模擬真的停了)，且卡頓次數隨時間惡化 (前180秒幾乎沒事，之後每30秒
    卡頓次數從1次飆到60幾次)。
    - run26 (模擬時間算dt，USE_SIM_TIME_FOR_DT=True測試): 9/10顆球，最後位置
    誤差只有1.3m/角度誤差9°，但過程中因為 /clock 更新頻率比 /joint_states低，
    產生大量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
    [ball_touches.csv, dt_debug.csv, trajectory.csv, vision_debug.csv]
2026-09-09 存檔：視覺雙門檻解決鎖球閃爍、撞牆改真實座標判定，9/9撿球達成
    vision_node.py：目標鎖定改用雙門檻 (進場55px²/鎖定後40px²)，解決球剛好停在
    偵測邊緣時輪廓面積抖動造成的反覆對準/放棄死鎖問題。
    grid_patrol_node.py：
    - 拿掉 ball_6 (一開場就撿到，測試不到東西)，場上固定改成9顆
    - 刪除原本用里程計座標判斷「卡住=撞牆」的安全網——這次批次測試證實它常常
    誤判 (真正原因常是/joint_states訂閱斷線或單純飄移，不是真的撞牆)
    - 新增用 Gazebo 真實座標判定撞牆 (離牆0.2公尺內)，模擬才有的優勢，不會被
    里程計誤導
    - 試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
    [ball_touches.csv, dt_debug.csv, trajectory.csv]
2026-09-13 存檔：里程計成功版本，陀螺儀更新率改1000Hz，里程計與真實位置貼合到3cm內
    四個疊加的誤差來源，逐一單變數驗證後修正：
    1. 里程計dt改用/joint_states封包的模擬時間戳（原本用真實時鐘，模擬即時率0.93時
    距離與航向都被放大7~10%；run75把即時率壓到0.7驗證，新版不受影響、舊版差43%）
    2. 真實座標換算到驅動輪軸心中點（base_link原點差(+0.080,-0.135)m，原地轉會假差0.31m）
    3. 軌跡記錄改在真實座標到達的瞬間同步寫入，消除0.5秒取樣時間差
    4. IMU update_rate 50→1000Hz，航向改在IMU callback用IMU時間戳積分
    （ODE每步角速度抖動±8%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
    [ball_touches.csv, dt_debug.csv, simple_bot.urdf, trajectory.csv, vision_debug.csv]
2026-09-13 存檔：滾輪物理撿球成功版本，取代「碰到就刪除球」，run76/77 皆 9/9 進後車廂
    - 原因：影片 47.webm 成功時滾輪在 record 筆記的位置 (y=0.2, z=0.03)，後來被改回
    CAD 位置 (0.102, 0.045)，離後車廂 17.7cm 前擋牆只剩 10cm，球被推到牆邊只能垂直
    彈起 (experiments/roller_pickup 實測)。URDF 滾輪改回 (0.2, 0.03)，恢復滾輪碰撞
    (半徑 0.045)，滾輪關節加進 joint_states。
    - 掃描 W(/roller_cmd angular.z)=35~55 × 盲衝 0.2~0.4 m/s：W=40/45 全部進車廂，
    W>=50 拋過頭飛出車尾，W=35 邊緣；採用 W=42.5 (約 66 rad/s) 常轉。
    - grid_patrol_node：移除 DeleteEntity，「撿到」改用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
    [ball_touches.csv, chassis.csv, dt_debug.csv, nobasket.csv, pick2.csv, pick5.csv, simple_bot_roller_collision.urdf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]
2026-09-14 存檔：開放場地+網子版本，兩個半場弓字路徑，隨機佈局 3+3 次全部 9/9 進後車廂
    - 場地：court_walls 只留視覺沒有碰撞 (真實場地開放)；撞牆停止改成出界停止。
    - 網格：格邊長 = 2*0.8*R*sinθ (R=3.0m 辨識距離, θ=40° 半視角) = 3.085m 上限，
    巡邏範圍改成整個 24x11m 雙打場地，格數無條件進位 (grid_waypoints.py 共用)。
    - 網子：ITF 規格 (12.8m 長、1m 高實心板、網柱 y=±6.4)，有碰撞、擋相機視線。
    court_path_with_net()：兩個半場各 4x4 格 (x 從 0.9 起)，繞網柱外側 y=±7.5 過去，
    第二半場從靠網角落接上；追球時車體中心 |x|<0.763 (車身離網 0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
    [ball_touches.csv, batch_net2_manifest.csv, batch_net_manifest.csv, batch_open_manifest.csv, dt_debug.csv, trajectory.csv, vision_debug.csv]
2026-09-14 存檔：15/20顆球撿球判定過載修復(輪流查球)、開放場地+網子隨機實驗數據、9/15簡報
    - 撿球判定過載修復：_check_touch 原本每 0.1s 對每顆剩餘球各發一次
    GetEntityState (15顆=每秒150次)，塞爆節點導致 /joint_states 斷線
    (里程計凍結出界)或模擬停滯。改成每 tick 輪流只查一顆球
    (_ball_poll_index)，並加 1 秒逾時保護避免卡死。
    - 實驗數據 (開放場地+網子，隨機佈局，球離網≥1m)：
    10顆 5/5 撿滿 (平均369s)、15顆 4/5 (470s)、20顆 1/5 (492s，
    其餘4次撿到19/20，2次因球被彈飛出場外、1次仍觸發訂閱斷線)。
    里程計誤差 13/15 次位置平均<0.15m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
    [ball_touches.csv, batch_data10_manifest.csv, batch_data15_manifest.csv, batch_data15_manifest_attempt1_overload.csv, batch_data20_manifest.csv, batch_data20_manifest_attempt1_overload.csv, data_summary.csv, data_summary_attempt1.csv]
2026-09-18 存檔：實體車轉向PID化前基準版本，STM32離散轉向main.c + 討論計畫PLAN.md
    main.c 原檔名為同學貼上STM32CubeIDE程式碼時誤存的檔名，改名整理；
    PLAN.md 記錄現有STM32架構分析（已有編碼器輪速PID、里程計角度、UART協定）、
    離散轉向邏輯位置、以及後續連續PID化/Jetson SSH開發/馬達校正的討論結論。
2026-09-18 存檔：加入Jetson視覺辨識程式baseline，更新PID計畫(UART協定細節、USB免螢幕連線方案)
    補上 realtime_camera_trt_distance_angle_uart.py 作為視覺端 baseline；
    PLAN.md 補充：/dev/ttyACM0 顯示STM32是Nucleo內建ST-Link、5Hz送球座標、
    EMA平滑延遲、視覺CSV可直接當角度-時間資料源；並記錄Jetson免螢幕
    USB裝置模式連線方案，以及待確認事項改由Claude自行判斷取代詢問同學。
2026-09-18 存檔：Jetson SSH金鑰+Tailscale+待機鎖死設定完成，記錄視覺程式版本疑問
    PLAN.md更新：SSH改用Tailscale(100.104.92.104)不受網路位置限制、
    sudoers設NOPASSWD、systemd sleep/suspend/hibernate全部mask避免斷線；
    新增待確認事項：Jetson上有協定不相容的視覺程式舊版本(BALL_ON/OFF vs
    main.c認的BALL,dist,angle格式)，需跟視覺負責同學確認正式版本。
2026-09-18 存檔：Jetson斷電重開機實測通過，新增WiFi設定檔(imoney/nthupeap)
    拔插電源重開機驗證：免按鍵自動開機、自動登入桌面、Tailscale/SSH/
    sudo免密碼/eduroam自動重連全部正常，今天教室要處理的環境設定確認
    穩固，之後可純遠端開發不用再帶螢幕。另記錄Jetson無RTC電池、開機
    時系統時鐘會先亂跳的小提醒，供之後收角度-時間資料時注意。
2026-09-19 存檔：記錄團隊多人遠端存取方案(Tailscale邀請制)、視覺版本判斷方式
    回應昨晚D同學在網球場SSH連不上Jetson的問題：新增團隊多人存取章節，
    說明加新熱點+邀請隊友加入Tailscale(不共用帳密)的正確做法，並建議
    固定用同一顆行動熱點降低每場地重新設定的麻煩；另記錄視覺程式版本
    應以協定內容(BALL,格式)判斷而非檔案日期。
2026-09-19 存檔：釐清D同學不需要SSH金鑰、確認Jetson使用範圍(僅Sean+D)
    補充說明Tailscale跟登入密碼是兩件獨立的事，D同學已知帳密不需另外
    設定金鑰；記錄這台Jetson僅Sean、D兩人使用，D同學熱點是最後一次
    新增WiFi設定檔，並提醒共用帳密+sudo免密碼的風險範圍。
2026-09-19 存檔：找到D同學實際在用的視覺程式版本(_nodisplay.py)，更正之前誤判
    透過bash_history執行紀錄(而非檔名日期)確認實際版本：
    realtime_camera_trt_distance_uart_nodisplay.py，協定與main.c相容、
    UART埠與現況一致、無需螢幕可純SSH執行、已內建CSV記錄可直接當
    角度-時間資料來源。更正PLAN.md先前誤判的版本判斷。
2026-09-19 存檔：記錄電源架構(馬達/Jetson獨立電源+STM32吃Jetson5V)、序列埠權限修正
    補充撿球機7_29簡報確認的電源設計：Jetson UPS模組是刻意設計避免
    感測器瞬間電壓驟降重開機，STM32電源接在Jetson的GPIO 5V(順便共地)，
    代表Jetson斷電STM32也會跟著重開、里程計角度會歸零；記錄今天電池
    螺絲鬆脫導致的間歇斷電事故(已鎖緊修復)。另修正ttyACM0權限問題，
    把hp加入dialout群組，永久解決Permission denied，不用再手動chmod。
2026-09-19 存檔：分析Jetson既有舊CSV數據(9/9轉向震盪紀錄+6/21靜態校正)
    今天實測被電池問題打斷，尚無今日baseline數據，先分析Jetson上既有
    舊檔案：僅distance_512x384_uart.csv(9/9)有motor_on可看轉向行為，
    其餘5份是6/21純視覺靜態距離校正測試。9/9資料看出角度在breve
    -29~+29度間震盪、正負翻轉6次/32秒，但因版本/日期不確定不能當
    正式baseline，仍需車輛恢復後重測。附分析腳本與角度時間圖。
    [distance_512x384_uart.csv, distance_log_512x384.csv, test_50cm_center.csv, test_50cm_left.csv, test_50cm_right.csv, test_distance.csv]
2026-09-19 修正：分析圖表中文字型變方框的問題
    matplotlib字型設成"Noto Serif CJK TC"沒被字型管理器辨識，實際
    安裝的字型在matplotlib裡登記的名稱是"Noto Sans CJK JP"(同一個
    字型檔案，NotoCJK涵蓋繁體字沒問題)，改用這個名稱後重新產圖並
    自行讀圖確認中文正常顯示。
2026-09-19 存檔：取得B同學STM32完整專案(Core+Drivers+Debug建置系統)
    從B同學提供的4包壓縮檔整理出 ballpicker_STM32專案/，包含完整
    Core(Inc/Src/Startup)、Drivers(CMSIS含STM32F446xx device header+
    HAL_Driver)、Debug建置系統(makefile/sources.mk/objects.mk+上次
    成功編譯的.elf)。確認硬體為STM32F446RE(更正之前猜測的F401RE)。
    重大發現：main.c已新增COURT,<狀態>,<方向>,<比例>球場邊界協定與
    邊界迴避邏輯，追球邏輯現在需要court_state=SAFE才會執行，找球
    旋轉邏輯也改為1.5秒計時制。舊main.c(無邊界邏輯版本)已刪除，
    避免與新版混淆，之後分析/設計PID以ballpicker_STM32專案版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
2026-09-19 存檔：取得B同學STM32完整專案(Core+Drivers+Debug建置系統) 補上遺漏檔案
    上一個commit漏掉了實際的檔案內容，這次補上完整的
    ballpicker_STM32專案/ 資料夾與PLAN.md更新。
2026-09-20 存檔：BD同學程式9/20版本(STM32方向修正+視覺端球場邊界整合)
    B同學main.c更新：修正16處馬達方向GPIO極性(底盤+滾輪馬達正反轉、
    編碼器讀數正負號)，取代先前方向錯誤的版本。
    D同學realtime_camera_trt_distance_uart_nodisplay.py更新：整合
    球場邊界色彩分類模型(court_color_model_v6.npz)，但COURT_UART_ENABLE
    設為False(D自己留的保護開關，註解說明等STM32韌體能解析再打開)，
    目前邊界偵測不會送到STM32、court_state維持SAFE，不影響球體追蹤
    邏輯，符合現在只專注原地旋轉這塊的範圍。
    B、D同學都沒用git，這個commit純粹是Sean自己留的版本快照，之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
    [main.c, realtime_camera_trt_distance_uart_nodisplay.py]
2026-09-20 存檔：STEP RESPONSE測試版main.c(禁止前進、只留原地轉向)+LD2除錯燈號
    因應昨天B同學誤燒錄程式導致暴衝撞牆掉零件的意外，把main.c的BALL
    處理邏輯全部改成不會前進：距離<30cm一律停止、角度已對準也停止，
    只有距離>=30cm且角度超過門檻才會用原本的離散兩檔轉向(40/55rpm)，
    車體理論上永遠只會停在原地。NOBALL一律停止(維持9/20稍早的改動)。
    新增：Chassis_SpinLeft/Right被呼叫時會切換LD2(綠色LED)狀態，用來
    現場肉眼判斷「轉向邏輯到底有沒有被觸發」，排查今天遇到的「滾輪轉
    但底盤不動」問題是韌體邏輯還是硬體/接線問題。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
2026-09-20 存檔：暫時改回B同學原始版本main.c(含前進/盲衝)+LD2/Forward除錯燈號
    為了排查「滾輪轉但底盤不動」問題，暫時燒回B同學改完方向的原始版本
    (含Chassis_Forward、盲衝等會前進的邏輯)，藉此測試在B原本邏輯下
    底盤馬達是否會動，排除是否為今天STEP RESPONSE簡化版引入的問題。
    保留LD2除錯燈號在Chassis_SpinLeft/Right，並新增到Chassis_Forward
    (剛從靜止轉為前進的瞬間)，方便肉眼確認邏輯是否被觸發。
    注意：這個版本車體可以前進，不是昨天那個安全限制版，測試時務必
    在旁監看，避免重演昨天暴衝撞牆的意外。
    已重新編譯燒錄確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
2026-09-20 存檔：燒回STEP RESPONSE安全版(禁止前進版)，記錄靜摩擦力發現
    排查完畢，暫時改回B原版(含前進)main.c測試後發現：底盤馬達一開始
    不會自己啟動，但Sean手動推一下就恢復正常運作——這強烈指向靜摩擦
    力(stiction)問題，跟Sean稍早自己提出的懷疑一致：轉向爆發時間
    太短(~100-140ms，受1秒冷卻限制)，PID積分項來不及把PWM衝高到
    超過靜摩擦力門檻，就被下一輪冷卻打斷重置，導致輪子從未真正啟動。
    現在燒回STEP RESPONSE版本(main.c取自commit 473ac0c，禁止前進、
    只留原地轉向+LD2除錯燈號)，已重新編譯燒錄確認 Verified OK。
    Co-Authored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
2026-09-20 存檔：安全降速，轉向rpm除以10(40/55 -> 4/5.5)，記錄run4資料異常發現
    Sean擔心暴衝撞牆，先降速為優先，維持B原本1秒停止冷卻邏輯不變。
    run4 CSV關鍵發現：連續191秒(t=126.2~316.6s)球的距離/角度幾乎
    完全不變(62~63cm, 10.2~10.3°)，期間理論上應觸發約190次原地
    右轉，但完全沒有反應——比先前的證據更強烈地證實轉向邏輯沒有讓
    車體產生任何可觀測的移動，且資料本身不支持「持續往前開」的說法
    (若真的前進，距離應持續下降，但沒有)。
    已重新編譯燒錄確認 Verified OK。
2026-09-20 存檔：9/20實測總結(降速有效、滾輪異常、YOLO誤判解釋連續右轉)
    記錄今日重大發現：4/5.5rpm降速後底盤馬達確認會動，適合當連續PID
    起始參考；YOLO會誤判穩定假陽性物體導致車子持續右轉，跟今天稍早
    run4的191秒凍結現象是同一個根因，屬於視覺端已知問題不是STM32
    邏輯/接線問題；滾輪馬達今天稍早不明原因停轉，韌體端沒有相關改動
    懷疑是硬體接線問題；記錄目前STM32燒的是安全測試簡化版(無前進+
    降速)，不是B同學完整版本，之後恢復要記得改回來。另記錄筆電端
    已是完整可用的燒錄工作站(gcc-arm-none-eabi+openocd)。
    Co-Au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
2026-09-21 存檔：9/21找到底盤不動根本原因(24V接線鬆脫)，連續P控制實機驗證成功(Kp=0.3勝過離散控制器約3倍)
    - main.c: 移除COURT/盲衝/找球狀態機，簡化成固定40rpm+1秒冷卻的離散版本，
    之後再改成連續P控制(error=0-angle, y=Kp*error, 左=y/2右=-y/2)，新增Chassis_SteerP()
    (不清積分，跟舊的離散SpinLeft/Right不同)
    - Debug/makefile: 加上-u _printf_float，修正RPM telemetry用%.2f印出空字串的問題
    - 發現獨立的HardFault bug(0x08B0B2E0)，尚未解決，記錄在PLAN.md
    - 新增read_rpm_serial.py + rpm_dashboard.html: 獨立於Jetson的本機即時RPM監控工具
    - 歸檔run8-13的CSV/影片，並整理到實驗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
    [rpm_log_left10.csv, rpm_log_left10_morning.csv, rpm_log_left10_power_on.csv, rpm_log_right10_morning.csv, rpm_log_spin_test.csv, rpm_log_spin_test2_rollers_on.csv, rpm_log_standalone.csv, run10.csv]
2026-09-21 存檔：Kp=0.6實機驗證(rise time~3.5s)，Kp=0.3重測確認可重現(7.6s)
    - main.c: STEER_KP從0.3改為0.6，測試找overshoot邊界
    - run14: Kp=0.3用改良協定(放球後等1秒才開電源)重測，3個乾淨事件
    rise time平均7.60s、zero overshoot，重現run13的7.4s結果
    - run15: Kp=0.6一次左轉一次右轉，rise time平均~3.5s(比0.3快一倍)，
    但一個方向overshoot+3.73°、另一方向無overshoot——判斷是車體重心
    不在中線+地板不平的硬體因素，不是控制邏輯問題，Sean已接受Kp=0.6
    為目前可用參數
    - 資料歸檔：實驗數據/P=0.3重測/、實驗數據/P=0.6/
    - PLAN.md: 補上今天稍晚的完整分析，包含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
    [run14.csv, run15.csv]
2026-10-02 存檔：Jetson熱點斷線排查，關閉WiFi省電+加裝連線記錄器
    - 校園網路(nthupeap/eduroam)在實驗室位置兩個都連不上，放棄此方向
    - 關閉Jetson WiFi省電模式(NM wifi.powersave 3->2，原檔備份.bak_20261002)，
    這是唯一改動的變數，觀察實驗時是否還斷線
    - 新增jetson_netlog/: netlog.sh+netlog.service，開機自動每5秒記錄
    ping熱點(gw_ok)與ping外網(inet_ok)，區分WiFi斷線vs手機網路斷線
    - Jetson系統日誌改為永久保存(上限200MB)
    - PLAN.md記錄排查過程，含Jetson無RTC造成開機時間戳偏差、
    tailscale status顯示延遲需改用tailscale ping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
2026-10-02 存檔：找到並修好Jetson熱點斷線根本原因(iPhone宣告-128dBm使TX功率被夾到0)
    - 根本原因：iPhone熱點Country IE宣告「Channels [1-13] @ -128 dBm」，
    Jetson的Linux 4.9 mac80211照單全收，把發射功率夾到0 dBm，造成
    「顯示連著但傳不出去」；傳影片等大流量時最快爆出來
    - 修正：mac80211.ko忽略<=0 dBm的無效功率值(jetson_wifi_fix/的patch，
    NVIDIA官方L4T R32.7.1原始碼)，由Sean在Jetson上編譯替換
    - 驗收：txpower 0 -> 22 dBm；經Tailscale傳3支影片62MB/23秒md5全符合，
    netlog該次開機真正斷線0次
    - 省電模式確認不是原因；校園網路(nthupeap/eduroam)是另一個問題，未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
2026-10-02 存檔：鎖住Jetson核心套件，避免apt upgrade蓋掉mac80211修正
2026-10-02 存檔：修好Jetson校園網路(nthupeap/eduroam)，四個WiFi全部驗證通過
    - 校園網路原因：Jetson的OpenSSL 1.1.1跟清大RADIUS協商成TLS 1.3，
    wpa_supplicant 2.6用TLS1.2方式推導EAP金鑰，四次握手時PMKID mismatch
    被斷線(帳密驗證其實成功，密碼雜湊與筆電一致)
    - 修正：只讓wpa_supplicant最高用TLS 1.2(openssl-wpa-tls12.cnf +
    systemd drop-in設OPENSSL_CONF)，不影響系統其他程式
    - 驗收：eduroam/nthupeap可上網；重開機後約55秒即可經Tailscale連入
    (以前開機要先在校園網路各卡75秒)；imoney也是iPhone熱點(-128 dBm)，
    靠先前的mac80211修正txpower 22 dBm、4000個大封包0%掉包
    - PLAN.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
2026-10-04 實驗工具：launch 可選 world/gui，撿球時間改記模擬時間 (sim_elapsed)，run_once 可選 WORLD/GUI/NODE
    只改實驗基礎設施，不改模擬物理或控制邏輯：
    - sim_launch.py 新增 world:=、gui:= 參數 (gui:=false 只開 gzserver，批次實驗用)
    - grid_patrol_node 在 ball_touches.csv 多記 sim_elapsed_sec，結束時寫 result.txt
    (即時率 <1 時真實時鐘會高估撿球時間，比較用模擬時間)
    - run_once.sh 可用環境變數 WORLD / GUI / NODE / RUN_TIMEOUT_SEC
2026-10-04 重構：vision_node 把影像處理拆成 _process_frame (行為不變)，之後相機延遲模型/邊界偵測都掛在這裡
2026-10-04 D同學提案(未測)：半場四色邊界世界、vision 邊界偵測 /court_boundary、boundary_bounce_node、批次腳本、2D 快速模擬
2026-10-04 模擬真實化 R1：網球改 ITF 規格 (57.7 g、厚殼慣量 0.6mr²、剛性 1.23e4 N/m、滾動阻力)
    - gen_ball_layout.py：預設質量 0.0577 (舊 0.027)，慣量係數 0.6 (舊實心 0.4)，
    接觸剛性 kp 由 ITF 前向變形規格換算 1.23e4 (舊 1e5)，新增 velocity_decay/angular
    近似毛氈滾動阻力 (ODE 沒有滾動摩擦，舊版被撞到的球會一直滾)
    - run_random_batch.sh：質量改用 BALL_MASS 環境變數，預設 ITF
    - ball_roll_test.py：滾動距離校正工具
    - tennis_court.world：用 standard.json 重新產生 9 顆球
2026-10-04 除錯紀錄：trajectory.csv 多記真實/陀螺儀積分的 roll、pitch 跟 IMU 掉封包次數
    R1 的 run119 航向誤差 20°，查原因用。發現煞車時車體會往前點頭 ~20° (baseline 也有，
    run121)，純陀螺儀積分沒有重力修正，傾斜誤差會累積、轉彎時漏到航向。
    [grid_patrol_node.py]
2026-10-04 模擬真實化 R1 修正：網球質量暫時維持 27 g (ITF 57.7 g 滾輪模型撿不起來，0/12)，其他網球性質保留
2026-10-04 模擬真實化 R1 修正2：網球接觸剛性維持 1e5 (ITF 1.23e4 讓後車廂的球在 ODE 裡抖動、陀螺儀積分出錯)
    後車廂 6 顆球直線開 15 s：kp=1.23e4 航向積分誤差 0.80~1.27°，kd=3.3 仍 0.54°，kp=1e5 -0.01~0.14°。
    R1 保留：厚殼轉動慣量 0.6mr²、滾動阻力 (velocity_decay)。
2026-10-04 模擬真實化 R1b：陀螺儀加加速度計傾斜修正 (模擬 BNO080 Game Rotation Vector 的感測融合)
    純陀螺儀積分沒有重力參考：煞車點頭 ~20° (baseline 也有) 之後 roll/pitch 誤差累積，
    轉彎時漏到航向 (run119 航向誤差最大 20.6°)。真實 BNO080 本來就用加速度計修正傾斜，
    這裡用 Mahony 型互補濾波 (TILT_KP=0.5，只在量到的加速度接近 1g 時修正)。航向仍只靠陀螺儀。
    [grid_patrol_node.py]
2026-10-04 模擬真實化 R2：球場地面摩擦係數 0.63 (由 ITF 中速硬地 CPR 公式換算)，取代預設 ground_plane 的 100/50
2026-10-04 模擬真實化 R3：場地撒輕微砂礫 (338 顆半埋小顆粒，露出 1~4 mm，固定種子)
2026-10-04 模擬真實化 R4：陀螺儀加白雜訊 (0.0077 rad/s @1kHz) + 零點偏移 (BNO080 航向漂移 0.5°/min)
    [simple_bot.urdf]
2026-10-04 模擬真實化 R5：真實相機模型 (輸出 4.4Hz 三拍節奏 0.11/0.11/0.45 s + 畫面延遲)，步階響應校正工具
    更新率/延遲都來自實體車 CSV：run10/12/13/14/15 約 2700 幀的輸出間隔，
    run12 (Kp=1.5) 8 次擺盪估出的迴路等效延遲 0.53~0.92 s (平均 0.70 s)。
    FRAME_AGE 用 step_response_test.py 在模擬裡校正到同樣的等效延遲。
2026-10-04 模擬真實化 R5 校正：相機畫面延遲 FRAME_AGE=0.45 s，模擬等效延遲 0.72 s 對上實體車 0.70 s
    step_response_test.py (原地轉向、飽和 0.6 rad/s)：0.40->0.55 s、0.45->0.72 s、0.50->0.79 s；
    理想相機 0 (沒有 overshoot)；實體車 run12 八次擺盪平均 0.70 s。
    [vision_node.py]
2026-10-04 模擬真實化：分析工具 + 證據資料 + 參數出處 README
    - run_metrics.py (每個 run 的撿球/模擬時間/里程計/航向誤差)、imu_vibration_test.py (後車廂裝球直線行駛量陀螺儀)、
    plot_step_compare.py (實體車 vs 模擬步階響應比較圖 step_sim_vs_real.png)
    - roller_pickup/results/itf_mass_2026-10-04：57.7 g 網球撿不起來 0/12 的原始資料
    - 實驗數據/step_response_sim：相機延遲校正與等效增益步階測試原始資料
    - 論文文獻/模擬真實化：每個參數的出處 (ITF 規格、CPR 公式、滾動摩擦論文、BNO080/BMI055 規格、實測)
    [pick_kp300.csv, pick_kp600.csv, pick_r1.csv, pick_v1.csv, pick_v1b.csv, pick_w.csv, stepK_0.0016.csv, stepK_0.0032.csv]
2026-10-04 D同學提案：邊界偵測距離驗證工具
2026-10-04 比較基準：grid_patrol_node 可以只走我方半場 (TENNISBOT_HALF_ONLY=1)，run_halfgrid_batch.sh 用同樣的半場佈局跑弓字路徑
2026-10-04 2D 快速模擬：支援隨機轉角 (r110-160 這種寫法) 跟球數參數
2026-10-04 邊界提案批次結果整理表 summarize_bounce.py
2026-10-04 D同學提案文獻：反彈式覆蓋 (bouncing robot) 6 篇 + README
    Nilles 2017 IROS (固定角度反彈收斂到週期軌道)、Erickson & LaValle 2013 ICRA、Nilles 2021 IJRR、
    Kundu 2024 RoMoCo、Doty & Harrison 1993 AAAI (掃地機 random sweep)、iRobot 專利 US6809490 (BOUNCE 隨機 90~270°)
2026-10-04 存檔：模擬真實化 + D同學半場四色邊界提案 實驗數據與報告 (run116~156)
    ① 真實化 (seed 301/302/303 全場+網子 9 顆)：baseline run116~118 vs 全部真實化 run128~130，
    3/3 都 9/9，撿完時間 +7%，里程計誤差 0.04 -> 0.21 m (陀螺儀零點偏移)；每一步 run119~127、
    砂礫加密 run131、R1 除錯 run120~122
    ② D 同學提案 (半場、10 顆、佈局 501~503)：轉 90/110/135/180° run133~144，135° 3/3 平均 243 s 最好；
    弓字半場比較基準 run145~147；2D 快速模擬 200 佈局圖
    ①+② 合併：135° run148/150/152 (3/3, 231 s)、110° run149/151/153 (3/3)、弓字 run154~156 (3/3, 206 s)
    報告：experiments/報告_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
    [ball_touches.csv, batch_base_diag_manifest.csv, batch_base_manifest.csv, batch_bounce_manifest.csv, batch_bounce_try_manifest.csv, batch_grit_dense_manifest.csv, batch_halfgrid_manifest.csv, batch_r1_manifest.csv]
2026-10-05 存檔：D同學邊界提案轉向角度細部研究 (2D，400 佈局，固定角度/依顏色不同角度/法線+隨機，加轉向誤差)
    結論：135° 在無誤差時 100% 是正方形半場的巧合 (130° 86%、140° 91.5%)；加上真實轉向誤差 σ=3°
    後 110~140° 都 95~100%、中位數 250~283 s；依顏色分角度只快約 6%；法線+隨機最穩但慢 15%。
2026-10-05 數位孿生介面：模擬改成跟實體車同一套資料流 + 底盤馬達模型 (STM32 輪速 PID 1:1 移植)
    - vision_node 照 D 同學程式送 UART 字串 /jetson_uart：BALL,距離,角度 (EMA 0.35、連 2 幀才送) / BALL_OFF
    (連 5 幀沒看到) / COURT,...；畫面延遲重新校正 0.60 s
    - grid_patrol_node / boundary_bounce_node 只吃 /jetson_uart，輸出 /wheel_target_rpm 左右輪目標 rpm
    (不再直接發 cmd_vel)；對準改用實體車 STM32 連續 P 轉向 STEER_KP=0.6 rpm/度；直走照 B 同學軟起步斜坡
    - 新增 motor_model.py + motor_driver_node：main.c 輪速 PID 逐行移植 (編碼器量化、濾波、動態積分分離)
    + 直流馬達 (死區 130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
    [ball_touches.csv, batch_tw_bounce_manifest.csv, batch_tw_full_manifest.csv, bounces.csv, dt_debug.csv, simple_bot.urdf, stm32_kp0.3.csv, stm32_kp0.6.csv]
2026-10-05 相機延遲補償 (簡化版 Smith predictor) Gazebo 實作 + 驗證
    - 收到 BALL 時目標航向 psi* = psi(現在-D) - 角度，之後每 20 ms 用最新轉角 (陀螺儀或編碼器積分) 算誤差
    - grid_patrol_node ALIGN：TENNISBOT_DELAY_COMP=off|gyro|encoder、TENNISBOT_DELAY_COMP_SEC (0.8)、
    TENNISBOT_STEER_KP；預設 off (維持跟實體車現在的控制器一樣)
    - Gazebo 步階 (29°)：無補償 Kp0.6 穩定 5.74 s/4.3°；無補償 Kp1.5 不收斂；補償 gyro D0.8 Kp1.5 1.60 s/1.8°；
    encoder 版 2.20 s/0.7°；實際延遲 0.45/0.78 s 時補償 2.07/2.67 s (無補償 1.60/5.74 s)
    - 整場：每顆球對準時間 2.56->1.00 s (全場 run157->run159)、3.16->1.56 s (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
    [ball_touches.csv, batch_comp_bounce_manifest.csv, batch_comp_full_manifest.csv, bounces.csv, comp_kp0.6_off_D0.8.csv, comp_kp1.0_gyro_D0.8.csv, comp_kp1.5_encoder_D0.8.csv, comp_kp1.5_gyro_D0.8.csv]
2026-10-05 相機對應 D 同學實測校正 + 視覺輸出節奏照實體 CSV 精確化
    - 焦距/視角：D 程式 FOCAL 390 (512 寬) -> 水平視角 80° 改 66.6°；球輪廓門檻 55/15 -> 90/25 維持 3 m
    - 光軸偏移：D 程式 image_cx=283 -> 相機往左偏 3.96°，vision 用第 353.75 行當正前方 (邊界左右也以此分)
    - D 同學 6/21 靜態測試：距離 ×0.944 + 1% 雜訊、角度 0.6° 雜訊
    - 視覺輸出節奏 (5 個 run、3199 連續幀)：短 0.1107±0.0037 s、長 0.4525±0.0308 s 嚴格「短短長」
    - 弓字格邊長隨相機視角 3.09 -> 2.63 m (每半場 25 格)
    - 孿生準確度表 v2：Kp0.6 上升 2.03 s/overshoot 5.1° (實體 2.0~3.3 s/1.4~7.9°)、Kp1.5 擺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
    [ball_touches.csv, batch_camd_bounce_manifest.csv, batch_camd_full_manifest.csv, bounces.csv, camD_kp0.3_off.csv, camD_kp0.6_gyro.csv, camD_kp0.6_off.csv, camD_kp1.5_gyro.csv]
2026-10-05 轉向系統方塊圖 + 各方塊轉移函數 + 極點零點對照
    - 圖1：現在的原地轉向迴路 (相機延遲 -> 取樣 -> EMA -> 轉向 P -> 保持 -> 飽和 -> 輪速迴路 -> 差速運動學 -> 積分) + 輪速 PID 迴路展開
    - 圖2：加上相機延遲補償 (Smith predictor 型，轉角感測回授支路) + 特徵方程推導
    - 圖3：每個方塊的極點/零點由哪些參數決定 + 閉迴路線性化結果 (無補償臨界 Kp≈2.0、理想補償主極點≈-Kp·Kψ)
    - make_block_diagram.py 重新產生 (數值由程式計算)
2026-10-12 存檔：B同學邊界判斷版main.c + D同學最新視覺程式court_line
    - ballpicker_STM32專案/Core/Src/main.c 換成B目前燒在STM32的版本
    (COURT EDGE -> 停0.5s -> Chassis_TurnPrecise用編碼器角度轉
    RIGHT +240 / LEFT -240 / CENTER -360，60 rpm)；筆電試編譯通過，未燒錄
    - 參考版本/main_Sean_連續P控制_Kp0.6.c：Sean的連續P控制版(尚未交給B)
    - D同學 realtime_camera_trt_distance_uart_court_line.py 與依賴的
    edge_uart_gate.py / yellow_runtime.py / geometry_features.py / yellow_model.json
    (取自Jetson ~/models，2026-10-11 21:04 版)
2026-10-12 存檔：實體車邊界轉向分析 + 陀螺儀第1步程式(已編譯未燒錄)
    - 讀出STM32晶片並反組譯：邊界邏輯=B的txt(EDGE->停0.5s->TurnPrecise
    用編碼器角度，LEFT -240 / RIGHT +240 / 其他 -360，60rpm)；
    原版韌體備份 參考版本/B_原版韌體_晶片讀出_20261012.bin
    - 實驗數據/邊界轉向_20261011：從10/11影片背景位移反推車身轉角
    (video_yaw.py/turn_episodes.py/hand_check.py + 影片/CSV/圖)。
    每次TurnPrecise(編碼器240度)實際轉135~195度、平均約165度(約0.69倍，
    輪胎側滑)，±30度誤差是做不到135±5度的主因；當時D尚未加EDGE閘門，
    且B/D現場改程式，多種邏輯混雜
    - 決定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
2026-10-13 實體車模式：模擬直接跑 D 同學 Jetson 程式 + B 同學 main.c，鏡頭/場地照實測校正
    - jetson_d/：D 同學 10/11 版程式原檔 (md5 同 Jetson) + YOLO ONNX；jetson_d_code.py 用 ast 取出不碰硬體的函式
    - jetson_d_node：D 主迴圈 SIL (黃線 yellow_runtime、YOLO onnxruntime、EdgeUartGate)，迴圈時間照 10/11 CSV 抽樣，
    V4L2 4 buffer 相機緩衝區模型 (推算畫面延遲中位數約 0.42~0.47 s，未實測)
    - stm32_b_node：B 同學 10/12「加入邊界判斷版本」main.c 移植 (避線 > 追球 > 巡邏，TurnPrecise ±240/-360，點放追球)，
    可切換 Sean 的 P 轉向；real_car_node 只當裁判 (起點、撿球判定、軌跡)
    - U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
2026-10-26 新車體 v2 數位分身：A 的 CAD 轉 Gazebo、撿球道驗證、實車程式跑新車
    - cad_v2_to_urdf.py：A 的 trunkasb.stp -> 每個零件一個 STL (公尺、base_link 座標) + 質量/重心 + tennis_bot_v2.urdf
    (驅動軸 = motor1/2 輸出軸、輪半徑 0.052、輪距 0.34 由輪框推估未實測、滾輪照 motor3/4 傾斜 48° 左右各一、
    鏡頭照 CAD 位置 + 21.3° 俯角、鋼板 3.255 kg、整車 8.16 kg；列印件 = 體積 x PLA x 60% 暫定)
    - TENNISBOT_ROBOT=v1|v2 切換車體 (robot_profile.py：實際輪距、軸心、車廂範圍、鏡頭)；
    STM32 韌體輪距仍 0.243 (TENNISBOT_FW_TRACK)，跟實際輪距分開
    - 撿球道驗證：pickup_test_v2.py /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
2026-10-26 新車 v2：鏡頭仰角建議、滾輪轉速上限 bug、海綿/撿球、新車整合錄影、P 控制對照
    - 鏡頭仰角 (experiments/camera_tilt，實驗數據/camera_tilt_20261026)：建議約 15° (12~15° 可)
    邊界停車 (巡邏 120 rpm)：15° 以下 0/10 越線、21.3° 3/10；角落測試 12°/15° 2/18、21.3° 9/18；
    18° 以上車頭入鏡；15° 以下球在 D 估 >30 cm 就出畫面 (B 的盲衝不觸發)。
    剩下的角落越線是 B 轉 ~113° (WHEEL_TRACK 0.243) + D 閘門要 0.5 s SAFE 才重新放行，不是仰角能解
    - 新環境變數：V2_CAM_PITCH_DEG (cad_v2_to_urdf)、TENNISBOT_PATROL_RPM (stm32_b_node，B 新版 120)、
    TENNISBOT_PICK_AT_MOUTH (real_c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
2026-10-30 存檔：實車改用Sean連續P轉向 + 輪速回傳，找到並修好直走偏移(車頭修正正負號、積分陷阱)
    - 以B最新新車版main.c為底，只把遠距點放轉向換成Sean 9/21連續P轉向
    (Chassis_SteerP不清積分；方向照B的SpinRight推得SteerP(half_y,-half_y)，
    實測修正過頭代表方向正確)；Kp 0.6太多overshoot改0.4
    - 加輪速回傳：每50ms送 RPM,ms,左目標,左實際,右目標,右實際，
    對應D程式drain_rpm_telemetry自動存成<TEST_NAME>_rpm.csv
    - 實測(實驗數據/直走偏移_20261030)：目標120時兩輪只到40~58rpm、積分從未啟動；
    B改里程計為(左-右)/輪距但沒改車頭修正，變成越修越偏(修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
2026-10-30 存檔：降速50版實測輪速(yellow_v22b_speed50_rpm.csv)
    直走目標50/50實際50.2/50.1、0.4秒到90%、車頭修正平均0.62不飽和；
    唯一尖峰174.8rpm在小目標±4.5且輪子停0數秒後(疑似上電瞬間)，0.4秒內回落
2026-11-10 存檔：避線轉完1秒內同向轉(只一次)、追球Kp 0.4→1.0、11/10球場邊界追球分析
    - STM32 (已燒錄, Verified OK):
    1. 避線轉完 1 秒內又收到 EDGE → 跟上一次同方向轉, 連續情況只同向一次
    2. 追球 STEER_KP 0.4 → 1.0 (網球場地板比實驗室粗糙)
    - txt 存檔: 撿球機_..._1秒內同向轉 / _1秒內同向轉只一次 / _Kp1.0_...
    - 參考版本/晶片讀出_燒錄前_20261109.bin
    - 實驗數據/邊界追球_20261110: 11/10 六趟 rpm/court/ball csv + D 目前 Jetson 程式
    (影片未加入 git, 留在本機)
    分析: 最後一顆球不是追球邏輯 — 轉向編碼器 237° 但車身約 0° (打滑),
    之後巡邏直走朝球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
