YourFath3r253/tennisball-picking/(notices)

Notices in the files:
實體車子程式碼/ballpicker_STM32專案/Core/Inc/main.h:
Copyright (c) 2026 STMicroelectronics.
All rights reserved.
This software is licensed under terms that can be found in the LICENSE file
